SensoriumEmbedded/TeensyROM/README.md

# TeensyROM Multi-capable Cartridge for C64/128

***Connect your Commodore to the 21st century***

**Features include:**
* **TeensyROM+ (PCB v0.4)** is the latest TeensyROM revision — **[see this document](docs/TR+NewFeatures.md)** for additional details:
  * **[TR Host Extensions](docs/TR_Host_Extensions.md)** — Allows others to write and experiment with TR firmware as a .TRH extension, installed alongside the core firmware without modifying it. Envisioned and implemented by [Kelly Fox](https://github.com/kfox) — a huge thank you!
    * [Mean Hamster Power Engine (MPE)](https://meanhamster.com/games/mpe-power-engine) is the first TRH extension, letting your C64 play games never released for it: NES, Game Boy, Doom, classic point-and-click adventures and more. Thank you to [John Swiderski](https://github.com/ziggystar12) for the incredible work and inspiration
  * **Kernal Replacement** — load a custom KERNAL ROM image, with no hardware modification.
  * **512KB REU (RAM Expansion Unit)** — a real REU your C64 software can detect and use
    * Now also works alongside the Retro Replay, Super Snapshot V5, and Final Cartridge III 101% freezers
  * **Freezer Cartridge Support** — Action Replay, Retro Replay, Final Cartridge III and Super Snapshot V5 emulated natively. Thank you to [Paul Harker (LessPaul)](https://github.com/LessPaul) for the freezer contributions!
  * **Remote DMA Memory Access** — give an external app Serial or Ethernet read/write access to C64 memory
    * Supported by [c64cast](https://github.com/kfox/c64cast) — streaming video, audio, visualizations and much more
  * **Battery-Backed Real-Time Clock** — a built-in coin-cell holder: TR+ can remember the correct time through power cycles
  * **External Reset Detect** — press an external reset (C64U button, User port, etc) returns you to the TR menu
  * **Programmable Alternate Button** — the "Alt" button is assignable to whatever's most useful
* All TeensyROM versions:
  * **ROM emulator**: The perfect way to play CRT files, such as the highly recommended [OneLoad64](https://www.youtube.com/watch?v=lz0CJbkplj0) collection.
  * **Instant loader**: [Immediately load/run](docs/General_Usage.md) program (PRG) files
  * **MIDI USB Host & Device, custom ASID Player**: Use a [MIDI keyboard, DAW](docs/MIDI_Usage.md), or [ASID source](docs/ASID_Player.md) to play your SID chip.
  * **Internet interface**: Connect to a [Telnet BBS](docs/Ethernet_Usage.md) or use the integrated [web browser](docs/Browser_Usage.md) to surf/search/download
  * **Remote Control** your C64 using 
    * [NFC Launch System](docs/NFC_Loader.md): The feel of old school cartridges combined with [instant loading](https://www.youtube.com/watch?v=iNfQx2gx0hA)
    * The feature rich (and cross-platform) [TeensyROM-Web](https://github.com/MetalHexx/TeensyROM-Web) and [Command Line Interface](https://github.com/MetalHexx/TeensyROM-CLI)
  * SID File Player with voice muting and speed control 
  * Bitmap Picture viewer, Text/PETSCII viewer, Custom BASIC Commands, Autolaunch, *and more* 
  * Lots of games, utilities, pics, and music built-in: no external media required to get started!
  * [**Multiple Hardware Interfaces:**](media/TR_Connections.png) SD card, USB Drive, USB Device and host Ports, Ethernet Port

**C64 Ultimate user?**  See [this list](docs/C64_Ultimate_Enhancements.md) of enhancements the TR brings to your C64U 

*Design by Travis S/Sensorium ([e-mail](mailto:travis@sensoriumembedded.com))* 

|TeensyROM pic1|TeensyROM case| 
|:--:|:--:|

**Fully assembled/tested TeensyROM+ units** are available via my [Lectronz Shop](https://lectronz.com/products/teensyrom), or via [Tindie](https://www.tindie.com/products/travissmith/teensyrom-cartridge-for-c64128/) or [eBay](https://www.ebay.com/usr/travis_sensorium).

<a href="https://lectronz.com/products/teensyrom">Lectronz Logo Link</a>

Case/enclosures are available for sale with a new unit (see links above), or [download](3D_Print_Case/3D-Printed-Case-ReadMe.md) and print at home.

Please consider joining us in the [TeensyROM Discord Server](https://discord.gg/ubSAb74S5U) to meet other TeensyROM users, ask questions, provide thoughts/input/feedback, etc.

## Table of contents
  * [TeensyROM Feature Details](#teensyrom-feature-details)
  * [Links to detailed documentation](#links-to-detailed-documentation)
  * [Demo Videos](#demo-videos)
  * [Hardware/PCB Design](#hardware-pcb-design)
  * [Compatibility](#compatibility)
  * [Inspiration and Thank-Yous](#inspiration-and-thank-yous)
  * [Pictures/screen captures](#pictures-screen-captures)

## TeensyROM Feature Details
Compatible with C64 and C128 machines/variants, NTSC and PAL supported.

### **Super fast Loading (.PRG/P00) or ROM emulation (.CRT)** directly from:
  * USB thumb Drive
  * SD card
  * Teensy Internal Flash Memory
  * Transfer directly from PC using [TeensyROM-Web](https://github.com/MetalHexx/TeensyROM-Web) (cross-platform, recommended) or the [TeensyROM UI](https://github.com/MetalHexx/TeensyROM-UI) (Windows desktop)
  * See supported file details [here](https://github.com/SensoriumEmbedded/TeensyROM/blob/main/docs/General_Usage.md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)
  * [NFC Loading system](docs/NFC_Loader.md) available to quickly select/load with NFC tags.
### **MIDI in/out via USB Host connection:** 
  * Play your SID with a USB MIDI keyboard!
  * Use with popular software such as **Cynthcart, Station64** etc, or the included MIDI2SID app
  * Supports all regular MIDI messages **in and out**
    * Can use your C64 to play a MIDI sound capable device.
  * **Sequential, Datel/Siel, Passport/Sentech, and Namesoft** MIDI cartridges emulated 
  * Use a USB Hub for multiple instruments+thumb drive access
### **MIDI in via USB Device connection:** 
  * Stream .SID or .MIDI files from a modern computer directly to your Commodore machine SID chip!
  * Play MIDI files out of your PC into C64 apps such as Cynthcart or the MIDI2SID app
  * Stream .SID files out of your PC using the ASID MIDI protocol to hear any SID file on original hardware.
### **Internet communication via Ethernet connection**
  * Connect to your favorite C64/128 Telnet BBS!
  * Use with released software such as **CCGMS, StrikeTerm2014, DesTerm128,** etc
  * **Swiftlink** cartridge + 38.4k modem emulation
  * Send AT commands from terminal software to configure the Ethernet connection
  * Sets C64 system time from internet
### **Firmware updates directly from SD card or USB thumb drive**
  * Just drop the .hex file on an SD card or USB drive, no need for extra software to update.

**Key parameters** (startup, Ethernet, timezone, etc.) are stored in internal EEPROM and retained after power down.

## Links to detailed documentation
  * **Usage Documents**
    * **[General Usage](docs/General_Usage.md)**
    * **[MIDI Usage](docs/MIDI_Usage.md)**
    * **[ASID Player](docs/ASID_Player.md)**
    * **[Ethernet Usage](docs/Ethernet_Usage.md)**
    * **[NFC Loading System](docs/NFC_Loader.md)**
    * **[TeensyROM Web Browser](docs/Browser_Usage.md)**
    * **[GEOS 64](docs/GEOS64_Usage.md)**
    * **[Custom BASIC Commands](docs/Custom_BASIC_Commands.md)**
    * **[TR Host Extensions (TR+ only)](docs/TR_Host_Extensions.md)**
    * **[USB/Ethernet Remote Command Protocol](docs/ControlComms.md)**
  * **SW Release notes/development**
    * **[Firmware Release history](bin/TeensyROM/FW_Release_History.md)**
    * **[Software Build Instructions](Source/BuildInfo.md)**
  * **Hardware & PCB Related**
    * **[3D printed case files/document](3D_Print_Case/3D-Printed-Case-ReadMe.md)**
    * **[RTC Battery Addition for v0.2/0.3 PCBs](docs/RTC_Battery_Addition.md)**
    * **[TeensyROM Assembly Instructions](PCB/PCB_Assembly.md)**
    * **[PCB Design History](PCB/PCB_History.md)**
    * **[Bill of materials with cost info](https://github.com/SensoriumEmbedded/TeensyROM/raw/main/PCB/v0.3/TeensyROM%20v0.3%20BOM.xlsx)**
    * **[PDF Schematic](https://github.com/SensoriumEmbedded/TeensyROM/raw/main/PCB/v0.3/TeensyROM_v0.3_Schem.pdf)**

## Demo Videos:
  * **[This YouTube Playlist](https://www.youtube.com/playlist?list=PL3fTdu8e_1iChAsRr9KjWtC3A8Ql8IaDn)** contains all the latest TeensyROM demo videos, such as: 
    * Real-time video/audio capture of menu navigation and loading/running/emulating various programs/cartridges
    * Demo using Cynthcart and Datel MIDI emulation to play with a USB keyboard 
    * MIDI ASID Demo: Stream .SID & .MIDI files directly to your C64/SID
    * Web Browser and internet file download demo 
    * SID Player and Picture viewer demo 

## Compatibility
* TeensyROM compatability has been fully validated on **many** different NTSC **and** PAL machines: C64, C64C, SX-64, and C128 as well as modern reproductions such as the C64U, Ultimate 64, EVO64, Mega65 (r5 and higher), and Reloaded MKII
* The early "prototype" version of breadbin (PCA 326298 w/ 5 pin video) has a known issue with the reset circuit that must be corrected to be compatible with the TeensyROM and other fastload cartridges. See [this post](https://www.lemon64.com/forum/viewtopic.php?t=74222) or [this video](https://youtu.be/agDFLPP9yIw?t=813) for instructions on how to correct this issue.
* Some NTSC C128s show an intermittent DMA write issue (used by REU, Remote DMA, etc.) — see **[TR+ NTSC C128 DMA Findings](docs/TR+NTSC_C128_DMA_Findings.md)** for symptoms, cause, and the fix.

## Hardware/PCB Design
PCB 0.2/0.3 Component selection was done using parts large enough (SOIC and 0805s at the smallest) that any soldering enthusiast should be able to assemble themselves.   Since high volume production wasn't necessarily the vision for this device, 2 sided SMT was used to reduce the PCB size while still accommodating larger IC packages.

<a href="PCB/PCB_Assembly.md">TeensyROM v0.3 PCB</a>

*The original TR (v0.2/0.3) — publicly self-buildable today; see [assembly instructions](PCB/PCB_Assembly.md).*

Beginning with PCB v0.4 (TeensyROM+) the package sizes are reduced (TSSOP and 0603 passives) to allow additional needed circuitry and single sided manufacturing.

**A note about overclocking**
The Teensy 4.1 is slightly "overclocked" to 816MHz from FW in this design. Per the app, external cooling is not required for this speed.  However, in abundance of caution, a heatsink is specified in the BOM for this project.  In addition, the temperature can be read on the setup screen of the main TeensyROM app. The max spec is 95C, and there is a panic shutdown at 90C.  In my experience, even on a warm day running for hours with no heatsink, the temp doesn't exceed 75C.

## Inspiration and Thank-Yous:
* [**Heather S**](https://www.instagram.com/dalliancecreations/): Loving wife, continuous encourager, saintly patience
* [**MetalHexx**](https://github.com/MetalHexx): Big picture ideas, remote controls via [TeensyROM Web](https://github.com/MetalHexx/TeensyROM-Web), [UI](https://github.com/MetalHexx/TeensyROM-UI) and [CLI](https://github.com/MetalHexx/TeensyROM-CLI), testing, friendship
* [**Kelly Fox**](https://github.com/kfox): TR+ contributions ([Host Extensions](docs/TR_Host_Extensions.md), build system and much more), [c64cast](https://github.com/kfox/c64cast)
* [**John Swiderski**](https://github.com/ziggystar12) of Mean Hamster Software: [MPE](https://meanhamster.com/games/mpe-power-engine), the first TR Host Extension, and the inspiration behind them
* [**Paul Harker aka LessPaul**](https://github.com/LessPaul): Freezer cartridge contributions (Action Replay, Retro Replay, Final Cartridge III, Super Snapshot V5)
* [**Avrilcadabra**](https://www.youtube.com/@avrilcadabra): Musician, experimenter, provider of ideas and feedback 
* [**Paul D aka Digitalman**](https://www.youtube.com/@digitalman4404): Thought provoker, promoter, Maker, and tester extraordinaire
* [**Stefan Wessels**](https://github.com/StewBC): Cartridge case design
* [**StatMat**](https://github.com/Stat-Mat): NFC Scanner idea, Fast boot code, OneLoad64 creation
* **Giants with tall shoulders**: SID/SIDEKick, KungFu Flash, VICE Team

## Pictures/screen captures:
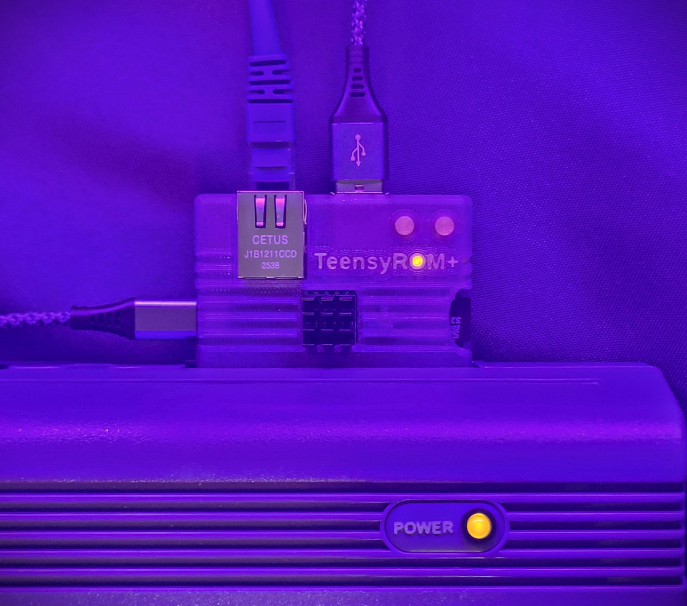
[picture p1: media/case/lp-case_connected.jpg]
|TeensyROM pic1||
|:--:|:--:|

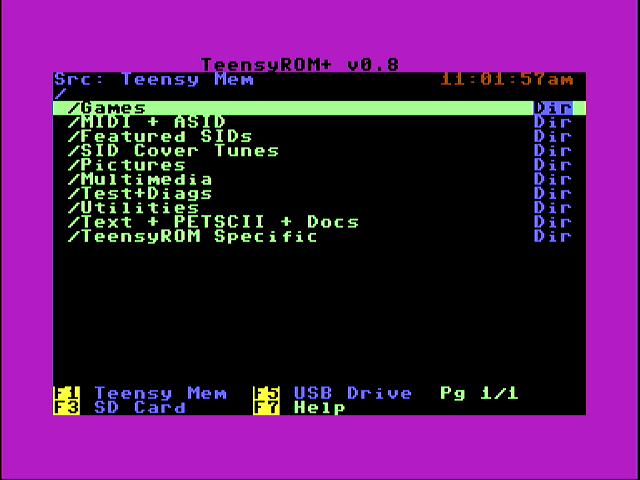
[picture p2: media/Screen captures/TR+/main-menu/TeensyMenu.png]
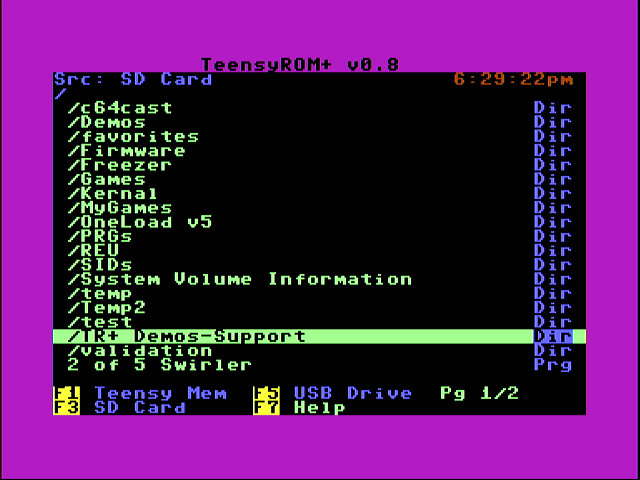
[picture p3: media/Screen captures/TR+/main-menu/SDMenu.png]
|||
|:--:|:--:|
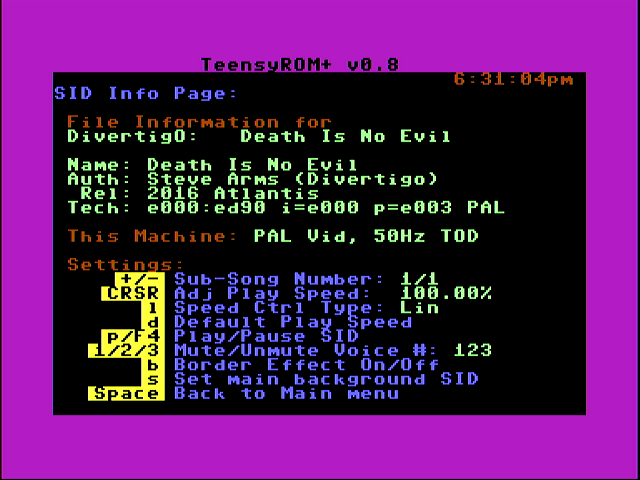
[picture p4: media/Screen captures/TR+/main-menu/SIDInfoPage.png]
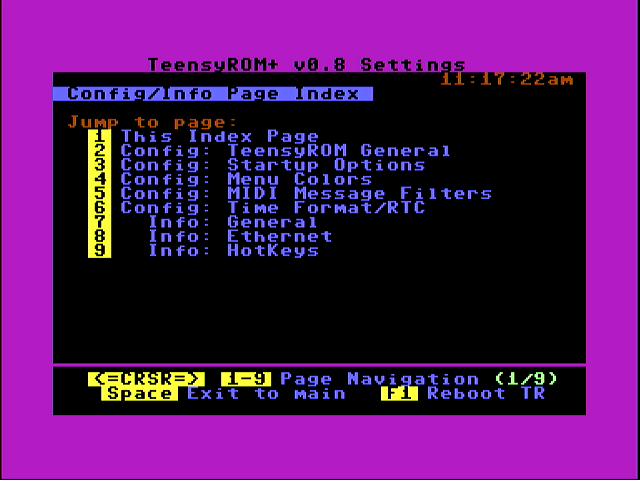
[picture p5: media/Screen captures/TR+/help-settings-info/settings1-index.png]
|||
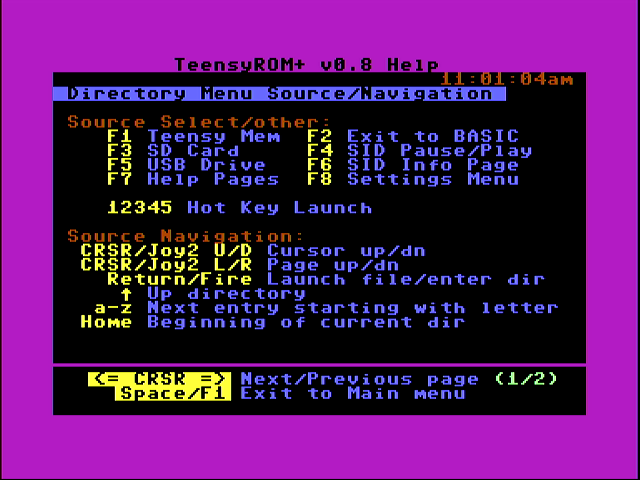
[picture p6: media/Screen captures/TR+/help-settings-info/help1.png]
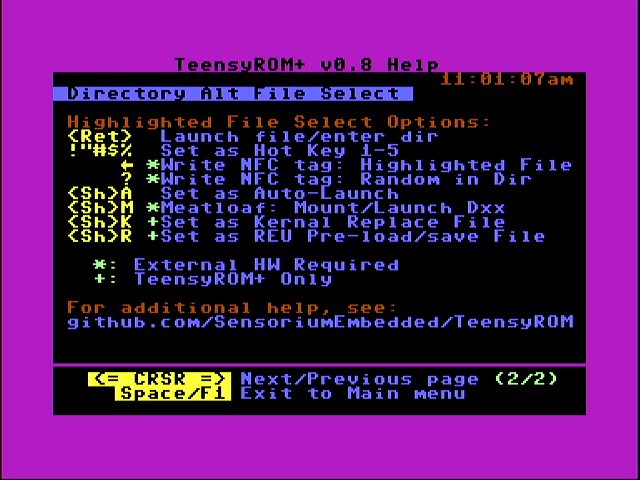
[picture p7: media/Screen captures/TR+/help-settings-info/help2.png]
|||

See the [media](media/) folder for more pics and screen shots.
