SensoriumEmbedded/TeensyROM/tools/bench/README.md

# Bench scripts

Drive a real TeensyROM from a host computer: reflash it, launch things, read and
poke the C64's memory. They were written to verify firmware without anyone at the
machine. Python 3, standard library only, macOS or Linux (they use `termios`).

You need a TR or TR+ in a C64/C128, powered on at the menu with an SD card in it,
and a USB cable from the cartridge to the host. These scripts are the hands-free
route; `docs/General_Usage.md` lists the others, including the program-button one.

`tools/Debug/` holds the scope and bus-timing scripts. They are a separate stack:
their own port handling, and pyserial rather than the standard library.

## What talks, and what does not

Which image is running decides how much of this works. The **main image**
answers all of it. The **minimal image** answers reset, launch, version and the
firmware check, and fails other commands with `Busy!`. The **extension image
runs with USB disabled** and answers nothing at all, so a silent port after
launching an extension is success, not a hang.

`probe.py` asks the board whether it is main or minimal, and reports silence
otherwise -- which is the extension image or a hung board. The port name is no
help: main and minimal present the same USB device, both `usbmodem2101`-style
on macOS. (On firmware before minimal became Serial + MIDI, minimal enumerated
under the Teensy's serial number instead.)

The port is `$TR_PORT`, else the first `/dev/cu.usbmodem*` on macOS or
`/dev/ttyACM*` on Linux. Do not hardcode it. After a reboot `$TR_PORT` is a
preference rather than a pin: the USB serial number changes across some firmware
changes, so a board that does not come back under its old name is picked up from
whatever node appeared beside it.

`peek`, `poke` and everything built on them (`screen`, `keypress`, `colors`,
`fwupdate`'s prompt answering) use DMA and need a Fab 0.4 board (a TR+).

Do not use them on a C128 running GEOS 128 in 80 columns: a single one-byte
`peek.py` stops it, clock and mouse both, until a reset. That mode runs the 8502
at 2 MHz, which is the likely cause but has not been isolated. GEOS 64 on the
same C128 survives peeks and whole-bitmap reads. Check an 80-column screen with
a capture device instead.

## Scripts

| Script | Does |
|---|---|
| `fwupdate.py <hex> [remote]` | Push a hex to the SD card, launch it, answer the C64's Y/N prompt by DMA, echo the updater until the board reboots, then check that the board came back on the main image reporting the hex's build stamp. A file that is not Intel HEX is refused before anything is pushed; a hex this reader cannot fully decode is flashed and the board is still checked for the main image, without the stamp comparison. |
| `push.py <local>=<remote> ...` | Copy files to the SD card. Deletes the target first; the firmware will not overwrite. |
| `launch.py <path> [drive] [secs]` | Launch a file from the SD card and echo serial. |
| `hostinstall.py <local.trh> [remote]` | Push a `.TRH` extension host package to the SD card and install it. A package the firmware refuses comes back with the C64 still running and nothing erased; one it takes reboots the board, and the install record is read off the boot output -- exiting non-zero unless that record says the host was installed, since a failed erase or program reboots the same way. `npm run build:tr-plus` writes the stock host's package as `build/firmware/TeensyROM+_<ver>_VMBoot.TRH`; a `--host-sketch` build writes its own the same way. |
| `hostuninstall.py` | Remove the installed extension host: clear the tag so the slot stops reading as a host, then erase the rest of the slot, which reboots the board. Exits non-zero unless the record on the way back up says the host was removed with detail `$0` -- a failed erase reboots too, and a sector that would not erase still reports `$40`, with its status as the detail. A slot holding no host but not blank, which is what an install that failed part way leaves, is cleared the same way. With the slot already blank the C64 says so and the board stays up. There is no removal command over the wire: this resets the C64 to the menu and presses the keys a user would, `F8`, `0`, `u`, `y`, by DMA, so the removal runs on the C64's own request. |
| `hostcycle.py <local.trh>` | The install/remove round trip end to end against a real board, asserted and unattended: remove, refuse a second remove, install, remove, refuse again, reinstall. Every step runs whatever the ones before it did; it exits non-zero at the end, listing each step whose outcome did not match. |
| `exttest.py <path>` | Launch an extension and report how it ended, told apart by which image answers afterwards rather than by whether a serial node exists. No image answering is the success case for a resident module -- the main image's node goes away and the minimal image's usually stays behind, enumerated and serviced by nobody -- so look at the C64; the main image answering means the extension gave the machine back, and its record is printed *and read*, because a launch that faulted comes back the same way one that finished does; a port that never drops means nothing entered the image, and the screen carries the refusal. Exits 0 for a resident module or a record naming a normal finish (`hostops.FINISHED_NORMALLY`), and 1 for a launch nothing entered or a record that is a failure, absent, truncated or unrecognised -- the same positive match, and for the same reason, as `INSTALLED` and `REMOVED`. |
| `hostenter.py <path> [phrase]` | The other shape from `exttest.py`, for a host that hands the machine back: launch, the port drops, the host runs and resets, and the main image prints its `VmFail` record on the way back up. With a `phrase` that record is the assertion; without one the run reports what it saw and asserts nothing, because a launch that failed after the jump reboots the same way a good one does. A host that stays resident never gives the main image's port back, and what that looks like here depends on whether minimal's orphan node stayed behind: with no node, `REBOOT_TIMEOUT` seconds and then `the board did not come back`; with one -- the usual case -- the screen read that follows fails instead, `no reply -- DMA read is not compiled into this image, or this is not the main image`, which names the wrong diagnosis for a host that is running exactly as intended. Use `exttest.py` for those; it treats no image answering as the success it is. |
| `peek.py <hex addr> <len>` | Hex dump C64 memory. |
| `snooptap.py arm PAGE:FLAGS,... \| take \| stop` | Record the C64's bus cycles on chosen pages into a 1,024-entry ring, each with its ARM cycle stamp, data and DMA state, and print them back. A trigger page that also records writes freezes the ring just after its first write, so the cycles leading up to a crash survive until they are taken. Arm it, let the program under test have the port, and take the ring once it lets go. Needs an image built with `DbgSnoopTap` in `TeensyROM.h`. |
| `spans.py [NMI period]` | `WriteC64Spans` against a C64 running `spanclient.a`: read-back across slice boundaries, the 1,024-slice refusal, what one slice costs with the C64 loop writing, only reading, and only reading with the screen blanked, and timer NMIs lost per job against slice size. Needs `acme` on `PATH`, and resets the C64 when done. |
| `reuspans.py [seconds]` | Host DMA writes beside C64 REU transfers. Runs `reuclient.a`, which stashes a page to the REU and fetches it back in a loop, first with no host jobs, then while the host writes `$6000` with `WriteC64Mem`, whole and 64 bytes at a time, sliced `WriteC64Spans` and `WriteC64Spans` locked to the client's `$D418` store, reading each back. Reports the C64's bad pages per phase and each writer's bad read-backs. Needs Special IO set to an REU, `acme` on `PATH`, and resets the C64 when done. The first-byte loss in `docs/Architecture/Known-Issues.md` makes it fail now and then. |
| `regsweep.py <dwell secs> <value> ...` | The read margin of the Special IO handler chosen in Settings, per `docs/Architecture/Constraints.md`. Runs `regread.a`, which reads the REU's address and length registers back, checks that `$DF10-$DF1F` read `$FF` beside a TR page at `$DE00`, and checks the TR page's `TRM`/`TRB` IDs. Then, for each value, sets `nS_PLAprop` (`tp###`) and prints the wrong answers the C64 counted in `dwell` seconds, and restores the defaults (`td`) at the end. Needs `acme` on `PATH` and an image built with `Dbg_SerTimChg` in `TeensyROM.h`. |
| `grants.py` | Service bit 20 end to end: packages `grants/module.cpp` and `grants/client.a` as `/VMS/GRANTS`, then launches one content file per slice size. The client grants a slice from a CIA2 timer NMI every 200 cycles, when it will end before the next tick, and counts the NMIs it loses; the module writes 4 KiB to `$4000` for 1.5 s and exits with its job count and that loss, which the main image prints on the way back. Each row also checks a sum the client takes over what it holds after the last job, and a slice that never fits, like a client that never grants (the first row), ends the job `VM_C64_NO_GRANT`. `grants.py 120 140` runs only those rows. Needs `acme` on `PATH` and a host serving bit 20 installed. |
| `tcpstress.py <IP> [--writes N] [--reads N]` | `WriteC64Mem` (4 KiB) and `ReadC64Mem` (8-16 KiB) over the TCP listener, shuffled on one connection, every read checked against what was written to `$2000-$9FFF`, and the whole region read back after the last command; then asks which image is running over that connection and a new one. Leave the C64 at a BASIC prompt with no program in memory. Needs the TCP listener on; uses no serial port. |
| `screen.py` | The C64 text screen. |
| `keypress.py [code]` | Put a key in the keyboard buffer (default `Y`; F1/F3/F5/F7 are `0x85`..`0x88`). |
| `type.py [--c128] '<text>'` | Type a line into the keyboard buffer, ten keys at a time; `\n` is RETURN. `--c128` for a C128 in 128 mode. |
| `colors.py` | Top row, its colour RAM and the VIC colour registers. |
| `listen.py [secs] [hex]` | Echo serial output, optionally sending bytes first. |
| `probe.py` | Which image is running -- main, minimal or silent -- and its build banner. |
| `ls.py [path] [drive]` | List a directory, to see that a push landed where it was aimed (first 1000 entries). |
| `reset.py` | Reset the C64 to the menu, and the board out of the minimal image. |
| `setclock.py [UTC time]` | Set the TR's real-time clock, to this computer's clock or an ISO 8601 UTC time such as `2026-10-16T17:00:00`. Only at the TR menu. |
| `hostops.py` | Installing and removing a host, and `run_step` -- driving anything that ends in a reboot and reading which of the two shapes came back. Also the phrases a reboot is judged by: `INSTALLED`, `REMOVED` and `FINISHED_NORMALLY`. Shared by the `host*.py` scripts and by `exttest.py`, whose exit status is `finished_normally()`'s answer, so a phrase edited here moves that verdict; and by `test_bounds.py`, which patches its timeouts to test them, and `test_protocol.py`, which pins the phrases against the firmware's own `VmFail::describe()`. |
| `trlink.py` | The shared library the above are built on. |
| `protocol.py` | Every value that goes on the wire, named once. |
| `c64.py` | C64 memory locations, and screen codes as text. |
| `hexfile.py` | Reads a firmware hex: the two image regions, and the build stamp in the main one. |
| `test_*.py` | Tests against a fake board on a pty, and against the firmware's own definitions; no hardware. |

## Recipes

Reflash without the program button (build for **your** cartridge: `--target tr-plus` for a TR+):

    python3 tools/bench/fwupdate.py "build/firmware/TeensyROM+_<version>_full.hex"

That ends by asking the rebooted board which image it came up as and comparing
its banner with the build stamp compiled into the hex, because answering the Y/N
prompt is the step that silently does nothing when the screen is not what the
script expects, and the board then keeps running the old firmware and says so
nowhere. The minimal image can carry the same stamp, so a board that fell back
to it is a failed update however its banner reads.

The stamp is `SOURCE_DATE_EPOCH`, which the build sets to the HEAD commit time
for a clean tree unless the environment already holds one, so it identifies a
commit and not a build. A tree with uncommitted edits to the image sources is
stamped with its own build time instead, and its version string ends in `*`,
so two local iterations are told apart without a commit.

Run the hello extension (`npm run build:hello` writes `build/extensions/`):

    python3 tools/bench/push.py build/extensions/HELLO.crt=/HELLO.crt \
        build/extensions/VMS/HELLO/manifest.vmi=/VMS/HELLO/manifest.vmi \
        build/extensions/VMS/HELLO/engine.mvm=/VMS/HELLO/engine.mvm \
        build/extensions/VMS/HELLO/client.crt=/VMS/HELLO/client.crt
    python3 tools/bench/exttest.py /HELLO.crt

Blank version banner after a USB flash (black on black, not a regression): `colors.py`
shows text present and colour RAM row 0 all zeros. Fix it over serial with
`SetColorToken` (`0x64 0x22 0x02 0x04`) then `ResetC64Token` (`0x64 0xEE`).

## Limits

The fake board in `test_trlink.py` proves the framing and byte order, not what a
board does. `test_protocol.py` checks every constant in `protocol.py` against the
`Source/Teensy/` definition it came from, so a moved token fails a test rather
than a board. The fake drops and re-publishes its pty, under a new name, for
`fwupdate.py`'s post-reboot check and for `exttest.py`'s:
`test_trlink.ExtensionRun` runs `exttest.py` end to end across a real port
drop, so the arm a reboot alone cannot classify -- finished, faulted, or no
record at all -- is covered without hardware. Its other two arms are not, and
need a board that sits still: a module that stays resident, and a launch the
firmware refuses before the port ever drops.

`screen.py`, `colors.py`, `exttest.py`, `fwupdate.py` and everything built on
`hostops.py` -- `hostinstall.py`, `hostuninstall.py`, `hostcycle.py`,
`hostenter.py` -- read the screen through `petscii_row`. Screen codes 1-26 are
the unshifted letters and 65-90 the shifted ones, and which letters those are
depends on where the VIC is pointed, so `petscii_row` takes a `charset`. It
defaults to `LOWER_UPPER`, because that is where the menu puts the C64 at
startup: `MainMenu.asm`'s `TextScreenMemColor` writes `#$17` to `$d018`. Pass
`UPPER_GFX` for a screen a launched program has switched back to the power-on
charset, where 65-90 are graphics and read as `.`.

Both letter ranges decode, so a phrase asserted against the screen is no longer
restricted to lower-case glyphs. Fold case anyway -- `hostops.Outcome.said` does,
and `fwupdate.py` now does for its `Y/N` prompt -- since which case a glyph
carries is a property of the screen, and a launched program need not stay in the
charset the menu left behind. Nobody has read a real updater screen to settle
which one it uses, so folding case is what makes that question not matter.

    python3 -m unittest discover -s tools/bench
