SensoriumEmbedded/TeensyROM/PCB/v0.4/README.md

# TeensyROM+ (PCB v0.4) Design Files

Design files for the TR+ (schematic, BOM, PCB layout) are not yet publicly available. Release is planned within the next few months — this folder will be filled in at that time.

In the meantime:
* Fully assembled/tested TR+ units are available now — see the [main README](/README.md) for shop links.
* Questions about release timing or sales? [Contact me](mailto:travis@sensoriumembedded.com).

<br>

[Back to main ReadMe](/README.md)
