SensoriumEmbedded/TeensyROM/docs/Architecture/Constraints.md

# Hard Constraints

Rules that are easy to violate without realizing it because nothing enforces them at compile time. Check this file before proposing firmware-level design changes.

## The per-C64-cycle ISR is off-limits for new logic

`isrPHI2()` in `Source/Teensy/MinimalBoot/Common/ISRs.c` (`FASTRUN void isrPHI2()`) fires on every C64 bus cycle — a budget of roughly **985ns (PAL) / 1023ns (NTSC)** (`PALBusFreq`/`NTSCBusFreq` in `Common_Defs.h`). It's `#include`d into both `Teensy.ino` and `MinimalBoot.ino` and attached to the PHI2 pin rising edge in each `setup()`.

Inside the budget: decode the address/R-W bus off GPIO, dispatch into the active IO handler's `ROMLHndlr`/`ROMHHndlr`/`IO1Hndlr`/`IO2Hndlr`/`CycleHndlr` (see [Teensy-Firmware.md](Teensy-Firmware.md#the-io_handlers-pattern)), optionally emulate VIC "bad line" behavior, manage DMA state transitions. Hardcoded nanosecond-precision timing constants (`Def_nS_MaxAdjPAL/NTSC=1030/993`, `Def_nS_RWnReady=135`, `Def_nS_PLAprop=150`, `Def_nS_DMASetupPAL/NTSC=440/430`, plus `Def_nS_DMASetupNTSC128=445` selected when the menu reports a C128 — `Common_Defs.h`; PAL vs NTSC is timed on the Teensy, see [Machine type](#machine-type-palntsc-is-timed-on-the-teensy-c64c128-only-comes-from-the-menu)) are tuned against real hardware and specific board revisions (comments cite e.g. "Reloaded MKII"); nearby comments document what breaks if a value shifts.

**Do not propose adding new logic to this function — not even a single cheap branch or null-check — for signaling, handshakes, or status flags.** This has come up concretely: a design discussion about signaling PRG-load completion from Teensy to C64 considered mirroring the existing `fBusSnoop`/`fKernRepl` pre-dispatch hook pattern with a new dedicated flag check, and was rejected specifically because it touched the ISR. The mechanism that shipped instead reuses the existing `fBusSnoop` hook rather than adding a new one — see below.

If a design genuinely seems to require touching the ISR, look for a solution entirely outside the hot path first (main-loop-only mechanism, existing register semantics, timing-based approach). If none exists, surface that explicitly as a tradeoff rather than defaulting to an ISR change.

New cartridge/IO types are added by writing a new `IO_Handlers/*.c` file and registering it in the `IOHandler[]` dispatch array — not by editing the ISR.

## `fBusSnoop` is a single contested global slot — never assign it directly if anything else might own it

`fBusSnoop` (declared in `Common_Defs.h`) is checked unconditionally, ahead of everything else, at the top of `isrPHI2()` — whatever it points to gets first refusal on every single bus cycle, regardless of `CurrentIOHandler`. That priority is exactly why it's useful for anything that needs to intercept the bus independent of the active handler, and exactly why blindly assigning it (`fBusSnoop = X;`) is dangerous the moment more than one thing might want it at once: REU (`IOH_REU.c`) and Kernal Replace (`IOH_KernalReplace.c`) both use it, `BusSnoop.ino`'s `BusAnalysis()` diagnostic borrows it temporarily, `SampleWatchStart()` (`DMAControl.c`, for SampleWatch and locked WriteC64Spans) borrows it the same way, and the PRG-load handshake below claims it for the duration of a handler swap. Two failure shapes to watch for:

- **Stomp on install**: something assigns `fBusSnoop = X` while another owner still needs it live, silently disabling that owner with no error.
- **Stomp on cleanup**: something unconditionally resets `fBusSnoop = NULL` (or reinstalls its own value) when it's done, without checking whether a *different* owner has since taken over — wiping out state that has nothing to do with the code doing the resetting. `BusAnalysis()` hit exactly this: its original `fBusSnoop = NULL;` cleanup, if it ran while a PRG-load handshake had taken over the slot mid-sample, would silently hang the C64's poll loop forever. Fixed by checking ownership both at entry (`if (fBusSnoop!=NULL || PendingfBusSnoop!=NULL) { ...abort... }`) and at cleanup (`if (fBusSnoop == &BusCount) fBusSnoop = NULL;`) — never assume you're still the owner just because you were a moment ago.

**The convention now used for anything that wants a bus-snoop hook installed from `InitHndlr` (i.e. from inside `IOHandlerInit()`, `Source/Teensy/IOHandlers.ino`): stage into `PendingfBusSnoop` (declared in `Common_Defs.h`, right below `fBusSnoop`) instead of writing `fBusSnoop` directly**, and let `IOHandlerInit()` decide when it's safe to promote — either immediately (no handshake in progress) or deferred until the handshake's own completion-read (see below). `InitHndlr_REU()` and the handler-swap-time `InitHndlr_KernalReplace()` (not to be confused with `InitHndlr_KERNALReplace_PreStart()`, see next section) both follow this. Code that runs *outside* `IOHandlerInit()`'s call path and provably can't race the handshake (see the PreStart exception below) may still assign `fBusSnoop` directly — but that safety has to be argued for explicitly, not assumed.

### Worked example: the PRG-load IO-handler-swap handshake

Historical context: this used to be a fixed C64-side delay loop (`ldy #$06 / ldx #$00 / dex / bne ...`) empirically tuned to outlast the Teensy's handler swap after a PRG finishes loading. It was both wasteful (always paid the worst-case delay) and unsound (an REU pre-load with no SD/USB media present could exceed even that tuned worst case, since a media timeout has no fixed upper bound a constant delay can cover).

The mechanism that replaced it, entirely without touching the ISR:

- **Register**: `rRegIOHSwapPoll` (`Menu_Regs.h`, high/otherwise-unused IO1 offset `0xFE`) with values `rihsBusy`/`rihsReady`.
- **Arm** (`IOH_TeensyROM.c`, the `rCtlRunningPRG` case that already runs when the C64 signals "PRG loaded, pick a handler"): resets `HandshakeReady = false`, `PendingfBusSnoop = NULL`, and installs `fBusSnoop = &HandshakeSnoop` — a one-time assignment triggered by this specific write, not new per-cycle ISR logic.
- **Watch** (`HandshakeSnoop()`, `IOH_TeensyROM.c`): answers reads of `rRegIOHSwapPoll` with `rihsBusy`/`rihsReady` depending on `HandshakeReady`, ahead of whatever `CurrentIOHandler` actually is — this is what lets the C64 poll a stable answer across a swap that changes which handler is even active.
- **Complete**: `IOHandlerInit()` runs the target handler's `InitHndlr()` (which may stage `PendingfBusSnoop`), reassigns `CurrentIOHandler`, then either sets `HandshakeReady = true` (if `fBusSnoop` is still `&HandshakeSnoop` — handshake in progress) or promotes `PendingfBusSnoop` immediately (if not — e.g. a cart loaded directly from the menu, no handshake involved at all).
- **Hand off**: `HandshakeSnoop`, on the read where it reports `rihsReady`, also does `fBusSnoop = PendingfBusSnoop` in that same call — atomic with the read the C64 is about to act on, so the real handler's snoop (or none) is already live before the PRG starts running.
- **C64 side**: `Source/C64/MainMenuCRT/source/PRGLoadStartReloc.s` polls `rRegIOHSwapPoll` immediately after sending `rCtlRunningPRG` — no priming delay needed, since arming happens synchronously in the same ISR call as that write.

**Deliberate exception — `InitHndlr_KERNALReplace_PreStart()`** (`IOH_KernalReplace.c`): Kernal Replace needs its hook live *before* BASIC even initializes, which is earlier than any PRG-load handshake could possibly be armed — so this one function is correctly allowed to assign `fBusSnoop = &KernalCheck` directly, unlike every other `InitHndlr`. It's a separate function from the struct's actual `InitHndlr` (`InitHndlr_KernalReplace()`, which *does* go through `PendingfBusSnoop`, since it runs later via the normal swap path and needs to re-stage the hook after the handshake temporarily takes the slot). That restage is conditional: only while the handshake owns `fBusSnoop` (a PRG load) and PreStart actually loaded a kernal (`KernalBin` non-NULL; PreStart frees it on a failed load). PreStart runs on PRG launches only, but a generic (type 0) CRT inherits the Special IO selection, so with Kernal Replace selected its `InitHndlr` also runs on CRT launches; an unconditional restage hooked `KernalCheck` there with an unloaded `KernalBin`, driving GAME/EXROM over the cart's own lines, and generic CRTs failed to start (betas 0.8.0.4 through 0.8.0.15). Conflating the two — same underlying "load the kernal binary and hook the check" logic, called from two different timing contexts — was a real mistake made once already during this design; the split and the `_PreStart` naming exist specifically to keep that from happening again.

**Deliberate exception — `DMA_AutoRun`** (`Common_Defs.h`; read in `ISRs.c` `DMAWaitAssertReady()` and `DMAControl.c` `DMATransferISR()`): a locked `WriteC64Spans` slice has to start, run and release the bus inside one NMI period (38 free cycles at 12 kHz NTSC), and the thread-mode handshake between those steps costs 70–80 cycles, so there is no main-loop version of it. The two reads replace a state assignment with a selected one, on cycles that already run DMA code (the assert, and the end of a transfer), never on an ordinary bus cycle or before an IO1/ROM response. The flag is set only for the length of a locked job.

### The real dividing line: flash-backed vs. RAM-backed, not just "the ISR function itself"

The no-new-logic rule extends to everything reachable from the ISR's call path, not just `isrPHI2()` literally: `ROMLHndlr`/`ROMHHndlr`/`IO1Hndlr`/`IO2Hndlr`/`CycleHndlr` of the *active* IO handler are all called every cycle and must stay just as disciplined. Within that call path, only cheap, deterministic operations are safe — register reads/writes, small variable updates, anything backed by RAM1/RAM2. Nothing backed by flash is safe, and that's a wider category than it first looks:

- **`FLASHMEM`-attributed code** — flash execution goes through the FlexSPI cache; a cache miss blows the cycle budget. `FLASHMEM` is fine for `InitHndlr`/`PollingHndlr`/main-loop code (never called from the ISR path), never for `ROMLHndlr`/`ROMHHndlr`/`IO1Hndlr`/`IO2Hndlr`/`CycleHndlr`.
- **EEPROM access — including reads.** The Teensy's "EEPROM" isn't a separate low-latency peripheral; it's emulated on top of the same flash `FLASHMEM` code lives in, so it carries identical unbounded latency. Not just writes — reads too.
- **SD card and USB access** — same unbounded-latency problem, different peripheral.

So new cartridge/IO type authors: none of the per-cycle-called handler functions may touch flash in any form (code or EEPROM), SD, or USB. If a handler needs any of that, it belongs in `InitHndlr` (setup-time) or `PollingHndlr` (main-loop, see the wait mechanism below), never in the cycle-called functions.

### An IO1 read has to put its data on the bus early: do the work before the read

On a C64 read the data has to be on the bus with setup time to spare before PHI2 falls, and NTSC's half cycle is ~18nS shorter than PAL's. Measured 2026-10-09 (TR+ at 816MHz, a 250425 C64 with a Kawari VIC in NTSC), from ISR entry to the data reaching the port: plain IO1 registers ~300nS, item names ~318nS, and `rRegItemTypePlusIOH` ~342nS, because it worked out the item type during the read (two `IO1[]` loads, the menu table, three far branches). That read had next to no setup time left, and the main menu sometimes got the wrong item type: a `/Games` entry treated as launchable, items shown as directories, the `+` handler mark missing. PAL never failed.

Whether it failed came down to code layout, not to the ISR: its code was byte-identical between a failing build and a clean one. Layout changes which thread-mode code the PHI2 interrupt lands on, and with it how often the ISR starts late: 18-40nS late on ~1 entry in 85 in a failing build, ~1 in 6000 in a clean one. That is why an unrelated commit (the PR #54 merge) turned it on, and why moving four functions that run on every main-loop pass (`MeasureVideoStd`, `RecheckVideoStd`, `FollowVideoStd`, `ApplyMenuVidReport`) out of `FLASHMEM` turned it off again in a test build. That move was taken for the fix at first, but two builds with those functions at the same flash addresses went one clean, one failing.

The fix, `UpdateItemTypeReg()` (`IOH_TeensyROM.c`), works the byte out when the item is selected: in the ISR on the C64's `rwRegSelItemOnPage` write, once the data is latched, and in thread mode after each status function, while the C64 still waits. The read is now a plain register read. On a layout where the old read failed at the default `nS_PLAprop` of 150, the new one ran clean up to 200 and failed at 210: ~50nS of margin.

So for IO1/IO2 read handlers: keep the code between the address decode and the data drive to a minimum. Anything that can be worked out earlier, on the write that selects it or in thread mode before the C64 is told the data is ready, should be, so the read just fetches a byte. One clean build doesn't show that a read path has margin: measure it on NTSC by building with `Dbg_SerTimChg` (`TeensyROM.h`) and raising `nS_PLAprop` (serial `tp###`) until reads fail.

**Separate exception, different reason: `Source/Teensy/FlashUpdate.ino`'s `DoFlashUpdate()` (the vendored FlasherX firmware-update code) and `Flash/FlashTxx.c` are deliberately *not* `FLASHMEM` candidates, despite being main-context-only.** This isn't about ISR reachability — it's a self-modifying-flash hazard: this code erases and rewrites the Teensy's own flash while running, so if it lived in flash itself, the CPU could be fetching its own next instruction from the exact region currently being erased/reprogrammed. Don't flag this file's core update path in a FLASHMEM audit for the reason above; it has its own, unrelated reason to stay RAM-resident.

### The sanctioned way to run slow work: cooperative polling, not a CPU halt

When a handler genuinely needs to do something slow — flash-backed work, or anything else that can't fit the cycle budget — the pattern used throughout the C64 menu code is a cooperative polling handoff, **not** a bus/CPU halt:

1. C64 side writes a `rCtl*WAIT`-style command to `wRegControl`, then calls `WaitForTRDots` / `WaitForTRWaitMsg` (`WaitForTRMain` loop, `Source/C64/MainMenuCRT/source/MainMenu.asm:942-982`). This is ordinary running 6502 code — it prints one dot per second off the CIA TOD clock as a progress indicator and polls `rwRegStatus`, waiting for `rsReady` (or displays an interim `rsC64Message`).
2. On the Teensy side, the ISR-path handler (e.g. `IO1Hndlr_TeensyROM`) only does the fast, RAM-safe part: record that a status/command was written. The actual work happens in `PollingHndlr_TeensyROM()` (`Source/Teensy/MinimalBoot/Common/IO_Handlers/IOH_TeensyROM.c`), called from the **main `loop()`**, not the ISR — `Teensy.ino`'s `loop()` dispatches to `IOHandler[CurrentIOHandler]->PollingHndlr()`. It sees `rwRegStatus != rsReady`, dispatches to the real handler via `StatusFunction[...]` (free to use FLASHMEM/EEPROM/SD/USB here), then writes `rsReady` back when done.

The C64 keeps running its own bus cycles the entire time (feeding the ISR normally) — it's just spinning harmlessly on a status register while the Teensy works outside the ISR. This is a **different** mechanism from the DMA-line-assert pause used for large-CRT bank swapping (see below) — that one actually halts the C64 CPU; this one doesn't.

### The PHI2 ISR runs at elevated interrupt priority, even over Ethernet

`Teensy.ino:130` — `NVIC_SET_PRIORITY(IRQ_GPIO6789, 16); //set HW ints as high priority, otherwise ethernet int timer causes misses`. (Note: this "NVIC" is the ARM core's Nested Vectored Interrupt Controller — unrelated to the C64's VIC video chip; the acronym collision is coincidental.)

Beyond priority, Ethernet/PIT interrupts are fully **disabled** (not just deprioritized) during specific windows where `isrPHI2` can't tolerate any preemption at all:

- **VIC-cycle emulation** — `DriveDirLoad.ino:242-243` disables `IRQ_ENET`/`IRQ_PIT` when `EmulateVicCycles` is set, re-enabled at `Teensy.ino:352-353`. Servicing the VIC half of the cycle extends `isrPHI2`'s per-cycle work enough that a stray Ethernet IRQ could blow the timing budget for the *next* PHI2 cycle. See [Known-Issues.md](Known-Issues.md) for a related gap in MinimalBoot's version of this.
- **Firmware self-flash** — `Flash/FXUtil.cpp:175-176` disables both, and goes further by fully `detachInterrupt()`-ing the button and PHI2 pins entirely just above (lines 173-174) — there's no valid handler to service PHI2 while live firmware is being overwritten.
- **ASID (MIDI SID) playback** — `IOH_ASID.c:579-580` disables both during ASID streaming, which has its own tight audio-rate timing requirement.

The priority alone does not keep the Ethernet stack out of `isrPHI2`'s way. NativeEthernet runs the whole FNET stack (`fnet_poll()`) from a 1 ms `IntervalTimer` (PIT) ISR, and with the stack initialized (no cable needed) about 39 PHI2 interrupts per second came in late (>1.1 µs), with the GPIO interrupt at the higher priority and with `IRQ_ENET` masked. A handler that serves bytes on reads it has to sense first (Kernal Replace's HIRAM sense) gets corrupt reads, NMIs or freezes from those. So while **Kernal Replace** serves the KERNAL (its Special IO, or `fKernRepl` with `Fab04_GlobalKernalReplace`), `IRQ_PIT` is masked and `FnetLoopPollService()` (`Teensy.ino`) calls `fnet_poll()` from `loop()` every ms instead: late PHI2 interrupts drop to about one every 2 s. `InitHndlr_KERNALReplace_PreStart()` sets the hold (`FnetLoopPollStart()`) once a KERNAL image is loaded and armed, since `loop()` sees the new handler only ~0.4 s after a launch; `SetUpMainMenuROM()` clears it. The hold is set even when the network stack is not up yet: a program can start it later (SwiftLink `ATC`), and `loop()` moves the poll off the PIT as soon as it exists. Three consequences:
- TCP is serviced only as often as `loop()` comes round meanwhile, so a `PollingHndlr` that blocks also stalls the network.
- Code that blocks waiting for the stack (`connect`, DHCP, DNS) needs the PIT poll back: the SwiftLink dispatch in `IOH_Swiftlink.c` unmasks `IRQ_PIT` while an AT or browser command runs (under `Fab04_GlobalKernalReplace`). New blocking network calls that can run while the KERNAL is replaced need the same.
- Code inside `loop()` that waits on the remote-command channel must poll the stack itself: `CmdInputPoll()` (`SerUSBIO.ino`) while waiting for input bytes, and `CmdSendSpan()` / `SendFileData()` while the send buffer is full. NativeEthernet's `write()` otherwise spins, with no time-out, until the whole span fits, and the buffer drains and lost segments are retransmitted only from `fnet_poll()`.

## The main `loop()` is single-threaded — a blocking call anywhere in it stalls every other main-loop-driven task

`Teensy.ino`'s `loop()` dispatches `ServiceSerial()`/`ProcessCommand()` (incoming serial/network
commands), `myusbHost.Task()`, NFC scanning, TCP servicing, and
`IOHandler[CurrentIOHandler]->PollingHndlr()` (the cooperative-polling mechanism above) all from
the same single-threaded loop, one iteration at a time. There's no scheduler or preemption between
them — if any one of them blocks, everything else in the loop waits for it to return, however long
that takes.

This matters most for `PollingHndlr_ASID` (`IOH_ASID.c`): live MIDI/SID streaming needs servicing
every loop iteration to stay in time, and a stall anywhere else in `loop()` delays it by the same
amount. The unbounded-latency operations flagged as ISR-off-limits above (flash/`FLASHMEM`,
EEPROM, SD, USB — see
[the dividing-line section](#the-real-dividing-line-flash-backed-vs-ram-backed-not-just-the-isr-function-itself))
are technically legal to call from a serial-command handler, since that's main-loop code, not the
ISR — but legal isn't free: a command handler that blocks on one of them for its worst case stalls
ASID playback (and NFC, and TCP, and every other pending command) for that same duration.

Concrete instance: `SD.begin()` can block for up to 3 seconds (`SDFullInit()`'s own comment,
`Teensy.ino`). A serial-command handler that lazily calls it — e.g. to resolve whether
`SD.mediaPresent()` has ever been given a real answer this boot — would stall a live ASID session
for that same 3 seconds. See
[Known-Issues.md](Known-Issues.md#sdmediapresent-and-this-repos-own-sdfullinit-cant-distinguish-card-absent-from-sdbegin-never-called)
for why that specific fix is unsafe, not just inelegant.

## Machine type: PAL/NTSC is timed on the Teensy, C64/C128 only comes from the menu

`MachineDetect.h` times PHI2 from the stamp `isrPHI2` already takes on every rising edge (`LastCycCnt`) — no interrupt masking, nothing added to the ISR. It runs in `setup()` with the C64 held in reset, in the full, minimal and extension images, then again from `loop()`: every ~10 mS for 2 S after each reset release, every 2 S after that. Each re-check blocks `loop()` for about 35 µS (32 periods); keep it that short, per the section above. Three things to know before touching it, or anything that depends on the machine type:

- **The boot reading isn't final.** A C64U powers up at the PAL rate and applies a saved NTSC setting only after the cartridge port's reset is released: its firmware waits for the release before detecting SIDs, then reprograms its video PLL, about 0.1–0.2 S later and before its CPU starts (Ultimate firmware, `software/u64/u64_config.cc`). It can also switch live from its menu without resetting the C64. Read the current standard (`IO1[wRegVid_TOD_Clks]` in the full image, `TimingVidTODClks` in the minimal and extension images), never a copy taken at boot.
- **A thread-mode PHI2 reading has to throw away long gaps.** A DMA transfer runs entirely inside `isrPHI2` (`DMATransferISR`, the REU's `DirectREU`), so while it does, no stamps arrive and thread mode doesn't run. Rounding that gap would pull a reading towards the PAL/NTSC split, so `MeasureVideoStd()` discards any reading with more than 8 periods between two stamps.
- **C64 vs C128 can't be detected at the port; it comes only from the menu's report.** A C128 held in reset doesn't drive the data bus (a DMA read of `$D030` returns `$00`), and for the first ~40–80 mS after the release it's still in C128 mode, where DMA doesn't reach the VIC either. **DMA in that early window can hang a C128's boot:** on the bench, reads in the first ~60 mS after release kept 2 of 4 warm restarts from reaching the menu, one with a corrupted screen, while restarts without early DMA never failed. Nothing should DMA right after releasing a C128's reset, and a `.crt`-packaged extension launched before the menu has run goes through the menu (`RemoteLaunch`) so the machine it's handed includes C64/C128.

## Memory budgets are hard caps, not soft targets

The main image keeps its static 128-entry CRT table in DTCM and its 64-bank
EasyFlash decoder. An EasyFlash bank of 64 or above takes the existing SD-only
MinimalBoot handoff even when a sparse file fits the main image's RAM.
Native MinimalBoot has a 256-bank decoder (2 KiB of RAM1); its CRT metadata is
allocated on the RAM2 heap, with at most 512 unique EasyFlash bank halves or
128 CHIP records for other cartridges. EasyFlash reserves its 8 KiB erased
`$FF` page in the same allocation before ROM payloads fill the heap. The page
must stay in RAM2 because the C64 bus ISR reads it directly; other cartridge
types allocate no erased page. Image buffers and the 16 swap buffers retain
their existing sizes. Large capacity comes from SD, not a larger resident ROM
buffer. `VM_HOST_PROFILE` keeps its static table, 64-bank client mapping and
original handler code; it carries no native EasyFlash metadata or erased page.

- Full firmware: `MaxRAM_ImageSize = 128` KB (`Source/Teensy/TeensyROM.h:26`) — the RAM1 image buffer. Beyond that, CRT banks spill into RAM2 via `malloc()` (`FileParsers.ino:120-128`); when that allocation fails, firmware reboots into MinimalBoot (`FileParsers.ino:165-168`, see [Teensy-Firmware.md](Teensy-Firmware.md#minimalboot-vs-full-firmware) for the full trigger mechanism) — this exhaustion point empirically lands around **~650KB** total, it is not a hardcoded threshold.
- MinimalBoot: `(440 - 8*Num8kSwapBuffers - EthernetDeduction)` KB = 208 KB (`Source/Teensy/MinimalBoot/Min_TeensyROM.h:58`) — with RAM2 and the 16 swap buffers, holds **103 8K banks (~824KB)** before any bank has to come from SD at runtime (measured 2026-10-04: an 880K EasyFlash loads 87 banks, flags 23 for swapping, 16 of them preloaded into the swap buffers, 7 left for SD; since PR #65 an EasyFlash also spends about 14 KB of that RAM2 on its CHIP table and erased `$FF` page, other cartridge types about 1.5 KB on their table, so an EasyFlash keeps one or two fewer 8K banks resident — not re-measured), at the cost of dropping USB host support (SD-only loading in this mode). Its RAM1 stack floor (>24000 free with Ethernet, measured in that header) is enforced by `tools/build-firmware.mjs`; the base was 392 until MinimalBoot's ITCM code dropped from five 32 KB banks to four.
- Files beyond that use bank-swapping from SD (only), asserting the DMA line for about 0.5–1.5 mS per uncached swap depending on the card, 2.3 mS at worst so far (since 24c187c reads each 8K bank in one call; reading it a byte at a time took ~3 mS) — not true bus-mastering DMA, just the old-school REU-style pause assertion. TR+'s true bus-mastering DMA doesn't help here: the pause just needs to be perceptually instant to the 6510 for an SD→RAM bank transfer, which bus-mastering doesn't improve. This mechanism was documented as unreliable on most C128s and a low percentage of NTSC systems; **that reliability claim may now be stale and is due for a re-test** (flagged during architecture review, 2026-08-11 — see [Known-Issues.md](Known-Issues.md)). A DMA Pause check utility (`TODCheck`/Test+Diags BASIC tool) exists to test a given system before relying on this.
  - Measured 2026-10-10 with the `Dbg_SerSD` serial command `o` (`SerUSBIO.ino`): 256 seeks + 8K reads at CRT bank offsets in an 8 MiB file kept open, as `LoadBank` (`IOH_EasyFlash.c`) keeps the CRT open. This is the SD side of a swap, not the whole pause: the test runs in the Full firmware and reads through SdFat's `FsFile` directly, while a real swap runs in MinimalBoot through SD's `File` wrapper with the C64 held by DMA. Min / avg / max per bank:
    - Patriot 32 GB, 32K clusters: 542 / 615 / 689 µS
    - SanDisk Ultra 32 GB (2017), 32K clusters: 660 / 834 / 1054 µS
    - Juanwe 32 GB, 16K clusters not aligned to its erase size: 858 / 1450 / 2342 µS
  - Moving the 8K itself takes ~0.37 mS; all three cards read at ~22 MB/s. The rest is per-command overhead and FAT32 seeking. A bank isn't sector-aligned, so each read is three card commands (partial sector, whole sectors, partial sector), four when it crosses a cluster. A backward seek on FAT32 follows the cluster chain from the file's first cluster, and one FAT sector covers 128 clusters (2 MiB at 16K, 4 MiB at 32K). A ≤1 MiB EasyFlash spans 32–64 clusters, so an unfragmented one's chain usually sits in one FAT sector, two when it crosses a FAT sector boundary; more if the file is fragmented. Real swaps should therefore land nearer each card's minimum than this test's 8 MiB file does, but that hasn't been measured.

When editing anything that changes per-file/per-struct RAM footprint in either firmware image, check these budgets — MinimalBoot's RAM scarcity is well-known and obvious, but **RAM1 pressure in the full Fab04 (TR+) build is actually the tighter, less-visible constraint**: as of 2026-08-12, the Fab04 main build (the tightest full-firmware config, since it compiles in REU/KernalReplace/Freezers on top of everything else) has only **~9-10KB of RAM1 "padding"** left before a hard link failure:
```
FLASH: code:398356, data:1518744, headers:8496   free for files:6200868
 RAM1: variables:254468, code:220104, padding:9272   free for local variables:40444
 RAM2: variables:17600  free for malloc/new:506688
```
`RAM_Image` (the fixed 128KB CRT buffer) is RAM1's biggest single consumer and won't shrink, so moving eligible code to `FLASHMEM` (see the running audit in [Known-Issues.md](Known-Issues.md)) is the main lever available to keep this build compiling as more features get added — not just an optimization.

**RAM1's 512KB is not two independently-fixed 512KB regions.** Verified against the actual `imxrt1062_t41.ld` linker script (Teensyduino 1.61.0): it's a single 16-bank × 32KB FlexRAM pool, dynamically split between ITCM (code) and DTCM (variables + stack) at link time, based on compiled code size rounded *up* to the next 32KB bank boundary (`_itcm_block_count`). `padding` is that rounding waste — not usable as stack headroom directly, but it *is* usable runway for new RAM1-resident code (new IO handlers, features) to grow into before the next bank boundary gets crossed. `free for local variables` is the real, usable stack headroom, and it's the number that determines crash risk — but `padding` is the number that determines how much longer new code can be added before `free for local variables` takes its next hit. This matters for planning: because future ISR-reachable code (which can never move to `FLASHMEM`) will eventually cross another 32KB boundary and remove a full 32K from `free for local variables` in one discontinuous jump, the working target shouldn't be "stay above the reliability floor" — it should be "stay above the floor **plus** enough margin to absorb that next jump," i.e. **~56KB+**, not the ~24KB floor itself.

**The ~24KB reliability floor itself is independently confirmed twice in your own crash-testing history, in both firmware images:**
- `Source/Teensy/TeensyROM.h:26-30` (full firmware): `// Test case: Random(?) NFC tag with large directory, crash when tapped / 20000 free got further, but still crashes. Less always crashes / *Need >24000 RAM1 free for local` — this is also what motivated shrinking `MaxRAM_ImageSize` from 144KB to 128KB (20,000 → 36,476 bytes free). A local build on 2026-08-12 measured 40,444 bytes free for the current Fab04 config — roughly 4KB more headroom than that 9/25/2025 note, gained from unrelated changes since.
- `Source/Teensy/MinimalBoot/Min_TeensyROM.h:48-52` (MinimalBoot, with Ethernet): same `>24000` threshold, independently arrived at.

**Local build capability exists to verify this going forward** (ask before assuming it's still set up if picking this up much later): `npm run build:tr-plus -- --no-extensions --skip-minimal-build --skip-combine`, run from the repo root, builds the Fab04 main firmware in about a minute and prints a report in the form quoted above — use it to check real before/after impact of any `FLASHMEM` migration rather than estimating from line counts. It does **not** reproduce the 2026-08-12 numbers: the same command on 2026-09-23 printed `RAM1: variables:236996, code:210040, padding:19336   free for local variables:57916`. Run both halves of a comparison yourself rather than diffing against either block; both are dated measurements, not live baselines.

`--no-extensions` accounts for only part of that gap. Since extensions became the TR+ default, the bare recipe also builds the extension image and links the main one with the loader compiled in. Measured 2026-09-23 from the same tree built both ways, the loader costs the main image 4,384 bytes of `free for local variables` (57,916 → 53,532) and 3,280 bytes of `padding` (19,336 → 16,056), and leaves both RAM2 figures untouched; the rest of the drift from the August numbers is ordinary code change since. Either configuration is a fair baseline for a *delta* as long as both halves use the same one — but the image that ships carries the loader, so an **absolute** check against the ~24KB floor or the ~56KB working target has to be read off the extensions build, not this one: on 2026-09-23 the no-extensions build cleared that target at 57,916 while the shipping build sat below it at 53,532.

One number in that report never applies to this firmware: `FLASH: … free for files` is `teensy_size`'s whole-board figure, not the slot the main image is actually linked into. With extensions on that slot is 7168K at `0x60060000` — everything up to the extension host slot at `0x60760000` — but the limit that binds first is the updater's, not the linker's: a self-update stages a whole spare copy of the firmware beside the running one, below the 640K the TR+ reserves at the top of flash. On 2026-09-25 the combine step reported `main 1703.0K of 7168K (23.8%)` and the headroom check that follows it `1689.0 K of headroom left before the self-update ceiling` (3776K) — the number to read, not the ~6.4MB the report prints. Both lines only appear in a full `npm run build:tr-plus` (no `--skip-combine`), which prints each region's usage as it combines them.

### Full-audit-list FLASHMEM experiment (2026-08-12) — applied, measured, then reverted

Every candidate in the [Known-Issues.md FLASHMEM audit](Known-Issues.md#flashmem-audit-running-list) was applied at once (~115 functions across 27 files, both firmwares) to see where it landed. Both firmwares built clean.

```
Baseline: RAM1: variables:254468, code:220104, padding:9272   free for local variables:40444
After:    RAM1: variables:254468, code:202744, padding:26632  free for local variables:40444
```

**The goal here wasn't stack headroom (`free for local variables`) — it was clearing `padding` runway for future RAM1-resident code growth**, e.g. new IO handlers. `code` dropped 17,360 bytes, all of which landed in `padding` (9,272 → 26,632) since the drop didn't cross a 32KB ITCM bank boundary. By that measure this was a clear success: 17KB is a lot of runway — for scale, the RetroReplay IOH added around the same time took about 800 bytes out of this same pool, so this batch is worth roughly 20+ IOH-sized additions before `padding` runs out again and a new feature starts eating into the crash-risk floor instead.

It was reverted anyway, not because it failed, but because keeping ~115 functions in `FLASHMEM` continuously pays a small per-call flash-access-time cost on every one of them, including some not-especially-cold paths (`Swift_Browser.c`'s HTML/URL parsing, `IOH_MIDI.c`'s per-note callbacks) — not worth paying yet when the ~9KB baseline still has a while to run at ~800 bytes/feature. The per-file data below is kept so a future pass can move just enough, deliberately, rather than repeating the full 27-file batch.

**Separately, also worth keeping in mind:** at 26,632/32,768 of padding, only **~6.1KB more** would have been needed to cross the boundary and jump `free for local variables` by a full 32KB in one step — a bigger, different win than the padding-runway one above, available whenever stack headroom itself (not just code-growth runway) is actually needed. Per-file impact, measured from the built ELF (`arm-none-eabi-nm --print-size`, not estimated from line counts) for files that compile into the Fab04 full firmware (Teensy.ino) — the build with the tight constraint:

| File | Bytes moved | Functions |
|---|---|---|
| `DriveDirLoad.ino` | ~3970 | 10 |
| `Swift_Browser.c` | ~3040 | 16 |
| `IOH_ASID.c` | ~2420 | 9 |
| `Teensy.ino` | ~1640 | 6 |
| `IOH_Swiftlink.c` | ~1480 | 3 |
| `IOH_MIDI.c` | ~1450 | 14 |
| `nfcScan.ino` | ~1070 | 4 |
| `RemoteControl.ino` | ~870 | 4 |
| `Swift_RxQueue.c` | ~850 | 11 |
| remaining 15 files (single `InitHndlr_*`/small helpers) | ~950 combined | ~20 |

`DriveDirLoad.ino` + `IOH_ASID.c` alone (~6.4KB) would clear the ~6.1KB gap — no need to repeat the full 27-file batch to get the next boundary jump; those two are both large, already call-graph-verified, and genuinely cold (menu navigation, MIDI/SID setup) rather than latency-sensitive.

(MinimalBoot-only files, not relevant to the Fab04 constraint above since that build already has 57KB+ headroom: `Min_DriveDirLoad.ino` ~5150 bytes/11 functions — `LoadFile()` alone is ~3890 bytes, the single largest function found in either firmware — plus `MinimalBoot.ino` ~1040 bytes/6 functions and `Min_ServiceTCP.ino` ~46 bytes.)

## The C64 main menu's compiled size directly gates SID playback compatibility

The main menu program (`Source/C64/MainMenuCRT/source/MainMenu.asm`) has to stay small not just for tidiness — every byte it assembles to is a byte no SID file can load into without being rejected, because the two share the same C64 RAM at the same time (SID playback runs as a background feature while the menu is still resident).

**Mechanism, verified end-to-end:**
1. **Compile time:** `MainCodeRAMStart = $6000` (`CommonDefs.i:36`) is the fixed origin (`MainMenu.asm:35`: `* = MainCodeRAMStart`). `MainCodeRAMEnd = *` (`MainMenu.asm:1438`) captures the assembler's program counter at that point in the source — a real measurement of the compiled size, not an estimate.
2. **Runtime, menu startup (`MainMenu.asm:155-159`):** the menu reports its own occupied page range to the Teensy over two IO1 registers:
   ```asm
   lda #>MainCodeRAMStart
   sta rwRegCodeStartPage+IO1Port
   lda #>MainCodeRAMEnd
   sta rwRegCodeLastPage+IO1Port
   ```
3. **SID load time (`FileParsers.ino:339-344`, `ParseSIDHeader()`):** the SID's own load address + size (fixed by whoever composed it, decades ago in most cases — not renegotiable) is checked against that reported range:
   ```c
   //** check for RAM conflict with TR code:   
   if (LoadAddress < (IO1[rwRegCodeLastPage]+1)*256 && LoadAddress+XferSize >= IO1[rwRegCodeStartPage]*256)
   {
      SIDLoadError("Mem conflict w/ TR app");
      return;
   }
   ```
   Overlap → the SID is outright rejected ("Mem conflict w/ TR app"), not corrupted or crashed.

**Page-granularity nuance worth remembering when trimming the menu:** only the high byte of each address is stored/compared, so the conflict boundary is rounded *up* to the next full 256-byte page (`(IO1[rwRegCodeLastPage]+1)*256`). If `MainCodeRAMEnd` sits even 1 byte past a `$xx00` boundary, that costs a full extra 256-byte page of SID-incompatible space — getting the assembled end just *under* a page boundary is a discrete win, not just a linear one.

**Real-world confirmation:** the YYZ SID couldn't play once the combined menu (with Settings and Help still built into it) grew past the point where `MainCodeRAMEnd` started overlapping YYZ's load address. Splitting Settings and Help out into their own separate PRGs (FW 0.8) shrank the resident menu enough to clear that conflict — YYZ plays again as of 0.8.

## Startup hooks run before the C++ runtime exists

The Teensyduino core's `ResetHandler2()` (`cores/teensy4/startup.c`, Teensyduino 1.61.0) calls three weak, empty hook functions during boot and uses whichever definition the sketch links in place of its own: `startup_early_hook()` (`:108`), `startup_middle_hook()` (`:192`), `startup_late_hook()` (`:209`). `Source/Teensy/StartupHooks.c` is the one place the full firmware defines them — add to that file rather than defining a hook elsewhere, so the boot-time work stays in one findable spot. Only the middle hook is currently defined; MinimalBoot defines none.

**Nothing C++ is usable in any hook.** `__libc_init_array()` (`:210`) — the C++ constructors — runs after all three, so `Serial`, `EEPROM`, `SD`, the USB host stack, and any global with a constructor don't exist yet. Hook code is plain C touching its own globals and hardware registers, nothing more. `millis()` does work from the middle hook on (`configure_systick()`, `:163`).

**Which hook depends on what has to be true when it runs:**
- **Early** (`:108`) runs before `.data`/`.bss` are initialized (`:128-129`): globals don't hold their initial values yet, and anything written to one is overwritten moments later by the copy. It also runs before code is copied into ITCM (`:127`), so it must be `FLASHMEM` (the core's own comment at `:108` says so) — a hook defined here without that attribute jumps into ITCM before the code exists there and faults or hangs before `setup()`. Nothing in TeensyROM needs this one.
- **Middle** (`:192`) is the last point before `usb_init()` (`:205`). Globals are in RAM, clocks and peripherals are up, the chip-ID fuse (`HW_OCOTP_MAC0`) is readable — the core itself reads it a few lines later at `usb.c:152` with nothing OCOTP-related in between — and nothing has been presented to the host yet: `usb_init()` attaches the controller at `usb.c:234`, resetting it first if a soft reboot left it running (`usb.c:176-197`). **Anything the host must see on first enumeration — the USB string descriptors in particular — has to be final by the end of this hook.**
- **Late** (`:209`) runs after `usb_init()` *and* after the core's deliberate enumeration wait (until ~300ms after reset — `TEENSY_INIT_USB_DELAY_BEFORE`/`_AFTER`, `:194-206`), so it's no earlier than `setup()` for anything USB-visible; it only buys "before the C++ constructors."

Hooks run exactly once per boot, so they're `FLASHMEM` candidates and should be marked as such given the RAM1 budget above.

**This came up concretely.** `UsbNames_AppendUniqueID()` (`MinimalBoot/Common/UsbNames.c`, shared by both images) overwrites the placeholder zeros in the USB product/serial strings with the chip ID so two units enumerate with distinct names. It was originally the first line of `setup()` — but `setup()` can't run until after that ~300ms wait, by which point the host has already read the descriptors, and a unit powered on with USB pre-attached could enumerate as `TeensyROM-00000000`. The fix was not a core patch — it was moving the call into `startup_middle_hook()`, where the strings are final before the device ever attaches. Same lesson applies to anything else that must be true before enumeration: `setup()` is ~300ms too late, and the middle hook is the tool.

## Toolchain pin: avoid Teensyduino 1.62.0

Confirmed root cause is the GCC 15.2.1 toolchain bump (from 11.3.1) in Teensyduino 1.62.0, **not** TeensyROM source code — causes intermittent SD-read stalls with 2 PSRAM chips installed. Build against **1.61.0**. Do not attempt to work around this by modifying source; it's an upstream toolchain regression.

## `Common_Defs.h` is shared between full and MinimalBoot builds

Explicit warning in the file itself (`Common_Defs.h:2`): "re-compile both minimal and full if anything changes here" — a change here silently desyncs the two firmware images if only one is rebuilt and flashed.

## Cartridge register layout: `Menu_Regs.i` is generated, not hand-edited

`Source/C64/MainMenuCRT/source/Menu_Regs.i` (ACME) used to be an independently hand-maintained duplicate of the Teensy-side `Menu_Regs.h` (C), with no shared source of truth. Fixed: `Menu_Regs.i` is now generated from `Menu_Regs.h` by `tools/lib/menu-regs.mjs` (originally `gen_menu_regs_i.py`), and every `npm run build:c64` regenerates it first. **`Menu_Regs.h` is the only one to hand-edit** — a manual change to `Menu_Regs.i` will be silently overwritten on the next build. See [Comms-Protocol.md](Comms-Protocol.md) and [Known-Issues.md](Known-Issues.md#cartridge-register-map-menu_regsi--menu_regsh-is-hand-duplicated-across-two-languages) for the full writeup.

<br>

[Back to Architecture Overview](Overview.md)
