SensoriumEmbedded/TeensyROM/docs/Architecture/C64-Software.md

# C64-Side Software

6502/6510 assembly programs that run ON the Commodore 64/128 itself — the on-screen menu, settings UI, and bundled utilities. Distinct from the Teensy firmware in [Teensy-Firmware.md](Teensy-Firmware.md), but the two are built in sequence — see [Overview.md](Overview.md#the-two-toolchains-and-how-they-connect).

Canonical build reference: [Source/C64/README.md](/Source/C64/README.md) (verified accurate — prefer it over this doc for exact tool versions/paths).

## Layout

`Source/C64/` has one directory per sub-project, each `<Project>/source/` (sources) + `<Project>/build/` (output, cleaned each build). `tools/c64-projects.json` lists every sub-project's assembler steps and headers; `npm run build:c64` builds them in that order and halts on first error, and `--project <name>` builds one.

Toolchain: **ACME cross-assembler 0.97** for all `.asm`/`.s` files, except **TRCustomBasicCommands**, which uses **KickAssembler** + Java. The builder converts each compiled `.prg`/`.bin` into a C header (a Node port of bin2header) written into `Source/Teensy/TRMenuFiles/ROMs/` for the firmware build.

| Sub-project | `--project` name | What it is |
|---|---|---|
| `MainMenuCRT` | `MainMenuCRT` | The cartridge boot menu itself — see below |
| `SettingsMenu` | `SettingsMenu` | F8-triggered multi-page settings/config menu — see below |
| `TRHelpScreens` | `TRHelpScreens` | In-menu help screens |
| `TRExtPortCheck` | `TRExtPortCheck` | External port check utility |
| `ExpansionPortTest` | `ExpansionPortTest` | Expansion port test (TR+ only) |
| `ASIDPlayer` | `ASIDPlayer` | ASID (MIDI SID) player app |
| `MIDI2SID` | `MIDI2SID` | MIDI-to-SID synth app (IO1 register block reuses raw SID register offsets — `Menu_Regs.i:78-108` flags this as needing to stay in sync or be split out) |
| `SimpSwiftTerm` | `SimpSwiftTerm` | Simple SwiftLink terminal program |
| `TODCheck` | `TODCheck` | CIA Time-of-Day clock check utility |
| `TRCustomBasicCommands` | `TRCustomBasicCommands` | Custom BASIC commands — vendored, see below |
| `BASIC` | `BASIC` | Grab-bag of pre-built standalone `.prg` utilities, individually header-converted |
| `v1541Wrapper` | `v1541Wrapper` | Virtual 1541 wrapper — **deferred/planned feature**: built and its header kept current, but not yet used by the firmware; waiting on further developer capability before inclusion. Also intended as a general-purpose wrapper for assembly-code PRGs. |

## MainMenuCRT — the cartridge boot menu

Files in `MainMenuCRT/source/`: `TeensyROMC64.asm` (171 lines), `MainMenu.asm` (1432 lines), `PRGLoadStartReloc.s` (140), `SIDRelated.s` (522), `StringFunctions.s`, `StringsMsgs.s`, `CommonDefs.i`, `Menu_Regs.i` (register map, see [Comms-Protocol.md](Comms-Protocol.md)), `c64defs.i`.

`Menu_Regs.i` physically lives here but is shared well beyond MainMenuCRT — it's `!src`-included by relative path from 6 sub-projects' top-level `.asm` files: both `MainMenuCRT` sources (`TeensyROMC64.asm`, `MainMenu.asm`), `SettingsMenu`, `TRHelpScreens`, `TRExtPortCheck`, `MIDI2SID`, and `ExpansionPortTest`. It's one physical file (not duplicated per sub-project), so any future fix to the [Menu_Regs sync problem](Known-Issues.md) only needs to regenerate this one file, not touch the 6 consumers. `ASIDPlayer.asm:7` has the same include line present but **commented out** — unclear if intentional (ASID doesn't need those registers) or a leftover; worth a quick check before relying on that assumption.

- **`TeensyROMC64.asm`** is the actual 8K cartridge ROM image (`* = $8000`, `Coldstart`/`Warmstart` vectors, `CBM8O` autostart key). Does minimal hardware init (VIC/CIA/SID reset), scans the keyboard once before enabling IRQs so a key still held from before the reset isn't queued as a new press, prints the banner, then copies the separately-built `MainMenu.bin` (`!binary`-included) from cart ROM into C64 RAM at `MainCodeRAMStart` (`$6000`, per `CommonDefs.i`) and jumps there.
- **`MainMenu.asm`** is the menu program proper, running from RAM: file browser/menu UI (`ListMenuItems`, `SelectItem`, `RunSelected`, `XferCopyRun`), cursor/page navigation, keyboard handling, NFC tag writing, RTC/time display.
- **`StringFunctions.s` / `StringsMsgs.s`**: the string printer (`PrintString`, with escape codes for colors and runs of spaces) and the serial-string reader (`PrintSerialString`, one byte per IO1 read of `rwRegSerialString`). The banner row every screen opens with is not laid out on the C64: `PrintBanner` prints the clear/color/reverse prefix, then the whole 40-column row the Teensy composes (`rsstBannerMenu` here; the Settings, Help and port-test programs ask for `rsstBannerSettings`, `rsstBannerHelp` and `rsstBannerTest`, which add their page word), then reverse off. Centering, the page word and a special build's version tag are the Teensy's business (`MakeBannerRow` in `IOH_TeensyROM.c`).
- **`PRGLoadStartReloc.s`**: relocated into the cassette-buffer zero page (`$033c`, per `CommonDefs.i`) and executed from there while a `.PRG` streams in. Polls `rRegStrAvailable`/`rRegStreamData` (IO1 registers) to pull bytes from the Teensy, sets BASIC's end-of-program/variables pointers, signals the Teensy via `wRegControl = rCtlRunningPRG`, then re-enters BASIC warm-start (`jmp $a7ae`). Comments document a hardcoded startup delay to avoid a race condition, and address wrap-around handling during load.
- Build order: the `MainMenuCRT` project compiles `MainMenu.asm` to `MainMenu.bin` first, then `TeensyROMC64.asm` (which embeds that binary) to produce the final headerless cartridge image — the one C64 build output that intentionally has **no PROGMEM header** (must land in RAM for ROM emulation, per `Source/C64/README.md`).

## SettingsMenu — the multi-page settings framework

`SettingsMenu.asm` is the driver: defines `NumPages`, a jump table `tblSettingsPages`, and `!src`-includes one file per page. Each page is its own `.asm` with a `<Name>Menu:` entry label, its own init/key-wait loop, and message text. `_SettingsPageTemplate.asm` is the copy-paste starting point for a new page (currently still has leftover "Ethernet" naming from whatever page it was cloned from — a trap for anyone copying it without cleaning up). Shared logic (`CommonInit`, `CheckCommonKeys` — the F8→number page-dispatch — `DisplayTime`, `GetIn`, string helpers) lives once in `SupportFunctions.asm` and `StringFunctions.asm`, used by every page.

Page files (index → content, per the FW 0.8 layout): `Pg_Index.asm`, `Pg_TRSettings.asm` (TeensyROM General), `Pg_StartupOptions.asm`, `Pg_ColorConfig.asm` (Menu Colors), `Pg_MIDISettings.asm` (MIDI Message Filters), `Pg_TimeRTCSettings.asm` (Time Format/RTC), `Pg_InfoOther.asm` (Info: General), `Pg_EthernetSettings.asm` (Info: Ethernet), `Pg_InfoHotKey.asm` (Info: HotKeys), `Pg_InstalledExt.asm` (Installed Extension — names the host in the firmware slot via `rCtlMakeExtHostStrWAIT`, and uninstalls it with `u` via `rCtlUninstallExtHostWAIT`).

`CheckCommonKeys` maps keys `'1'`-`'9'` to page indices 0-8 by arithmetic on the digit run; the tenth page is reached with `'0'`, dispatched by its own branch to `PageIdxInstalledExt`.

**When adding/moving a settings page, or documenting Settings Menu key sequences, verify the current page-index and in-page key bindings against these files directly** — this menu was rewritten once already (single-screen → 9-page) and stale key references in docs have been a recurring problem.

## TRCustomBasicCommands — vendored third-party

`Source/C64/TRCustomBasicCommands/source/README.md` is unmodified upstream documentation crediting **Barry Walker (2023)**, MIT licensed, built with KickAssembler at `$c000` — treat that subtree's generic framework code (`main.asm`, `memory.asm`, `sprites.asm`, `include/`) as vendored, not TeensyROM-authored. Adds custom BASIC commands/functions (`BACKGROUND`, `BORDER`, `WOKE`, `MEMCOPY`, `STASH`/`FETCH` for REU, `MEMLOAD`/`MEMSAVE`, sprite commands, `DIR`). TeensyROM-specific additions are layered in separate files alongside the vendored skeleton: `teensyrom.asm` and `reu.asm` — this is where `TISET` and any other TR-specific BASIC command lives.

## Build pipeline (per sub-project)

For each project, `tools/build-c64.mjs` empties its local `build/`, invokes ACME (`-r <BuildReport> --vicelabels <Symbols> --msvc --format <cbm|plain> --outfile`; KickAssembler for `TRCustomBasicCommands`), then converts each output to a header written straight into `Source/Teensy/TRMenuFiles/ROMs/`. Full details, prerequisites, and tool versions: [Source/BuildInfo.md](/Source/BuildInfo.md) and [Source/C64/README.md](/Source/C64/README.md).

<br>

[Back to Architecture Overview](Overview.md)
