SensoriumEmbedded/TeensyROM/docs/Architecture/Extension-Hosts.md

# Writing your own extension host

A TeensyROM+ extension host is a third firmware image. It lives in its own flash
slot, it is installed and removed without reflashing the board, and while it runs
it owns the machine. No firmware hex carries one: a board runs exactly as it
would without the slot until someone installs a host into it. This repo has one
— the VM host in `Source/Teensy/VMBoot`, which loads and runs modules — and it is
built and installed the same way yours is. Nothing about the slot is specific to
it. A host is whatever program you put there.

This document is the host side. The module side, for code that runs *under* this
repo's VM host rather than replacing it, is [`vm/abi/README.md`](../../vm/abi/README.md).

`Source/Teensy/ExampleHost` is a complete, buildable host that does nothing
useful on purpose: it blinks the LED four times and returns to the menu. It
exists so that the four things a host actually owes can each be pointed at.

## Why a host is a separate image at all

Not for isolation, and not for features — for the memory map. A module needs
96 or 128 KiB of ITCM and 192 KiB of DTCM at *fixed* addresses, and the ordinary minimal
image cannot give it those while still holding a megabyte of cartridge. So the
build produces a third image with that map and the other two shrink to make room.
`tools/lib/extension-image.mjs` generates the linker script that does it, and
turns a layout regression into a link error rather than a hang on hardware:

| Assert | What it catches |
|---|---|
| `__exidx_end <= 0x10000` | host code outgrowing its 64 KiB of ITCM (`0x18000` with `--host-code-kib 96`) |
| `_heap_end <= _vm_data_start` | host heap growing into the module's DTCM window |
| `_estack - _vm_data_end >= 49152` | the shared stack falling below 48 KiB |
| `SIZEOF(.bss.dma) == 0` | host globals landing in the guest's RAM2 arena |
| `SIZEOF(.bss.extram) == 0` | a host that needs PSRAM, which the map does not reserve |

Those hold for your host too, because your host is built with the same script.

The script also places the `.text` of the SdFat, SD and SPI libraries in flash
rather than ITCM, which is what fits the stock host in 64 KiB. SdFat's SDIO
driver, `SdioTeensy.cpp`, stays in ITCM: `SdioCard::readData` masks interrupts,
and a flash cache miss there would hold off `isrPHI2`. The libraries are matched
by their build path, so the build refuses an `--out` inside a `libraries/SdFat`,
`libraries/SD` or `libraries/SPI` directory. A host that needs
more ITCM can pass `--host-code-kib 96` with `--host-sketch`, which lets its code
grow up to the module window at `0x18000`. That trade is the module's 32 KiB: a
host linked at 64 KiB can take a module linked at `0x10000`; one linked at
96 KiB can too, but only if its own code still ends at or below `0x10000`.

## The four things a host owes

Everything else is your program. These four are what make it a host.

### 1. The descriptor

```c
__attribute__((used, section(".vmhostid")))
const VmHostId vmHostId = { VM_HOSTID_MAGIC, VM_ABI, 0, 0, "Example", VM_HOST_CODE_FLOOR };
```

The main image reads this out of flash *without booting your host*, to name it on
the Installed Extension page and to decide whether a module's required services
exist. The linker script places the section; nothing in your code picks the
address. `name` is 12 bytes and need not be terminated. `services` is a bitmask of
the module services you provide — `0` is legal and means a module asking for any
service is refused against your host rather than crashing inside it.

The last field is `code_floor`, the lowest code base you can take, which is where
your own code ends. Write `VM_HOST_CODE_FLOOR` rather than a number: it resolves
to your link's `__exidx_end`, so the descriptor cannot claim room you are using.
Zero reads as `0x18000`, the base every host accepts, so a host that omits it is
offered only the 96 KiB window.

A floor is a promise about your loader as well as your link: that it copies the
module to the image's own `code_base`, opens the MPU window there, and checks the
module table against it, as `loadModule` in `VMHost.h` does. A host whose loader
uses a fixed base leaves the field at 0. Given a floor, such a host would be
handed a module linked at `0x10000` and load it in the wrong place; at 0 the
launch refuses it with `<name> host states no code floor, so takes
$18000 only`. A stock host installed before the field existed reads the same
way, and reinstalling it from a current firmware package gives it a floor.
`ExampleHost` loads no modules and publishes its floor all the same, so a loader
you add to it has to honour `code_base`, or the field has to go to 0.

A host with no descriptor still runs. The Installed Extension page says
`Installed, no descriptor.` rather than naming it.

### 2. The marker

Being in the slot is not authorization to run. `@VM1` at `VM_EEP_BOOTNAME_ADDR` is
what says an extension was selected rather than a cartridge. Minimal tests it
itself before it jumps — along with the boot indicator, the menu button and the
EEPROM magic — so a host checking it is taking a second look at what minimal
already agreed to. Cheap, and the right thing to check if you check anything: it
is the only value that means "entered on purpose".

**Do not check the boot indicator the way `MinimalBoot.ino` does.** Minimal has
already replaced `VM_BOOT_EXECUTE_MIN` with `VM_BOOT_FROM_MIN` by the time a host
sees it — it does that first, so a fault in your image cannot trap the cartridge
in a relaunch loop. Testing for `VM_BOOT_EXECUTE_MIN` therefore never passes, and
every launch falls through to the main app, which from the C64 looks exactly like
a host that failed.

Past the marker's terminator, at `VM_EEP_MACHINE_ADDR`, the main image leaves the
machine -- `VM_MACHINE_NTSC`, `VM_MACHINE_60HZ`, `VM_MACHINE_C128` -- followed by its
complement. PAL/NTSC is what the main image timed from PHI2; C64/C128 and 50/60 Hz
are what the C64 menu reported. A host that drives the bus itself needs it to pick
its timing, because this image boots without the menu. A launch made before the menu
has run goes through the menu first, so a current main image always leaves the pair;
`vm_launch_machine()` reads it, and answers `-1` for an older main image that did not
leave one. A main image predating the pair does not clear it, so after a downgrade it
can be one a newer image left.

PAL/NTSC can change after the pair is written: a C64U applies a saved standard only
after the cartridge port's reset is released, and can switch live from its menu. A
host that drives the bus should time PHI2 itself as well, as the stock host does
(`MachineDetect.h`), and keep only C64/C128 from the pair.

### 3. The record

Your host is built `USB_DISABLED`, because the USB stack's buffers live in DMAMEM
and collide with the guest RAM2 arena. So it has no serial, and a failure inside
it is otherwise completely silent — from the couch it looks like "junk on screen,
then the menu came back".

Leave a `VmFailRecord` at `VM_FAIL_BASE` instead. It sits in the cache line below
Teensy's own `CrashReport` at the top of RAM2, survives the soft reset, and the
main image collects it on the way up and prints it on the C64 menu. Layout, magic
and address are published contract in `VMHostABI.h` precisely so a third-party
host can write one this image reads.

`VmFail::set()` handles the cache flush, which is load-bearing: RAM2 is cached and
the reset does not write the cache back.

Use `$50 HostReturned` when your host finishes normally and hands the machine
back. Every other code describes something this repo's host does — `Ok` is
filtered out of the menu report entirely, and `Exited` names a module you may not
have. `detail` is yours; the menu prints it and attaches no meaning to it.

### 4. The way back

`RebootTR()` is a raw MCU reset, so it leaves the boot indicator at whatever was
last written. Minimal wrote `VM_BOOT_FROM_MIN` there before jumping to you, so a
host that never touches the byte is already right. A host that writes
`VM_BOOT_SKIP_MIN` itself has replaced it — the stock host does, to clear the flag
in case power is lost while it runs — and the main image reads `VM_BOOT_SKIP_MIN`
as a cold power up and answers by re-running the user's autolaunch file, sending
the machine somewhere the user did not ask to go.

Write `VM_BOOT_FROM_MIN` to `VM_EEP_BOOTIND_ADDR` first, give the EEPROM write
time to land, then reset. That is right either way, and costs one EEPROM write.

## Building it

Your sketch directory holds exactly one `.ino` plus whatever else it needs, as a
flat directory of files. Those files are overlaid onto the `MinimalBoot` sketch —
which is how the stock host is built too — so you inherit the pin definitions,
the PHI2 ISR and the C64 bus machinery, and you replace the top-level program.
A subdirectory is refused rather than skipped: the overlay copies files and does
not descend, so a `src/` the build silently passed over would leave you holding a
host built without your own code. Hidden entries such as `.git/` are passed over:
arduino-cli compiles nothing in them, so a host kept in its own repository builds.

```
node tools/build-firmware.mjs --target tr-plus --host-sketch Source/Teensy/ExampleHost
```

That builds the host and nothing else, and writes it as a package,
`build/firmware/TeensyROM+_<ver>_ExampleHost.TRH`. The minimal and main images are
not built: your host is installed onto a board running the stock firmware, so a
firmware of your own around it would only be a second copy of the release under a
name that suggests the two belong together.

Two consequences of the overlay worth knowing before your first build:

- **The sibling `Min_*.ino` files come along and are compiled.** They reference
  globals that `MinimalBoot.ino` defines, and you replaced `MinimalBoot.ino`, so
  your `.ino` has to define them: `RAM_Image`, `BtnPressed`, `EmulateVicCycles`,
  `CurrentIOHandler`, `DriveDirMenu`, `DriveDirPath`, `LOROM_Mask`, `HIROM_Mask`,
  `CmdChannel`, and the four `EEP*` helpers. `ExampleHost.ino` defines exactly
  that set and nothing more, so it doubles as the list.
- **A prototype hoisted above its own constants will not compile.** The sketch
  preprocessor collects prototypes to the top of the concatenated file, so a
  helper whose signature names a `constexpr` defined further down fails with an
  error that blames the definition's line. `Teensy.ino` and `VMHost.h` each
  carry a note about it.

`--host-sketch` is refused rather than ignored where there is no extension slot to
build into (`--target tr`, `--no-extensions`, `--skip-extension-build`): a flag
that silently did nothing there would ship the stock host under your name.

For the same reason, giving `--host-sketch` twice is refused rather than resolved.
This matters because `npm run <script> -- …` appends your argument *after* the
script's own, so `npm run build:example-host -- --host-sketch Source/Teensy/MyHost`
passes `--host-sketch` twice — and the value that used to win was the script's, not
yours. Call `node tools/build-firmware.mjs --target tr-plus --host-sketch <dir>`
directly for your own host; `npm run build:example-host` is only for this repo's
example.

## Packaging and installing it

The `.TRH` container is a 64-byte header plus the raw slot image. A `--host-sketch`
build writes one for you, named for the sketch directory it built:
`TeensyROM+_<ver>_MyHost.TRH`. A host built some other way is packaged with

```
node tools/build-host-package.mjs --hex my-host.hex --out MYHOST.TRH
node tools/build-host-package.mjs --image my-host.bin --out MYHOST.TRH
```

`--hex` lifts the slot's bytes out of a hex linked for the slot; `--image` takes
raw `objcopy -O binary` output. A firmware hex is refused — no firmware carries a
host. Every check the device applies before it erases is applied at packaging time
against the same constants, the build's own included, so a package that reaches the
C64 has already been refused on this side if it was going to be refused at all. The
one thing it cannot check is whether the image is the host you meant, so it prints
the descriptor it found — read that line.

Install it by copying the `.TRH` to the card and selecting it in the menu, or over
USB without touching the card:

```
python3 tools/bench/hostinstall.py MYHOST.TRH
```

Remove it from the C64 menu — `F8` for Settings, `0` for Installed
Extensions, then `u` and `y`. There is no removal command over the wire;
`python3 tools/bench/hostuninstall.py` presses those same keys by DMA, and
`tools/bench/hostcycle.py` runs the whole install/remove cycle unattended.

The install direction is reachable over the wire. `LaunchFileToken` is served on
every channel, the TCP listener on port 2112 included, and a launched `.TRH`
reaches `DoHostInstall` — which erases and programs the slot — as a launched
`.hex` reaches `DoFlashUpdate`. A board with `NetListenEnable` set is one where
the whole command protocol is exposed to the LAN, unauthenticated.

## What you get to use

| | |
|---|---|
| Flash slot | 384 KiB at `0x60760000`, the top of flash below the EEPROM emulation; firmware updates leave it alone |
| ITCM | 64 KiB for host code, or 96 KiB with `--host-code-kib 96`. Module code takes `0x00018000` up, and `0x00010000` up from a host that stopped at 64 KiB |
| DTCM | everything below `0x20014000`, heap capped at 16 KiB |
| Stack | 48 KiB, shared |
| RAM2 | 512 KiB — the guest arena; **your globals may not land here** |
| PSRAM | none: not reserved by the map |
| USB | none: the image is built `USB_DISABLED` |

If you are not running modules, the ITCM and DTCM windows reserved for them are
still reserved — the linker script is the same one. That is 96 KiB of ITCM (128
with the default 64 KiB host budget) and
192 KiB of DTCM your host cannot use, in exchange for a module ABI you are not
using either. A host that will never load a module could generate a different
script; nothing in the loader requires the module windows to exist, only that the
image is linked for the slot and passes `vm_host_slot_valid`.

## Running modules instead

If what you want is code running *under* the stock host rather than a host of your
own, you do not need any of the above. Install the stock host — `npm run
build:tr-plus` writes it as `build/firmware/TeensyROM+_<ver>_VMBoot.TRH`, and every
CI run keeps one in its `firmware` artifact — then write a module against
[`vm/abi/README.md`](../../vm/abi/README.md) and build it with
`tools/build-extension.mjs`:

```
node tools/build-extension.mjs --id HELLO --extensions hi \
  --source vm/hello/hello.cpp --client-source Source/C64/VMHello/vmhello.a
```

`vm/hello/hello.cpp` is the reference module, and `vm/tests/` builds and runs it
against a native fake host on every `npm run verify:extensions`.

Add `--code-kib 128` if the module needs more than 96 KiB of code. That links it
at `0x10000`, which the stock host takes and a host with more of its own code may
not; the preflight refuses it on screen, before the reboot, and says why.
