SensoriumEmbedded/TeensyROM/docs/ControlComms.md

# TeensyROM USB/Ethernet Remote Command Protocol
 
## Overview

This document describes the **command protocol** used to remotely control a TeensyROM (or TeensyROM+) unit from an external host — a PC, single-board computer, or microcontroller — over USB Serial or Ethernet TCP. The protocol is a binary, token-based request/response scheme: each command begins with a 16-bit token identifying the operation, followed by any required parameter bytes, and the TR replies with an `AckToken`/`FailToken` and any associated response data. It covers everything from basic actions (launching files, resetting the C64, checking firmware version) to more advanced operations such as direct C64 memory read/write via DMA (TR+ only), SID playback control, file transfer (post/get/copy/delete), and directory listing.

The sections below detail the physical/transport connection options, advanced behavior (firmware modes, timing, and robustness considerations), and the full token and command reference.

## Connection options/details

### Ethernet TCP
  * TR Setup: Set "Enable TCP Listener" to "On"
  * Ethernet connection to port 2112 of TR IP address.
    * IP address can be set static or DHCP, see Ethernet documentation.
  * TCP connection can be persistent or re-established for each transaction.

### USB Serial
  * Connect Host computer USB-A to TR USB-B micro.
    * No additional TR Setup required
    * Host USB Serial connection can be made at any speed as the TR device port uses true USB communication rates (480 Mbps). Most projects set the host to 2000000 baud, 8/N/1.
  * Optionally, microcontroller USB device control via connection to TR USB-A host port.
    * TR Setup: "USB Host Serial Dev" set to "TRCont"
    * USB Device Serial connection can be made to TR Host at 115200 baud, 8N1.

### General
  * Command tokens/fields are sent in big-endian to TR.
  * Ack/replies from TR are sent little-endian.
  * Excessive USB/Ethernet traffic can interfere with emulation, so only specific commands are always available. When other commands try to communicate during these operations, a "Busy!" message is sent back. Issuing a reset will return the TR/C64 to its main menu and allow all available commands.

The protocol is also currently implemented in several control projects, for reference:
|Project name/Link|Developer|Description|
|:--|:--:|:--|
|**[Trom API](https://github.com/MetalHexx/TeensyROM-Suite/blob/main/docs/trom-api.md)** |[MetalHexx](https://github.com/MetalHexx)|Engine of the TeensyROM Suite: speaks this protocol over USB serial and TCP, and serves it as an HTTP API with an OpenAPI spec|
|**[TeensyROM Suite](https://github.com/MetalHexx/TeensyROM-Suite)** |[MetalHexx](https://github.com/MetalHexx)|Trom UI (web, with the DJ Mixer), Trom Terminal and Trom Agent, all built on Trom API|
|**[c64cast](https://github.com/kfox/c64cast/)**  |[Kelly Fox](https://github.com/kfox) |Python project to stream video/audio to the C64 via the TR+|
|**[TRWinApp](https://github.com/SensoriumEmbedded/TRWinApp)** |[SensoriumEmbedded](https://github.com/SensoriumEmbedded)|Very basic command implementation, used for test/development|
|**[TeensyROMControl](https://github.com/SensoriumEmbedded/TeensyROMControl)** |[SensoriumEmbedded](https://github.com/SensoriumEmbedded)|Library for TeensyROM control from a microcontroller|
|**[trterm](https://github.com/idolpx/trterm)** |[idolpx](https://github.com/idolpx)|TeensyROM Terminal Client in Python|

---

## Advanced Connection Details

### Command Availability During Operations

The TeensyROM divides commands into two availability tiers:

#### Always-Available Commands
These commands are processed regardless of what handler is active, even if the TeensyROM is "busy":
  * Core control (LaunchFile, ResetC64, VersionInfo, FWCheck)
  * DMA memory access (WriteC64Mem, WriteC64Spans, ReadC64Mem) and SampleWatch — TR+ only
  * C64 pause control (C64PauseOn, C64PauseOff)

#### Conditionally-Available Commands
These commands return `FailToken` (`0x9B7F`) followed by `"Busy!\n"` if the TeensyROM is not idle:
  * All file operations (PostFile/SendFile, GetFile, GetDirectory, CopyFile, DeleteFile)
  * All SID-related commands (PauseSID, SetSIDSong, SetSIDSpeed*, SetSIDVoiceMute)
  * Other menu/UI commands (SetColor, Ping, Debug)

While the ASID Player is running, Ping and the file operations are also accepted over USB serial. ASID playback can pause while one runs, because the TeensyROM doesn't read incoming ASID data until the command finishes. TCP doesn't answer any command while the ASID Player runs, because the player turns off the Ethernet interrupt.

---

### Minimal vs. Full Firmware Modes

TeensyROM uses a dual-firmware system for large cartridge support:

#### Minimal Firmware Boot
  * **Purpose**: Lightweight loader for large CRT files; reduces memory footprint to maximize cartridge size
  * **Restricted Command Set**: Only these commands are available in minimal mode:
    * `ResetC64Token` (Includes Reset to Full FW)
    * `LaunchFileToken` (Includes Reset to Full FW)
    * `VersionInfoToken`
    * `FWCheckToken` (responds with `FWMinimalToken` `0x64E1`)
  * **All other commands**: Return `FailToken` + `"Busy!\n"`
  * **Trigger**: Automatic when launching large CRTs (if FW mode switch is needed)
  * **Detection**: Query firmware type via `FWCheckToken` (`0x64E0`):
    * Response `0x64E1` = Minimal firmware
    * Response `0x64E2` = Full firmware

#### Full Firmware
  * **All commands available** (when not busy with active handler)
  * **Larger memory footprint** limits maximum cartridge size (~650 KB before switch to Minimal FW)

---

### Knowing When the Menu Has Booted

After a reset, or anything else that returns the C64 to the TeensyROM menu (including a reboot out of Minimal FW), the menu has to finish booting before it reliably accepts commands. Boot time depends on which features are enabled: NFC, the SD card or USB drive, the startup SID, network time sync, and the TCP listener. It ranges from under a second to tens of seconds when DHCP gets no response. A command sent during the boot can be delayed or lost.

Full FW reports the boot state on the last line of the [Version Info](#version-info) reply:
  * `Boot: in progress`: from each return to the menu until the menu has displayed its item list. When the C64 was reset to run a remote launch, the state changes to `complete` as the launched file starts. If that file returns to the menu (a SID, text file, picture, or load error, after a key press on its screen), the state goes back to `in progress` until the menu finishes booting and displays its item list. A cartridge started without the menu (an autolaunch, or a launch sent while in Minimal FW) reports `complete` as soon as it starts.
  * `Boot: complete`: the menu has finished booting and accepts commands. It stays `complete` while a launched program runs and while a launched SID, text file, or picture waits for a key (that screen accepts remote commands), until the next return to the menu.
  * No `Boot:` line: Minimal FW, or firmware from before this line was added.

To wait for the menu, poll Version Info until it reports `Boot: complete`. Send one request at a time, wait for each reply, and pause briefly between requests. `GoodSIDToken` (`0x9B81`) does not mean the menu is ready: the menu sends it partway through the boot, when it loads its startup SID. Over TCP, the listener starts near the end of the boot, so after a reboot the first reply usually already reports `complete`.

A C64 reset the TeensyROM doesn't see (reset detect disabled in Settings) doesn't clear the flag.

---
 
## Tokens

### Command Tokens
|Token Name|2 byte value|Description|
|:--|:--|:--|
|*ResetC64Token | 0x64EE  | Reset C64 |
|*LaunchFileToken | 0x6444  | Launch/execute a file on C64 |
|*VersionInfoToken  | 0x6476  | Get firmware version and build info |
|*FWCheckToken | 0x64E0  | Query firmware type |
|PingToken | 0x6455  | Check device connectivity and status |
|SendFileToken | 0x64AA  | File transfer (PC → TR) - legacy, now identical to PostFileToken |
|PostFileToken | 0x64BB  | File transfer (PC → TR) - v2 |
|GetFileToken | 0x64B0  | Retrieve file from TR storage |
|CopyFileToken | 0x64FF  | Copy file between directories |
|DeleteFileToken | 0x64CF  | Delete file from storage device |
|GetDirectoryToken | 0x64DD  | List directory contents (JSON format - deprecated) |
|GetDirNDJSONToken | 0x64DE  | List directory contents (NDJSON format) |
|SetColorToken | 0x6422  | Set a TR UI color value |
|SetRTCToken | 0x6474  | Set the real-time clock |
|PauseSIDToken | 0x6466  | Pause SID playback |
|SetSIDSongToken | 0x6488  | Set sub-song number of currently loaded SID |
|SIDSpeedLinToken  | 0x6499  | Set SID playback speed (linear equation) |
|SIDSpeedLogToken  | 0x649A  | Set SID playback speed (logarithmic equation) |
|SIDVoiceMuteToken | 0x6433  | Set individual SID voice muting |
|*C64PauseOnToken | 0x6431  | Pause C64 via DMA |
|*C64PauseOffToken  | 0x6430  | Resume C64 (un-pause) |
|*WriteC64MemToken  | 0x64FB  | Write sequential C64 memory segment via DMA (TR+ Only)|
|*WriteC64SpansToken | 0x64FC | Write up to 64 C64 memory spans via DMA, in slices (TR+ Only)|
|*ReadC64MemToken | 0x64FD  | Read sequential C64 memory segment via DMA (TR+ Only)|
|*SampleWatchToken  | 0x64F9  | Count the C64's writes to one address (TR+ Only)|
|*SnoopTapToken | 0x64F8  | Record bus cycles on chosen pages and send them back (TR+ Only, `DbgSnoopTap` builds only)|
|DebugToken | 0x6467  | Internal debug use only |

*- Always available with full FW (others return "Busy!" if not ready for commands)

### Response Tokens
|Token Name|2 byte value|Description|
|:--|:--|:--|
|AckToken | 0x64CC  | Acknowledgment response |
|FailToken | 0x9B7F  | Failure response |
|RetryToken | 0x9B7E  | Retry command (reserved — not currently sent by any implemented workflow) |
|BadSIDToken | 0x9B80  | SID header parsing failed (sent asynchronously during file load) |
|GoodSIDToken | 0x9B81  | SID header parsed successfully (sent asynchronously during file load) |
|FWMinimalToken | 0x64E1  | Minimal firmware response |
|FWFullToken | 0x64E2  | Full firmware response |
|StartDirectoryListToken | 0x5A5A | Directory listing start marker |
|EndDirectoryListToken | 0xA5A5 | Directory listing end marker |

## Command descriptions
 
Workflow tables are written from the TeensyROM's point of view: "Receive" means the TR receives data from the host, and "Send" means the TR sends data back to the host.

---

### Reset C64
Resets the C64/128, returning it to the TeensyROM main menu (and full FW if in minimal). All commands become available again after a reset, regardless of prior busy state.

**Workflow:**
| Direction | Data |
|---|---|
| Receive | `ResetC64Token` — `0x64EE` |
| Send | `"Reset cmd received\n"` |

**Handler:** Device resets the C64 and responds with a confirmation message; no separate `AckToken` response.

---

### Launch File
Launches/executes a file (PRG, CRT, SID, etc.) from the specified storage device on TeensyROM.

**Workflow:**
| Direction | Data |
|---|---|
| Receive | `LaunchFileToken` — `0x6444` |
| Send | `AckToken 0x64CC` |
| Receive | DriveType (1), Path (MaxNameLength, null-terminated)<br>DriveTypes (`RegMenuTypes`): `USBDrive = 0`, `SD = 1`, `Teensy = 2` |
| Send | `AckToken 0x64CC` on pass, `FailToken 0x9B7F` on fail |

**Note:** If the launched file is a SID, `BadSIDToken` (`0x9B80`) or `GoodSIDToken` (`0x9B81`) may also be sent asynchronously during header parsing, separately from the Ack/Fail pair above.

**Handler:** `LaunchFile()`

---

### Version Info
Retrieves firmware version and build information from the TeensyROM.

**Workflow:**
| Direction | Data |
|---|---|
| Receive | `VersionInfoToken` — `0x6476` |
| Send | `AckToken 0x64CC` |
| Send | Version/build info string |

**Example output (full FW):**
```
  FW: TeensyROM+ v0.7.2
      Jul 27 2026, 09:41:32
  Teensy: 816MHz  59.1C  UID: 19307720
  C128  NTSC Vid  60 Hz
  Boot: complete
```

**Example output (minimal FW):**
```
  FW: TeensyROM+ v0.7.2(minimal)
      Jul 27 2026, 09:41:32
  Teensy: 816MHz  59.1C  UID: 19307720
```

**Handler:** Device acknowledges the token, then returns firmware version, build date, and Teensy clock speed/temperature as a formatted string. Full FW (only) appends a fourth line with the detected machine info (C64/C128, NTSC/PAL, TOD Hz), and a fifth with the menu's boot state, `Boot: in progress` or `Boot: complete` (see [Knowing When the Menu Has Booted](#knowing-when-the-menu-has-booted)).

A development build may carry more in the version than digits and dots: a build tag appends `-<tag>` (`FW: TeensyROM+ v0.9-pr65`), and a build from uncommitted sources ends the version with `*`. Read the version up to the first space or `(`, not as a number.

---

### Firmware Check
Queries which firmware mode (Minimal or Full) is currently loaded. See [Minimal vs. Full Firmware Modes](#minimal-vs-full-firmware-modes) for background on why this matters before executing file operations or SID commands.

**Workflow:**
| Direction | Data |
|---|---|
| Receive | `FWCheckToken` — `0x64E0` |
| Send | `FWMinimalToken` (`0x64E1`) **or** `FWFullToken` (`0x64E2`) |

**Handler:** Always succeeds; no `FailToken` response case.

---

### Ping
Verifies TeensyROM connectivity and responsiveness. Useful as a lightweight heartbeat to detect device hang or disconnection without triggering state changes.

**Workflow:**
| Direction | Data |
|---|---|
| Receive | `PingToken` — `0x6455` |
| Send | `{strVersionNumber} ready!\n` (e.g., `"TeensyROM v0.7.2.8 ready!\n"`) |

**Handler:** Device responds immediately with version string and ready status; no separate `AckToken` response. A development build's version may end in `-<tag>` and/or `*` (see [Version Info](#version-info)).

---

### Post File
Posts a file to a target directory and storage type on TeensyROM. Automatically creates the target directory if missing.
 
**Workflow:**
| Direction | Data |
|---|---|
| Receive | `PostFileToken` — `0x64BB` |
| Send | `AckToken 0x64CC` |
| Receive | Length (4), Checksum (2), SD_nUSB (1), Destination Path (MaxNameLength, null-terminated) |
| Send | `AckToken 0x64CC` on pass, `FailToken 0x9B7F` on fail |
| Receive | File (Length bytes) |
| Send | `AckToken 0x64CC` on pass, `FailToken 0x9B7F` on fail |
 
**Note:** Once the Post File Token is received, all subsequent responses are 2 bytes in length.

**Note:** Checksum is a simple sum of all file bytes, masked to 16 bits (`sum & 0xFFFF`).

**Note:** The legacy `SendFileToken` (`0x64AA`) follows this identical workflow — the two tokens have converged and can be used interchangeably.

**Handler:** `PostFileCommand()`
 
---
 
### Get File
Retrieves a file from the specified directory and storage type on TeensyROM.
 
**Workflow:**
| Direction | Data |
|---|---|
| Receive | `GetFileToken` — `0x64B0` |
| Send | `AckToken 0x64CC` |
| Receive | SD_nUSB (1), Source Path (MaxNameLength, null-terminated) |
| Send | `AckToken 0x64CC` on successful check of storage availability, `FailToken 0x9B7F` on fail |
| — | TeensyROM reads the file from storage |
| Send | File Length (4), Checksum (4, but value is a 16-bit checksum sent zero-extended — upper 2 bytes always `0x0000`) |
| Send | File data, in chunks |
| Send | `AckToken 0x64CC` on successful completion, `FailToken 0x9B7F` on fail |
 
**Note:** Checksum is a simple sum of all file bytes, masked to 16 bits (`sum & 0xFFFF`).
 
**Handler:** `GetFileCommand()`

---

### Copy File
Copies a file from one folder to another in USB/SD storage. If a file with the same name already exists at the destination, it is overwritten.
 
**Workflow:**
| Direction | Data |
|---|---|
| Receive | `CopyFileToken` — `0x64FF` |
| Send | `AckToken 0x64CC` |
| Receive | Source Path (MaxNameLength, null-terminated), Destination Path (MaxNameLength, null-terminated) |
| Send | `AckToken 0x64CC` on pass, `FailToken 0x9B7F` on fail |
 
**Note:** Once the Copy File Token is received, all responses are 2 bytes in length.
 
**Handler:** `CopyFileCommand()`
 
---
 
### Delete File
Deletes a file from the specified storage device on TeensyROM.
 
**Workflow:**
| Direction | Data |
|---|---|
| Receive | `DeleteFileToken` — `0x64CF` |
| Send | `AckToken 0x64CC` |
| Receive | SD_nUSB (1), File Path (MaxNameLength, null-terminated) |
| Send | `AckToken 0x64CC` on pass, `FailToken 0x9B7F` on fail |
 
**Note:** Once the Delete File Token is received, all responses are 2 bytes in length.
 
**Handler:** `DeleteFileCommand()`
 
---

### List Directory
Lists directory contents on TeensyROM given a `skip`/`take` pair, to facilitate batch processing.
 
**Workflow:**
| Direction | Data |
|---|---|
| Receive | `GetDirectoryToken` — `0x64DD` **or** `GetDirNDJSONToken` — `0x64DE` |
| Send | `AckToken 0x64CC` |
| Receive | Storage Type (1), Skip (2), Take (2), Destination Path (MaxNameLength, null-terminated)<br>Storage types (`RegMenuTypes`): `USBDrive = 0`, `SD = 1`, `Teensy = 2` |
| Send | `AckToken 0x64CC` on successful check of directory existence, `FailToken 0x9B7F` on fail |
| Send | `StartDirectoryListToken 0x5A5A` or `FailToken 0x9B7F` |
| Send | Content written as JSON or NDJSON, depending on which token was used |
| Send | `EndDirectoryListToken 0xA5A5`, `FailToken 0x9B7F` on fail |
 
**Handler:** `GetDirectoryCommand(bool SetNDJSONformat)`
 
---
  
### Set Color Reference
Sets one of the colors in the TR UI. Color is stored in EEPROM and IO space; the TR menu must be reset for the change to take visual effect.
 
**Workflow:**
| Direction | Data |
|---|---|
| Receive | `SetColorToken` — `0x6422` |
| Receive | Color reference to set (range `0` to `NumColorRefs-1`, see enum `ColorRefOffsets`) |
| Receive | Color to set (range `0`–`15`, see enum `PokeColors`) |
| Send | `AckToken 0x64CC` or `FailToken 0x9B7F` |
 
**Handler:** `SetColorRef()`
 
---

### Set Real-Time Clock
Sets the TR's real-time clock. The time is UTC; the TR applies its time zone setting when it shows or passes on the time. On a TR+ with a battery, the clock keeps the time through power-off. The menu's clock shows the new time after its next reset.

**Workflow:**
| Direction | Data |
|---|---|
| Receive | `SetRTCToken` — `0x6474` |
| Receive | UTC time in seconds since 1970-01-01 (4 bytes, big endian) |
| Send | `AckToken 0x64CC` or `FailToken 0x9B7F` |

**Handler:** `SetRTC()`

---

### Pause SID
Pauses/Resumes SID playback by sending an interrupt request to the C64.

**Workflow:**
| Direction | Data |
|---|---|
| Receive | `PauseSIDToken` — `0x6466` |
| Send | `AckToken 0x64CC` on success, `FailToken 0x9B7F` on fail |

**Handler:** `RemotePauseSID()`

---
 
### Set SID Song
Sets the sub-song number of the currently loaded SID.
 
**Workflow:**
| Direction | Data |
|---|---|
| Receive | `SetSIDSongToken` — `0x6488` |
| Receive | Song number to set (1 byte, zero-based; song 1 = `0`) |
| Send | `AckToken 0x64CC` or `FailToken 0x9B7F` |
 
**Handler:** `SetSIDSong()`
 
---
 
### Set SID Playback Speed
Sets the SID playback speed of the currently loaded SID.
 
**Workflow:**
| Direction | Data |
|---|---|
| Receive | `SIDSpeedLinToken` — `0x6499` **or** `SIDSpeedLogToken` — `0x649A` |
| Receive | Playback rate (16-bit signed int, 2 bytes: Hi, Low)<br>• Linear range: `-68(*256)` to `<128(*256)` — argument is speed change percent from nominal<br>• Logarithmic range: `-127(*256)` to `99(*256)` — argument corresponds to percentage shown in "SID playback speed-log.txt" |
| Send | `AckToken 0x64CC` or `FailToken 0x9B7F` |
 
**Examples:**
- `0x64 0x99 0xF0 0x40` → set to −15.75% via linear equation
- `0x64 0x9A 0x20 0x40` → set to +32.25% via logarithmic equation

**Handler:** `RemoteSetSIDSpeed(bool LogConv)`
 
---
 
### Set SID Voice Mute
Sets individual SID voice muting.
 
**Workflow:**
| Direction | Data |
|---|---|
| Receive | `SIDVoiceMuteToken` — `0x6433` |
| Receive | Voice mute info (1 byte):<br>• bit 0 = Voice 1 (`0`=on, `1`=mute)<br>• bit 1 = Voice 2 (`0`=on, `1`=mute)<br>• bit 2 = Voice 3 (`0`=on, `1`=mute)<br>• bits 7:3 = zero |
| Send | `AckToken 0x64CC` or `FailToken 0x9B7F` |
 
**Handler:** `RemoteSetSIDVoiceMute()`
 
---

### C64 Pause / Resume
Pauses or resumes the C64 via DMA, halting/resuming CPU execution. 

**Workflow:**
| Direction | Data |
|---|---|
| Receive | `C64PauseOnToken` — `0x6431` **or** `C64PauseOffToken` — `0x6430` |
| Send | `AckToken 0x64CC` |

**Handler:** Always succeeds; no `FailToken` response case.

---

### Write C64 Memory (TR+ Only)
Writes a sequential C64 memory segment with supplied data.
 
**Workflow:**
| Direction | Data |
|---|---|
| Receive | `WriteC64MemToken` — `0x64FB` |
| Receive | C64 address (Hi, Low) |
| Receive | Data length (Hi, Low) |
| Receive | Data bytes (per Data Length) |
| — | TR+ performs DMA write |
| Send | `AckToken 0x64CC` on success, `FailToken 0x9B7F` on fail |
 
The data is staged in a buffer of its own, so a write never touches a running cartridge's ROM or REU emulation's memory. That buffer comes from the heap, which a large cartridge or REU emulation can have used up, and then the write is refused with `No memory to stage <n> bytes` and its data bytes are discarded. Write C64 Memory Spans and Read C64 Memory stage their data the same way, and are refused the same way, before any data is sent.

**Handler:** `WriteC64MemCommand()`
 
---

### Write C64 Memory Spans (TR+ Only)
Writes up to 64 C64 memory spans from one payload. Each DMA moves at most *slice bytes*, with the bus released and the 6510 running for *gap* µs between slices, so no single halt is longer than the C64's own code can absorb: a CIA timer that underflows twice inside one halt raises one NMI, not two. Both numbers are the sender's, because only it knows the C64 code it is writing to. Slices start promptly only while the C64 is writing to memory; a loop that only reads waits for a badline, or for 5,000 cycles with the screen blanked.

**Workflow:**
| Direction | Data |
|---|---|
| Receive | `WriteC64SpansToken` — `0x64FC` |
| Send | `AckToken 0x64CC` — send nothing more until it arrives; `FailToken 0x9B7F` and a line of text while the C64 is paused, and on earlier firmware while REU emulation is set up |
| Receive | Flags (`0`, or `0x01` = lock to a sample store), slice bytes (`0` = whole spans), gap in µs, span count (1–64): one byte each |
| Receive | Span count × { C64 address (Hi, Low), length (Hi, Low) } |
| Send | `AckToken 0x64CC` if the spans are accepted; `FailToken 0x9B7F` and a line of text if not |
| Receive | Data bytes for every span, in span order — send these only after the `AckToken` |
| — | TR+ performs the DMA writes |
| Send | `AckToken 0x64CC` once every span has landed; `FailToken 0x9B7F` and a line of text otherwise |

After a `FailToken`, the board goes on discarding what the sender still owes, up to the rest of the span list and payload, and stops once it has it all or a second passes with nothing arriving. Wait for that second of quiet before sending the next command, or the board may discard it too.

Firmware that predates this command answers the token with `Unk cmd: 0x64fc`, or with `Busy!` from the minimal image, rather than an `AckToken`, and would read anything sent after it as commands of its own. A sender that waits for the first `AckToken` stops there.

Spans are refused, before any payload is sent, if one is empty, runs past `$FFFF`, or touches `$DE00`–`$DFFF` (this cartridge's own IO), or if together they exceed 64 KiB or 1,024 slices. A slice that fails stops the job with the bus released, and the reply says how many bytes had landed.

**Choosing slice bytes and gap.** Two allowances, both measured on an NTSC C128 in C64 mode running v0.8.0.13 with the C64 loop writing to memory:
  * *Per-slice overhead.* A slice halts the 6510 for longer than its byte count. Fitting lost NMIs against slice size gives about 70–80 cycles per slice on top of its bytes, so size a slice about 100 bytes shorter than the interval it must fit inside. With a CIA2 NMI every 200 cycles and a 40 µs gap, a 4 KiB job lost 21 NMIs written whole, 8.2 at slice 200, 3.5 at slice 140, 0.5 at slice 100, and none at slice 32 or below.
  * *Minimum gap.* The gap is the C64's only time to run between slices, and its interrupt handler has to finish in it. Below about 20 µs, an NMI that arrives during a halt is still being serviced when the next slice starts. At slice 100 the same job lost 11–13 NMIs with gaps of 0–10 µs, 0.6 at 20 µs, and none at 100 µs.

Smaller slices and longer gaps make the job slower: that 4 KiB took 6.3 mS as one `WriteC64Mem`, 14.9 mS at slice 32 and 37 mS at slice 8, all with a 40 µs gap. A raster split rewriting screen and colour RAM (2 × 1,000 bytes) ran its IRQs up to 18 lines late against `WriteC64Mem`, and at most 1 line late at slice 32 / gap 40 µs.

**Locked to a sample store (flag `0x01`).** For a C64 playing samples from a timer NMI, the gap can be replaced by the player's own timing. With the flag set, the first span entry is `{ store address, 0 }` (the player's sample store, `$D418` for a `$D418` DAC) and is not written, and the gap byte becomes the longest wait for a store, in µs. Each slice then starts on the cycle after the C64 next writes that address, and runs and releases the bus from the interrupt handler, without the per-slice overhead above. Size the slice to the cycles the player leaves free between its store and the next timer underflow, and no halt ever covers an underflow. On an NTSC C64 with a 12 kHz NMI (85 cycles), a `$D418` player that stores 28 cycles after the underflow and needs 19 more cycles to return leaves 38 cycles: 33-byte slices lost no NMIs at any payload, against 5% of them for 1 KiB writes with `WriteC64Mem`, and carried 270–300 KiB/s for 1–2 KiB writes. A slice whose store has not come within the wait starts anyway, so a stopped player costs time, not a hung write.

The flag needs at least one span after the store entry, and the store entry's length must be `0`. The store is watched with the board's one bus snoop: if another user holds it (a cartridge's handler), the command is refused with `Bus snoop in use`. A user that takes the snoop while a job is running leaves the remaining slices to time out and start unlocked. Firmware without the flag refuses every flagged header with `Flags must be 0`. A sender can therefore probe with the header `01 00 00 00`: firmware with the flag refuses it for its span count (`Want 1 to 64 spans`), and firmware without it with `Flags must be 0`. Either way no span list or payload is owed.

**Handler:** `WriteC64SpansCommand()`
 
---
 
### Sample Watch (TR+ Only)
Counts the C64's writes to one address, timing each against the one before it, and reports the counts since the previous Sample Watch. Pointed at a sample player's store, it counts the samples a DMA halt cost the player at the source: with the store period *P* in ARM cycles, *interval cycles / P − intervals* is the number of stores that did not happen. Locked Write C64 Memory Spans slices start on the watched address.

**Workflow:**
| Direction | Data |
|---|---|
| Receive | `SampleWatchToken` — `0x64F9` |
| Receive | Mode (`0` = stop watching, `1` = watch), C64 address (Hi, Low) |
| Send | `AckToken 0x64CC`; `FailToken 0x9B7F` and a line of text if another user holds the bus snoop, the mode is not `0` or `1`, or the mode and address did not arrive |
| Send | Intervals (4), interval ARM cycles (8), longest interval in ARM cycles (4), locked slices (4), unlocked slices (4), ARM cycles per second (4): Low byte first, all since the previous Sample Watch |

Each call resets the counts. Watching again keeps the last store's time unless the address changes, so no interval is lost between two reads.

**Handler:** `SampleWatchCommand()`

---

### Snoop Tap (TR+ Only, `DbgSnoopTap` builds only)
Records the C64's bus cycles on chosen pages into a ring of the last 1,024 entries, and sends the ring to the host. It runs in `isrPHI2` after the bus snoop slot, so it keeps recording while Sample Watch holds the slot; a cycle a snoop handler claims (returns true for) is not recorded. A page flagged as a trigger and for writes freezes the ring 64 entries after its first write, so what led up to that write survives until the host takes it. Only images built with `DbgSnoopTap` defined in `TeensyROM.h` answer it. `tools/bench/snooptap.py` is its client.

**Workflow:**
| Direction | Data |
|---|---|
| Receive | `SnoopTapToken` — `0x64F8` |
| Receive | Mode: `0` = send the ring and keep recording, `1` = send the ring, then record the pages that follow, `2` = send the ring and stop |
| Receive | Mode `1` only: 256 bytes, one per page `$00`..`$FF`, each a sum of `1` writes, `2` reads, `4` trigger (only with `1`), `8` DMA slice marks; `0` leaves the page unrecorded |
| Send | `AckToken 0x64CC`; `FailToken 0x9B7F` and a line of text if the mode is not `0`, `1` or `2`, or the pages did not arrive |
| Send | ARM cycles per second (4), entries recorded (4), entries skipped while paused or frozen (4), page cycles seen (4), triggered (1), entries sent (2): Low byte first |
| Send | Each entry, oldest first: ARM cycle stamp (4), address (2), data (1, `0` for a read), info (1): Low byte first. Info bits `0x1F` are the DMA state (`enum DMA_States`), `0x20` a locked slice armed, `0x40` a read, `0x80` a slice mark, whose address and data are the slice's start and the low byte of its length |

Each call clears the trigger and the counts it sends; page cycles that arrive while it sends are counted, as skipped, in the next call's reply.

**Handler:** `SnoopTapCommand()`

---

### Read C64 Memory (TR+ Only)
Reads a sequential C64 memory segment and sends it to the host.
 
**Workflow:**
| Direction | Data |
|---|---|
| Receive | `ReadC64MemToken` — `0x64FD` |
| Receive | C64 address (Hi, Low) |
| Receive | Data length (Hi, Low) |
| — | TR+ performs DMA read |
| Send | `AckToken 0x64CC` on success, `FailToken 0x9B7F` on fail |
| Send | Data bytes (per Data Length) |
 
**Handler:** `ReadC64MemCommand()`
