SensoriumEmbedded/TeensyROM/docs/NFC_Loader.md

# TeensyROM NFC Loading system
The NFC loading system makes your TeensyROM enabled C64/128 into an NFC card instant launch machine! Here's a [video](https://www.youtube.com/watch?v=iNfQx2gx0hA) of it in action. 

## Table of contents
  * [NFC Loader Hardware](#nfc-loader-hardware)
    * [Electronics](#electronics)
    * [NFC Tag cards/media](#nfc-tag-cards-media)
    * [Card labels](#card-labels)
    * [Reader enclosure/case](#reader-enclosure-case)
  * [Tag programming](#tag-programming)
    * [Programming tag directly with the TeensyROM](#programming-tag-directly-with-the-teensyrom)
    * [Programming tag via cell phone (Alternate)](#programming-tag-via-cell-phone)
  * [TeensyROM Software setup](#teensyrom-software-setup)

## Thank you very much to:
* [**StatMat**](https://github.com/Stat-Mat) for sharing his vision and support for this project! 
  * TeensyROM and the [OneLoad64](https://www.youtube.com/watch?v=lz0CJbkplj0) project make a great pair!
* The [**Zaparoo Project**](https://github.com/ZaparooProject/zaparoo-core) for the genesis and inspiration for NFC launching capability.  
  * Happy to help make the C64 an officially supported platform! 

## NFC Loader Hardware

### Electronics
* The PN532 NFC Reader and the CH340 USB to serial UART interface are the two components needed to enable NFC loading.  They are available in discrete modules or in combination, here are some purchasing options:
  * Here's the [lowest priced combo module](https://www.aliexpress.us/item/3256806111642889.html) (PN532+CH340) we've found
  * You can also get them via [Amazon](https://www.amazon.com/Teyleten-Robot-Wireless-Module-Attenna/dp/B0DKTK9VS9)
  * Some other combo modules from [Aliexpress (Left)](https://www.aliexpress.us/item/3256806140123574.html) and [Elechouse (Right)](https://www.elechouse.com/product/pn532-nfc-usb-module/)
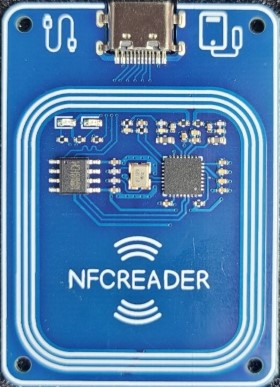
[picture p13: media/NFC/Ali_Combo.jpg]
Ali Combo
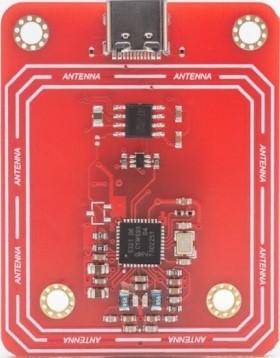
[picture p14: media/NFC/Elec_Combo.jpg]
Elec Combo
    ||| 
    |:--:|:--:|
  * Individual modules from Amazon (and elsewhere):
    * [NFC module (PN532)](https://www.amazon.com/gp/product/B01I1J17LC)
    * [USB/Serial adapter (CH340)](https://www.amazon.com/gp/product/B00LZV1G6K)
    * Connections to wire these two modules together: GND/GND, Vcc/5V, TxD/RxD, RxD/TxD
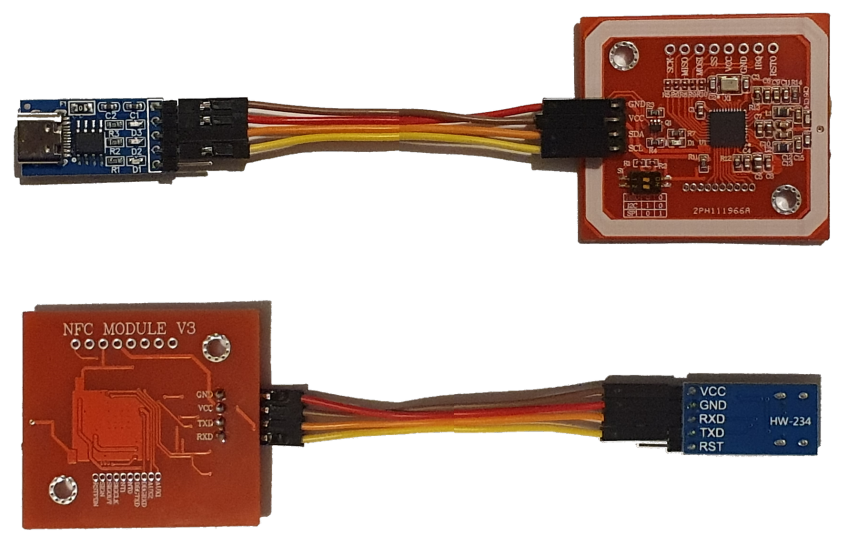
[picture p15: media/NFC/Discrete_Top_Bot.webp]
Discrete Modules
    * 

### NFC Tag cards/media
* 4 types of NFC tags are currently supported:
  * NTAG215 (Recommended and [widely available](https://www.amazon.com/dp/B074M9J5L3))
  * NTAG213 (171 characters max)
  * NTAG216
  * Mifare Classic 1k (often bundled with reader electronics purchase)

### Card labels
* Labels can be created using this [Zaparoo Label Generator](https://design.zaparoo.org/)
  * Choose the "HuCard (C64)" Card template
  * We recommend printing to glossy sticker sheets, then cut out individually for your tag cards.
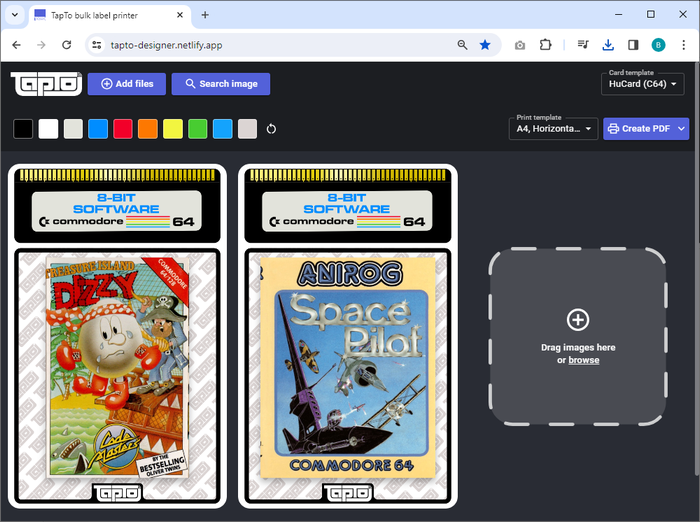
[picture p16: media/NFC/TapTo_Label_Designer.webp]
TapTo_Label_Designer
    * 

### Reader enclosure/case
* These 3D printable case designs by [Bedroom Ninja](https://makerworld.com/en/@RetroDojo) fit the theme perfectly!
  * [TapTo NFC-Engine](https://makerworld.com/en/models/1542524-nfc-engine-v2#profileId-1619125)
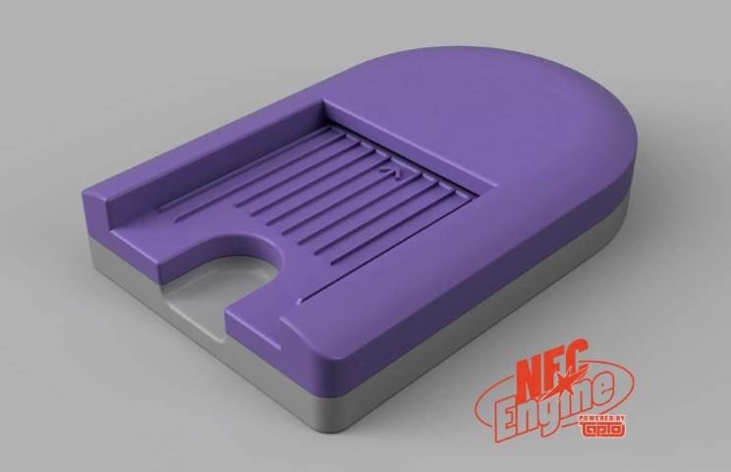
[picture p17: media/NFC/NFC_Engine.jpg]
NFCEngine
    * 
  * [TapTo NFC-1541](https://makerworld.com/en/models/1670375-nfc-1541-v2#profileId-1768362)
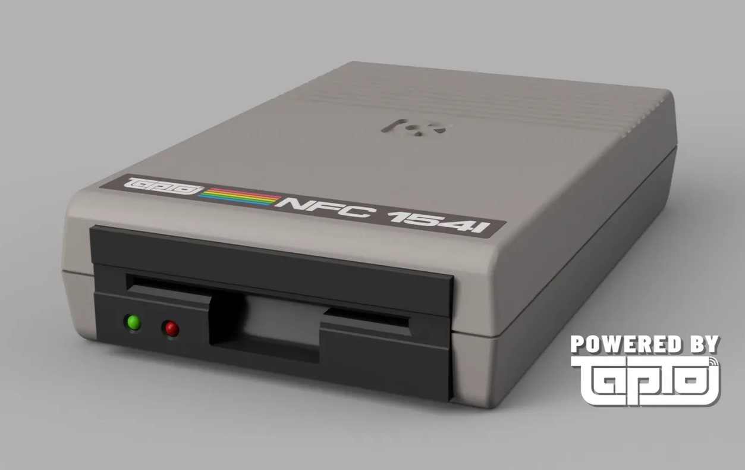
[picture p18: media/NFC/NFC_1541.jpg]
NFC-1541
    * 
* Since electronics modules vary in size, unique internal mounting methods may be needed. Tape or glue have been known to work. :)

## Tag programming
* Tags are programmed with a text field containing the path to a local file to be executed by the TeensyROM.
  * Text path format requirements:
    * The text can be one of these formats:
      * **path/filename** (defaults to SD)
      * **SD:path/filename** (SD card source)
      * **USB:path/filename** (USB drive source)
      * **TR:path/filename** (TeensyROM built-in source)
    * Example: **SD:OneLoad v5/Donkey Kong Junior.crt**
    * **filename** can be replaced by **?** to indicate a random file from the directory
    * Character limit is 246 chars (171 for NTAG213)

### Programming tag directly with the TeensyROM
  * Using the TeensyROM menu, navigate to the file on SD or USB that you would like to create a tag for
  * Press the `Left Arrow` key to select the file for tag writing.
    * Alternatively, press `?` to write an NFC Tag that will launch a random file from the currently selected Directory
    * We recommend using random with directories containing <100 items. Function must load full directory to pick one at random, so large directories will take longer to pick/launch from.  
  * Follow the on-screen instructions to load a tag and write to it.
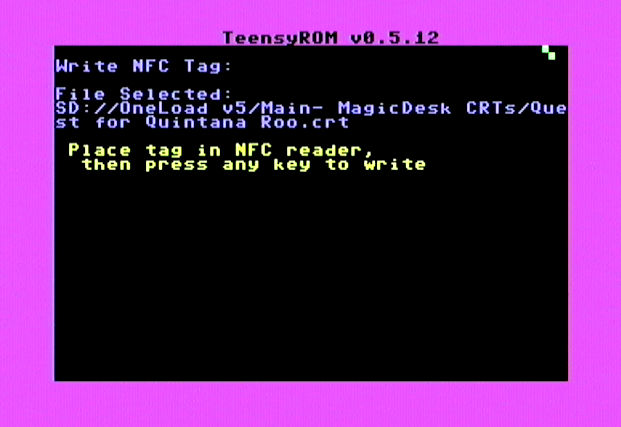
[picture p19: media/NFC/Write_Tag.jpg]
Write Tag Screen
  * 

### Programming tag via cell phone
  * (Alternate programming method)
  * Copy/type the paths you want to make tags from into a text file.
  * Send/e-mail the text file to your phone.
  * Use the (free) [NFC tools](https://www.wakdev.com/en/) application to write individual path/filename lines to tags.  It's available for [iPhone](https://itunes.apple.com/us/app/nfc-tools/id1252962749) or [Android](https://play.google.com/store/apps/details?id=com.wakdev.wdnfc)
    * Field requirements: One single NFC Record, Text Type, UTF-8, "Well Known" format  (default settings)
  * Here's a [demo video](https://youtu.be/YwQviLwWHYM?t=663) for tag writing via cell phone. It's made for a different system, but the tag writing process is the same.

## TeensyROM Software setup
* Be sure your TeensyROM is using Firmware version 0.7 or later for the latest NFC features
  * See update instructions [here](General_Usage.md#firmware-updates) if update is needed.
* Connect your NFC reader to the USB Host port of the TeensyROM.
  * Alternatively, a powered USB hub can be used.  This allows the NFC reader, USB Thumb drive, and MIDI device(s) to be connected simultaneously.
* Power up your C64/TeensyROM
* In the TeensyROM Main Menu, select **F8** to go to the Settings Menu, then **2** for Config: TeensyROM General
* Press `b` to cycle "USB Host Serial Dev" to "NFC"
  * We recommend also cycling "Special IO" (`a`/`A`) to "None" to avoid interference.
* A reboot is required for this to take effect. Either press `F1` to reboot TeensyROM, or power-cycle the C64.
* This setting stays persistent when the unit is powered down again.
  * We recommend disabling this option when the reader isn't connected to prevent slow start-up.
  * Automatically disabled while using Ethernet or MIDI applications due to increased latency.

<br>

[Back to main ReadMe](/README.md)
