SensoriumEmbedded/TeensyROM/vm/abi/README.md

# TeensyROM extension ABI

An **extension** is natively-compiled ARM code, shipped on the SD card, that
TeensyROM loads and runs on its own processor while the C64 handles display,
sound and input. The firmware in this repository is the **loader**: it finds
packages, validates them, reserves the memory, and carries bytes between the
module and its C64 client. It knows nothing about what any extension does.

A module runs under an extension host, and no firmware carries one. Install
the stock host before launching anything: `npm run build:tr-plus` writes it as
`build/firmware/TeensyROM+_<ver>_VMBoot.TRH`, and every CI run keeps one in its
`firmware` artifact. Copy it to the card and select it in the menu, or push it
over USB with `tools/bench/hostinstall.py`. Without one, a launch is refused
with `No extension host installed`.

This document is the whole contract. A module builds against three files from
this repository, all of them in [`vm/abi/`](.):

- [`vm_abi.h`](vm_abi.h) — the types and constants, a shim over
  [`VMABI.h`](../../Source/Teensy/MinimalBoot/Common/VMABI.h), which is the
  header the firmware itself compiles and so the one that cannot drift from it.
- [`module.ld`](module.ld) — the linker script. It places `.entry` first, sets
  `ENTRY(vm_entry)`, and fixes the code and data windows to the addresses the
  loader validates, so an image linked without it is refused rather than
  mislinked.
- [`module128.ld`](module128.ld) — the same script for the 128 KiB code
  window. Use it only if your module needs the space: it links at `0x10000`,
  which a host whose own code reaches past there will refuse.
- [`vm_runtime.c`](vm_runtime.c) — weak `memset`, `memcpy`, `memmove`,
  `memcmp`, `strlen` and `strcmp`. A freestanding module has no libc, and GCC
  emits calls to these on its own for code that never names them — zeroing a
  struct is a `memset`. Define your own to override any of them.

Nothing else from this repository is needed, and nothing outside it is.

> **Status.** The formats and the base profile described here are frozen; the
> version marker is `VM_ABI = 2`. The launch path, the module loader and the
> client link have run on a TeensyROM+ with the reference extension: it appears
> on the C64 screen. [§10](#10-what-has-run-on-hardware) says exactly which parts
> that covers and which it does not. The rest is verified on a development
> machine by `npm run verify:extensions`, which builds real packages and reads
> them back with the firmware's own parsers.

## 1. The base profile, and why the loader stops there

`VmHost` is the table of services the loader lends a module. It grows only at
its tail, and `host->bytes` says how far this host's copy actually runs. The
loader implements the first 76 bytes of it — files, clock, packets, write and
guest RAM — plus one 4-byte tail, the module exit (see "Tail extensions"
below), and stops.

A module asks for exactly what it needs and gets a straight answer:

```c
if (!h || h->abi != VM_ABI || h->bytes < VM_HOST_BASE_BYTES) return nullptr;
```

Check `bytes >= VM_HOST_BASE_BYTES`, never `bytes == sizeof(VmHost)`. That one
line is what lets a single module binary run on this loader *and* on a host that
has appended callbacks of its own.

The loader stops here so that extensions can move independently of TeensyROM
releases. If a capability lives in the loader, adding to it means a firmware
release; if it lives behind a service bit, it does not.

## 2. Asking for more than the base

A module declares what it requires in its image header, in `required_services`.
The loader compares that against what it provides and **refuses the image
outright** if anything is missing. It never loads a module with a requested
service quietly absent.

That refusal is the negotiation. Build a capability behind its own bit, and on a
host that lacks it, fall back and retry without it. One binary, two hosts.

### The registry

Bits are handed out one host at a time, so two hosts can add callbacks without
ever meaning different things by the same number. An assignment binds the
number for good. It says nothing about who implements it.

| Bit | Name | Assigned to | This loader |
|----:|---|---|---|
| 1 | `VM_SERVICE_FILES` | base profile | yes |
| 2 | `VM_SERVICE_CLOCK` | base profile | yes |
| 4 | `VM_SERVICE_PACKETS` | base profile | yes |
| 8 | `VM_SERVICE_WRITE` | base profile | yes |
| 16 | `VM_SERVICE_GUEST_RAM` | base profile | yes |
| 128 | `VM_SERVICE_RAM2_RO` | this loader | yes (memory profile 1) |
| 32, 64, 256 .. 8192 | — | reserved, out of tree | no |
| 16384 | `VM_SERVICE_EXIT` | this loader | yes |
| 32768 | — | unassigned, on request | no |
| 65536 | examples and conformance | this repository | no |
| 1<<17 .. 1<<19 | — | unassigned | no |
| 1<<20 | `VM_SERVICE_C64_DMA` | this loader | yes, on a TR+ |
| 1<<21 .. 1<<31 | — | unassigned | no |

To claim a bit, open an issue naming the host and the callback it adds.

An image requiring a bit this loader does not provide is **well formed**. The
validator judges structure only; the refusal comes from a host, and names the
bit — `TeensyROM host lacks service $10000`, not "failed validation". A host
installed before it published a descriptor cannot be asked in advance, so it
refuses after the reboot instead, as a `$20` record with detail `$11`
(see [§7](#7-when-a-launch-fails)).

So `tools/build-extension.mjs --services <mask>` will package a module asking
for someone else's bit. It refuses only an *unassigned* number, which
`--allow-unassigned-services` overrides while a claim is pending.

Two rules keep that promise workable:

1. **`VmHost` only ever grows at the tail.** Never insert, never reorder.
2. **Capability, then fallback.** If a host rejects a bit, retry without it.

### Tail extensions

A bit that adds a callback adds it past the end of `VmHost`, in a struct whose
first member *is* a `VmHost`. `VM_SERVICE_EXIT` is the first one:

```c
struct VmHostExit {
    VmHost base;
    void (*exit_to_menu)(uint32_t status);   // does not return
};
```

The entry point is still handed a `VmHost *`. A module that asked for the bit
casts up to reach the tail, and checks **both** halves before it does:

```c
if (host->bytes >= VM_HOST_EXIT_BYTES && (host->services & VM_SERVICE_EXIT))
    ((const VmHostExit *)host)->exit_to_menu(0);
```

Both, because the two are independent: a host may grow its struct for one bit
while lending none of the others, and a host may publish a bit it implements
through some other means. `bytes` says how far the struct can be read; the
service bit says whether the callback behind it is yours to call.

Requiring the bit means the loader refuses the image outright where it is
absent, so the check above cannot fail on this loader — it is written for the
module that treats exit as optional and falls back to running until reset.

The tail is a chain, not a set of alternatives. The *second* extension composes
on `VmHostExit` — `struct VmHostNext { VmHostExit base; ... }` — and not on a
bare `VmHost`, which would put its callback at offset 76, the offset
`exit_to_menu` already occupies. Two extensions written that way cannot both
exist in one host, and a module that checked `bytes` would be told the pointer
was long enough to read the wrong function. Each new tail extends the longest
one there is, and `VM_HOST_*_BYTES` grows with it.

### The C64 transfer tail

Bit 20 is the second, on `VmHostExit`. It writes module memory into C64 RAM by
taking the bus, which only a TR+ can do:

```c
struct VmC64Span { const uint8_t *source; uint16_t address, bytes; };
struct VmHostC64Dma {
    VmHostExit base;
    uint32_t (*c64_write)(const VmC64Span *spans, uint32_t count,
                          uint32_t slice_bytes, uint32_t flags);
    int32_t (*c64_status)(uint32_t ticket);
};
```

`c64_write` starts a job and answers its ticket, or `0` when it refuses the job
whole; the conditions are in `VMABI.h`, and a refused job writes nothing and
leaves the last ticket as it was. One job runs at a time. `c64_status` answers
`VM_C64_PENDING` until it ends, then `VM_C64_DONE`, `VM_C64_NO_GRANT` or
`VM_C64_BUS_FAILED`. The job runs in the
host's own turn, between `pump` calls, so a module polls the ticket from
`pump` and leaves the sources alone until it ends.

**The client grants every slice.** A slice starts as the client's write to
`$DFF0` completes, and holds the CPU off the bus for about `slice_bytes`
cycles, plus any the VIC takes. Nothing else starts one, so a transfer lands
where the client chose to let it: a client that counts timer interrupts, for
instance, grants from the handler a slice shorter than the time left to the
next interrupt, and loses none.

Grant as the handler's last act before its `RTI`. An interrupt that comes due
during a slice is taken when the instruction under way ends, so after a grant
followed by anything else it is taken inside the handler, and a handler
interrupted that way every time nests deeper until the stack wraps and the C64
crashes. And grant only a slice that ends before the next interrupt comes due,
or that interrupt is late, and several merge into one under a slice longer than
their period; a client that counts timer ticks can read the timer to decide.

For a client granting from a CIA timer's interrupt, size the slice to what is
left of the period when the handler reaches its grant:

```
slice_bytes <= (latch + 1) - cycles from the underflow to the grant - margin
```

`latch + 1` is the timer's period. The cycles to the grant are the handler's
own, up to the grant's write, plus one for the CIA to raise the interrupt, what
is left of the instruction it arrives in, the 7 the 6510 takes to enter it, and
the KERNAL's 7-cycle NMI entry for a client that goes through it. The margin is
for what the VIC steals during the slice: about 40 cycles for each badline it
crosses with the screen on, and up to about 19 more on every line with eight
sprites showing. Too small a margin makes the next interrupt late, and too small
by more than a period loses it. These are all counts of cycles, so one size
serves PAL and NTSC, except that a long slice crosses badlines at each
standard's own line length. Recompute the size whenever the latch changes. The
bench client in `tools/bench/grants` reaches its grant 55 to 60 cycles after the
underflow and keeps no margin for the VIC: in a 200-cycle period its check
passes slices of 140 bytes and never 150, so a badline under a slice can make
the next tick late, though its runs lost none.

A slice waits for its grant only during the host's turns for the job, which
alternate with the module's own; a grant in between starts nothing, and the
client grants again next time. How many grants land depends on how long the
module's turns are: a module that yields when `should_yield` says to leaves a
slice armed about half the time, and one that overruns its turn leaves it
armed less. A grant at a fixed rate can also fall into step with the turns and
then land rarely, or, in exact step, never, so a client should not grant only
at one fixed point in its frame. A slice that has waited `VM_C64_GRANT_MS` of
those turns without landing ends the job with `VM_C64_NO_GRANT`, whether the
client granted nothing or only between turns: it is refused, not hung. Nothing
else times a job.

A slice writes wherever the C64's memory map puts its addresses at the moment
of the grant — RAM under the BASIC and KERNAL ROMs, for instance, lands in RAM
the C64 cannot read until it banks the ROM out. `$DE00..$DFFF`, the cartridge's
own registers, is refused. The bus is timed for the machine: the extension image
times PAL/NTSC from PHI2 itself and follows a change, and takes C64/C128 from the
menu's report, which every launch now waits for. A launch made before the menu has
run, such as an autolaunch at power-up, goes through the menu first.

Memory profile `2` is likewise reserved and refused; profiles `0` and `1` load.
Profile `0` lends all 512 KiB of RAM2; profile `1` keeps 80 KiB of that as
write-protected constants loaded from the image and holds back the reserved top
16 KiB, leaving 416 KiB.

## 3. The package

A package is a directory on the SD card holding exactly three files:

```
/VMS/<id>/manifest.vmi     six ASCII lines
/VMS/<id>/engine.mvm       the module image
/VMS/<id>/client.crt       the C64 client cartridge
```

`<id>` is 1–23 characters of `A–Z a–z 0–9 _ - .` and must match line 2 of the
manifest. The loader scans at most **32** directories under `/VMS`; more than
that, or two packages claiming the same extension, refuses the launch rather
than guessing. A shared extension refuses only files of that extension, and the
refusal names both packages, or how many there are and two of them.

### manifest.vmi

Six newline-terminated lines, nothing else:

```
VM1
HELLO
hi
engine.mvm
client.crt
END
```

Line 3 is a comma-separated list of file extensions this package claims, at most
**31 characters in total** (`a26,a52,a78` fits), each extension at most 7
characters and none listed twice (case is ignored, so `gb,GB` is refused).
Extensions the stock menu owns are
refused: `prg crt hex p00 sid kla koa ocp pic art aas hpi txt nfo md seq d64 d71
d81 reu trh`.

The launch record carries the manifest's CRC, and the host recomputes it, so a
package edited between the launch and the reboot is refused (`$13`). It is the
CRC32 of the file's bytes exactly as read, line endings included; a file holding
a NUL byte is malformed.

### engine.mvm — the MVM1 image

A 64-byte little-endian header, then `.text`, then `.data`, then (profile 1
only) the RAM2 constants. `.bss` is not stored; the loader zeroes it.

| Offset | Field | Notes |
|---:|---|---|
| 0 | `magic` | `0x314d564d` (`MVM1`) |
| 4 | `abi` | 2 |
| 8 | `header_bytes` | 64 |
| 12 | `code_bytes` | ≤ `0x30000 - code_base`: 96 KiB, or 128 KiB at the lower base |
| 16 | `data_bytes` | |
| 20 | `bss_bytes` | `data_bytes + bss_bytes` ≤ 192 KiB |
| 24 | `entry` | Thumb bit set; inside the code window |
| 28 | `code_base` | `0x00018000`, or `0x00010000` on a host whose code ends there |
| 32 | `ram_base` | `0x20014000` |
| 36 | `required_services` | see §2 |
| 40 | `payload_crc` | CRC32 of everything after the header |
| 44 | `header_crc` | CRC32 of the header with this field zeroed |
| 48 | `reserved[0]` | memory profile |
| 52 | `reserved[1]` | RAM2 constant bytes (profile 1, 1..80 KiB) |
| 56 | `reserved[2..3]` | zero |

CRC32 throughout is the reflected `0xedb88320` polynomial.

### client.crt — the C64 client

An ordinary 16 KiB EasyFlash cartridge (`.crt` type 32) with a third CHIP
appended. **Exactly `0x6070` bytes**; any other size is refused.

| Offset | Contents |
|---:|---|
| `0x0000` | 64-byte CRT header, `C64 CARTRIDGE `, type 32 |
| `0x0040` | CHIP header — bank 0, `$8000`, 8192 bytes |
| `0x0050` | LOROM bank, 8192 bytes |
| `0x2050` | CHIP header — bank 0, `$A000`, 8192 bytes |
| `0x2060` | HIROM bank, 8192 bytes |
| `0x4060` | CHIP header — bank 1, `$8000`, 8192 bytes |
| `0x4070` | **128-byte `VMH1` descriptor** |
| `0x40F0` | padding to `0x6070` |

The descriptor:

| Offset | Field |
|---:|---|
| 0 | `VMH1` |
| 4 | ABI (2) |
| 8 | CRC32 of the two 8 KiB banks, concatenated |
| 16 | package id, NUL terminated, within 24 bytes |
| 124 | CRC32 of the preceding 124 bytes |

The descriptor is how a `.crt` on the card is recognised as a client rather than
an ordinary cartridge. A cartridge without a valid `VMH1` at `0x4070` is parsed
by the stock cartridge path exactly as before, whatever its size.

Build all three with [`tools/lib/extension.mjs`](../../tools/lib/extension.mjs)
rather than by hand; it enforces at write time every rule above that the bytes
can show. That a module was linked for the code base its header names shows only
in the ELF, which [`tools/build-extension.mjs`](../../tools/build-extension.mjs)
checks.

## 4. Launching

The menu calls `VmLaunch::tryFile` for each SD selection. It returns `false` —
meaning "not mine, carry on" — for every source that is not the SD card, every
path inside a mounted disk image, and every extension the stock menu owns. Only
then does it look at the card.

A launch begins in one of two ways:

- the user picks a **client cartridge**, identified by its `VMH1` descriptor; or
- the user picks a **content file** whose extension a manifest claims, in which
  case its full path, with a single `/` before each component, is handed to the
  module as `content_path`.

Which extensions are claimed is answered from a table the firmware rebuilds when
it loads an SD listing, so a package copied onto the card while a listing is
already on screen is picked up on the next listing. Over the 32-package limit, or
on a read error, the table stands aside and the launch path scans `/VMS` itself,
which refuses on screen rather than silently handing the file to the stock menu.

Then:

1. `preflight` re-validates the module image and the client cartridge in full,
   including both CRCs. A failure reports on screen and does **not** reboot.
2. The installed extension image is read out of its flash slot. An empty slot,
   a host that speaks another ABI, a host missing a bit the module asked for in
   `required_services`, and a host whose code floor lies above the module's code
   base each report on screen and do **not** reboot. A host
   built before that descriptor existed cannot say what it provides, so its
   launch proceeds and the refusal happens after the reboot as it always did.
3. A `launch.vml` record is written to `/VMS` and read back to confirm.
4. A one-shot EEPROM flag is set and the machine resets.
5. The boot image sees the flag and jumps to the extension image, which reserves
   the module's memory before anything else claims it.
6. The extension image loads the client cartridge into RAM as EasyFlash banks,
   loads the module, and calls its entry point.

The extension image lives in its own flash slot at `0x60760000..0x607c0000`, at
the top of flash just below the EEPROM emulation, so the main and minimal
firmware images keep their own addresses and a firmware update leaves the
installed host in place.

## 5. The runtime

### Memory

| Region | Address | Size | Owner |
|---|---|-----:|---|
| ITCM | `0x00000000` | 64 or 96 KiB | host code, bounded at link by `__exidx_end` |
| ITCM | `0x00010000` | 32 KiB | **module code** when the host stops below it, else host code |
| ITCM | `0x00018000` | 96 KiB | **module code** |
| DTCM | below `0x20014000` | — | host state and heap |
| DTCM | `0x20014000` | 192 KiB | **module `.data`, `.bss`, then workspace** |
| DTCM | `0x20044000` | 48 KiB | shared stack |
| RAM2 | `0x20200000` | 512 KiB | **guest arena** (416 KiB on profile 1) |
| RAM2 | `0x2027ff60` | 160 bytes | loader record + Teensy's `CrashReport` (inside the profile-0 arena) |

`workspace` is whatever is left of the 192 KiB DTCM window after the module's
own `.data` and `.bss`, aligned up to 32 bytes. Size it by shrinking your static
footprint, not by asking for more.

On profile 0 the arena is the whole of RAM2, including the 160 bytes at the top
that hold the loader's failure record and Teensy's own `CrashReport`. The loader
stamps its record before calling `vm_entry`, and writes it again only to record
a refusal — at which point your module is no longer running. The core writes
`CrashReport` from the fault handler. Overwriting either structure costs you
only that diagnostic: both are CRC-gated on read, so a scribbled one reads back
as absent rather than as a bogus report.

Profile 1 cannot lend that span: its constants are write-protected in 16 KiB MPU
subregions, and protecting the topmost one would fault the core's crash writer,
so it holds the 16 KiB back. Take the size from `host->guest_ram_bytes`, never
from the physical end of RAM2.

While a module is being loaded the host makes its code window writable and
non-executable, then restores it to read-only and executable before the entry
point is called. Modules are trusted local code — this is a guard against
mistakes, not a security boundary.

### Entry point

```c
VM_MODULE_ENTRY const VmModule *vm_entry(const VmHost *host);
```

Exactly one per module, placed in `.entry` by the `VM_MODULE_ENTRY` macro and
linked first by [`module.ld`](module.ld). Return a pointer to a `VmModule`
living in the module's code window, or `nullptr` to refuse the host. Declare
the table `const`, which puts it in `.rodata` and so in `.text`; a mutable one
lands in DTCM and the loader refuses it with `$14`. The loader re-validates
every pointer in the returned table before it calls any of them.

### The four callbacks

| Callback | Called when |
|---|---|
| `input` | the client has sent an input record |
| `pump`  | once per scheduler turn, to advance your work in a bounded slice |
| `packet`| to collect the next packet, or `false` for "nothing to say" |
| `ack` | the client has acknowledged the published packet |

The loop is: `input` if any, then `pump`, then `packet`. A published packet is
**frozen** until `ack` — `pump` may keep running but must not alter it, and
`packet` will not be called again for a new one. Returning `false` from `packet`
is normal and costs nothing; do not invent filler packets to keep the link busy.

Call `host->should_yield()` inside long work and return promptly when it is
true. Nothing preempts you: a module that does not yield makes the machine
unresponsive.

### Packets

```c
struct VmPacket { uint8_t type, flags, length, reserved; uint8_t payload[228]; };
```

`type` must be non-zero, `length` at most 228, `reserved` zero. **The host never
looks inside `payload`.** It frames the packet, hands it to the client, and
tells you when the client acknowledged it. What the bytes mean is entirely
between a module and its own client, so a new protocol needs no firmware change.

[`../hello/hello.cpp`](../hello/hello.cpp) defines a two-field text protocol in
about ten lines, which is the intended pattern rather than a shortcut.

## 6. The C64 client

The client is a 16 KiB EasyFlash cartridge that TeensyROM presents to the
machine like any other. Everything a client needs is in the IO2 window at
`$DF00`. Selecting **EasyFlash bank 58** (`$DE00` = 58) is what opens it; the
firmware maps every bank to the same 16 KiB, so the write is a signal, not a
bank switch. Until then the window is an ordinary EasyFlash register area.

| Address | Direction | Meaning |
|---:|:---:|---|
| `$DF00..$DFEF` | read | the published packet |
| `$DFF0` | write | grant: start the C64 transfer slice now waiting (bit 20) |
| `$DFF4` | write | command: `1` run, `3` input ready, `4` quiet |
| `$DFF5` | read | status: `2` running, `$12` quiet, `$E0` failed |
| `$DFF6` | write | acknowledge: the sequence number you consumed |
| `$DFF7` | read | sequence of the packet now published, `0` for none |
| `$DFF8..$DFFA` | write | input: buttons, display, overflow |
| `$DFFB` | read | failure code, when status is `$E0` |
| `$DFFD..$DFFF` | write | input: protocol, token, checksum |

**Start.** After the cold start, select bank 58 and write `1` to `$DFF4`. The
module does not run until it sees that. Poll `$DFF5`: `$E0` means the host or the
module failed and `$DFFB` says why; the reference client prints
`extension failed` and stops.

`1` means *run*, and writing it is idempotent: before the start it starts the
module, while the module is quiet it resumes it, and while the module is already
running it does nothing. Write `1` whenever you want the module running, without
tracking which of the three states the host is in.

**Reading a packet.** When `$DFF7` is non-zero and differs from the last sequence
you consumed, copy the window, then validate the copy — the window is live, and
checking bytes that can change underneath you proves nothing. The frame is:

```
$DF00  'M' '3'   magic
$DF02  01        framing version
$DF03  type      module-defined, never 0
$DF04  sequence  1..255, wraps 255 -> 1
$DF05  flags     module-defined
$DF06  length    0..228
$DF07  00        reserved
$DF08  payload   length bytes
       crc16     little-endian, over everything above it
```

The CRC is CRC-16/CCITT-FALSE: polynomial `0x1021`, initial value `0xFFFF`, no
reflection, no final XOR. After consuming a valid packet, write its sequence to
`$DFF6`. Until you do, the module holds that packet and asks for no other. A bad
frame is simply not acknowledged. Unknown types should be acknowledged and
ignored, so a module can add one without breaking older clients.

**Going quiet.** Write `4` to `$DFF4` to stop the module running; `$DFF5` reads
`$12` while it is stopped. Acknowledging the outstanding packet lifts it, and so
does writing `1`, which is the only way back if nothing was outstanding when you
asked.

**Sending input.** Build the whole record first, then raise the command: put the
values in `$DFF8..$DFFA` and `$DFFD`, a token in `$DFFE`, the checksum in
`$DFFF`, and write `3` to `$DFF4`. The checksum is `$A5` XOR each of `$DFF8`,
`$DFF9`, `$DFFA`, `$DFFD`, `$DFFE`. The token must be non-zero and differ from
the last one, or the host ignores the record. What the four bytes mean is
between a module and its client.

**The cartridge starts in Ultimax.** The firmware presents every client with
`GAME` asserted and `EXROM` deasserted, as its EasyFlash emulation does, so
your ROMH bank answers at `$E000` and its reset vector at `$FFFC` is the entry
point. A client normally wants to run as a 16 KiB cartridge instead. Switch by
writing `$87` to `$DE02` — but the switch takes effect at once, ROMH leaves
`$E000` and the KERNAL appears there, so **the next instruction cannot be
fetched from your stub**. Copy the last three instructions
(`lda #$87 / sta $DE02 / jmp $FCE2`) to RAM and run them there. This is how
EasyFlash's own startup code does it, and forgetting it leaves the C64 running
KERNAL code from the middle of a routine with a freshly reset stack: no screen
clear, no message. `Source/C64/VMHello/vmhello.a` is a working example.

## 7. When a launch fails

The extension image has no working USB, so it cannot explain itself. Instead it
leaves a 32-byte record at `0x2027ff60` and resets; the main image collects it
before anything can overwrite it and the menu prints it once the C64 is waiting
to read messages. If three attempts go unread — the C64 is not in a wait loop
and each one times out — the record is dropped and the reason is left on the
Teensy's USB serial only.

A successful hand-off is recorded too, as `$00`, so a client that then fails to
draw is distinguishable from a host that never started. `$00` is stamped just
before the entry point is called, because on profile 0 that address is inside
the arena the module is about to own — which means `$00` also covers an entry
point that faulted or never returned. A fault is separated back out by the
core's `CrashReport`: an image that comes back up holding one rewrites a `$00`
record as `$03`. That rewrite is the minimal image's job because minimal is
where the reset lands, and it reads only the report's validity — printing a
report is what clears it, so the main image does the printing, at the end of
`setup()`, after USB has had time to enumerate. An entry point that hangs
writes no report, so it stays `$00` and stays silent.

| Code | Meaning |
|-----:|---|
| `$00` | handed off to the client, or `vm_entry` never returned |
| `$01` | minimal jumped to the extension image and it did not start |
| `$02` | the top flash slot holds no valid image |
| `$03` | `$00` rewritten because the core reported a fault: the entry point crashed |
| `$04` | the module called `exit_to_menu` (detail: its argument) |
| `$10` | SD card would not initialise (detail: attempts) |
| `$11` | `launch.vml` missing, short or corrupt |
| `$12` | manifest unreadable or malformed |
| `$13` | manifest changed since preflight |
| `$14` | client cartridge would not open |
| `$15` | not a 16 KiB C64 EasyFlash cartridge |
| `$16` | CHIP header or bank payload bad (detail: bank) |
| `$17` | third CHIP is not a valid `VMH1` descriptor |
| `$18` | client banks do not match the descriptor CRC |
| `$20` | module image refused (detail: the host's failure code) |
| `$30` | host written and verified (detail: payload bytes) |
| `$31` | package read failed mid-write (detail: offset) |
| `$32` | a slot sector would not erase (detail: sector) |
| `$33` | the slot did not read back as written (detail: CRC) |
| `$34` | a page would not program (detail: offset) |
| `$3f` | install refused for a reason the codes above do not name |
| `$40` | the slot no longer reads as a host: removed (detail: 0, or `VmInstallStatus` if part of the erase failed) |
| `$41` | the tag would not clear (detail: `VmInstallStatus`) |

The record is how installing and removing a host report as well, not just
launching one. Both rewrite flash from the main image and reboot to do it, so
neither can print its own outcome; `$30`..`$41` are what the board says on the
way back up. `$40` is a question about the slot rather than about the erase —
the tag is cleared before any sector goes, so a sector erase that fails still
leaves a slot that is no longer a host, and the board reports what the next boot
will find rather than what the last operation returned. Removal erases the whole
slot, not only the tag: firmware without the extension loader does not reserve
the slot, and sizes its update buffer from the top of flash down to the first
programmed byte, so a payload left there would stop it updating itself. For
the same reason removal runs for any slot that is not blank, not only for one
holding a host: an install that failed part way leaves bytes that are no host,
and clearing them reports `$40` like any other removal.

The failure code a client reads from `$DFFB` is separate, and is the same value
the record carries as its detail for `$20`: `$11` the image would not open, has
a bad header, requires a service this host does not provide, or links its code
below this host's code floor; `$14` the
returned `VmModule` table failed validation; `$15` the module published a
malformed packet; `$16` the module reported an error without giving a code.
Other values come from the image loader's own bounds and CRC checks.

## 8. Building a module

The packager does the whole job — compile, link, measure, package:

```
node tools/build-extension.mjs --id HELLO --extensions hi \
     --source vm/hello/hello.cpp --client build/c64/vmhello.bin
```

It reports the code, data and bss it measured and how much workspace is left,
and reads its own output back through the firmware's validation before writing
it. It finds the ARM toolchain from `--toolchain`, then `PATH`, then the Teensy
core's own bundled copy — the same compiler the firmware is built with.

`--code-kib 128` builds against the larger window instead, linking with
`module128.ld` and reporting the base it used. The default is 96.

Building by hand, if you need to:

```
arm-none-eabi-g++ -std=c++17 -Os -mcpu=cortex-m7 -mthumb \
    -mfloat-abi=hard -mfpu=fpv5-d16 \
    -ffreestanding -fno-exceptions -fno-rtti -fno-threadsafe-statics \
    -ffunction-sections -fdata-sections \
    -c hello.cpp -o hello.o
arm-none-eabi-g++ -nostdlib -Wl,--gc-sections -T vm/abi/module.ld \
    hello.o vm_runtime.o -o hello.elf
```

Swap in `vm/abi/module128.ld` for the 128 KiB window.

The float ABI must match: Cortex-M7 with the double-precision FPU. A module
built for a different one links cleanly and then faults on target.

Each script asserts its own code limit and the 192 KiB data limit at link time,
so an overflow is a linker error rather than a boot failure. `module128.ld` is
the same script opening 128 KiB at `0x10000` instead of 96 KiB at `0x18000`;
`--code-kib 128` is how the packager chooses it. Prefer the default unless the
module needs the room, because the wider window is the one a host can refuse.

There is no libc, no heap and no static constructors. Keep state in `.data` and
`.bss` and initialise it in `vm_entry`.

One wrinkle worth knowing: GCC emits calls to `memset` and `memcpy` from
ordinary C++ that never mentions them — zeroing a struct is enough — and there
is no libc to resolve them against. [`vm_runtime.c`](vm_runtime.c) supplies
those and a few neighbours as **weak** definitions, and the packager links it
into every module. Define your own if you want a faster one; yours wins with no
build changes.

The packager prints the code, data and bss it measured and the workspace left,
so `npm run build:hello` is the reference figure for `vm/hello`.

## 9. Testing without hardware

[`../tests/native_host.h`](../tests/native_host.h) is a complete base-profile
host over the real filesystem — same 24-handle limit, same path validation, same
refusals as the target. Compile your module for the development machine and run
it against that host to debug it, then cross-compile the identical source.

`npm run verify:extensions` runs the whole loader suite this way in a few
seconds: the published headers built with no path back into this repository,
package format, file services, image validation, registry and preflight,
menu-hook fall-through, loaded-listing invalidation, the packet scheduler,
failure reporting, host-package installation under power loss, and the
reference module end to end.

A pass there says the formats and the contract hold. It says nothing about
timing, the bus, or the C64 side — that needs the hardware.

## 10. What has run on hardware

On a TeensyROM+ with the reference extension, from the SD card through to the
C64 screen:

Strings quoted below are the bytes the firmware formats, and they are also what
the screen shows -- quote and capture compare directly. Two stages swap letter
case and cancel: the firmware converts ASCII to PETSCII as the C64 reads each
byte out of `rwRegSerialString` (`ToPETSCII`, `IOH_TeensyROM.c:675`, table at
`:107` -- `'A'` goes to 97 and `'a'` to 65), and CHROUT (`SendChar` = `$ffd2`)
stores the screen code for that PETSCII byte in the charset the menu selects
(`$d018` = `$17`, `MainMenu.asm`'s `TextScreenMemColor`), where the unshifted
letters read lower case. Run the pair and `TeensyROM  ABI 2  services $10409f` is
on the screen as `TeensyROM  ABI 2  services $10409f`; a dump through
`tools/bench/c64.py`'s `petscii_row` reads it the same way. Leave either stage
out of the model and it comes out `tEENSYrom  abi 2  SERVICES $10409F`, which is
the shape to distrust: it means one half of the pair was missed. Nothing tests
this round trip, so check it against the source rather than against a previous
reading of this paragraph. Matching case-folded, as `hostops.Outcome.said` does,
still costs nothing and covers a launched program that has switched charset --
see the Limits note in `tools/bench/README.md`.

The slot moved to `0x60760000`, and removal came to erase all of it, after most
of these rows were run. The rows for installing and removing over USB, the
blank-slot refusal, and the page naming the stock host were run again after
both changes, along with a firmware update that left the installed host in
place. The rest were run with the slot at `0x60280000` and have not been
repeated; nothing on their paths changed apart from the slot address. The host
then moved to 64 KiB of ITCM, with SdFat, SD and SPI running from flash apart
from the SDIO driver. On that host the rows for modules at `0x18000` and at
`0x10000`, for `exit_to_menu`, and for a refusal by a host with no code floor
were run again; the others were not.

| Verified on hardware | |
|---|:-:|
| Launch record, manifest and client validation in the extension image | yes |
| The firmware's own host running against the published contract in [`VMHostABI.h`](../../Source/Teensy/MinimalBoot/Common/VMHostABI.h) | yes |
| Module loaded into ITCM/DTCM, entry point called, `VmModule` table accepted | yes — linked at `0x18000` |
| The same, for a module linked at `0x10000` (`--code-kib 128`), and its refusal by a host whose code floor is above that | yes — a module with 101 KiB of code, more than the `0x18000` window holds, runs under the stock host (floor `0xf00c`), reads the card, and returns to the menu on joystick-2 up. It and an 876-byte module at `0x10000` are refused on screen by a host with no code floor, `TeensyROM host states no code floor, so takes $18000 only`, with the board left at the menu. The refusal by a host that states a floor above `0x10000` (`host needs code at …`) is covered by `registry_test` only. |
| Client cartridge cold start from the Ultimax reset vector | yes |
| Bank 58 opens the IO2 window; `start` handshake | yes |
| Four packets published, framed, CRC-checked by the client and acknowledged | yes |
| Guest arena size reported by the module | yes — `guest_ram_bytes` = 524288 on profile 0 |
| Failure record written at `0x2027ff60` and collected by the main image | yes |
| A guest fault under profile 0 collected as `$03` | yes — `udf` inside `vm_entry`, reproduced twice |
| A guest write across the top 128 bytes — the `CrashReport` span, not the 32-byte record below it — then a normal return | yes — collected as `$00`, so the scribble was not promoted to `$03` |
| The menu rendering a collected *crash* record on the C64 screen | no — the three record rows above were read over the main image's USB serial. The install and removal records ($30/$40) take the same `VmFail::report()` path to the screen; this row is about the crash records only. |
| Input records (`$DFF4` = 3): joystick fire in the reference client reaches the module, which recolours its text | yes |
| `quiet` and resume (`$DFF4` = 4 / 1) | **no** |
| The client-side `extension failed` path | no |
| Memory profile 1 (write-protected constants) | no |
| PAL timing | no |
| Installing a host from a `.TRH` over USB, and the `$30` record it reports | yes |
| Removing an installed host over USB, and the `$40` record it reports | yes — detail `$0`, every sector erased |
| A firmware update leaving the installed host in place | yes |
| A remove with the slot blank declining without touching flash | yes |
| A remove clearing a slot that holds no host but is not blank (what a failed install leaves) | no — covered natively, by a verify failure and a power cut at every install operation, but no bench step leaves such a slot |
| Removing a host from the C64 menu: `F8`, `0`, `u`, `y` (Settings → Installed Extension → uninstall → confirm) | yes |
| The same page naming the installed host out of the slot's own descriptor | yes — and separated from the constants. Read off the board twice on the same firmware: with its own host in the slot the page shows `TeensyROM  ABI 2  services $409f`, and with `Source/Teensy/ExampleHost` installed over it the *same image* shows `Example  ABI 2  services $0000`. The running firmware's compiled-in values (`VMHost.h`, `VM_ABI`, `VM_HOST_SERVICES`) were `TeensyROM` and `$409f` in both runs, so the second line can only have come from the slot's descriptor. Earlier runs could not make this distinction, because the only host ever read on the page was the one whose constants the firmware also carried. |
| A host that is *not* this one installed into the slot and entered: `Source/Teensy/ExampleHost`, built through `--host-sketch` | yes — installed as `$30`/`$14c00`, entered, and back with `$50`/`$4`, its own `HostReturned` and blink count |
| A module refused against a host whose descriptor does not publish its services | yes — the gate names itself on the screen. With `Source/Teensy/ExampleHost` in the slot (`services $0000`), launching `/HELLO.crt` left the port up and printed `Example host lacks service $1f` on the C64, which is the `required_services` check in `tryLaunch` (`VMRegistry.h`) and no other line in the firmware. That is what the earlier run could not show: `tryLaunch` declines without rebooting ten ways and four more paths fall through to an ordinary launch without declining at all, so an intact port on its own does not say which of them fired. The host name in the message comes from the slot's descriptor, and `$1f` is the module's `required_services` minus what the host publishes. |
| `exit_to_menu` (`VM_SERVICE_EXIT`) called by a module | yes — `tools/bench/grants` leaves through it on every row, and the main image prints `$04` with the module's status as the detail |
| Service bit 20: a C64 write the client grants slice by slice | yes — `tools/bench/grants.py` on a C64 run as NTSC and then as PAL, whose client grants from a CIA2 timer NMI every 200 cycles: with slices of 32 to 140 bytes no NMI is lost and the last job's 4 KiB lands intact (the client's sum over it matches); a slice too long to end before the next tick is never granted, and its job ends `VM_C64_NO_GRANT`, as does a client that never grants |

Treat the rows marked **no** as untested rather than as working.

There are two ways out of a running extension, and both have run on hardware. A module that took `VM_SERVICE_EXIT` calls `exit_to_menu`, which
records `$04` and reboots into the menu. A module that did not is returned by
the reset button, which the extension image services from `loop()`: `isrButton`
(`ISRs.c`) only sets `BtnPressed`, and the reboot happens on the next pass of
the loop. That works for a resident module, because `vm_entry` returned and the
loop is running.

It does not work for a module whose `vm_entry` never returns. `vm_entry` is
called from `setup()`, by way of `VMHostBoot()` and `loadModule()`, so a module
that hangs there hangs `setup()`: `loop()` is never reached, `BtnPressed` is set
by the ISR and never acted on, and neither the menu button nor the C64 reset
line brings the board back — both are wired to the same `isrButton`. The way
out is to power the C64 off, which is also the board's only supply, since the
Teensy's own 5V/USB connection is cut during assembly
([`PCB/PCB_Assembly.md`](../../PCB/PCB_Assembly.md)). The alternate button is
not serviced while an extension runs either: `isrSpecial` is left unattached in
this image.

Installing and removing a host are main-image work and need no hand on the
board at all. `tools/bench/hostcycle.py` drives a whole round trip over USB.
The menu path was driven from the bench by putting keys in the C64's own
keyboard buffer over DMA (`Link.key()` in `tools/bench/trlink.py`), which is
what the settings menu reads through KERNAL GETIN at `$FFE4`. Neither is a
test-only path: `hostcycle.py` sends the same USB device-port token any host
tool sends, and the menu run gives the firmware exactly what a person at the
keyboard produces. Only the USB round trip is packaged as a script,
though: nothing in `tools/bench` replays the menu sequence, so re-running
that row means driving the keys again.
