SensoriumEmbedded/TeensyROM/docs/Architecture/images/Marco2-PHI2-scope-capture-2026-09-20.webp

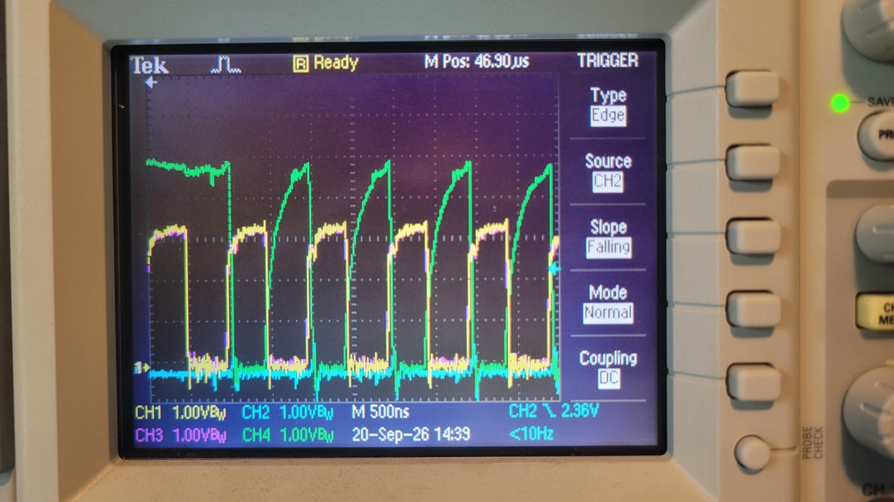
docs/Architecture/images/Marco2-PHI2-scope-capture-2026-09-20.webp
