SensoriumEmbedded/TeensyROM/docs/Architecture/images/Marco2-VCC-noise-burst-wide-2026-09-19.webp

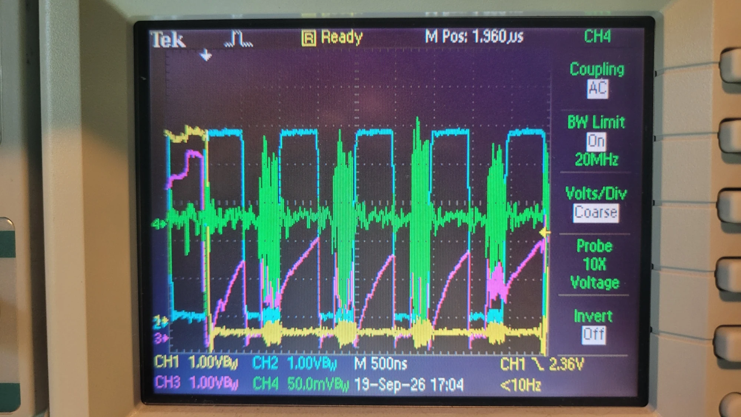
docs/Architecture/images/Marco2-VCC-noise-burst-wide-2026-09-19.webp
