SensoriumEmbedded/TeensyROM/media/case/case_top.png

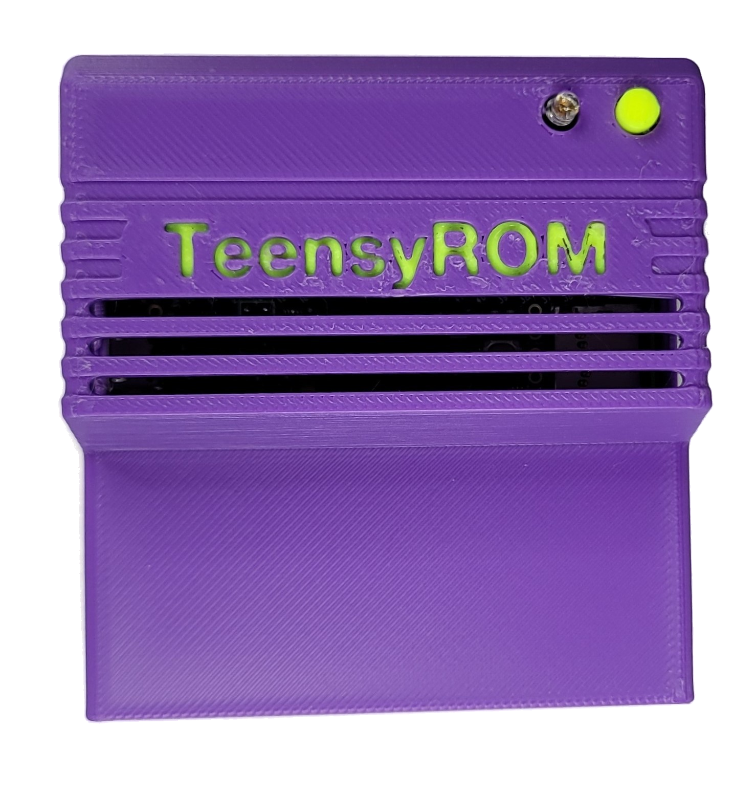
media/case/case_top.png
