SensoriumEmbedded/TeensyROM/media/NFC/Discrete_Top_Bot.jpg

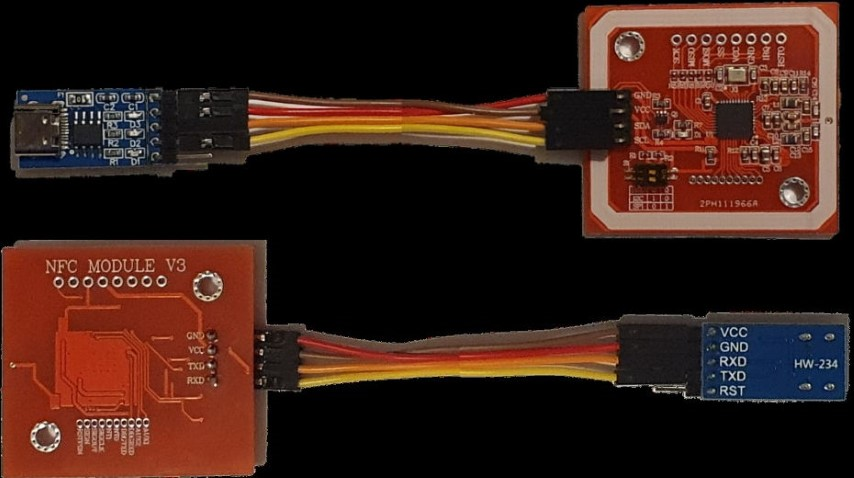
media/NFC/Discrete_Top_Bot.jpg
