SensoriumEmbedded/TeensyROM/media/Other/tindie-mediums.png

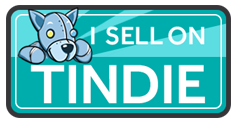
media/Other/tindie-mediums.png
