SensoriumEmbedded/TeensyROM/media/ROMH+VIC timing/TEK0009.JPG

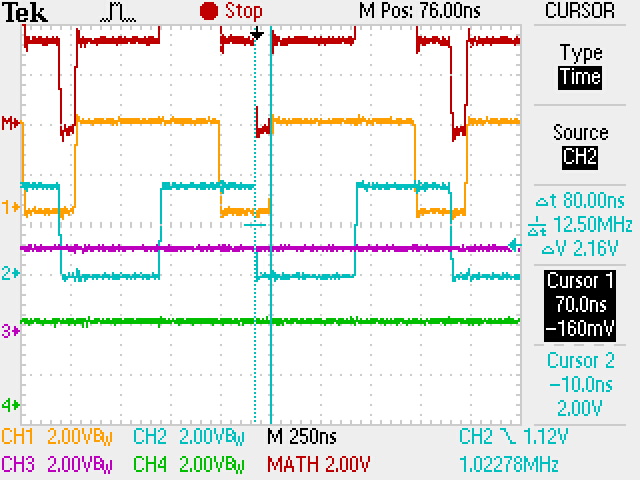
media/ROMH+VIC timing/TEK0009.JPG
