SensoriumEmbedded/TeensyROM/media/ROMH+VIC timing/TEK0013.JPG

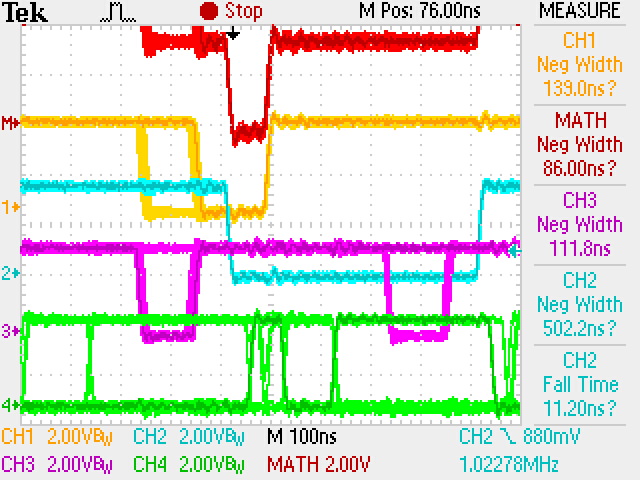
media/ROMH+VIC timing/TEK0013.JPG
