SensoriumEmbedded/TeensyROM/media/ROMH+VIC timing/TEK0015.JPG

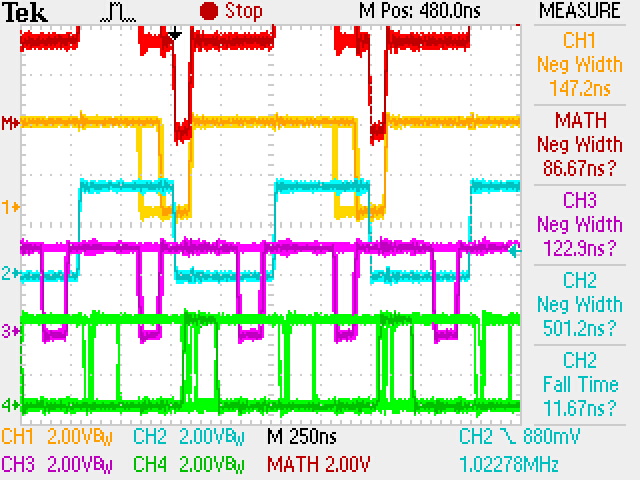
media/ROMH+VIC timing/TEK0015.JPG
