SensoriumEmbedded/TeensyROM/media/Screen captures/Color Settings.png

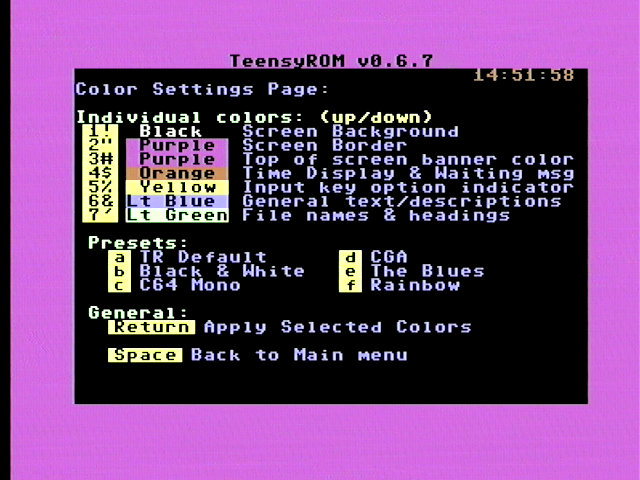
media/Screen captures/Color Settings.png
