SensoriumEmbedded/TeensyROM/media/Screen captures/Help Menu.png

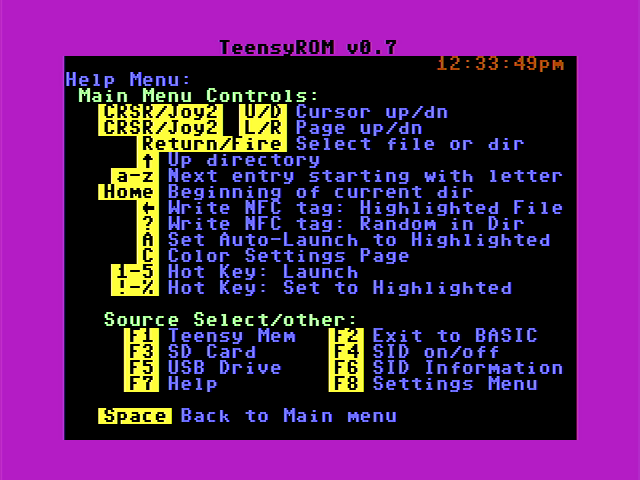
media/Screen captures/Help Menu.png
