SensoriumEmbedded/TeensyROM/media/Screen captures/Main Menu.png

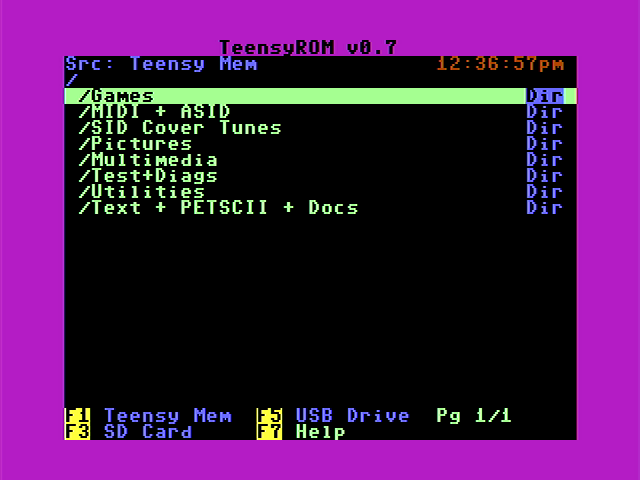
media/Screen captures/Main Menu.png
