SensoriumEmbedded/TeensyROM/media/Screen captures/Settings Menu.png

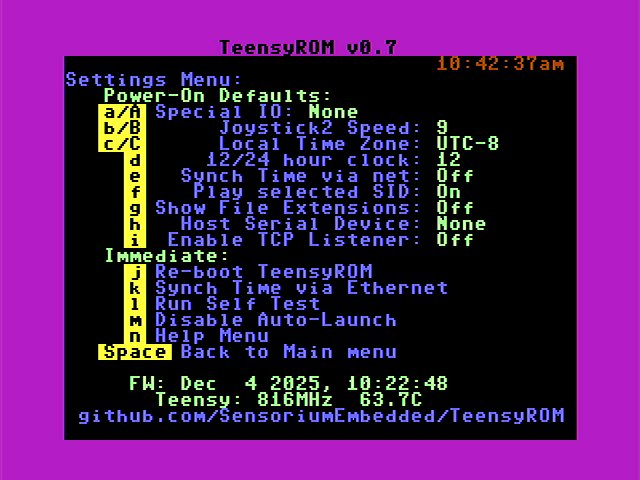
media/Screen captures/Settings Menu.png
