SensoriumEmbedded/TeensyROM/media/Screen captures/SIDInfoPage.png

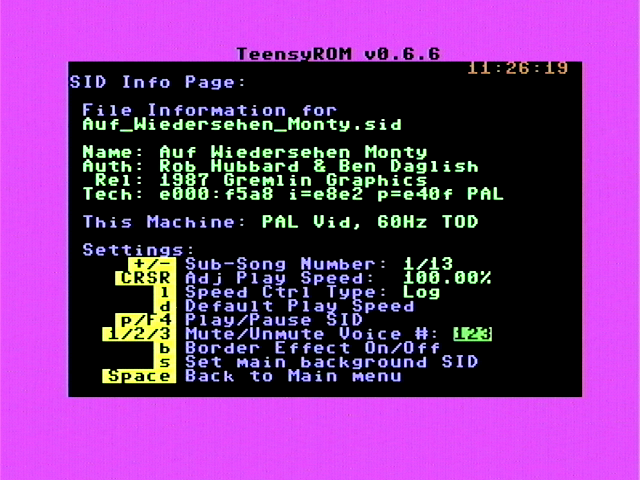
media/Screen captures/SIDInfoPage.png
