SensoriumEmbedded/TeensyROM/media/Screen captures/TinyWeb64.png

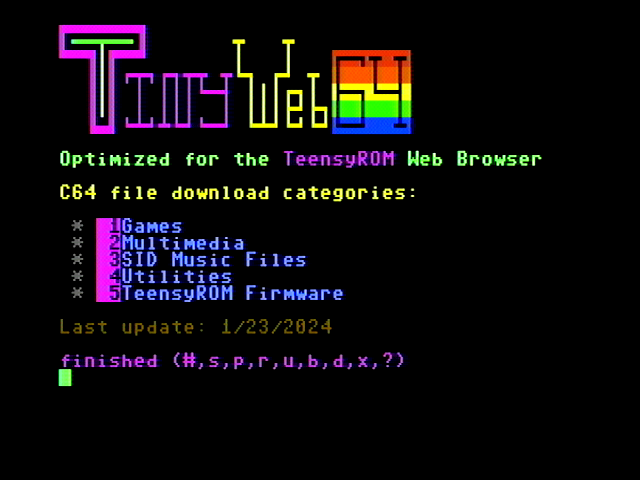
media/Screen captures/TinyWeb64.png
