SensoriumEmbedded/TeensyROM/media/Screen captures/TR+/help-settings-info/settings2-general.png

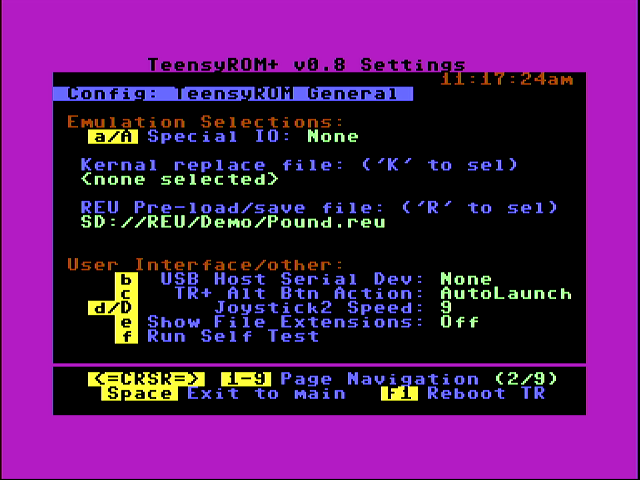
media/Screen captures/TR+/help-settings-info/settings2-general.png
