SensoriumEmbedded/TeensyROM/media/Screen captures/TR+/help-settings-info/settings3-startup.png

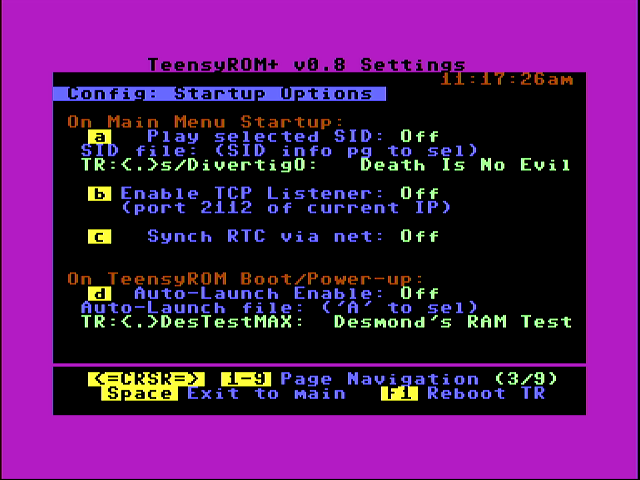
media/Screen captures/TR+/help-settings-info/settings3-startup.png
