SensoriumEmbedded/TeensyROM/media/Screen captures/TR+/help-settings-info/settings4-colors.png

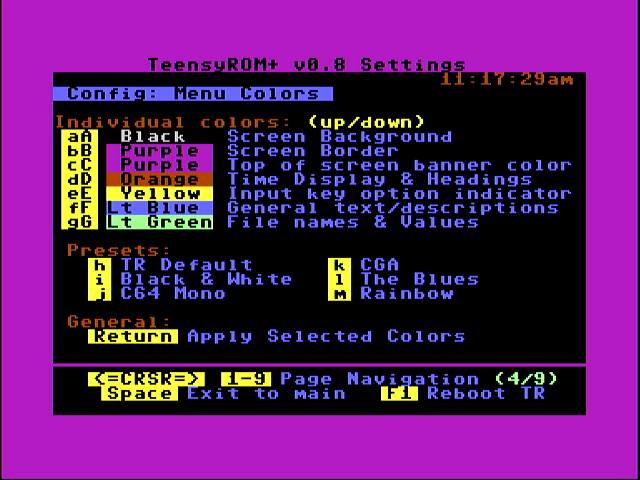
media/Screen captures/TR+/help-settings-info/settings4-colors.png
