SensoriumEmbedded/TeensyROM/media/Screen captures/TR+/help-settings-info/settings6-time-rtc.png

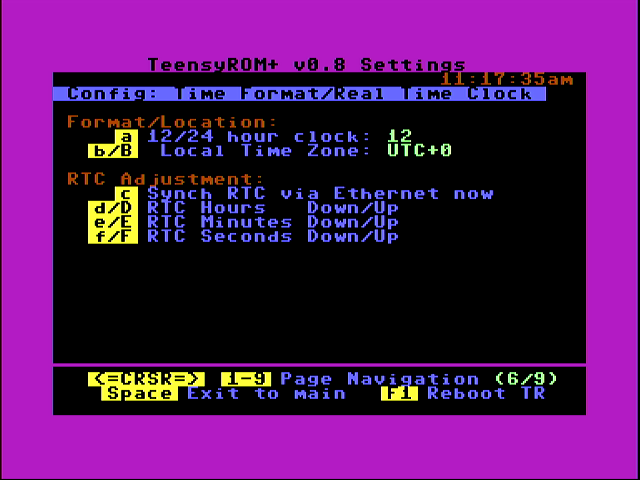
media/Screen captures/TR+/help-settings-info/settings6-time-rtc.png
