SensoriumEmbedded/TeensyROM/media/Screen captures/TR+/help-settings-info/settings7-info-general.png

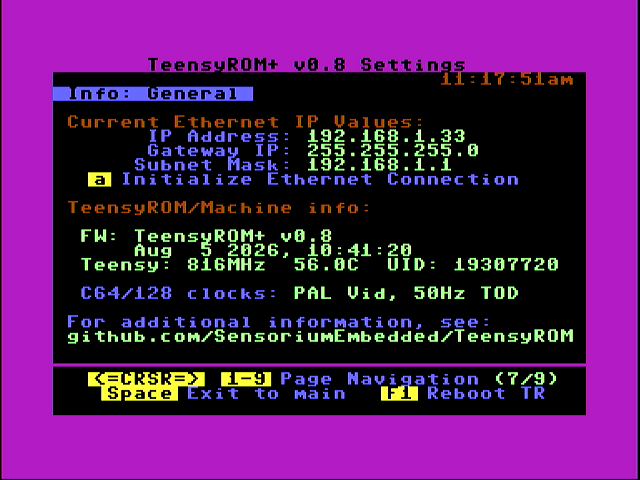
media/Screen captures/TR+/help-settings-info/settings7-info-general.png
