SensoriumEmbedded/TeensyROM/media/Screen captures/TR+/help-settings-info/settings8-info-ethernet.png

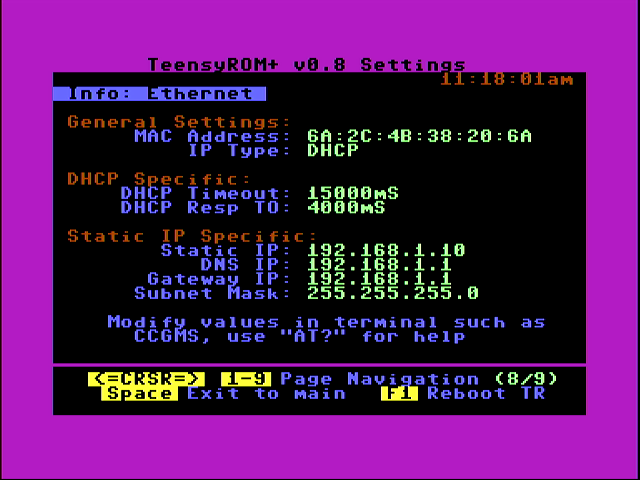
media/Screen captures/TR+/help-settings-info/settings8-info-ethernet.png
