SensoriumEmbedded/TeensyROM/media/Screen captures/TR+/help-settings-info/settings9-info-hot-keys.png

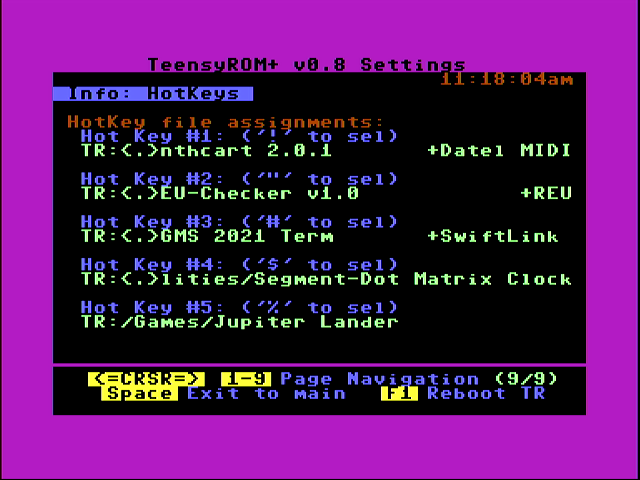
media/Screen captures/TR+/help-settings-info/settings9-info-hot-keys.png
