SensoriumEmbedded/TeensyROM/media/Screen captures/TR+/main-menu/USBMenu.png

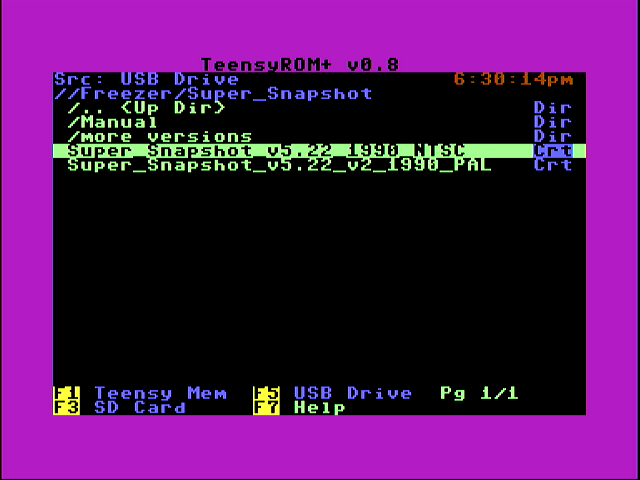
media/Screen captures/TR+/main-menu/USBMenu.png
