SensoriumEmbedded/TeensyROM/media/Screen captures/USB Devices.jpg

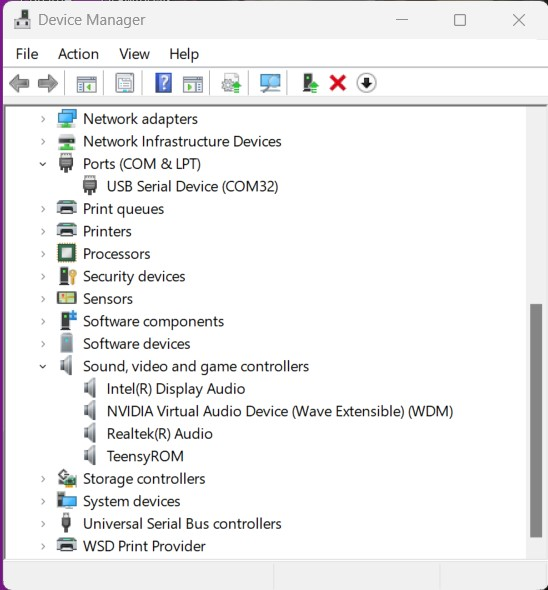
media/Screen captures/USB Devices.jpg
