SensoriumEmbedded/TeensyROM/media/Screen captures/USB Menu.png

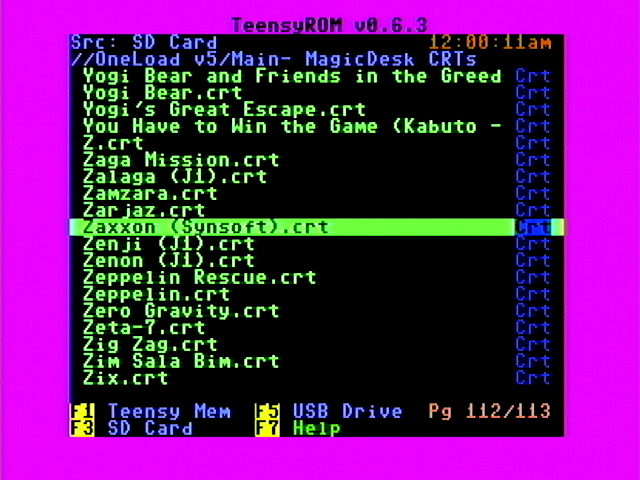
media/Screen captures/USB Menu.png
