SensoriumEmbedded/TeensyROM/media/Screen captures/WinPC x-fer app.png

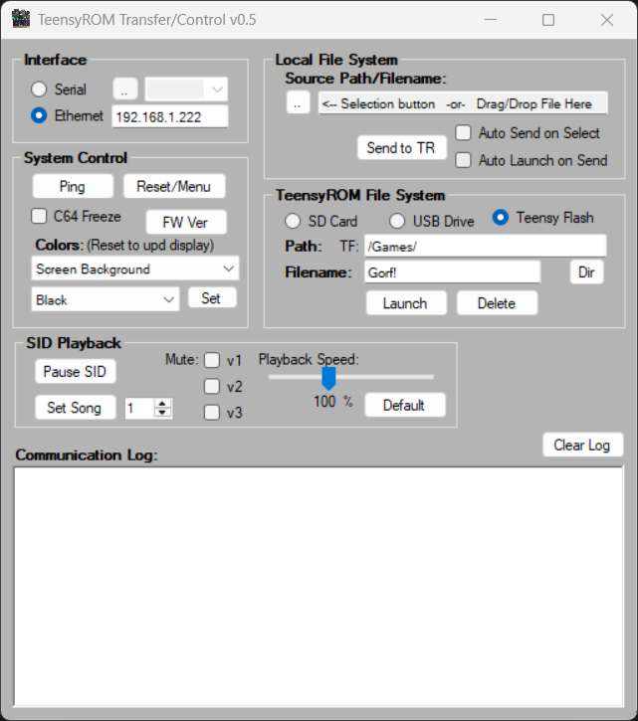
media/Screen captures/WinPC x-fer app.png
