SensoriumEmbedded/TeensyROM/media/Teensy/Teensy Bot Pins.jpg

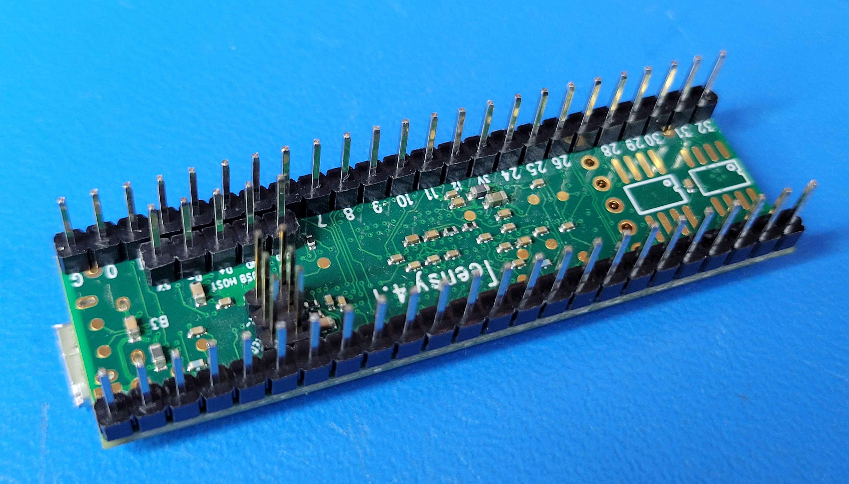
media/Teensy/Teensy Bot Pins.jpg
