SensoriumEmbedded/TeensyROM/media/Teensy/Teensy Power.jpg

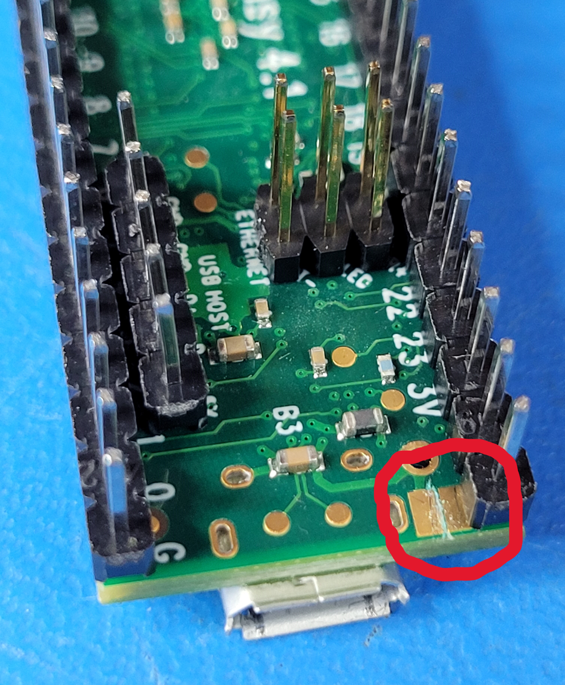
media/Teensy/Teensy Power.jpg
