SensoriumEmbedded/TeensyROM/media/Teensy/Teensy Top Pins.jpg

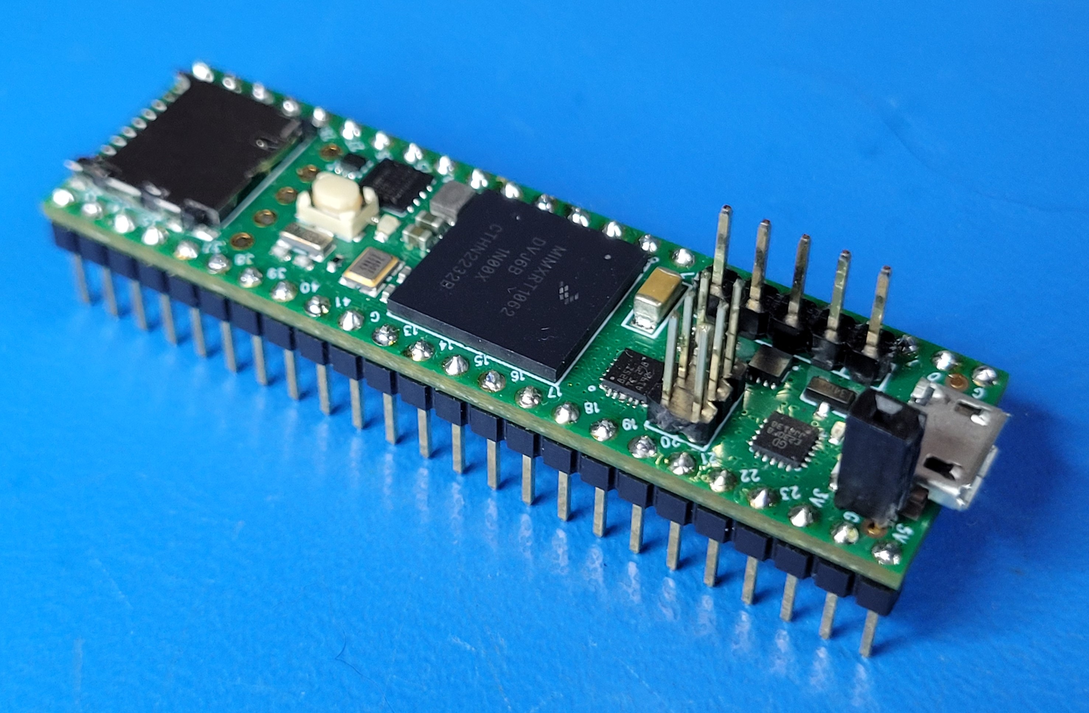
media/Teensy/Teensy Top Pins.jpg
