SensoriumEmbedded/TeensyROM/media/v0.2b/v0.2b_angle.jpg

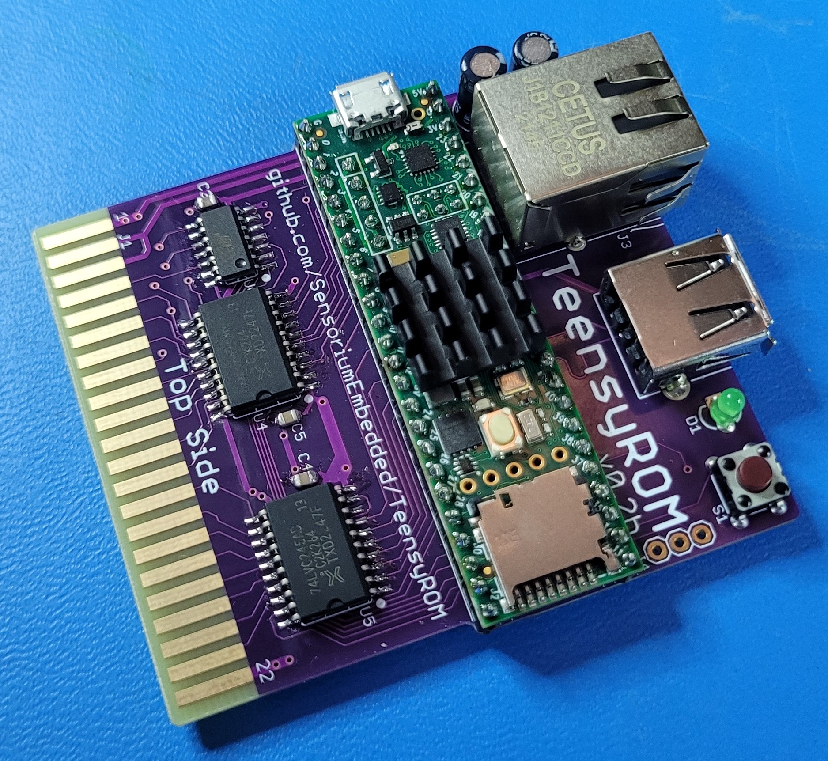
media/v0.2b/v0.2b_angle.jpg
