SensoriumEmbedded/TeensyROM/media/v0.2b/v0.2b_insitu_MIDI.jpg

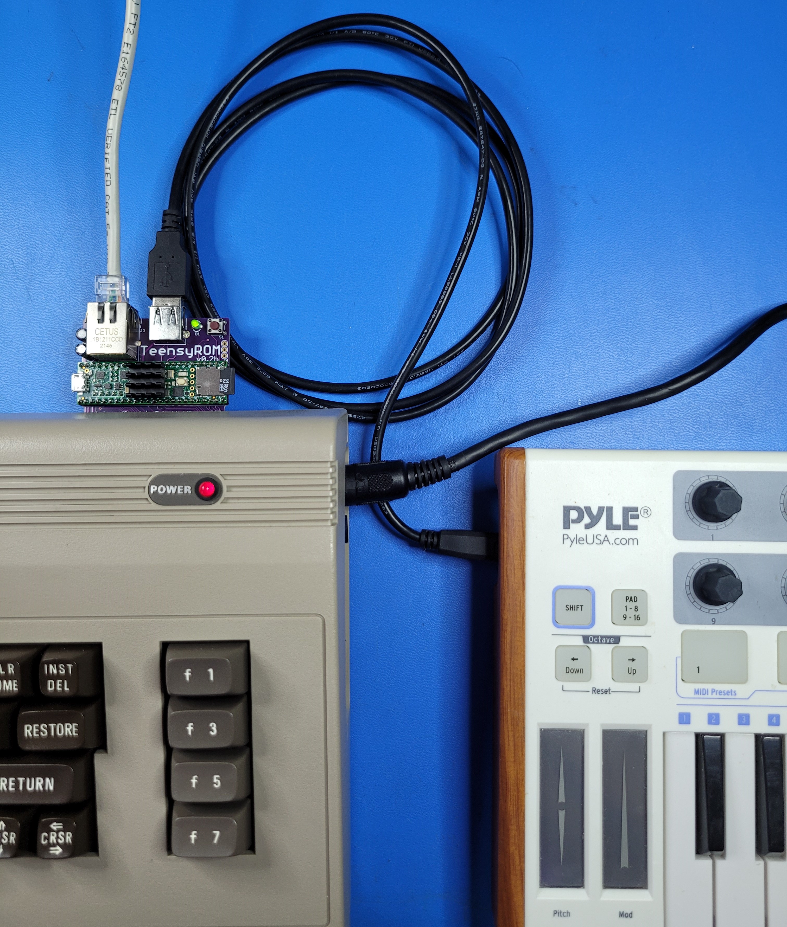
media/v0.2b/v0.2b_insitu_MIDI.jpg
