SensoriumEmbedded/TeensyROM/media/v0.2b/v0.2b_top_loaded.jpg

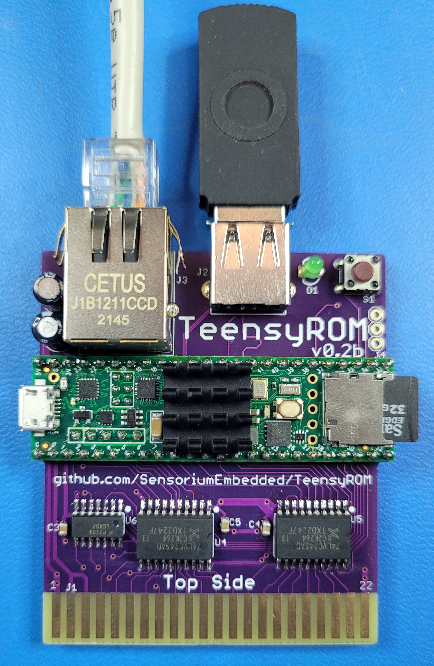
media/v0.2b/v0.2b_top_loaded.jpg
