SensoriumEmbedded/TeensyROM/3D_Print_Case/TeensyRom-Cart-top-minimal.stl

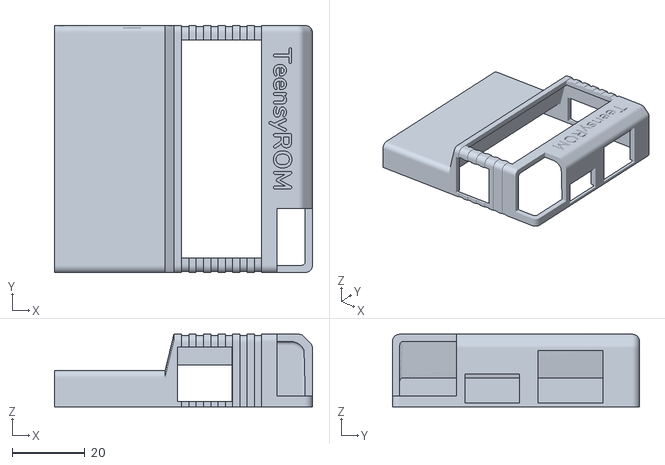
[picture p61: CAD file, 2023-10-18]
3D_Print_Case/TeensyRom-Cart-top-minimal.stl
71.0 x 68.0 x 20.0
