SensoriumEmbedded/TeensyROM/3D_Print_Case/TeensyRom-Cart-bottom.stl

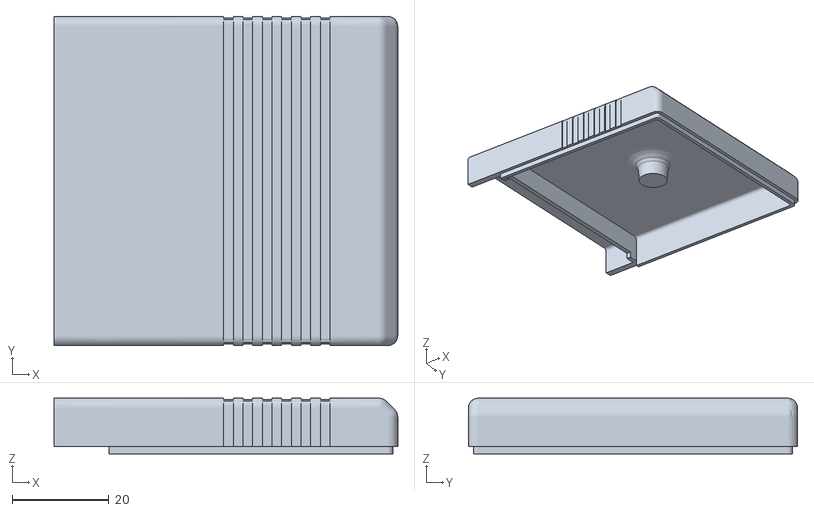
[picture p62: CAD file, 2023-10-09]
3D_Print_Case/TeensyRom-Cart-bottom.stl
71.0 x 68.0 x 11.5
