SensoriumEmbedded/TeensyROM/3D_Print_Case/TeensyRom-Cart-top-Vented.stl

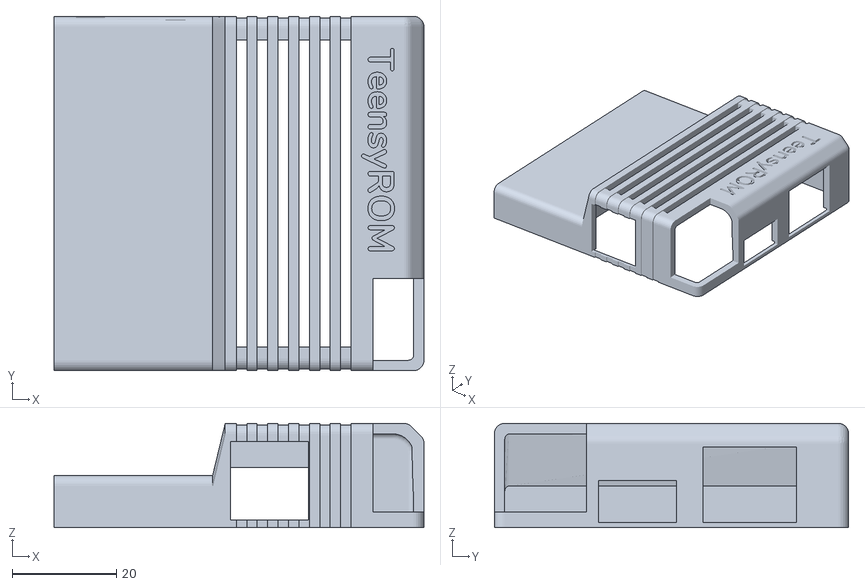
[picture p63: CAD file, 2023-10-04]
3D_Print_Case/TeensyRom-Cart-top-Vented.stl
71.0 x 68.0 x 20.0
