SensoriumEmbedded/TeensyROM/docs/General_Usage.md

# General TeensyROM usage

## Table of contents
  * [TeensyROM connections and Menu button](#teensyrom-connections-and-menu-button)
  * [Main Menu Options-Navigation](#main-menu-options-navigation)
  * [SD Card or USB Drive Setup](#sd-card-or-usb-drive-setup)
  * [Loading files and emulating ROMs](#loading-files-and-emulating-roms)
  * [The Settings Menu](#the-settings-menu)
  * [Selecting and associating Special IO](#selecting-and-associating-special-io)
  * [Firmware updates](#firmware-updates)
  * [Troubleshooting](#troubleshooting)

## TeensyROM connections and Menu button
  * With the power off, attach the TeensyROM to the Expansion port of your Commodore64 or 128 machine
  * Power on, the TeensyROM main menu should be displayed
  * The Menu button can be pressed at any time to return to the TeensyROM main menu from another program
  * Additional external hardware connection points:
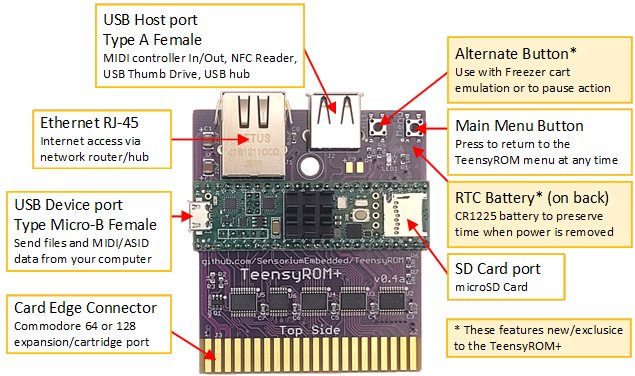
[picture p64: media/TR_Connections.png]
TeensyROM connections
    * 

## Main Menu Options-Navigation
  * (as of FW v0.9.1)
  * Menu navigation: Use the keyboard or a Joystick connected to Control Port 2
    * `CRSR or Joystick Up/Down` Move cursor up/down the list of files on the currently selected source device
    * `CRSR or Joystick Left/Right` Page up/down the list of files
    * `Return or Joystick Fire button` Select/run the highlighted file or enter sub-directory
  * Additional Keyboard commands:
    * `Up Arrow` Up 1 directory level
    * `a-z`  Search current directory for first item beginning with letter pressed
    * `Home` Move cursor to first item in directory
    * `Left Arrow` Write NFC Tag that will launch currently highlighted file
    * `?` Write NFC Tag that will launch a random file from the currently selected Directory
    * `<Shift-A>` Set Auto-Launch to currently highlighted file
    * `<Shift-M>` Transfer/Mount/Launch highlighted .Dxx file via attached [Meatloaf](https://github.com/idolpx/meatloaf) device
      * Requires Meatloaf using latest FW connected to the TR USB Host port.
    * `<Shift-K>` **(TR+ only)** Set highlighted file as the Kernal Replace image
    * `<Shift-R>` **(TR+ only)** Set highlighted file as the REU pre-load/save image
    * `INST/DEL` Delete the highlighted file from the SD card or USB drive (asks for confirmation first)
    * `1-5` Programmable Hot Keys to immediately launch a specified file
      * Defaults: `1` Cynthcart, `2` Station64 **(TR+ default: REU-Checker v1.0)**, `3` CCGMS, `4` TeensyROM ASID Player, `5` Jupiter Lander CRT
    * `!-%` (Shift `1-5`) Set corresponding Hot Key to currently highlighted file (on any media source)
    * `F1` Display files stored in Teensy Memory via firmware
    * `F3` Display files on an attached SD card
    * `F5` Display files on an attached USB Drive
    * `F7` Show Help Menu (2 pages: navigation/source keys, and per-file select options)
    * `F2` Exit to regular BASIC startup screen, TeensyROM deactivated
      * Re-activate TeensyROM by pressing button
    * `F4` Toggle background SID on/off
    * `F6` Show SID Information
    * `F8` Show Settings Menu
  * Screen contents:
    * **File Source and dir path** is shown in the upper left corner
    * **Page number and number of pages** is shown in the lower right corner
    * **Current time** is shown in the upper right.
      * Time is synched to the Teensy integrated RTC
      * If an RTC battery is present (built-in on TR+, or added to TR via [battery mod](RTC_Battery_Addition.md)), the time should be correct, no Ethernet needed.
      * Optionally, the time can be automatically synced via Ethernet on startup (see settings).
      * If neither of these are available, time can be set manually in the settings menu, or just let it start at midnight.
    * **File type** is to the right of each file/dir displayed. If "Unk" (unknown) then it is not a recognized/supported file type.
      * A file on the SD card whose extension an installed extension package (in `/VMS`) claims shows the first three characters of its own extension instead, such as "MPE".
      * **'+'** in front of file type means it is pre-associated with [Special IO](#selecting-and-associating-special-io) emulation needed for function (MIDI, Swiftlink network) 
    * **Quick Help** is displayed at the bottom of the screen, use F7 for detailed help screen.

## SD Card or USB Drive Setup
  * General info/configuration
    * No TR firmware is stored on these external drives, so they are not required to start using your TeensyROM and all of its firmware-bundled programs.
    * SD Cards are somewhat favored over USB drives as they have slightly faster access times.
      * 32GB SD cards typically give the fastest directory read times
    * We've seen some issues with USB (or SD) drives with non-standard partitioning of the drive, especially manufacturer default partitions.  
      * If you have issues reading drive contents via the TR, try deleting the existing partition(s) (either via the 'diskman' Disk Management gui or using 'diskpart' and 'clean' via command line) then re-partition. After that, re-format in either FAT32 or FAT16 and load files.
  * Recommended Files/Games/SIDs
    * The [OneLoad64 Games Collection (v5)](https://www.youtube.com/watch?v=lz0CJbkplj0) is a wonderful (and free) source for thousands of files/games in CRT format, which is perfect for the TeensyROM
    * The [High Voltage SID Collection](https://hvsc.de/downloads) contains over 50,000 SID files, most of which are directly playable on the TeensyROM.
    * There's a great collection of Single Load Demos [located here](http://sensoriumembedded.com/tinyweb64/Demos/).
    * [Here's a .zip](https://sensoriumembedded.com/tinyweb64/TeensyROM+/TR+%20Demos-Support.zip) of files/programs that highlight TeensyROM+ capabilities.
    * We recommend adding [this autolaunch.txt file](autolaunch.txt) to the root of an SD card in case you want to set up your TeensyROM as an unprompted diagnostics cartridge in the future.
    * Here are a couple scripts that copy all of the above referenced files to an SD Card
      * [Cross platform MAKEFILE](Ref_Scripts/Makefile) by [The JEEP](https://github.com/mchineboy)
      * Or use this [Windows PowerShell Script](Ref_Scripts/Build-TeensyromCard.ps1)
    * TeensyROM+ owners: add the [Mean Hamster Power Engine (MPE)](TR_Host_Extensions.md#mean-hamster-power-engine-mpe) Host Extension and its game system VMs (NES, Game Boy, Game Gear, Tritari, Doom and more) to play games never released for the C64.
      * Licensed material isn't included with MPE or its VMs: game ROMs and original game files for the MPE/VMs are yours to obtain as needed.
    
## Loading files and emulating ROMs
  * Files can be launched from any of the available sources, including any subdirectory
  * When a file is selected, load/run status is displayed on the screen.  Usually this will flash by too quickly to read, but in the case of an error, it will pause to provide additional information.
  * File types supported:
    * **.PRG and .P00 files:** 
      * Super fast-loads any PRG into C64/128 RAM and executes
        * Same result as LOAD"file",x,1 and RUN (but much faster)
      * Must be single PRG file, not multi-part
      * On a C128, a C128 BASIC program (one that loads at $1C01) restarts the C128 in 128 mode, loads, and runs there; on a C64 it loads as before
      * **Exit to C128 BASIC** (Utilities, **+C128**) restarts a C128 in 128 mode with no cartridge, as if powered on
    * **.CRT files:**
      * Emulates/supports most popular cartridge types:
        * All 8khi, 8klo, 16k, and C128 "Generic" carts
        * EasyFlash, Magic Desk, Ocean, Dinamic, Zaxxon/Super Zaxxon, GMod2
        * Epyx Fast Load, Game System 3, SuperGames, FunPlay/PowerPlay, Magic Desk 2
        * Ethernet (Swiftlink/Turbo-232), MIDI (Passport, Datel, Sequential, & Namesoft)
        * Action Replay, Retro Replay, Final Cartridge III, Super Snapshot V5 (freezer carts, **TR+ only**)
      * Additional CRT support info
        * Files larger than 850KB will automatically employ a bank-swap scheme 
          * These files must be run from an SD Card (not USB Stick)
          * Uses "old school" REU type of DMA assertion for fast pausing and no additional CPU execution
            * This method will not work on some systems (Most C128s and a low percentage of NTSC systems)
            * DMA Pause check utility included in Test+Diags dir to test specific system DMA reliability
          * Many large CRT files have been tested with this scheme, all are working smoothly (as long as host C64 passes DMA check)
          * See full CRT implementation details [here](CRT_Implementation.md).
        * On rev 0.2x PCBs, when using the C128 to emulate "Ultimax" carts (Deadtest, Jupiter Lander), some screen artifacts are visible. 
          * This issue only impacts Ultimax CRTs on C128s and is resolved in PCB rev 0.3
        * EasyFlash images up to 4 MB (256 banks) are supported. Large images use the SD card bank-swap scheme above, so they must be launched from SD.
        * EasyFlash EAPI not currently supported
    * **.SID files:**
      * Play SID file: ~90% of known SID files are supported
      * Adjusts playback speed based on machine and SID type (NTSC/PAL)
      * SID info screen contains SID header information and playback controls
    * **.KLA/KOA files:**
      * Displays Koala multi-color picture
      * Compatible with output from [Retropixels online](https://www.micheldebree.nl/retropixels/)
    * **.ART/AAS/HPI/OCP/PIC files:**
      * Displays Art Studio Hi-Res picture
    * **.TXT/NFO/MD files:**
      * Displays ASCII text in the TR text viewer
      * See viewer usage/navigation doc via TR on your C64 in the /Text+PETSCII+Docs directory.
    * **.SEQ files:**
      * Displays PETSCII directly in the TR text viewer
      * Compatible with SEQ output from [lvllvl.com](https://lvllvl.com/) and [petscii.krissz.hu](https://petscii.krissz.hu/)
      * See viewer usage/navigation doc via TR on your C64
    * **.D64/.D71/.D81 files:**
      * Single File load/exec only (no multi-file/writebacks)
      * Exception (FW 0.9.1 and later): GEOS 64 and GEOS 128 boot from a .D81 boot disk in `/GEOS64` and `/GEOS128` with full disk read/write. See [GEOS 64 on the TeensyROM](GEOS64_Usage.md) and [GEOS 128 on the TeensyROM](GEOS128_Usage.md).
    * **.HEX files:**
      * Used for TeensyROM firmware updates (see below)

## The Settings Menu 
  * (as of FW v0.9)
  * Accessed via `F8` from the main menu. Organized into indexed pages — settings changes take effect live and are stored in EEPROM (recalled on power-up).
  * Shared navigation, works from any page:
    * `CRSR Left/Right` Previous/Next page
    * `1-9`, `0` Jump directly to a page (see page # below)
    * `F1` Reboot TeensyROM (applies any power-up-only settings)
    * `Space Bar` Return to Main Menu

### 1. Index
  * Lists every page below for quick-jump access

### 2. Config: TeensyROM General
  * Emulation Selections:
    * `a/A` Cycle forward/backward through available Special IO to apply when launching a PRG/CRT (see [Selecting and associating Special IO](#selecting-and-associating-special-io))
      * Current Kernal Replace file is shown **(TR+ only)** — select via `<Shift-K>` from the file browser
      * Current REU Pre-load/save file is shown **(TR+ only)** — select via `<Shift-R>` from the file browser
  * User Interface/other:
    * `b` Cycle Serial device connected to USB Host Port: None, [NFC Reader](NFC_Loader.md), or [TR Controller](https://github.com/SensoriumEmbedded/TeensyROMControl)
      * Selected device is initialized on power-up/reboot
    * `c` Cycle Alt Button action **(TR+ only)**: `AutoLaunch` (default), `Pause/Unpause`, `TR Menu`, `Reboot TR`, or `None`
      * Only active when the button isn't already in use by a freezer cart or REU
    * `d/D` Increment/Decrement Joystick 2 repeat speed for menu navigation
    * `e` Toggle Show File Extensions
    * `f` Toggle External Reset Detect **(TR+ only)**: when on (default), an external reset (C64 reset button, User port, etc.) returns to the TeensyROM menu, as if the TR menu button was pressed
      * Turn it off when an external reset shouldn't return to the TR menu, such as when getting into C128 BASIC
    * `g` Toggle TR+ REU with RetroReplay, SuperSnapshotV5, and Final Cartridge III 101% **(TR+ only)**
      * On (default): those carts launch with the TR+ REU alongside them. A short press of the Alt button freezes; holding it 700 ms or longer saves the REU image
      * Off: they launch as the plain cartridge, with no TR+ REU
      * Only FC3 CRTs flagged as the REU-compatible 101% version (CRT subtype 1) get the REU

### 3. Config: Startup Options
  * On Main Menu Startup:
    * `a` Toggle Play selected SID on startup (file shown; select from the SID Info page)
    * `b` Toggle Enable TCP Listener on port 2112 of the current IP, for remote control — see [ControlComms.md](ControlComms.md)
    * `c` Toggle Synch RTC via net on startup (Ethernet NTP time sync — see [Main Menu Options-Navigation](#main-menu-options-navigation) for how this interacts with a battery-backed RTC)
  * On TeensyROM Boot/Power-up:
    * `d` Toggle Auto-Launch Enable (file shown; select via `<Shift-A>` from the file browser)

### 4. Config: Menu Colors
  * Individual colors, each cycled through the 16 C64 colors:
    * `a/A` Screen Background
    * `b/B` Screen Border
    * `c/C` Top of screen banner color
    * `d/D` Time Display & Headings
    * `e/E` Input key option indicator
    * `f/F` General text/descriptions
    * `g/G` File names & Values
  * Presets:
    * `h` TR Default
    * `i` Black & White
    * `j` C64 Mono
    * `k` CGA
    * `l` The Blues
    * `m` Rainbow
  * `Return` Apply the selected colors

### 5. Config: MIDI Message Filters
  * Only message types marked "On" are passed through to the C64/128 — useful for DAWs or MIDI controllers that send extra packets that can overwhelm some C64 MIDI software (such as Cynthcart)
  * Packet types to transfer, each individually toggled on/off:
    * `a` Note Off/On (8x/9x)
    * `b` AfterTouch Poly (Ax)
    * `c` Control Change (Bx)
    * `d` Program Change (Cx)
    * `e` AfterTouch (Dx)
    * `f` Pitch Change (Ex)
    * `g` System Exclusive (F0)
    * `h` TimeCode QuarterFrame (F1)
    * `i` Song Position (F2)
    * `j` Song Select (F3)
    * `k` Tune Request (F6)
    * `l` Real Time System (F8-FF)

### 6. Config: Time Format/Real Time Clock
  * Format/Location:
    * `a` Toggle 12/24 hour clock display
    * `b/B` Set local Time Zone (UTC offset, half-hour increments)
  * RTC Adjustment:
    * `c` Synch RTC via Ethernet now (also displays the local IP address)
    * `d/D` RTC Hours down/up
    * `e/E` RTC Minutes down/up
    * `f/F` RTC Seconds down/up

### 7. Info: General
  * Current Ethernet IP Values: IP Address, Gateway IP, Subnet Mask
    * `a` Initialize/re-init Ethernet connection
  * TeensyROM/Machine info:
    * FW version and build date/time
    * Teensy clock speed and internal temperature
    * Unique Teensy hardware ID (also shown via the Version Info remote command — see [ControlComms.md](ControlComms.md))
    * Detected C64/128 clock rates (PAL/NTSC and CIA TOD) — handy for confirming what machine video/mains power standard the TR sees

### 8. Info: Ethernet
  * General Settings: MAC Address, IP Type (Static/DHCP)
  * Timeouts: Init Timeout (how long DHCP waits for a lease, or a static IP for the cable link), DHCP Response Timeout
  * Static IP Specific: Static IP, DNS IP, Gateway IP, Subnet Mask
  * This is a read-only display — to modify these values, use a terminal program (such as CCGMS) and the `AT?` command for help. See [Ethernet Usage](Ethernet_Usage.md).

### 9. Info: HotKeys
  * Shows the currently assigned file for each of the 5 programmable Hot Keys (#1-5)
  * Reassign from the main menu file browser using `!`/`"`/`#`/`$`/`%` (Hot Keys 1-5 respectively)

### 0. Installed Extension **(TR+ only)**
  * Shows the name of the installed extension, or "None installed"
    * Extensions are optional add-ons, distributed as `.TRH` files. TeensyROM works normally without one
    * See [TR Host Extensions](TR_Host_Extensions.md) for what they are and how to get them
    * To install: copy the `.TRH` file to SD or USB and select it in the file browser
    * Firmware updates keep the installed extension
  * Lists the file types registered on the SD card: one row per registration folder in `/VMS`, with the file types it claims
    * `*` another folder claims the same file type, so neither opens it; `x` the folder couldn't be read; `!` it wouldn't launch: its module or client file is damaged or missing, or the installed extension can't run it
    * Rows below the list say what stops a launch, then how the last launch went. See [TR Host Extensions](TR_Host_Extensions.md#checking-or-removing-the-installed-extension)
  * `u` Uninstall the extension (`y` to confirm). TeensyROM restarts afterwards
    * Also use `u` if the page says `None installed; slot not blank.` That means an earlier install or uninstall didn't finish
  * ***Important*** Uninstall any extension before loading an older firmware without extension support. That firmware can't update itself while an extension is installed

## Selecting and associating Special IO
  * What is it?
    * "Special IO" in this context means additional HW that is emulated to assist with SW function.
    * This emulation runs at the same time as a selected program/cartridge
    * Examples of these are Swiftlink/Modem, and MIDI interfaces
    * This HW uses the IO1 ($DE00) address space and interrupts to pass information to/from the program running on the C64/128.
  * How is it used/selected?
    * The easy method is to use the software supplied with the TeensyROM with a '+' sign in front of the type.
      * These will automatically associate the needed IO to emulate Swiftlink Internet or the required MIDI interface.
      * This includes the following, for example:
        * **CCGMS Terminal** Pre-configured and associated with Swiftlink interface to [Ethernet connection](Ethernet_Usage.md)
        * **Cynthcart** Associated with the Datel MIDI interface to [USB MIDI Host/Device](MIDI_Usage.md)
        * **Station 64** Associated with the Passport MIDI interface [USB MIDI Host/Device](MIDI_Usage.md)
    * Special IO can also be selected in the settings menu
      * This setting will be applied at the time of launching any program or generic cartridge
      * The setting stays in memory and will be re-loaded for any app until changed
      * We recommend disabling NFC if Special IO is selected to avoid interference.
    * If a selected CRT file is associated with different Special IO (i.e. Epyx, EasyFlash etc), that Special IO will be loaded instead
  * RAM expansions:
    * **GeoRAM**: Berkeley Softworks geoRAM, 128K to 512K (as much as fits). Its window is at `$DE00` and its registers at `$DFFE`/`$DFFF`. The TeensyROM's USB mouse and [block device](TR_Block_Device.md) registers sit beside it at `$DF00`.
      * Loads `SD:/georam.ram` at launch. **(TR+ only)** Press and release the Alt button to save it there; the previous save is kept as `georam.bak`.
    * **512KB REU** **(TR+ only)**: a Commodore REU (1700/1764/1750) at `$DF00`, 128K to 512K (as much as fits).
      * Loads the REU pre-load/save image at launch (choose it with `<Shift-R>` in the file browser). Press and release the Alt button to save it there.
    * **REU+USB Mouse/Disk** **(TR+ only)**: the same REU at `$DF00`, with the USB mouse and block device registers moved to `$DE00`. The REU's unused registers read `$FF`, as a 1764's do.
      * Made for GEOS: with it selected, GEOS 64 and GEOS 128 run with the REU, which GEOS's own CONFIGURE finds. With any other setting they run with GeoRAM. See [GEOS 64](GEOS64_Usage.md#ram-expansion-georam-or-reu) and [GEOS 128](GEOS128_Usage.md#ram-expansion-georam-or-reu).

## Firmware updates
  TR and TR+ have separate firmware files, so first pick the one for your hardware:
  * TR (PCB v0.2–0.3): `TeensyROM_<version>_full.hex`
  * TR+ (PCB v0.4): `TeensyROM+_<version>_full.hex`
    * A TR+ shows "+" in its banner and title (e.g. "TeensyROM+ v0.9"), if you're not sure which you have
  * The menu-based updates below (SD/USB and Ethernet) refuse a file built for the other board
  * The TeensyLoader application doesn't check, so take care to load the right file with it
  * Firmware older than 0.4 can't update from SD/USB (0.5.8 for Ethernet); use the TeensyLoader method once

  There are multiple ways to update the TeensyROM firmware, choose one of the following:

### **From SD Card or USB Thumb Drive**
  * Get the .hex file containing the latest major (x.x) or minor (x.x.x) release [from the releases page](https://github.com/SensoriumEmbedded/TeensyROM/releases/latest)
  * Copy the file to a USB Thumb drive or SD card
    * This can be done by the traditional method of moving the card to a capable computer
    * Or directly from your computer using **[Trom UI](https://github.com/MetalHexx/TeensyROM-Suite/blob/main/docs/trom-ui.md#copy-files-to-your-cart)** or **[Trom Terminal](https://github.com/MetalHexx/TeensyROM-Suite/blob/main/docs/trom-terminal.md#copy-files)** from the cross-platform **[TeensyROM Suite](https://github.com/MetalHexx/TeensyROM-Suite)**
  * In the TeensyROM USB or SD Menu, select the Firmware .hex file
  * A new screen will open and ask you to confirm that you want to update
    * Check that the file name shown is correct
    * 'y' to confirm/continue, 'n' to abort
    * The update process takes about 2 minutes and goes through several stages.
    * ***Important*** You must leave your C64/128 powered up during the update
      * *Interrupting this process could render your TeensyROM unusable*
    * When the update completes successfully, your computer will reset and the new version of TeensyROM will be shown
    * If there are any problems, take note of any messages shown before pressing any key to return to the main menu.

### **Directly using TeensyROM via Ethernet connection**
  * Digitalman uses a similar approach in [this video](https://www.youtube.com/watch?v=PGRFLHmw0hY)
  * Connect active Ethernet cable to TeensyROM
    * An inserted SD card (preferred) or USB Thumb drive is also required
  * Open CCGMS from the main menu and type "atbrowse"
  * There are two sites hosting TeensyROM firmware updates, use one of the default bookmarks to enter either of them
    * Bookmark #1 is for the TinyWeb64 site, entering "b1" will take you to sensoriumembedded.com/tinyweb64
    * Bookmark #2 is for Digitalman's site, so "b2" to go to digitalman.azurewebsites.net
    * Alternatively the 'U' command will also work: "u sensoriumembedded.com/tinyweb64"
  * From the main menu, the Firmware download section is link #6 on TinyWeb64 and link #5 on Digitalman's site
  * Choose the link # for the FW version you want to download/install
    * The FW file will take a minute or two to download, dots shown on screen to indicate progress
  * Use the "d" command to see the local downloaded files directory.
  * Choose the link # of the firmware .hex file downloaded in the previous step to directly launch the update.
    * Check the version and confirm as described in the section above.

### **Using the TeensyLoader application** (requires computer with USB connection)
  * Get the .hex file of the latest released version [from the releases page](https://github.com/SensoriumEmbedded/TeensyROM/releases/latest)
  * Download and install the [Teensyduino/TeensyLoader app](https://www.pjrc.com/teensy/td_download.html)
    * Teensyduino requires Arduino to run, which works fine.
    * Alternatively, the Teensyloader stand alone file can be downloaded via a link further down the page
  * Launch the Teensyloader/teensyduino app (teensy.exe)
  * Select File, Open HEX File and select the saved TeensyROM .hex file
  * Connect the TeensyROM to your computer with a USB A to microB cable.
  * Plug the TeensyROM into your C64/128 and power it up to the main menu
  * Press the white button on the Teensy module itself, as shown in the app
    * If TeensyROM is in its case, a straightened paperclip through the small access hole reaches the button — no need to open the case
  * The process only takes a few seconds to complete
    * ***Important*** You must leave your C64/128 powered up during the update
      * This is electrically safe by design — the C64 just won't be usable again until the update finishes
  * You should see the app process through erasing and programming before your C64/128 reboots with the new version

### **Building your own firmware** (for custom builds/code)
  * See the [Software build document](/Source/BuildInfo.md): `npm run build:tr` / `build:tr-plus` builds the full firmware, and `npm run flash -- --hex <file>` writes it, or any release .hex, over USB, refusing a file built for the other board

## Troubleshooting

### Commodore C64 Ultimate
  * Check settings to be sure no other devices (such as a SID/UtiliSID or ACIA/Swiftlink mapping) are using the IO1 ($DE00) location. Some CRTs emulated by the TR can use the IO2 ($DF00) range as well.
  * Set `Cartridge Preference` to `External` and `Bus Operation Mode` to `Writes` (in C64 and Cartridge Settings). Required for TR+ DMA features and safe for any TR. See [C64 Ultimate Enhancements](C64_Ultimate_Enhancements.md)

### Resetting EEPROM Contents
  * To set *all* EEPROM values back to default settings:
    * With C64 off, press and hold down menu button on the TeensyROM
    * Power up the C64 (nothing will be displayed)
    * Keep TR menu button pressed for ~10 sec, until the LED starts blinking
    * Release the TR Menu button and wait for the TR menu to be displayed
    * TR EEPROM settings are now reset to default   

### Additional help
  * For additional support, please consider joining the [TeensyROM Discord](https://discord.gg/ubSAb74S5U)
  * Or contact Travis directly via [e-mail](mailto:travis@sensoriumembedded.com).
  
<br>

[Back to main ReadMe](/README.md)
