SensoriumEmbedded/TeensyROM/docs/MIDI_Usage.md

# TeensyROM USB MIDI Usage

MIDI/ASID control options:
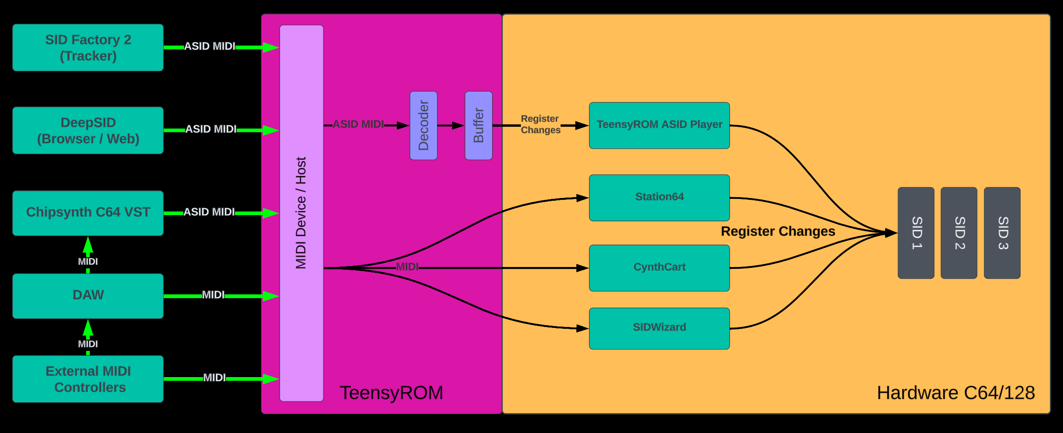
[picture p65: media/MIDI-ASID paths.png]
Control Options

Diagram by [**MetalHexx**](https://github.com/MetalHexx)
<BR>
<BR>

### Sending MIDI from a MIDI/USB controller such as a keyboard, drum pad, [Sax](https://www.akaipro.com/ewi-usb), or [M8 tracker/sequencer](https://dirtywave.com/) to your C64
  * Connect USB cable from a MIDI Keyboard/Controller device to the USB Type A Host port on the TeensyROM board.
    * Note: If your MIDI controller has a 5-pin DIN connector instead of USB, you can use an adapter such as [this link](https://www.amazon.ca/USB-OUT-MIDI-Cable-Converter/dp/B077X7R74Y?th=1).
  * Select MIDI device to emulate
    * **Note: If using the ***built-in*** CynthCart, Station64, SID-Wizard, ASID Player, or MIDI2SID app**, the correct IO is already associated, **you can skip this step.**
    * Prior to running a MIDI program, go to the settings menu (F8), then press "2" for the TeensyROM General settings page
    * Under "Special IO:", select your preferred "MIDI:*" device by cycling through the options.
    * The following MIDI cartridges can be emulated/selected:
      * Sequential, Datel/Siel, Passport/Sentech, Namesoft
    * All use $DExx address space and IRQ for interrupts
  * Select/load a MIDI capable application on your C64 to receive the MIDI data from your controller
    * For multi-SID systems (or C64u/U64) Cynthcart can utilize 2 SIDs (6 independent voices).  
      * To do this, set the second SID address to $DF00 and choose the 6CHAN sounds mode or press "="
      * See full Cynthcart documentation [here](https://www.qotile.net/files/cynthcart2.0.pdf).
  * Play around and have fun!
  * MIDI out (C64 to MIDI Device) is also implemented so that keyboards, etc with their own sound capability can be "played" by the C64
  * Some C64 sequencer apps require the 6840 timer chip in Passport/Namesoft, which is not currently emulated.

### Streaming MIDI/SID data/sounds/music directly to your C64/128 from a modern computer
  **Full control of your C64's SID chip remotely using the ASID MIDI protocol**
  * See the **[ASID Player document](/docs/ASID_Player.md)**

  **Playing .MIDI/.MID files on your C64 from a computer**
  * **C64/128 Setup**
    * Connect USB cable from a MIDI Host/computer to the USB Type B Micro Device port on the Teensy module.
    * Power up C64/128 to TeensyROM main menu.
    * Select Cynthcart+Datel MIDI or Station64+Passport MIDI to play the MIDI data
      * Select a polyphonic voice profile to get as many independent notes as possible.
    * The built-in MIDI2SID can be used as well
      * Can be helpful in seeing/hearing independent notes and seeing any voice overflows
      * No other MIDI special HW emulation required
  * **PC Instructions using Cakewalk by BandLab.**
    * Other DAWs/Players may work similarly.  If you find another good one, please let me know
    * Download/Install from here: https://www.bandlab.com/products/cakewalk
      * No need to activate/purchase unless you otherwise desire
    * In Cakewalk, press "p" or select Edit/Preferences to enter the preferences window
      * Select MIDI/Devices
        * Check your TeensyROM under the "Outputs" section, and click OK
          * Shown as "TeensyROM-xxxxxxxx" with the unique ID of its Teensy, so more than one TeensyROM can be connected and each driven from its own track.
      * Select Project/MIDI
        * Uncheck "Zero Controllers when play stops" under Other Options
      * Click OK to close Preferences window
    * Load a .mid/.midi file and play it
      * Remember that there are only 3 voices in the SID, so complex midi files with more simultaneous notes/voices won't sound right.
    * The playback should be emanating from your C64/128!

### MIDI Source setup
  * As with the original MIDI devices that the TeensyROM emulates, by default all MIDI tokens/packets received are passed through to the C64 and the software running there. That software (ie Cynthcart or Station 64) can be sensitive to the type and density of commands received and potentially overflow their buffer/interrupt handler and crash.   It may be necessary in these cases to filter out unnecessary data from the stream, such as indicated with the Cakewalk "Zero Controllers" example above.  Most sources/DAWs have the capability to filter out this extra/unused information.
  * Alternatively, TeensyROM can filter unwanted MIDI message types itself: go to the settings menu (F8), press "5" for the MIDI Message Filters page, and toggle off any of the 12 supported message types to stop them from being passed through to the C64. Settings are saved to EEPROM.

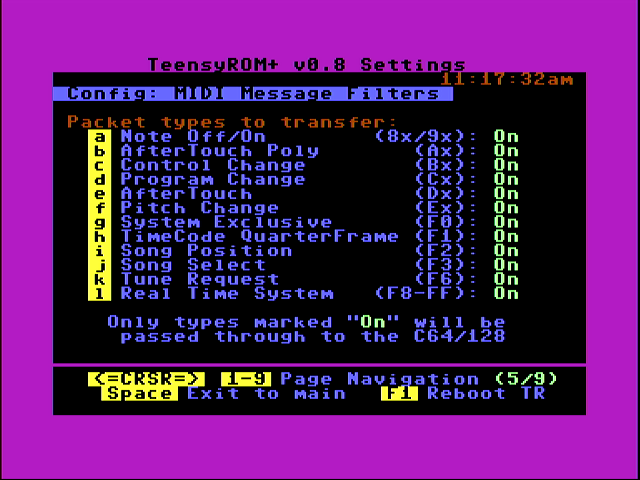
[picture p66: media/Screen captures/TR+/help-settings-info/settings5-MIDIFilters.png]
MIDI Filter screen capture


<br>

[Back to main ReadMe](/README.md)
