SensoriumEmbedded/TeensyROM/3D_Print_Case/3D-Printed-Case-ReadMe.md

# Thank you to the TeensyROM community for these case designs!

## v0.4 PCB (TR+) case design

### "Exposed" Low profile Design by [0ldSkull](https://www.0ldskull-retro.com/)
  * Original TR+ design and print by 0ldSkull available with the purchase of a new TeensyROM+
  * TR remix design for TR+ by Paul Harker available at [Printables](https://www.printables.com/model/1771461-teensyrom-v04-exposed-case)

|case back|case rear| 
|:--:|:--:|

## v0.2/0.3 PCB (TR) case designs

### "Exposed" Low profile Design by [0ldSkull](https://www.0ldskull-retro.com/)
  * Models available on [Printables](https://www.printables.com/model/1090478-teensyrom-exposed-case)
  * Complete units available at [0ldSkull's Store](https://www.0ldskull-retro.com/)

|case back|case rear| 
|:--:|:--:|

### "Classic" Design by [Stefan Wessels](https://github.com/StewBC)
  * V2 (**Latest**)
    * [Models available here](/3D_Print_Case/TeensyROM-Case-V2-04.zip) See README.txt inside zip file
    * Screw hole accommodation for v0.2c-0.3 PCB
      * Use M2.5x15mm screw [such as this](https://www.amazon.com/dp/B01M0DCMHQ)
    * Version included for v0.2b PCB (No Hole/screw)
  * V1 ([Archived](/3D_Print_Case/Archive/v1/))
    * Vented and minimalist top mods by [MetalHexx](https://github.com/MetalHexx)
  * Based on [C64 Cartridge Case Standard](https://www.thingiverse.com/thing:3932024) by lutzbellmann

|case back|case rear| 
|:--:|:--:|
