SensoriumEmbedded/TeensyROM/docs/Architecture/Build-System.md

# Build System

Two independent toolchains, run in a fixed order. Canonical instructions (prefer these over this doc for exact commands/paths): [Source/BuildInfo.md](/Source/BuildInfo.md) and [Source/C64/README.md](/Source/C64/README.md) for the C64 side; for the Teensy side, `npm run build:tr` / `npm run build:tr-plus` (see [Dual-boot linking](#dual-boot-linking-toolsbuild-firmwaremjs) below).

Step by step (which command to run when, the options, flashing boards over USB, recovering from a failure): the build skill, [.claude/skills/teensyrom-build/SKILL.md](/.claude/skills/teensyrom-build/SKILL.md). It is plain Markdown, readable without Claude Code.

## Build order (matters)

1. **C64 side first** — `npm run build:c64` (`tools/build-c64.mjs`, optionally `--project <name>`) assembles all 6502 sources and writes the generated headers into `Source/Teensy/TRMenuFiles/ROMs/`.
2. **Teensy firmware second** — Arduino IDE / arduino-cli build, which embeds those headers as compiled-in byte arrays.

Skipping step 1 after a C64-side change means the Teensy build silently uses stale menu/settings/utility code. The firmware build does not check, but CI does for every project but `TRCustomBasicCommands`, which KickAssembler builds and CI installs no JRE for: `tools/build-c64.test.mjs` reassembles the rest and byte-compares the result against the committed headers.

## C64 side

- Toolchain: ACME cross-assembler 0.97 (all sub-projects except `TRCustomBasicCommands`, which uses KickAssembler + Java JRE 1.8)
- `tools/lib/bin2header.mjs` (a Node port of bin2header) converts each `.prg`/`.bin` to a C header; `node tools/bin2header.mjs` does the same for a single file
- What gets built is the manifest `tools/c64-projects.json`; tools are found via `ACME` / `KICKASS_JAR` / `JAVA_HOME`, then `PATH`, then a pinned, checksummed download into `tools/.cache/` (ACME on Windows/macOS, KickAssembler everywhere; Java is never downloaded). Nothing is edited per machine.
- See [C64-Software.md](C64-Software.md) for the sub-project list

## Teensy side

- Arduino IDE 2.x + Teensyduino, board "Teensy 4.1", Optimize "Faster", CPU Speed "600 MHz", USB Type "Serial + MIDI" (for `MinimalBoot.ino` too, which `#error`s otherwise: both images must present the same USB device, so a board passing through MinimalBoot keeps its COM and MIDI ports) — useful for interactive single-image dev/debug builds and direct IDE upload.
- **Known-bad toolchain version: Teensyduino 1.62.0** — its GCC 15.2.1 bump (from 11.3.1) causes intermittent SD-read stalls with 2 PSRAM chips installed. Current pinned/recommended version is **1.61.0** (as of FW 0.8, 2026-08-02). Root cause confirmed to be the toolchain, not TeensyROM source — do not "fix" this by changing source code.
- Alternative: generate a `.hex` and flash via SD/USB drive instead of direct IDE upload (needed since the Teensy USB power trace is severed during assembly, and TR must be C64-powered to program directly)

## Dual-boot linking (`tools/build-firmware.mjs`)

The canonical way to produce a shippable, combined `TeensyROM(+)_<ver>_full.hex` — containing the full firmware and the MinimalBoot image (see [Teensy-Firmware.md](Teensy-Firmware.md#minimalboot-vs-full-firmware) for why MinimalBoot exists) — is the zero-dependency Node builder at `tools/build-firmware.mjs`, run via `npm run build:tr` (plain TeensyROM) or `npm run build:tr-plus` (TeensyROM+). This is what `.github/workflows/build.yml` runs on every push and tag. It downloads a version-pinned, SHA256-checked `arduino-cli` if not already on `PATH`, builds MinimalBoot, builds the main image, and combines them into one hex. For `--target tr-plus` it also builds the stock extension host and writes it beside the hex as `TeensyROM+_<ver>_VMBoot.TRH`, the package the menu installs — never into the hex, which holds no host on either target (CI checks both). `--skip-extension-build` builds the hex alone. Does **not** flash automatically — use Teensy Loader, or flash via SD/USB drive, afterward.

The program in the extension slot is not fixed. `--host-sketch <dir>` overlays that directory's files onto the MinimalBoot sketch in place of `Source/Teensy/VMBoot` — which is how the stock host is built too, so a third-party host is the same build with a different top-level `.ino`. `Source/Teensy/ExampleHost` is a complete one (`npm run build:example-host`), and [Extension-Hosts.md](Extension-Hosts.md) covers what a host owes the loader. A `--host-sketch` build compiles that host and nothing else, and writes `TeensyROM+_<ver>_<sketch-dir>.TRH`: no firmware hex, because a host is installed onto a board running the stock firmware rather than shipped inside a firmware of its own. Pointed at `Source/Teensy/VMBoot` it rebuilds just the stock host. `--host-code-kib 96`, accepted only with `--host-sketch`, raises the host's ITCM code ceiling from the default 64 KiB to 96 KiB. `--skip-combine` stops before packaging as well, leaving the host image in the kept build root and no `.TRH`. The flag is refused where there is no extension slot to build into (`--target tr`, `--no-extensions`, `--skip-extension-build`) rather than ignored: a flag that silently did nothing there would leave the caller holding the stock host, or nothing, under their own host's name.

Guardrail worth knowing about: before building a plain TR image, the builder checks `Fab04FeatureCtl.h` for an active `#define Fab04_Features` and, by default, throws rather than continue — this exists specifically to prevent accidentally building a TR+ image mislabeled as plain TR. Comment out the define yourself, build `--target tr-plus` instead, or pass `--yes` to have the builder comment it out and continue (no interactive y/N prompt, unlike the old PowerShell script — this has to be decided up front on the command line). In the same spirit, the builder refuses an argument it does not recognise, and refuses a known option given twice, rather than ignoring either: `npm run <script> -- <arg>` appends your arguments *after* the script's own, so `npm run build:tr-plus -- --target tr` would otherwise have built tr-plus and exited 0. Call `node tools/build-firmware.mjs` directly when you need to set an option the npm script already sets. A `--no-extensions` TR+ writes `TeensyROM+_<ver>_noext_full.hex`, not the shipping name — it is a different image, and sharing a name let one be published as the other.

Special builds are told apart from a release on the version string, never on `TRVersion` itself (which names the release hex and the browser's User-Agent). `--tag <name>` appends `-<name>` to the version in every image — `TeensyROM+ v0.9-pr65` on the C64 banner, in the serial version reply and in the SwiftLink `ATI` answer — and to the output names (`TeensyROM+_0.9-pr65_full.hex`, `TeensyROM+_0.9-pr65_VMBoot.TRH`); a tag is letters, digits, `.` and `-`, capped by the C64's 40-column banner row (24 characters for v0.9 on a TR+). A tree with uncommitted edits to the image sources (`Source/` and the linker files, with the `Fab04FeatureCtl.h` toggle left out) needs no flag: the version ends in `*`, the names in `-dirty`, and the build date is the build's own time rather than the commit's, so two local iterations are told apart while a clean-tree build stays byte-reproducible. The rules are in `tools/lib/build-tag.mjs`; the firmware's side is `TRVersionSuffix` in `Common_Defs.h`, which the builder sets as a quoted define. The banner row itself is composed on the Teensy (`MakeBannerRow` in `IOH_TeensyROM.c`, serial strings `rsstBanner*` in `Menu_Regs.h`): the version string and the page's word (` Settings`, ` Help`, ` Test`) centered in 40 columns, the word left off when the version alone fills the row, so the C64 programs print the row as it comes and pad nothing themselves. A release build, from a clean tree with no `--tag`, carries none of this.

Every image the builder compiles gets `-DFNET_CFG_TLS=0` appended to `build.flags.defs` — MinimalBoot and the main image, plus the extension host image on `--target tr-plus`. FNET defaults that to 2 (`fnet_user_config.h` in the installed Teensy core, behind an `#ifndef`), which links mbedTLS — SSL state machine, X.509 parser, bignum, test certificates — into MinimalBoot and the main image, costing roughly 210 K of flash in each. The flag compiles out NativeEthernet's TLS API along with it, server side included (`EthernetServer(port, tls)`, `begin(port, tls)`, `setSRVCert`/`setSRVKey`), so restoring TLS means dropping the flag rather than changing a call. After linking, the builder re-reads the image with `nm` and fails the build if an mbedTLS symbol came back. The flag lives in the builder, so an Arduino IDE build of the same tree still links mbedTLS and comes out correspondingly larger.

The same `nm` pass also fails the MinimalBoot and main images if they link a newlib routine that costs RAM1 for something the firmware can do itself: `sscanf` (which brings strtod and ~27 KB of JIS character tables into DTCM), `strtod`/`atof`, and the libm functions with lookup tables (`pow`, `exp`, `log`, their `f` versions). Teensy 4 keeps `.rodata` in DTCM and default-placed code in ITCM, so each one shrinks free-for-locals or ITCM padding with no other symptom; removing `sscanf` and `pow` gave the TR+ main image 32 KB more free-for-locals and 17 KB more padding. The list, with what each symbol means, is `tools/lib/heavy-libc.mjs`. The extension image is not checked, since a third-party host may use these in its own RAM, and an Arduino IDE build skips the check.

`--ccache` (macOS/Linux, with `ccache` on `PATH`) sends compiles through ccache. Add it after `--` when going through npm, e.g. `npm run build:tr -- --ccache`. CI builds TR and TR+ as parallel jobs with this on, and turns it off for `Release_v*` and `Beta_v*` tags so published hex files always come from a clean compile. With it on, the build works in a fixed `run-ccache-<target>` directory that each run clears, instead of a new `run-XXXX` one. The directory path is part of ccache's cache key, so a new name every run would never hit the cache.

Pinned versions: arduino-cli (`tools/lib/toolchain.mjs`), the Teensy core (the workflows, `tools/build-firmware.mjs`, and the Teensyduino version stated in `Source/BuildInfo.md`, this doc and `CONTRIBUTING.md`) and the CRC32 library (the workflows and `Source/BuildInfo.md`). `tools/check-pins.mjs` lists every one of these places and fails if they disagree, so a bump has to update them all. Dependabot can't see these pins, so `.github/workflows/check-pins.yml` runs that check weekly and also compares the pins with the latest releases. It keeps an issue open while there are updates, or fails the run when the repo has Issues turned off. A release you've decided against, like Teensy core 1.62.0, goes in that dependency's `rejected` list with the reason, so it stops being reported.

<br>

[Back to Architecture Overview](Overview.md)
