SensoriumEmbedded/TeensyROM/media/Screen captures/TR+/tests/ExpansionPortTest.png

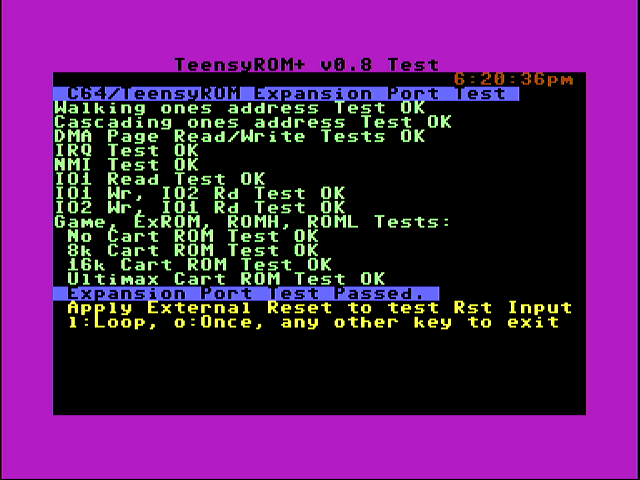
media/Screen captures/TR+/tests/ExpansionPortTest.png
