SensoriumEmbedded/TeensyROM/media/Screen captures/TR+/tests/ExternalPortsTest1.png

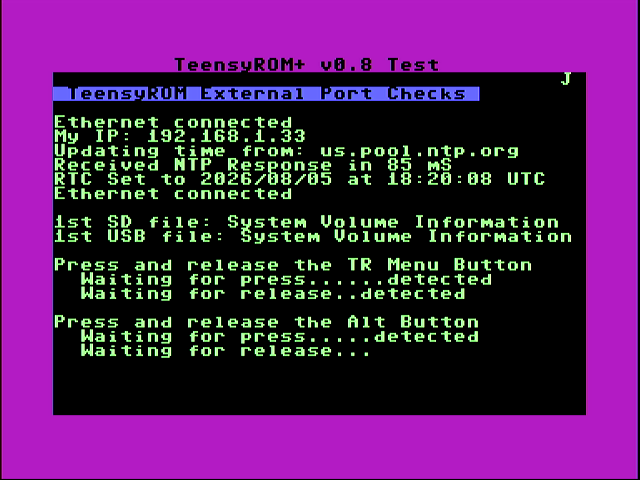
media/Screen captures/TR+/tests/ExternalPortsTest1.png
