SensoriumEmbedded/TeensyROM/media/Screen captures/TR+/tests/ExternalPortsTest2.png

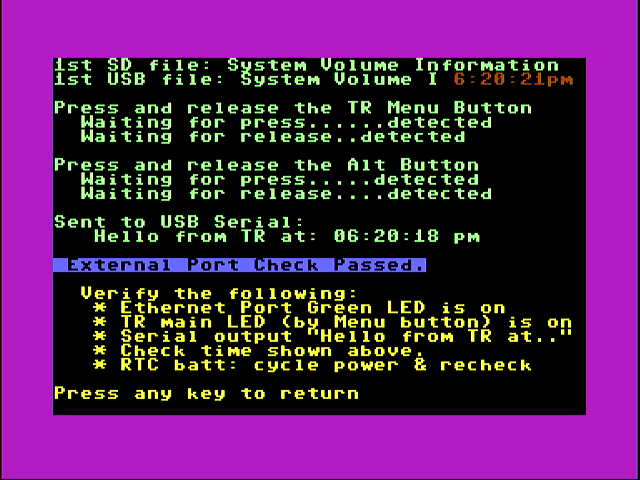
media/Screen captures/TR+/tests/ExternalPortsTest2.png
