SensoriumEmbedded/TeensyROM/bin/TeensyROM/FW_Release_History.md

# FW Release Version history:

## Dual FW releases
The TR+ (PCB v0.4) has architectural differences that warrant a different binary build than the original TR (PCB v0.2–0.3).  
The original TR will continue to be supported, with separate .hex file releases.

 * "+" in TR+ FW name, banner/title and serial boot-up messaging
 * Distinct FW file names
   * TR (PCB v0.2–0.3) example: **TeensyROM_0.7.2_full.hex**
   * TR+ (PCB v0.4)    example: **TeensyROM+_0.7.2_full.hex**
 * Safeguards in place to prevent loading FW on the wrong HW version via the normal menu-based TR FW update method.
   * If loading via the Teensy Loader program, take care to load only the correct version for your hardware.

## FW 0.8 Release 2026/08/05
 * Note: EEPROM settings will be reset to defaults with this FW update.

### Updates for both TR and TR+
 * **Settings and Help screens rewritten as separate programs**
   * Still accessed via F8 and F7 from main menu
   * Allowed expansion of both for more information and additional settings
     * Settings and info span 9 pages, on-screen help expanded to 2 pages
     * **MIDI Message Filter addition**: Gate any of 12 MIDI message types. Settings persisted to EEPROM.
       * Used for some DAWs and MIDI controllers that send extra/unnecessary packets that overwhelm some C64 software such as Cynthcart.
     * **New Info pages** show Hot Key settings, Ethernet, TeensyROM and C64 machine info
     * Time Format/Real Time Clock, Startup Options, Menu Colors, KERNAL, REU, and more.
   * Main menu binary size reduced by 40% by offloading Help and Setup pages
     * Allows more space for large/conflicting SID files, such as **Rush – YYZ**, which has now returned to SID cover tunes dir :)
 * **New TR BASIC Command: TISET**
   * Sets the BASIC TI/TI$ variables to the TeensyROM RTC setting
 * Segment/Dot Matrix Digital Clock program by Steven Hardison added to TR Utils directory.  Slightly modified to set current C64 time from TR RTC.
   * Thank you for the program/permission Steven!
 * New **TR External Port test** added to `TeensyROM Specific` directory:
   * Verifies Ethernet, USB Host/Device, and SD port connections
     * Requires Ethernet connection and SD Card+USB Stick with at least 1 file on each.
   * Also confirms button input(s), RTC, and LEDs
 * Show unique Teensy ID on startup serial, General Info Settings, and on Version Info Remote Command.  See [ControlComms.md](https://github.com/SensoriumEmbedded/TeensyROM/blob/main/docs/ControlComms.md)  for details.

### Updates for TR+ only
 * **KERNAL Replace capability:** load a custom KERNAL ROM image at runtime
   * `<Shift-K>` from the SD/USB file browser selects a KERNAL image, path is stored in EEPROM
   * Select KERNAL replacement as the Special IO in settings
   * F2 "Exit to BASIC" or run a PRG directly to invoke the new KERNAL.
 * **New remote DMA commands** `WriteC64Mem` and `ReadC64Mem` for direct remote DMA read/write of C64 memory via Serial or Ethernet. 
   * Supported by the [c64cast](https://github.com/kfox/c64cast) project, stream video and more through your C64!
   * Thank you [KFox](https://github.com/kfox) for the great project, interaction, and feedback!
 * **REU image Pre-load and save**
   * Select .REU file (or use `<Shift-R>`) to assign REU pre-load file.
   * While the REU Special IO is running, the alt button can be used to save REU contents to SD/USB.   
     * Never overwrites existing, appends filename with incrementing unique sequential number. Default filename is "SD:/reu.reu".
 * **Action Replay** support added — new freezer cartridge support alongside Super Snapshot V5
 * **New TR+ C64 Expansion Port Test** diagnostic suite added to `TeensyROM Specific` directory
   * Covers all expansion port signals: DMA, bi-directional address/data bus, R/W, BA, IO1/IO2 read/write, IRQ, NMI, and all cart control signals (ROMH/ROML/GAME/EXROM)
   * Walking Ones and Cascading Ones address bus tests
   * Looping/counting capability for longer burn-in style testing.
   * Every signal is individually toggled to help pinpoint a miswired or faulty connection
 * **New Alternate Button actions**, selectable in General Settings (active when the button *isn't* being used by a freezer cart or REU):
   * Select from the following options:
     * AutoLaunch (default):  Immediately launch the selected Autolaunch file.  
     * Pause/Unp: Pause/unpause the C64/128 system
     * Others: TR Menu, Reboot TR, None
   * Thanks to @Boris Schneider-Johne for the brainstorming!
 * DMA state machine improvement for reliable asynchronous DMA start on read/write, bad line, or continuous read.

### Infrastructure, bug fixes, and Housekeeping updates (TR and TR+)
 * NFC: PN532 library now included locally (trimmed and warning-cleaned) instead of pulled from an external dependency
 * Bug fix: occasional delayed reset resolved by watching for a button hold during the serial message wait/timeout
 * `Build-DualBoot.ps1` updates: warns (with an option to auto-fix) if `Fab04_Features` is left defined in code while building plain TR, prints the detected Teensy core path, and reports total build time
 * Misc compiler warning fixes (array-bounds, bin2header, free() cast)
 * `MaxPathLength` reduced from 300 to 256 chars and EEPROM map reorganized to free up space
 * Bug fix: D64/71/81 extracted file length was rounding up to end of sector
 * Now allowing wrap-around ($FFFF to $0000) PRG loading. 
 * JiffyDOS detection changed from a startup-text scan to a unique JD vector-table check
   * Thank you @LessPaul for this suggestion and the wrap-around find!
 * Updated C build environment to latest: Teensyduino 1.62 and Arduino 2.3.10
 * C64 assembly code build process improvement:
   * Centralized tooling paths so each sub-project doesn't have to be edited separately.
   * Created a BuildAllC64.bat file to build all 10+ sub-projects from one file.
   * Halt on error throughout to make sure nothing is missed

### Documentation additions/updates since last release
 * New document outlining the [C64 assembly code build setup/process](https://github.com/SensoriumEmbedded/TeensyROM/blob/main/Source/C64/README.md).
 * RTC [battery addition instructions for TR Fab 0.2/0.3](https://github.com/SensoriumEmbedded/TeensyROM/blob/main/docs/RTC_Battery_Addition.md) are now available (previously noted as "coming soon" in the 0.7.2 release)
 * TR Remote control protocol documentation: [ControlComms.md](https://github.com/SensoriumEmbedded/TeensyROM/blob/main/docs/ControlComms.md)
 * **TeensyROM+ (PCB v0.4) added features** [are documented here](https://github.com/SensoriumEmbedded/TeensyROM/blob/main/docs/TR+NewFeatures.md)
 * [Commodore C64 Ultimate Enhancements](https://github.com/SensoriumEmbedded/TeensyROM/blob/main/docs/C64_Ultimate_Enhancements.md), how the TR augments the C64U

## FW 0.7.2 Release 2026/04/20

### Updates for both TR and TR+
 * Note that EEPROM settings will be reset to defaults with this FW update.
   * Extra EEPROM space is now reserved for future use to reduce forced EEPROM resets later
 * New "Featured SIDs" directory and menu background SID
   * Be sure to check out these great tunes!
   * Thank you to @Avrilcadabra, @DivertigO, LukHash, and @tubesockor for your support and permission.
 * MIDI support for polling mode (with IRQ disabled)
 * Updated bundled SID-Wizard/SID-Wizard_2SID/SID-Wizard User Manual from V1.92 to V1.94
 * "BASIC with TR Command IO access" menu item for low-level access to TeensyROM IO Commands
 * C128 cold boot improvement (thanks for the ID/testing @Jamie!)
 * Updated to TeensyDuino 1.60.0
 * **Real Time Clock (RTC)** addition
   * Utilizes Teensy's RTC for all C64 time syncs   
   * CR1225 battery holder on back of TR+ for persistent time memory
   * A battery can be added to Fab 0.2/0.3 TR to enable this capability
     * **Instructions comming soon!**
   * "Sync time with Ethernet" operations changed to "Sync RTC...".
     * C64 Time always synced to RTC on menu start
     * Ethernet sync is no longer needed after one sync with a battery installed
   * Default time zone changed to UTC+0 (GMT)
   * NTP Packet timeout increased from 1.5 to 2.5 seconds
 
### Updates for TR+ only
 * **External Reset detect:** If reset is done externally (ie C64U reset button, WOPR button, any other custom/external reset button) you'll see the same action as when pressing the TR menu button. 
 * **New "Alt" button** 
   * Super Snapshot V5 CRT support (PAL or NTSC versions).
   * When not used by SSv5, it performs freeze/unfreeze when pressed, LED will flash when frozen. 
 * **512K REU implementation** initially for C64 only
   * Enable "REU" as the "Special IO" in settings menu to engage before running programs requiring it.
   * REU-Checker v1.0 & CMD 1750/1750XL REU Test added to TR Mem Test+Diags Menu
   * Hot Key #2 changed from Station64 to REU-Checker v1.0
 * Single #define for all Fab 0.4 features (Fab04_Features) in new file (Fab04FeatureCtl.h)
   * Build scripts also updated to build both TR and TR+ without editing Fab04FeatureCtl.h
     * Previous TR only .bat and .sh scripts deprecated, PowerShell scripts cover all
 * Bus Snoop updated to count data bus reads and writes

## 0.7.1 Release 2026/02/02
* **Support for Persistent TCP Connections via remote control listenner by @hExx**
  * Updates for TCP/Ethernet use with the [TeensyROM Web](https://github.com/MetalHexx/TeensyROM-Web) application
  * Improves performance for time sensitive operations like SID speed changes, and avoids race conditions. 
  * Listen port moved to 2112 (We will assume control)
  * Move EthernetClient declaration inside FeatTCPListen conditional
  * Increase buffer size in CopyFile function for improved file copy efficiency
  * Handle read errors in SendFileData function with appropriate logging and failure response
  * Rewrite SendFileData to work reliably on both Serial and Ethernet.
    * Updated to handle TCP backpressure gracefully, now uses chunked writes and progress-based timeout (2s) 
  * MinimalCheckToken to return the FW mode that is currently loaded
  * All changes applied to Minimal Boot FW as well as main
  * External App Control via TCP section added to [Ethernet Docs](/docs/Ethernet_Usage.md)
  * **All these items contributed by @hExx, thank you so much!**
* **Now checks at main menu launch for TOD clock functionality, force NTSC/60 if it fails.**
  * Avoids bootup "hang" on C64/128 systems where TOD clock is no working correctly
    * Have seen failures due to issues with 9vac source, blown fuse, TTL conversion circuit, and CIAs themselves.  Feature is used for time display, but not by many other programs.
  * New Assy language CIA1/2 TOD Clock Check added to /Test+Diags directory of Teensy Mem
* **Meatloaf transfer/Mount/Launch feature**
  * With a single key press ('M'): transfer, mount, and launch a Dxx file on a [Meatloaf](https://github.com/idolpx/meatloaf) device attached to the USB host port of the TeensyROM.
  * Dedicated TeensyROM screen to show status.
* **Reuse dot_clk input as externel reset input on rev 0.2x TR PCBs**
  * See instructions to cut trace and add jumer wire then build with DbgSignalSenseReset in TeensyROM.h and Min_TeensyROM.h
  * Allows TeensyROM to get back into menu when an external reset is fired via the C64
  * **Contributed by @niclashoyer, thank you!**
* **New Tool: Dual Boot Compile/Combine PowerShell script by @hExx**
  * Compile full dual boot TeensyROM FW .hex file with a single script.
  * (Since replaced by the Node-based `npm run build:tr` / `build:tr-plus`, see [Build-System.md](/docs/Architecture/Build-System.md).)
* **Bug fixes:**
  * Number of hyperlinks per web browser page was artificially limited to 9 in v0.7.
    * Thanks for the catch @DigitalMan
  * Menu clock in 24 hour mode can mess up background SID playback in the second half of the day.
  * Auto launch set could've been impacted by random NFC tag

## 0.7 Release 2025/12/04
* Note: EEPROM Settings will reset with this FW update
* New Remote Command/Control Options:
  * All remote commands now available via these interfaces (in addition to USB Device port)
    * Ethernet (TCP) Listener Interface
      * Supported by updated [TR Win App](https://github.com/SensoriumEmbedded/TRWinApp)
      * TCP Listening option in settings
      * Implemented in full and minimal builds
    * USB-A Host port communication
      * Supported by new [TRControl](https://github.com/SensoriumEmbedded/TeensyROMControl) library
        * Use with any USB enabled microcontroller (ie Arduino, RPi, etc)
      * "NFC Enabled" settings item changed to "Host Ser Dev".  Selects from "None", "NFC", or "TRCont"
  * Added ability to remote launch TeensyROM Flash based programs and read directory
  * NDJSON support option for remote dir listing
* RetroMate v1.02 (Games Menu), adds 1351 proportional mouse support (@stefanwessels)
* "SNKvsCapcom Stronger Edition" support:
  * Updated Magic Desk 2 to CRT HW ID #85, 79 still remains as well
  * Bank Swap cache increased to 16 blocks 
  * Swap data sent to USB Serial for monitoring
* Programmable Hot Keys 1-5, set with !-% when target is highlighted
  * Defaults same as previously hard coded
  * !-% (shift 1-5) to set hot key to to highlighted file on TR, SD, or USB
  * Hot key paths stored in EEPROM for persistence
  * Thanks for the prompt @the1Domo @mrc333777 @Richard @William Manganaro @Niclas @Divertigo @Avrilcadabra
* Swiftlink improvements for q-link compatibility:
  * Tx interrupt capability 
  * Corrected Swiftlink reset via status write
* NFC Re-launch tag algo: 
  * Re-launch of normal/non-random card is blocked until another card is used or menu button pressed.
  * Does allow re-launch of "random" tags (after 1 sec of no tag present).  
  * Thank you! @borisschneiderjohne @jochwat68 @0ldskull 
* Show/Hide File Extension option (default hidden) 
  * Shows regardless for unknown types and directories
  * Thank you! @parkamonster
* If selected filetype is unknown assume it's a PRG and attempt to launch (@idolpx)
* Ethernet Init and Time synch verbosity improvements
  * Displays info to screen from settings menu (time synch), on startup (if synch/listener enabled), or from terminal ATC.
* RW Read Delay option removed, using 135nS for all (has been default)
* DMA pause unique timing for system pause (During !BA) vs large CRT bank switching (immediate after IOW)
* Increased max files per dir from 3000 to 4000

### 0.6.8 Release 2025/07/25
* Swiftlink/Turbo-232 speed & compatibility improvements
  * New baud rate control implementation
    * Swiftlink baud rate control supports up to 38Kbps
    * New Turbo-232 register added to allow speeds up to 230Kbps!
  * Supported and tested with [**C64OS**](https://c64os.com/c64os/) 
    * [v1.08 beta now available](https://www.c64os.com/c64os/beta)
    * Thank you to @Greg Nacu for all your guidance/support/feedback!
  * Simple Swiftlink Terminal (SST) addition
    * Stripped down Swift/Turbo interface to demonstrate high speed polling or interrupt based receiving
    * Not feature rich, but very fast.  Try a connection using polling at 230k baud.  :)
    * [Source code included](https://github.com/SensoriumEmbedded/TeensyROM/tree/main/Source/C64/SimpSwiftTerm/source) for developer reference and incorporation into other C64 apps.
  * Other improvements
    * Flow Control: RTS and Transmitter Ctl via Command Reg
    * Polling mode and interrupt Improvements
      * Polling allow fast data receiving without the overhead & timing requirements of an interrupt/handler
    * Proper "chip reset" on write to status reg
    * Fix: clear receive buffer and drop any current client connection on Swift/Turbo startup
      * Issue  introduced in FW 0.6.7, Thank you @Stefan
    * NMI Timeout increased from 300->7000uS for slow NMI handlers
    * Non-AT command just returns "error" instead of "AT not found"
    * Special IO name changed to "Swift-Turbo/Modem"
    * Turbo232 CRT type detection
    * Debug build options to force baud, spy registers, etc via USB Serial
* TR Main Menu additions
  * Retromate Internet Chess (Games dir)
    * Play Chess on-line against bots or other players
    * Written for the TeensyROM utilizing the high speed polling Turbo-232 interface
    * Thank you @Stefan Wessels for your incredible contribution!
      * Email: swessels@email.com
      * Source on GitHub: https://github.com/StewBC/retromate
  * 2SID version of SID Wizard and SW User Manual (MIDI_ASID dir)
    * Thank you to Hermit for these great programs and for allowing this inclusion in the TR!
    * Also @Voynich for the suggestion
  * Super Simple Terminal (Utilities dir)
    * See description above  
  * LOAD"*",8,1 and RUN  (Utilities dir)
    * Handy for quick run/load from IEC drive/emulator, if connected
    * Can choose this for autolaunch to immediately launch into floppy based program on system power-up.
* File type support additions
  * Magic Desk 2  .CRT support
    * Uses DMA pause feature for large (2MB) file size
    * Comparatively new CRT format, [documented here.](https://github.com/crystalct/MagicDesk2)
    * Required for ["SNK vs CAPCOM - Stronger Edition"](https://www.youtube.com/watch?v=dNT9yBsi1Dk)
  * .NFO and .MD files now viewable as text 
    * Thank you @hExx for the recommendation.
* Other fixes
  * Auto-Set Special IO to None when enabling NFC in settings menu to avoid conflict/slowdown
  * Exit to BASIC (F2) didn't always include "Special IO" selected handler, fixed
  * Check for for 1-3 character extensions, not just 3
  * Teensyduino environment updated to 1.60b4
    
### 0.6.7 Release 2025/06/14
* Note: EEPROM settings will be reset with this FW version (color settings added)
* TeensyROM UI Customizable color scheme
  * Color setting page addition/features:
    * 'C' (capital C) from any Directory Menu to enter page
    * Choose any of the 16 available colors for 7 different color parameters.
    * 6 presets available, or create your own scheme
  * Color scheme saved in TR EEPROM for recollection  after power down/reboot
  * Some general color consolidation/standardization so all are customizable
* Very Large CRT file support: (Beta)
  * Example files in this category "A Pig Quest", "Eye of the Beholder" and "SNK vs Capcom"
  * CRT Files >850Kb employ a bank swapping from SD card (only) mechanism
    * First 850Kb stored in TR RAM as usual, remainder are marked for swapping
    * Uses the DMA signal to halt the CPU for ~3mS during an un-cached bank swap.
      * No actual DMA (bus mastering) takes place
    * Swaps are fast and typically only take place during "scene changes" in games.
      * Should be imperceptible to user experience.
  * 8ea 8K bank RAM cache with lookup to re-use already cached banks without pausing
  * Uses "old school" REU type of DMA assertion for fast pausing and no additional CPU execution
    * Not reliable on some systems (Most C128s and a low percentage of NTSC systems)
    * DMA Pause check utility included in Test+Diags dir to test specific system DMA reliability
      * Written in BASIC with test hooks in TR BASIC commands IO Handler
  * Many large CRT files have been tested with this scheme, all are working smoothly (as long as host C64 passes DMA check)
  * File sizes of <850KB continue to work as they do today, all served directly out of RAM.
  * See full CRT implementation details [here](https://github.com/SensoriumEmbedded/TeensyROM/blob/main/docs/CRT_Implementation.md).
  * Thank yous:
    * @Boris Schneider-Johne for the general idea behind this capability, very much appreciate the brainstorming!
    * @DigitalMan, @Hexx, @William Manganaro, and @JTHonn for the testing and feedback!
* ASID Player: (rev to 1.3)
  * New ASID packet types decoding/application:
    * Write Order: Ability to customize the order in which regs are written to the SID
      * 'w' to Stop Forced Reg Write Order
    * Framerate: Expected Vid, Speed Mult, Buffering requested, Frame Delta uS
      * Parameters printed to screen, Frame rate applied to buffer/timer.
    * Expected SID types: Chip index & chip type printed to screen
    * Thank you @tubesockor for the new packet specification, SFII builds, and general guidance/reviews!
      * Tested with SID Factory II advance build, supporting release comming soon.
  * 2nd/3rd SID address defaults from $d420/$d440 to $df00/None (for commonality with Cynthcart 2nd SID address)
  * Fix: Start/Stop Message Tokens used incorrect addressing
* Serial/Remote interface:
  * GetDirectoryCommand now checks for directory existence and returns error codes for specific issues.
  * GetFileCommand now checks for storage availability and returns error codes for specific issues.  
  * Fix: Remote CopyFile() now properly overwrites instead of appending.
    * Thank you @Hexx for these updates/pushes
  * 'v' version check available in minimal mode (as well as normal)
  * Print name of remote launched file/path to USB serial
  * Remote tokens to control DMA system pause via USB serial
  * Remote token to set TR UI colors remotely
* Swiftlink compatibility updates:
  * Improved compatibility with the Hayes Modem standard and [**C64OS**](https://c64os.com/c64os/)
    * Thank you to @Greg Nacu for all your guidance/support/feedback!
    * TR can now be used for C64OS Networking beginning w/ C64OS v1.08
  * AT Command updates/additions:
    * ATEx  Turn Echo on/off (1/0)
    * ATVx  Verbose mode on/off (1/0)
      * impacts response codes for all commands (keywords vs numeric) 
        * also text suppression for atdt, atc, ate, and atv commands
    * ATI  Host Info: "TeensyROM" and "Firmware v<version #>"
    * ATDT<Server><:Port>
      * Ethernet init here instead of on SwiftLink startup
      * Allow quotes before/after server name or port
    * ATZ  (soft reset) restores echo and verbose mode, regardless of argument
    * ATH  (Hook) Dummy function to return OK, +++ command already disconnects
    * AT? help list update
    * All AT commands now use standard response codes when complete
      * Key word or Number depending on Verbose setting
        * Key words sent as upper case ASCII (aka lower case PETSCII)
      * Followed by a single carriage return
  * Hardware handshaking
    * Status register DCD (Carrier Detect) bit now readable for connect status
* SID Player:
  * Fix: Correctly initialize timer for multi-speed (2x/4x/6x/8x) SIDs
    * Thank you @DivertigO for the find and testing
  * Fix: Corrected row# for set background SID "Done" message
* TR BASIC Commands:
  * Allow TLOAD to non-$0801 locations
    * Will error if conflict with TR BASIC Ext code ($c000-d000)
  * Thank you @RMR for the find and fix
* General
  * CIA TimeOfDay clock check BASIC program added to TR Test+Diags directory
  * Build option to force NTSC & skip auto check (DbgForceNTSC)
  * Build option in assy prints init status on TR menu/CRT start (DbgVerbose)
  * IO1 check now in CRT, but only if DbgVerbose enabled
  * Debug and Swiftlink messages indicated at startup when enabled

### 0.6.6 Release 2025/02/15
* SID File Player updates
  * Individual voice muting during SID file playback!
    * Voice 1/2/3 mute status/control on SID Info page
    * Thank you @Avrilcadabra for the idea, testing, **and implementation methodology** 
  * Fine control and percentage based display for SID speed changes
    * Log or Linear control options, display to 0.01%
  * Capability to remote control individual SID voice muting and play speed.
    * Thank you @hExx for the testing and forthcoming **TeensyROM UI implementation.**
* New Feature: Text and PETSCII file viewer
  * Directly open .TXT (ASCII) or .SEQ (PETSCII) files for viewing
  * Navigate through pages/files, customize colors
  * 15 sample text/PETSCII files added to new main menu sub-dir
    * Includes text viewer Usage/instructions doc
  * Thanks to @William Manganaro for the suggestion/testing
* 24 hour clock display option
  * 12/24 hour display selectable in Settings Menu
  * Setting saved in EEPROM, stays persistent.
    * Note: This FW will reset EEPROM to defaults 
  * Thank you for the idea: @Lefty
* Other updates
  * Auto launch selection key changed from shift-return to 'A' (shift-a)

### 0.6.5 Release 2025/01/20
* NFC Loading System updates:
  * Support for **"Mifare Classic 1k"** NFC tags
    * No pre-formatting required, usable as received.
    * Tags of this type are often included with NFC reader module purchases
    * As with "Ultralight" (NTAG213/215/216) tags, "Classic 1k" tags can be written from a phone or the TeensyROM itself
  * Bug Fix: Reset tag re-use timer *after* launch in case random dir takes a long time
    * Random tags occasionally caused repeated random load/run loop.
    * Thanks @Falcon for the find/testing
* Program (PRG) loader and BASIC filesystem
  * Setting current device number to 8 so that file browsers will point at IEC for dir read, etc
  * Load function key vector if JiffyDOS KERNAL is present
  * Main menu /Utilities directory updates/additions:
    * "Exit to BASIC" for NFC taggable method to enter BASIC
    * "TeensyROM Menu Cart..." for NFC taggable method to enter TR menu
  * Thank you to @Boris Schneider-Johne for all the recommendations/support/testing on these items!
  
### 0.6.4 Release 2025/01/03
* NFC Loading System updates:
  * NFC Random selection from a specified directory:
    * "?" to write tag for random via currently selected directory (in TR, SD, or USB)
    * Recommend using random with directories containing <100 items. Function must load full directory to pick one at random, so large directories will take longer to pick/launch from.  
    * Thanks to @distressed74  @Avrilcadabra  @Makers Mashup  @AndyDavis @William Manganaro for the thoughts/feedback
  * Can now re-scan/launch same NFC tag as previously scanned, if it is away from the reader for >1 full second
    * Allowance to enable re-use of same "random" tag repeatedly
* MIDI/ASID updates:
  * Fix for SIDWizzard "Jam Mode" (tracker playback simultaneous w/ MIDI enabled/receiving)
    * No longer setting StatusIRQReq bit on MIDI out msgs
    * Thanks to @DivertigO for identifying/testing
  * New ASID commands parsed and parameters/values displayed (but not yet applied)
* Emulation/loading improvements:
  * GMod2 .CRT support (Bank switching only)
    * Thanks for the prompt @Mike351 and sorted CRT files @AmokPhaze101 
  * Clear cart signature from $8004 of RAM if present (Thanks Artur Rataj for the info/recommendation)
    * malicious setting written by some games (ie "Hero") that can stay resident and prevent restarts
* Autolaunch improvements for diagnostic use:
  * Autolaunch capability from SD file: /autolaunch.txt
    * Example autolaunch.txt file with instructions added to /docs directory
    * Takes priority over EEPROM set autolaunch, when enabled
    * This is a means to enable diagnostics autolaunch *without* a functional C64
  * Autolaunch now launches CRTs without booting to TR menu first
    * Allows diagnostics booting *without* full C64 functionality.
    * For example, can Autolaunch DesTestMax on a C64 with missing RAM chips!
  * Thanks for the ideas/input Factor of Matt (https://factorofmatt.com/)
* Bus Snoop (new feature):
  * Serial 'b' command to snoop bus (Addr, Data, R/nW) to insure all bits toggle (Debug tool)
    * Monitors 100,000 bus cycles and reads the Address & Data bus to log the state of each bit and sends a summary out the USB Serial port.  
    * This will help identify "stuck bits" on the bus, a failure that won't allow any thing to run/display, and is hard to narrow down without an oscilloscope and a block of time.
  * In the future, this feature can grow into a detailed bus analyzer with buffer/filters, or monitor the bus for SID writes to do visualizations and other SID logging/recording. Lots of possibilities...
* HW Fab 0.3 preparation
  * Disallow FW downgrade below this version for Fab 0.3 PCBs
  * Determines HW Fab # based on Dot-Clk read routine
* Timing/compatibility improvement:
  * New timing param: nS_VICDHold (365nS Default), separated out from nS_DataHold (non-VIC cycle)
  * nS_DataHold (non-vic hold) increased from 365 to 390nS
    * To accommodate Mega65 and Reloaded Mk II by default without special FW needed
    * Lots of validation testing done to ensure cross compatibility.  Thanks for all the help @DigitalMan
  * RW Ready Delay on by default in EEPROM (this FW resets EEPROM to defaults)
* Aesthetic/information only:
  * Bottom of settings menu changed to git URL from Travis/Sensorium
  * C64 Splash screen updated to 2025
  * Deprecated old Form based Win App
  * Removed #define nfcScanner (now permanent part of build)
  * Doc/help screen updates for NFC random tag

### 0.6.3_Mega65 special Release 2024/12/04
* Special FW release for Mega65 machines running the C64 Core
  * Also fine for other machines, please communicate if any issues found

### 0.6.3 Release 2024/12/02
* ASID Player updates:
  * Framework for new ASID packets: Reg Write Order/timing, Control/Framerate, and SID Types
  * ASID Player Frame timer select T/t for up/down list
* Bug Fix:  C64 Clock was running slow in 50Hz regions
* Built-in menu file updates:
  * Additions:
    * DesTestMAX:  Desmond's RAM Test added to test/diag menu 
      * with permission from Matt matt@factorofmatt.com
    * SID-Wizard V1.92 + Sequential MIDI
    * Jupiter Lander (Cracked version)
  * Removed YYZ from menu, conflicts w/ TR app as of 0.6.2 (will be back)
  * File re-arrangement, MIDI/ASID programs in sub-dir
* Hot keys 1-5 updated to new path/locations
* fBusSnoop hook in ISR for future bus snooping functions
* Support for future PCB revision: Data buffer dir control via pin28, fixes UltiMax on C128
* Serial command updates:
  * 'v' serial command for checking FW Ver, build date, temp, free mem
  * 'f' cmd (debug) Shows number of menu files

### 0.6.2 Release 2024/10/06
* New feature: *Custom BASIC Commands*
  * Communicate with/though your TeensyROM from new BASIC language commands
  * TSAVE, TLOAD, TDIR, TPUT, TGET, plus many other commands available from C64 BASIC
  * See [BASIC commands usage document](https://github.com/SensoriumEmbedded/TeensyROM/blob/main/docs/Custom_BASIC_Commands.md) for details
  * Demo video available [here.](https://youtu.be/5qShZjLOG5s)
  * Thank you to @hExx and @Avrilcadabra for the brainstorming!
* New feature: *Selectable Auto-Launch on startup*
  * Allows launch of any file/program on power-up
    * Great for diagnostics execution and headless opperation
  * Shift-Return sets Auto-Launch to currently highlighted file
    * File can be from any source (SD/USB/TR)
  * Disable from settings menu
  * After auto-boot, menu button to return to main menu.
  * Hold reset on power-up to skip (until LED comes on)
  * Thank you to @misterfox and @Avricadabra for the recommendation!
* ASID player improvements:
  * New feature: *Individual voice muting (1/2/3)*
    * Voice # group red when muted
    * Allows user to hear individual voices to "disect" ASID input
    * Thank you to @Avricadabra for the idea
  * Bit bucket reg to send Ctl Reg of muted voices
  * SID address up *or down* via function keys F1/F2, F3/F4, F5/F6
* Documentation updates:
  * Help screen: added left arrow, shift-ret, and 1-4
  * ASID player [usage doc](https://github.com/SensoriumEmbedded/TeensyROM/blob/main/docs/ASID_Player.md)
  * [BASIC commands usage document](https://github.com/SensoriumEmbedded/TeensyROM/blob/main/docs/Custom_BASIC_Commands.md)
* Other fixes/improvements:
  * Doing full BASIC init before PRG launch
    * Previous partial init caused some programs to launch incorrectly (Thanks to @Mad for identifying)
  * File access on boot improvements:
    * USBFileSystemWait to make sure USB is on line before accessing on boot
    * SDFullInit retries SD.begin if media presence detected
  * Start TOD clock earlier in startup seq in case of remote/auto launch
  * Fix row number to print "Done" for Set main background SID
  * No longer printing all screen messages to serial (unless Debug flag is set)
  * ASM build batch files updated to add "PROGMEM" via custom bin2header.py
  * Note: EEPROM setting will reset with this update

### 0.6.1 Release 2024/09/16
* ASID Player usage documentation created, [available here](https://github.com/SensoriumEmbedded/TeensyROM/blob/main/docs/ASID_Player.md)
* ASID player updates (v1.1)
  * Added customized character set  to make indicators round, bar graph characters, and dot for zero value on spinners
  * Beta feature added:  Frame timer to re-time ASID playback for timing improvement
    * Usage documented in ASID Player doc linked above
    * Commands added to enable/disable timer and set buffer size
    * Micro timing adjustments of no more than 1uS per 12 frames to keep buffer primed but not overflowed
    * Buffer fill level displayed on screen
    * 50Hz 1x and Auto modes selectable
      * In auto mode, the playback interval will be measured at beginning and used as a seed time for the rest of the playback.
        * This method works fairly well, but is dependent on USB packet intervals which are occasionally a bit off (thus the need for the timer). 
        * In the future, DeepSID (and perhaps others) will provide a "recipe" packet to specify the exact interval and eliminate the need to time the packets and improve seed accuracy.
          * DeepSID uses Web MIDI, which appears to have the worst jitter. SID Factory II, ASIDXP, and SIDPlay are *much* better
        * 1x and 2x speed SIDs (PAL or NTSC) play reliably, 4x usually has a couple small packet errors during the full song, but typically not audibly detectable.  
        * Above 4x and other asynchronous formats don't do well with the frame timer. Leave it "off" for these
      * 50Hz 1x mode works best for SIDs of that speed and seed the timer with an exact value regardless of timed value
    * Thank you to @hExx, @Avrilcadabra, @tubesockor, @iZero, and @Slaygon for you testing/feedback/ideas around this feature!
* MIDI2SID Freq calc corrected for PAL/NTSC 
  * Based on system typed detected
  * Thank you @Avrilcadabra for the prompt

### 0.6 Release 2024/07/10
* New feature: Dual boot w/ minimal image
  * ***Increases max CRT file size from 626k to 875k (40% increase)***
    * ~40 known games in this range, such as Briley Witch 
  * Automatically launches minimal boot image when a file in this range is selected
  * Return to main menu by pushing the button on the TeensyROM
  * Build instructions created for full dual-boot hex file creation
  * limitations
    * Files of this size load from SD card only
    * NFC disabled while loaded, push button to return/re-enable
  * Thanks to @DigitalMan for the prompts on this!
* SID sub-tune navigation capability
  * +/- for next/prev on SID summary page
    * Displays song # and # songs
  * SID starts on sub-song identified in SID header
  * Serial command for setting remotely
  * Thanks to @hExx, @Avrilcadabra, and @DivertigO for the prompts!

### 0.5.16 sub-release 2024/07/03
* MIDI/ASID updates
  * Hosted MIDI Device changed to "BigBuffer" model
    * Now supports DirtyWave m8 tracker/sequencer
  * Added $d500 and $d600 to available SID addresses in ASID player
* General optimization
  * NFC poling auto-paused during Swiftlink, MIDI, and ASID operations
    * Avoids slow-down of these features when NFC is enabled 
    * NFC (if enabled) will not respond when these apps are running
      * Use button to return to main menu and resume NFC poling/usage

### 0.5.15 sub-release 2024/05/24
* New feature: Integrated high performance ASID Player
  * TeensyROM specific implementation to accelerate data streaming and ASID packet decoding
    * No dropouts or slowdowns due to decoding limitations
  * Smoothly stream data from ChipSynthC64, DeepSID, or other ASID sources.
  * Play streams with up to 3 SIDs played simultaneously
    * Individually selectable address for each SID on system
  * Displays text messages embedded in ASID data  
  * Enter via main TeensyROM menu, or use Hot key '4' to enter immediately.
  * Easy to use interface
    * Real time indicators for Each SID and SID1 individual register writes
      * Decoder screen shows description of each register indicator
    * Help screen shows all available keyboard commands
    * Screen enable option for maximum noise reduction
    * Mute playback capability
* New feature: .D64, .D71, and .D81 file type support
  * Single file load only, multi-load not supported.
* TeensyROM UI support
  * GoodSIDToken send via serial on succesful SID load
  * File open for writing retry in GetFileStream (by [**MetalHexx**](https://github.com/MetalHexx))
* Other additions/fixes
  * .OCP and .PIC graphic file viewer support (Art Studio files, used by OneLoad64)
  * MIDI2SID PRG source code added to repo
  * Fix: 3 main menu filenames changed for NFC tag path compatibility
  * Fix: Current file path retained on menu restart when loading default SID from SD/USB

### 0.5.14 sub-release 2024/03/28
* New feature: Selectable default/background SID
  * Select/play any SID normally, then 's' from SID Info screen (F6) to set it as default background SID
    * Selection stored in EEPROM for future boot recollection
  * SID can be TR built-in or from SD/USB
    * If file not present on boot, loads "Sleep Dirt" from TR
  * Feature requested by: ][avok
* NFC Loading System Updates:
  * Added ability create/read NFC tags for built-in TeensyROM files (in addition to SD/USB)
    * Uses TR: path prefix to designate
  * Feature requested by: Richard
* New feature: Hot Keys to launch some programs
  * Available from any main "Src:" menu screen:
    * '1': Cynthcart
    * '2': Station64
    * '3': CCGMS
  * Feature requested by: Niclashoyer
* General updates
  * "Also sprach Zarathustra" and "When I'm 64" added to TR built-in SIDs
  * F4 in Setting menu toggles SID playback (same as 'j')
  * Fixed race condition when starting Cynthcart in PAL mode with NFC enabled.
  * Note: All EEPROM settings will be reset with this update

### 0.5.13 sub-release 2024/03/06
* NFC Loading System Updates:
  * Tag write improvements:
    * Prompt to remove nfc tag after writing to prevent auto-execute
    * General messaging clarification
    * Checks card type to reject Mifare Classic
    * Always re-init and clear last UID after write operation
    * Retries on tag verification read before write
  * NFC re-initialized (if enabled) on menu button press
    * Easier way to force init than power cycle, also insures reader stays in synch
    * Note: If NFC is enabled but not attached to USB, power-up and button pushes will be slow to respond
  * Check for "C64" at start of path and remove if path not present.  
    * Keeps compatibility with TapTo w/ System ID
  
### 0.5.12 sub-release 2024/02/23
* New feature: NFC Loading System!
  * Use NFC tags to instantly launch you CRTs/PRGs/SIDs/etc.
  * Write new tags right from your C64
  * See documentation [here](/docs/NFC_Loader.md).
  * A huge thank you to [**StatMat**](https://github.com/Stat-Mat) for sharing his vision and support
  * Thanks also to the TapTo project for the inspiration! 
* General updates
  * Skipping RAM test at boot for faster boot and reduced screen garbage time.
    * As used in the OneLoad64 collection, code provided by [**StatMat**](https://github.com/Stat-Mat)
  * EEPROM setting reset to defaults
    * Hold menu button for 10 seconds until LED starts flashing
    * Upon release, setting will be reset and TeensyROM is rebooted
  * Settings Menu 
    * "Reboot TeensyROM" option to apply changed defaults without power-cycle
    * "NFC Enabled" to enable attached NFC reader
    * "RW Ready Dly" to improve Hi-ROM game graphics on Reloaded MKII and C64c
      * Thanks to **alterationx10** for the testing!
    * Free RAM now displayed to indicate max CRT file size
  * YYZ.sid edited to *not* zero out time registers on SID init
    * Thank you to **][avok** for reporting this issue
* Remote Launch UI support updates
  * Readback game preview file additions by [**MetalHexx**](https://github.com/MetalHexx)

### 0.5.11 sub-release 2024/02/06
* New feature: Picture viewer
  * Koala multi-color and Art Studio Hi-res files viewable/supported
  * File Extension association:
    * .kla, .koa:  Koala multi-color
    * .art, .aas, .hpi: Art Studio Hi-Res
  * Compatible with output from [Retropixels online](https://www.micheldebree.nl/retropixels/)
    * Create a C64 viewable file from any source format:
      * Drag source picture in to Retropixels site
      * Adjust picture parameters & types
      * Save as Koala Painter or Art Studio
      * Transfer to TeensyROM SD or USB and select to view
  * Commands available while viewing:
    * '+' & '-' to view next/prev picture in directory
    * CRSR Up/Dn to change border color (+multicolor background)
    * Any other key to exit viewer
  * Added /Pictures dir to Main TR Menu w/ 16 sample pics
* Swiftlink/Browser updates:
  * Entity References now detected/parsed
    * \&gt; ('>') and \&nbsp; (' ') implemented
    * Other ERs ignored for now
  * HTML tag \<tr> = return added
* Remote Launch support updates
  * BadSIDToken sent on SID load error
* General/Housekeeping:
  * Updated nS_DataHold time from 350 to 365 to accommodate Reloaded MK2 board
    * Thanks to **alterationx10** for the testing!
  * Timing control via serial improvement (Dbg_SerTimChg)
  * Removed 2 redundant pic .prgs (Fractal/Emb Head)

### 0.5.10 sub-release 2024/01/13
* SID Player updates:
  * SID conflict check range reduced to $6000-70ff, set on compile
    * ~1000 additional SIDs now playable
  * RSID and Play address 0 support 
    * ~1300 additional SIDs now playable
  * About 90% of ~57k known SIDs now playable
  * Check for conflicts with IO1 space
  * Show play address on load screen
  * Show addr range, init addr, play addr, and clock type on SID info page    
  * Added YYZ (Rush) to SID Covers local menu
* Remote Launch updates from MetalHexx
  * CopyFileCommand and DeleteFileCommand via USB Serial
* Swiftlink/Browser updates:
  * Expanded/detailed to browser local help menu (? command)
* System Timezone update
  * Timezone UTC offset resolution now 30 minutes (VK5LN Michael recommendation)
  * hour offset range is -12.0 to +14.0  step 0.5
  * TZ will need adjusting from previous value after this update
* Housekeeping:
  * New IO1 regs: rwRegCodeStartPage, rwRegCodeLastPage (set on TR app start)
  * IO1 reg re-organization and size reduction
  * MIDI2SID recompile for reg change

### 0.5.9 sub-release 2023/12/27
* SID Player updates:
  * SID info page added
    * Shows current SID file info: Filename, Name, Author, Released, Clock
    * Current Machine info: PAL/NTSC and Time of Day clk frequency
    * Settings: 
      * CRSR keys: Adjust playback Speed
      * d: Set default playback speed
      * F4: Toggle SID On/Off
      * b: Border effect On/Off
  * Default playback speeds (based on machine and SID info) dialed in with oscilloscope
* Main menu changes:
  * F6 changed to Show SID info (was Settings menu)
  * F8 changed to Settings menu (was MIDI2SID)
  * Help screen (still F7) updated to reflect key changes
  * MIDI2SID app moved to stand-alone PRG in Multimedia directory

### 0.5.8 sub-release 2023/12/13
* Swiftlink/Browser updates: ([Web Browser Usage](/docs/Browser_Usage.md) is updated)
  * 'd' command to list download directory contents
    * Select Link # to launch directly from browser
  * Overwrite option/prompt if requested download filename exists
  * Bookmark option 'bu' to list bookmark names w/ URLs
  * 'br# [name]' command added to rename bookmarks
  * Include Downloaded file links in history and bookmarks
  * "Digitalman TeensyROM Demo" link added as bookmark #2
  * Mem mgt improvements for direct launch
* Remote Launch updates:
  * Remote command/file/dir enhancements from [**MetalHexx**](https://github.com/MetalHexx)
    * To support new Remote Command GUI, in development by MetalHexx
  * Launch with forced reset ability added
    * enables remote launch at any time or launch from another app
* "SID Cover Tunes" directory and Files added to main TR menu

### 0.5.7 sub-release 2023/11/21
* Remote Launch updates:
  * Command to Remotely pause/unpause SID playback
  * IRQ command incorporated to protect from false IRQs

### 0.5.6 sub-release 2023/11/19
* New feature: Remote Launch
  * Ability to launch stored files remotely via USB connection 
    * includes SID playback, PRGs, CRTs, etc 
  * Works with updated Win App (0.4 just released)
    * Look for massively improved v2 Win App from hExx in the future :)
  
* Swiftlink
  * Bug fix: wasn't sending 0s in normal mode (corrupted xmodem downloads)
  * Browser mode minor html tag tweaks
  
### 0.5.5 sub-release 2023/11/12
* Swiftlink/Browser updates:
  * Port selection available for host or ip address (host:port/path)
  * Char count for pause Improvements
  * command summary all lower case to make readable in upper/gfx mode
  * Force lower case for Browser command list

### 0.5.4 sub-release 2023/11/8
* Note: This FW release resets stored EEPROM settings to defaults
* Swiftlink/Browser updates:
  * Bookmark favorite sites for quick access later.
  * Previously visited sites saved in a browsing queue
  * Download files directly to specified path on USB or SD 
  * TinyWeb premier, downloads and <petscii %9b> type tags

### 0.5.3 sub-release 2023/10/16
* Swiftlink updates:
  * ATBROWSE command to enter Browser mode from teminal program such as CCGMS
  * Links enumerated per page
  * www.frogfind.com filterring all pages/searches
  * PETSCII conversion improvement
  * Browser Mode Commands implemented
    * S <Term>: Web Search
    * U <URL>: Go to URL
    * #1-9: Jump to link #
    * Return: Continue when paused
    * X: Exit Browser mode

* SID Player
  * Compensate for non-standard SID load address

### 0.5.2 sub-release 2023/10/10
* SID Player
  * Determining Vid standard (NTSC/PAL) and mains freq (50/60Hz) on start
  * Changed SID play interrupt from raster to timer based
  * '+' and '-' to change SID speed from main Menu
  * Playback speed set based on SID and Machine type
  * stopped border color tweak for now since IRQ is not raster
  * Banking out BASIC and KERNAL during SID play and init
  * check for SID/TR mem conflict (eventually enable TR code relocation)
  * SID file type association/selectability

* Swiftlink updates:
  * ATSEARCH command initial implementation (more to come)
  * Using www.frogfind.com to get search results

* Arhitecture/General:
  * Changed back to 8k cart from 16k for main menu
  * Changed C64 RAM location from $2400 to $6000
  * Loading SID from Flash after main app startup instead of transfer from cart
  * Removed USB Host menu since file x-fer is direct to USB/SD
  * Menu tweak: F7 for help instead of Space
  * Removed IO1 regs rRegStrAddrLo/Hi, just get from stream
  * First Self modifying code (smc) for smcSIDPlay and smcSIDInit

### 0.5.1 sub-release 2023/10/1
* MIDI CC messaging now passthrough/absolute instead of relative/calculated
* Enabled USB MIDI Device In messages: 
  * ControlChange, ProgramChange, and PitchChange
* Revamped Windows File Transfer app support (see [WinApp Release History](../WinApp/WinApp_Release_History.md))

## 0.5: built 2023/09/17
* Main UI  improvements:
  * Many ROMs added to main menu (with room for more)
  * 1 level sub-dirs from TR Mem menu
  * Cursor based navigation/selection
  * Joystick 2 menu control: Joystick speed in Settings/EEPROM
  * Display parent dir Path at top
  * Display page number and num pages in Menu/directory
  * alphabetize the directory list   
  * Home key for top of current directory
  * Search in dir for first letter a-z
  * Up arrow for up directory
  * Associate special IO HW with Teensy mem menu items: '+' next to type on TR Mem Menu
  * Longer file names and directory sizes
  * Messaging added for load/xfer/parse opperations
  * Settings menu re-do
  * Help Menu added, space to access   Fx options live in Help Menu
    
* New File/type support:
  * .P00: now supported
  * .CRT: added support for the following types: EasyFlash, Magic Desk, Ocean, Dinamic, Zaxxon/Super Zaxxon, Game System 3, SuperGames, FunPlay/PowerPlay
    * Note: max file size ~650MB, no EasyFlash eapi support

* Swiftlink/Ethernet improvements:
  * Modified built-in CCGMS to start with Swiftlink/38.4k by default
  * added "at?" to list all AT commands
  * upper or lower case accepted in ANSCII or Graphics modes
  * correct backspace handling

* MIDI improvements: 
  * disabled some unused usbDevMIDI(in) commands causing probs using Cakewalk with Sta64/Cynthcart

## 0.4: built 2023/07/29
* Enabled TeensyROM as a MIDI USB Device. 
  * USB MIDI Host is still present, can use both at the same time.
* Update TeensyROM Firmware from SD card or USB Drive. 

## 0.3: built 2023/07/15
   
## 0.2: 2023/03/16
   
## 0.1: 2023/02/09
   
## Initial commit: 2023/01/11/23
