SensoriumEmbedded/TeensyROM/docs/Architecture/Known-Issues.md

# Known Issues / Deferred Work

Concrete, scoped findings surfaced during architecture walkthroughs — real issues with a known cause and (usually) a designed fix, deliberately queued rather than acted on immediately. Distinct from [Constraints.md](Constraints.md), which documents permanent rules; this file is a to-do list and should shrink as items get resolved (move resolved items out rather than leaving them marked done).

## Summary (updated 2026-10-03)

Detail for every item below is in its own full section further down — search this file for a distinctive word/name from the bullet to jump to it.

**Memory-safety bugs (buffer/stack overflow):**
- `nfcReadTagLaunch()` — 16KB `CleanLocalDirMenu[]` stack array, likely root cause of the documented NFC large-directory crash [HIGH PRIORITY]
- `Min_SerUSBIO.ino LaunchFile()` — overflows the `eepAdCrtBootName` EEPROM field into adjacent EEPROM, persists across reboot [HIGH PRIORITY]
- `sprintf`/`vsprintf`-into-fixed-buffer pattern — the instances found so far are fixed or assessed; full codebase sweep not yet done
- Debug-only `'y'` serial command — unbounded read into a 100-byte buffer (low priority, narrowly gated)
- `DownloadFile()` — writes an over-length HTTP chunk to disk before validating it against `Content-Length`

**RAM1 savings:**
- `FLASHMEM` audit — running list of main-context-only functions still RAM-resident; full-batch apply/measure/revert experiment already run once (clears ~17KB `padding`, doesn't by itself touch stack headroom — see `Constraints.md`), list itself still unapplied
- `hid3` (third `USBHIDParser` instance) — possibly unnecessary RAM cost, needs real-world-usage confirmation

**DMA timing:**
- A DMA transfer (a C64 REU transfer or a host write) can lose its first byte, more often next to another transfer; `tools/bench/reuspans.py` reproduces it

**Design/process gaps:**
- No consistent allocation-failure (OOM) policy across handlers — leaning REBOOT
- Full-firmware/MinimalBoot code duplication (`SendMsgPrintfln`, `EEPwrite*`/`EEPread*`, `LoadFile`/`ParseCRTHeader`/`ParseChipHeader`, `ServiceTCP`) — no shared translation units, already causing drift; noted as a standing reminder, not queued
- `LoadCRT()` root-level-file path bug duplicated in `MinimalBoot.ino` and `mpe/host/MinimalBoot.ino` (`mpe-vm-review` branch) — same class as the now-fixed `RemoteLaunch()` bug, but no live consequence found; low priority
- `SD.mediaPresent()`/`SDFullInit()` can't distinguish "card absent" from "`SD.begin()` never called" — full-firmware boot only calls `SD.begin()` on one gated path, skipped entirely on a reboot-to-full-firmware or minimal-recovery boot [DEFERRED]

**Fixed since last summary (2026-10-03, not open work — kept for context):**
- `InitHndlr_SuperSnapshotV5` / `SpecialBtn_SuperSnapshotV5` now `FLASHMEM`

**Fixed since last summary (2026-09-27, not open work — kept for context):**
- `nfcReadTagLaunch()`'s 256-byte `TagData` stack buffer — the page-read loop refuses a tag whose declared length would run the next 16-byte block past the buffer, and the two payload-offset walks and the "random launch" `strcat` are each bounded against how much was actually read (`CharNum`), not the tag's own claimed lengths
- `DriveDirPath` — `RemoteLaunch()` refuses a launch path that would not fit before touching any state, and `HandleExecution()`'s directory-descent `strcat`s go through `DriveDirPathRoomFor()`, which refuses (rather than truncates) an append that would overflow it
- `IOH_TR_BASIC.c`'s ISR-path `LSFileName`/`RAM_Image` writes — both stop at their buffer's end
- `LoadDxxDirectory()` — the track/sector walk stops after `MaxDxxDirSectors` (64) links and once `NumDrvDirMenuItems` reaches `MaxMenuItems`
- `GetCurrentFilePathName()` and `SetLatestSIDLoaded()` now report whether the path they built actually fit, and every caller that would otherwise store, mount, or write a cut-short path (hot keys, auto-launch, REU/KERNAL file selection, NFC tag writes, the background-SID record, Dxx mounting) refuses instead

**Fixed since last summary (2026-09-22, not open work — kept for context):**
- Unbounded `vsprintf` into `SerialStringBuf` — both message formatters and the minimal image's own copy now use `vsnprintf`, and the CRT "Name" field is read as `%.32s` so a name filling all 32 bytes cannot run off the 64-byte header buffer it sits at the end of
- `GetCurrentFilePathName()` builds the path inside the buffer size its caller passes, which also keeps the hot-key and auto-launch callers inside their `MaxPathLength` EEPROM slots
- `LatestSIDLoaded` is packed and read back inside the `MaxPathLength` block that holds it
- No message format is a variable any more — a filename read off the card used to reach `SendMsgPrintfln` as its format string
- `AT_DT()`'s 100-byte `Buf` is written with `snprintf`

**Fixed since last summary (2026-09-19, not open work — kept for context):**
- `CheckLaunchSDAuto()`'s DAT3 presence read had no settle delay after switching the pin's mode — added `delayMicroseconds(5)`, matching a reliability fix PJRC shipped upstream for the identical pattern

**Fixed since last summary (2026-08-14, not open work — kept for context):**
- `IOHandler[]` array / `enumIOHandlers` sync — `static_assert` added catching count mismatches
- `Menu_Regs.i`/`Menu_Regs.h` duplication — `Menu_Regs.i` now generated from `Menu_Regs.h` via `tools/lib/menu-regs.mjs` (formerly `gen_menu_regs_i.py`), run at the start of `npm run build:c64`; verified byte-identical `.prg` output against the old hand-written file
- `StatusFunction[]` split out of `IOH_TeensyROM.c` (1913 -> 886 lines) into new `StatusFunctions.c`; all 35 functions there (the 27 dispatched entries plus 8 exclusive helpers) now consistently marked `FLASHMEM`

**Low priority — style/consistency:**
- Inconsistent naming/abbreviation (`Hndlr` vs `Handler`, `Cnt`/`Count`/`Num`, inconsistent buffer names)
- Oversized functions (`HandleExecution()` ~265 lines)
- Commented-out code left unresolved with no explanation
- Open design questions living only in inline comments (e.g. `//need all 3?`)
- "Must stay in sync" relationships enforced by comment only where a compile-time check exists

**Accepted, no action needed:**
- `Serial.write()` inside `IO1Hndlr_TR_BASIC` — deliberate, developer-confirmed exception

**Flagged for re-check, not yet assessed:**
- MinimalBoot's Ethernet-disable gap during VIC-cycle emulation
- Large-CRT bank-swap DMA reliability claim may be stale

## HIGH PRIORITY: `nfcReadTagLaunch()` can overflow its 256-byte `TagData` stack buffer reading a malformed/corrupted NFC tag

**Where:** `Source/Teensy/nfcScan.ino:183-403`, `nfcReadTagLaunch()`.

More realistic trigger than most "corrupted file" scenarios already waved off this session: physical NFC tags degrade over time, and third-party tag-writing tools (part of the broader "TapTo" ecosystem this feature supports) can write tags that don't match TeensyROM's exact expectations — no adversarial intent needed, just an imperfect or aging tag.

The page-read loop (lines 192-252):
```c
uint8_t DataStart, messageLength, TagData[MaxPathLength];  // 256 bytes
uint16_t CharNum = 0;
while (MoreData)
{
   ...
   nfc.mifareclassic_ReadDataBlock(PageNum, TagData+CharNum);  // writes 16 bytes at TagData+CharNum, unbounded
   for(uint8_t Num = 0; Num<16; Num++)
   {
      if(TagData[CharNum] == 0xfe || CharNum >= DataStart+messageLength) MoreData = false;
      else CharNum++;
   }
   ...
}
```
`messageLength` is read directly from the tag's own data (one byte, so up to 255) and `DataStart` can be up to 7 — so the loop's own stopping condition, `CharNum >= DataStart+messageLength`, can itself reach 262, already past the 256-byte buffer. A tag with a large declared message length and no `0xfe` terminator before that point causes repeated 16-byte writes past the end of `TagData` — a real stack buffer overflow.

Telling contrast: `nfcWriteTag()` (same file, line 429-436) explicitly checks `if (messageLength>254) { ...; return; }` before writing anything — the write path was clearly designed with the 256-byte limit in mind. The read path wasn't given the equivalent treatment, suggesting this is an oversight rather than an accepted risk.

A second, smaller instance of the same gap: the "random launch" handling (line 391) does `strcat((char*)pDataStart, CleanLocalDirMenu[...]->Name)`, appending an arbitrary filename (FAT32, up to 255 chars) into whatever's left in the same `TagData` buffer, also with no bound check against remaining space.

**Fixed (2026-09-27):** the page-read loop now refuses before each 16-byte block if `CharNum + 16 >= sizeof TagData`; the two payload-offset walks (`pDataStart += 2 + ...`) each check the result stays within `TagData + CharNum` (what was actually read, not `messageLength`'s claim) before dereferencing it; and the "random launch" `strcat` is refused if the picked name would not fit in what remains of `TagData`. The 16KB `CleanLocalDirMenu[]` stack array below is a separate, still-open issue.

**Status:** fixed (2026-09-27).

## HIGH PRIORITY: `DriveDirPath` (256 bytes) has no length enforcement anywhere it's written, and two different normal-use paths can overflow it

**Where:** `DriveDirPath` is `char[MaxPathLength]` = **256 bytes** (`Teensy.ino:45`). Two independent, unrelated call sites write into it with no bound:

1. **`RemoteLaunch()`** — `Source/Teensy/RemoteControl.ino:198`, `strcpy(DriveDirPath, FileNamePath)`, fed by `SerUSBIO.ino`'s `LaunchFile()`/`ReceiveFileName()`. `LaunchFile()` (`SerUSBIO.ino:699`) declares `char FileNamePath[MaxNamePathLength]` (`MaxPathLength+MaxItemNameLength+2` = 358 bytes), and `ReceiveFileName()` correctly bounds its read loop to that 358-byte limit — so **a client is explicitly permitted, by the protocol's own declared limit, to send a path up to 357 characters** via the standard, documented `LaunchFileToken` command (see `docs/ControlComms.md`). `MaxNamePathLength` exists to accommodate path *plus* filename combined; `DriveDirPath` was apparently only ever sized for the path alone. Any path 257-357 characters — valid per the protocol layer — overflows `DriveDirPath` by up to 101 bytes. Triggerable by any client (third-party control apps included) sending an ordinary `LaunchFileToken`.
2. **`HandleExecution()`** — `Source/Teensy/DriveDirLoad.ino:65,74-75,105`, repeated `strcat(DriveDirPath, MenuSelCpy.Name)` as the user navigates directories on the menu. `MenuSelCpy.Name` is a real SD/USB filename/dirname (FAT32 allows up to 255 chars per component), and `DriveDirPath` **accumulates across successive directory selections** with no check at any point. This is triggerable through **completely ordinary menu browsing** on a real SD card with a few levels of descriptively-named folders — no crafted input, no external protocol, no corrupted file needed at all. Arguably the easier of the two to hit in practice.

Both point at the same underlying gap — nothing enforces `DriveDirPath`'s 256-byte limit at any write site — so a fix should address the buffer discipline generally rather than patching each call site individually.

**Fixed (2026-09-27):** `RemoteLaunch()` now refuses (`strlen(FileNamePath) >= MaxPathLength`) before touching any state if the incoming path can't fit, and builds the split in a local `LaunchDir[MaxPathLength]` that's only published to `DriveDirPath` once the launch actually goes ahead. `HandleExecution()`'s directory-descent `strcat`s (menu browsing, D64/D71/D81 mounting) each go through the new `DriveDirPathRoomFor()` helper, which refuses the append — rather than truncating it — if it would overflow.

**Status:** fixed (2026-09-27).

## Low priority: `LoadCRT()`'s root-level-file path split is duplicated (unfixed) in two more places

**Where:**
1. `Source/Teensy/MinimalBoot/MinimalBoot.ino`'s `LoadCRT()` (on `main`)
2. `mpe/host/MinimalBoot.ino`'s `LoadCRT()` (on the `mpe-vm-review` branch only, not yet merged — a verbatim copy of #1)

Same bug class as `RemoteControl.ino`'s `RemoteLaunch()`, which was fixed in commit `0997c5a066f87f8f6528ed3887684a80c5af17a9` (on `mpe-vm-review`, not yet merged to `main`): for a root-level file path (e.g. `/Foo.crt` — only one `/` in the string, at index 0), `strrchr` finds that leading slash, and the path/filename-split code does `*ptrFilename = 0;` right there — leaving `DriveDirPath` as an empty string instead of `"/"`. That breaks `PathIsRoot()` (`strlen(DriveDirPath)==1 && DriveDirPath[0]=='/'`) for anything reading it afterward. Both of these two are byte-for-byte identical to the pre-fix `RemoteLaunch()` code.

**Why low priority, unlike the original:** traced the actual reachable code and couldn't find a live consequence for either call path (confirmed by manual test on #1, 2026-09-08 — CRT loaded and played normally). After `LoadCRT()`, the only two things that read `DriveDirPath`/`PathIsRoot()` in MinimalBoot are `LoadFile()`'s `sprintf` (produces the identical correct path string either way, since `"" + "/" + Name` and `"/" + Name` are the same string — coincidence of the format already supplying the `/`) and `UpDirectory()`'s root guard (`StatusFunctions.c`, only reachable via the `IOH_TeensyROM` menu handler — which `LoadCRT()`'s single-CRT auto-launch never activates, since MinimalBoot has no interactive directory-browsing UI at all). The original `RemoteLaunch()` bug's real, reproduced consequence — a hot-keyed root-level VM `.crt` silently loading as an ordinary cartridge — came from a `DriveDirPath[0]` VM-registry guard added to the *full-firmware* `DriveDirLoad.ino`'s `HandleExecution()` on `mpe-vm-review`; `Min_DriveDirLoad.ino`'s `HandleExecution()` (what both of these two actually call) has no equivalent guard.

**Fix (when done):** same pattern as the already-applied fix — after the split, if `DriveDirPath[0]` comes up empty, restore it to `"/"` and re-point the filename pointer into the untouched source buffer (`FileNamePath + 1`) rather than the now-truncated `DriveDirPath`.

**Status:** deferred — low priority, no live consequence found, not yet fixed (2026-09-08).

## HIGH PRIORITY: `Min_SerUSBIO.ino`'s `LaunchFile()` can overflow the `eepAdCrtBootName` EEPROM field into adjacent EEPROM fields

**Where:** `Source/Teensy/MinimalBoot/Min_SerUSBIO.ino:244-279`, `LaunchFile()`.

The persistent-storage (EEPROM) variant of the same `MaxNamePathLength`-vs-`MaxPathLength` size mismatch as the `DriveDirPath` entry above:

```c
char FileNamePath[MaxNamePathLength];  // 358 bytes, bounded correctly by ReceiveFileName()
...
EEPwriteStr(eepAdCrtBootName, DriveNames[DriveType]);
EEPwriteStr(eepAdCrtBootName+strlen(DriveNames[DriveType]), FileNamePath);
```
`eepAdCrtBootName` is allocated only **256 bytes** in the EEPROM layout (`Common_Defs.h`: `eepAdCrtBootName = 1919, // (256:MaxPathLength)`, confirmed tight against the next field `eepAdMinBootInd = 2175` = `1919+256`, no slack) — but `FileNamePath` is sized and bounded to `MaxNamePathLength` (358 bytes) by `ReceiveFileName()`, not `MaxPathLength`. A path long enough (plus the `"USB:"`/`"SD:"`/`"TR:"` prefix) overflows past the 256-byte field, corrupting `eepAdMinBootInd` (1 byte, immediately adjacent) and writing into `eepAdAutolaunchName` (the next 256-byte field). Unlike the RAM-based `DriveDirPath` overflow, this corruption is **persistent** — it survives a reboot and can silently break the boot-mode indicator and the separate autolaunch-file setting.

Same trigger class as the other two high-priority items: an ordinary `LaunchFileToken` with a long-but-protocol-valid path, sent while the device happens to be running in MinimalBoot mode.

**Status:** deferred — confirmed, high priority, not yet fixed (2026-08-12).

## HIGH PRIORITY: `nfcReadTagLaunch()`'s "random launch" path allocates a 16,000-byte array on the stack — likely root cause of the documented NFC large-directory crash

**Where:** `Source/Teensy/nfcScan.ino`, `nfcReadTagLaunch()`, the "random launch" filtering branch:
```c
StructMenuItem *CleanLocalDirMenu[MaxMenuItems];  // MaxMenuItems=4000, ×4-byte pointers = 16,000 bytes, on the stack
```
This is a plain local array, not heap/`malloc`-backed — the full 16KB is claimed from the stack for the duration of this call, on top of whatever else is already on the stack at that call depth.

This directly matches the crash scenario `TeensyROM.h` documents in its own comments (`>24000 RAM1 free for local` reliability-floor note, citing "Random(?) NFC tag with large directory, crash when tapped" as the historical test case that drove the `MaxRAM_ImageSize` 144→128KB reduction). Given current RAM1 `free for local variables` is ~40KB and this one call can claim 16KB of it in a single allocation, this looks like a strong candidate for the actual mechanism behind that crash, not just a theoretical risk — especially combined with whatever the rest of the call chain (NFC read, directory scan, menu-item filtering) has already put on the stack by the time this executes.

Possible fixes: shrink the array to a more realistic bound; move it off the stack (heap-allocate for the duration of the call); or avoid materializing the full filtered list at all — count matching items first, then re-scan for the Nth match instead of building `CleanLocalDirMenu[]` up front.

**Status:** deferred — newly identified, high priority given direct match to documented crash history, not yet fixed (2026-08-12).

## FLASHMEM audit (running list)

Functions that are safe `FLASHMEM` candidates — confirmed never called from `isrPHI2` or any per-cycle handler path (`ROMLHndlr`/`ROMHHndlr`/`IO1Hndlr`/`IO2Hndlr`/`CycleHndlr`) — but aren't currently marked, unlike their siblings that follow the same pattern correctly. Each one left in default RAM1/ITCM placement costs RAM1 space unnecessarily; moving to flash is low-risk (see [Constraints.md](Constraints.md#the-real-dividing-line-flash-backed-vs-ram-backed-not-just-the-isr-function-itself) for why this distinction is safe/unsafe in general). Expected to grow well beyond `IO_Handlers/` as more files get reviewed — check every `InitHndlr`/`PollingHndlr`/`SpecialBtn_*`/similar main-context-only function for this when reviewing a new file, not just when something else prompts it.

**This isn't just a nice-to-have.** Per the user (2026-08-12), the Fab04 (TR+) main-firmware build — the tightest configuration, since it compiles in REU/KernalReplace/Freezers on top of everything else — had, as of that date, only **~9-10KB of RAM1 "padding"** left before hitting a hard link failure (measured: `RAM1: variables:254468, code:220104, padding:9272  free for local variables:40444` bytes). That figure has since moved, and it moves with almost every commit: with the extension loader compiled in, a full `npm run build:tr-plus` measured `RAM1: variables:241380, code:214472, padding:14904   free for local variables:53532` as of the extension-host PR (#37). Across the builds measured during that work, `padding` fell while `free for local variables` held at 53532, so padding is the slack that runs out and the figure to watch. That figure is the tree's own, and it is not reachable by adding up the deltas of the branches merged into it. Measure the tree you are pricing, not the commits that went into it. Without the loader, a 2026-09-23 build measured `padding:19336`; that one has not been re-measured since. Date a measurement to a commit rather than to a day -- a day holds enough growth to invalidate it -- and re-measure before pricing this work off it — see [Constraints.md](Constraints.md#memory-budgets-are-hard-caps-not-soft-targets). RAM1's biggest single consumer, the `RAM_Image` buffer, is fixed and won't shrink — so `FLASHMEM` migrations are the main lever available to keep this build compiling as more features get added, not just an optimization. (Correcting an earlier framing here: MinimalBoot's RAM scarcity is well-documented and obvious, but RAM1 pressure in the full Fab04 build is actually the tighter, less-visible constraint.)

- [ ] `PollingHndlr_TR_BASIC` — `Source/Teensy/MinimalBoot/Common/IO_Handlers/IOH_TR_BASIC.c` — main-loop-only (`PollingHndlr`), like `PollingHndlr_REU` which already has `FLASHMEM`.
- [ ] `PollingHndlr_TeensyROM` — `Source/Teensy/MinimalBoot/Common/IO_Handlers/IOH_TeensyROM.c` — same pattern, main-loop-only. (Note: most of what `StatusFunction[]` dispatches, plus their exclusive helpers, were split into `StatusFunctions.c` since this was written, and everything that moved carries `FLASHMEM`. Three dispatch targets did not move and carry none: `MenuChange` in `DriveDirLoad.ino`, and `IOHandlerSelectInit` and `IOHandlerNextInit` in `IOHandlers.ino`. They are reached only through this same main-loop dispatch, so they look like candidates, but each still needs the per-function call-graph check every other entry here got. `PollingHndlr_TeensyROM` itself stayed in `IOH_TeensyROM.c` and is still missing it.)
- [ ] `IOH_ASID.c` — largest single opportunity found so far. Confirmed via call-graph trace (not assumed) that only `IO1Hndlr_ASID` (ISR-called) and `InitTimedASIDQueue()` (called from within it, own comment confirms "Called from ISR, must be fast!") and `SendTimedASID()` (`IntervalTimer` hardware-timer interrupt context, already correctly `FASTRUN`) need to stay RAM-resident. Everything else is only reachable via `PollingHndlr_ASID`'s main-loop `usbHostMIDI.read()`/`usbDevMIDI.read()` calls — safe FLASHMEM candidates: `InitHndlr_ASID`, `PollingHndlr_ASID`, `AddToASIDRxQueue`, `FlushASIDRxQueue`, `SetASIDIRQ`, `PrintflnToASID`, `AddErrorToASIDRxQueue`, `DecodeSendSIDRegData`, and `ASIDOnSystemExclusive` (the ~180-line SysEx decoder, `IOH_ASID.c:389-567`) — likely the single biggest RAM1 reclaim of any file reviewed this session.
- [ ] `IOH_MIDI.c` — same shape as ASID. Only `IO1Hndlr_MIDI` is ISR-called; it doesn't call `SetMidiIRQ()` or any `HWEOn*` handler directly, so all of those are only reachable via `PollingHndlr_MIDI`'s main-loop `usbHostMIDI.read()`/`usbDevMIDI.read()` calls. Safe FLASHMEM candidates: `PollingHndlr_MIDI` (`IOH_MIDI.c:471`), `SetMidiIRQ` (`:107`), and all twelve `HWEOn*` callback functions (`HWEOnNoteOff`/`On`/`AfterTouchPoly`/`ControlChange`/`ProgramChange`/`AfterTouch`/`PitchChange`/`SystemExclusive`/`TimeCodeQuarterFrame`/`SongPosition`/`SongSelect`/`TuneRequest`/`RealTimeSystem`, lines 107-248).
- [ ] `IOH_Swiftlink.c` — `InitHndlr_SwiftLink` (line 380) and `PollingHndlr_SwiftLink` (line 513) are candidates; likely also `FreeSwiftlinkBuffs()` (line 263, called from `SetUpMainMenuROM()` — main-context). By contrast `SetBaud()` and `ResetSwiftLink()` are correctly left unmarked — both carry their own "called from Phi IRQ/IO handler, be quick!" comments and are genuinely ISR-reachable via `IO1Hndlr_SwiftLink`.
- [ ] `Swift_RxQueue.c` — the file demonstrates both patterns side-by-side: smaller helpers near the bottom (`AddIPaddrToRxQueueLN`, `AddMACToRxQueueLN`, `AddInvalidFormatToRxQueueLN`, `AddUpdatedToRxQueueLN`, `AddDHCPEnDisToRxQueueLN`, `AddDHCPTimeoutToRxQueueLN`, `AddDHCPRespTOToRxQueueLN`, `Add_BR_ToRxQueue`) are correctly `FLASHMEM`, but the foundational functions above them aren't, despite being equally main-context-only (reachable only via `PollingHndlr_SwiftLink`, never the ISR-path `IO1Hndlr_SwiftLink`/`CycleHndlr_SwiftLink`): `PullFromRxQueue`, `ReadyToSendRx`, `CheckRxNMITimeout`, `SendRxByte`, `CheckSendRxQueue`, `FlushRxQueue`, `AddRawCharToRxQueue`, `AddRawStrToRxQueue`, `AddToPETSCIIStrToRxQueue`, `AddToPETSCIIStrToRxQueueLN`, `inet_aton`.
- [ ] `Swift_ATcommands.c` — otherwise fully consistent (every `AT_*` function correctly `FLASHMEM`), except two tiny one-line wrappers: `AddVerboseToPETSCIIStrToRxQueueLN` and `AddVerboseToPETSCIIStrToRxQueue` (lines 84-92). Negligible RAM impact given their size, noted for completeness.
- [ ] `Swift_Browser.c` — confirmed via call-graph (only reachable through `PollingHndlr_SwiftLink`'s TxMsg/browser-command processing or `CheckSendRxQueue`'s HTML parsing, never the ISR-path `IO1Hndlr_SwiftLink`/`CycleHndlr_SwiftLink`): `SwiftTxBufToLcaseASSCII`, `SendPETSCIICharImmediate`, `SendASCIIStrImmediate`, `SendASCIIStrImmediateLN`, `SendASCIIErrorStrImmediate`, `DumpQueueUnPausePage`, `UnPausePage`, `ParseEntityReference`, `ParseHTMLTag`, `ParseURL`, `ReadClientLine`, `ClearClientStop`, `AddToPrevURLQueue`, `WebConnect`, `isURLFiltered`, `ModWebConnect`.
- [ ] `InitHndlr_ZaxxonSuper` — `Source/Teensy/MinimalBoot/Common/IO_Handlers/IOH_ZaxxonSuper.c:37` — main-context only (`InitHndlr`, called via `IOHandlerInit`), not currently marked.
- [ ] `InitHndlr_MagicDesk` — `IOH_MagicDesk.c:40`
- [ ] `InitHndlr_MagicDesk2` and `PollingHndlr_MagicDesk2` — `IOH_MagicDesk2.c:52` and `:117`
- [ ] `InitHndlr_Ocean1` — `IOH_Ocean1.c:35`
- [ ] `InitHndlr_SuperGames` — `IOH_SuperGames.c:37`
- [ ] `InitHndlr_EpyxFastLoad` — `IOH_EpyxFastLoad.c:44`
- [ ] `InitHndlr_GMod2` — `IOH_GMod2.c:35`
- [ ] `InitHndlr_EasyFlash`, `LoadBank`, `PollingHndlr_EasyFlash` — `IOH_EasyFlash.c:90`, `:60`, `:214` — all main-context only; `ImageCheckAssign` (`:143`) is correctly left unmarked since it's genuinely ISR-reachable via `IO1Hndlr_EasyFlash`.
- [ ] `PollingHndlr_Debug` — `IOH_Debug.c:243` — the one function in the file not covered by its own `DEBUG_MEMLOC` (`=FLASHMEM`) macro, which is otherwise applied consistently to everything else.
- [ ] `ServiceTCP` — `Source/Teensy/ServiceTCP.ino:4` — likely main-context (polling-loop TCP handling), not independently confirmed via caller trace.
- [ ] `ServiceTCP` — `Source/Teensy/MinimalBoot/Min_ServiceTCP.ino:4` — MinimalBoot's own copy of the same function/gap. `EthernetInit()` in the same file is already correctly marked.
- [ ] `InterruptC64`, `DoC64IRQ`, `EEPRemoteLaunch`, `RemoteLaunch` — `Source/Teensy/RemoteControl.ino` — all main-context only; `RemoteLaunch` is the largest of the batch.
- [ ] `RAM2BytesFree` — `Source/Teensy/SerUSBIO.ino:785` — the one function in this file not marked `FLASHMEM`; everything else (`ServiceSerial`, `ProcessCommand`, `LaunchFile`, `ReceiveFileName`, etc.) is fully consistent.
- [ ] `Source/Teensy/DriveDirLoad.ino` — **zero `FLASHMEM` coverage in the entire file**, likely the single largest opportunity of the session. Every function is menu-navigation-triggered, main-context only (reached via `HandleExecution()` from `RemoteLaunch()`/`IOHandlerSelectInit()`'s StatusFunction dispatch, never the ISR path): `HandleExecution` (~265 lines), `MenuChange`, `LoadFile`, `InitDriveDirMenu`, `SetDriveDirMenuNameType`, `LoadDirectory`, `AddDirEntry`, `FreeDriveDirMenu`, `FreeCrtChips`, `Assoc_Ext_ItemType`.
- [ ] `Source/Teensy/MinimalBoot/Min_DriveDirLoad.ino` — same pattern as its full-firmware counterpart above: zero `FLASHMEM` coverage, all main-context (`HandleExecution`, `LoadFile`, `ParseCRTHeader`, `ParseChipHeader`, `FreeCrtChips`, `PathIsRoot`, `SetTypeFromCRT`, `AssocHWID_IOH`, `SendMsgPrintfln`, `toU32`/`toU16`).
- [ ] `nfcCheck`, `RegMenuTypeFromFileName`, `FSfromSourceID`, `nfcReadTagLaunch` — `Source/Teensy/nfcScan.ino` — NFC polling is main-loop-driven, not ISR; `nfcInit`/`nfcConfigCheck`/`nfcWriteTag` in the same file already correctly have `FLASHMEM`.
- [ ] `setup()`, `SetMenu`, `SDFullInit`, `USBFileSystemWait`, `SetRandomSeed`, `CheckLaunchSDAuto` — `Source/Teensy/Teensy.ino` — `setup()` runs exactly once at boot and is never ISR-reachable; verified `set_arm_clock()` (Teensyduino 1.61.0 core, `clockspeed.c`) only touches the ARM core clock tree, never FlexSPI/flash timing, so there's no clock-change-vs-flash-execution hazard ruling it out. The rest are ordinary main-context helpers. `SetUpMainMenuROM`, the `EEPwrite*`/`EEPread*` helpers, `SetEEPDefaults`, and all five `SpecialBtn_*` functions in the same file are already correctly marked.
- [ ] `setup()`, `EEPwriteNBuf`, `EEPwriteStr`, `EEPreadNBuf`, `EEPreadStr`, `LoadCRT` — `Source/Teensy/MinimalBoot/MinimalBoot.ino` — same reasoning as `Teensy.ino`'s equivalents (which already have `FLASHMEM`); this build's own copies were missed. `RAM2blocks()` in the same file is already correctly marked.

**Status:** open, actively growing as more files are reviewed (2026-08-12). Every item above was applied at once as an experiment on 2026-08-12 (both firmwares built clean), successfully clearing ~17KB of `padding` runway for future RAM1-resident code growth, then **reverted** anyway to avoid paying the flash access-time cost on ~115 functions continuously before it's needed — see [Constraints.md](Constraints.md#full-audit-list-flashmem-experiment-2026-08-12--applied-measured-then-reverted) for the measured RAM impact and the per-file byte-size ranking. None of these checkboxes reflect applied state; they're still open candidates for whenever clearing more `padding` runway (or crossing the next 32KB boundary for a `free for local variables` jump) is worth that tradeoff.

## Debug-only `'y'` serial command has a genuinely unbounded read into a fixed buffer

**Where:** `Source/Teensy/SerUSBIO.ino:183-192`, the `'y'` case (load REU PSRAM from file via serial), gated behind `Dbg_SerDMA` + `Fab04_FullDMACapable` + `USE_PSRAM`.

```c
char Filename[100];
uint32_t CharNum = 0;
while (SerialAvailabeTimeout())
{
   Filename[CharNum++] = CmdChannel->read();
}
```
No bound against the 100-byte `Filename[]` at all — worse than most other findings this session in that there's no size reasoning whatsoever, just an idle-timeout-gated loop. Multiply debug-gated though, so low real-world exposure.

**Status:** deferred — flagged, low priority given how narrowly gated it is (2026-08-12).

## `LoadDxxDirectory()` has no cycle detection or entry-count bound on the D64/D71/D81 track/sector chain

**Where:** `Source/Teensy/D64.ino:77-173`, inside `LoadDxxDirectory()`.

Walks a directory track/sector chain read directly from the disk-image file (`Track = NextTrack; Sector = NextSect;`, values read from file data) with no cycle detection, and writes `DriveDirMenu[NumDrvDirMenuItems]` with no check against `MaxMenuItems` before incrementing. A malformed or circular chain in a corrupted/crafted D64/D71/D81 image could grow `NumDrvDirMenuItems` indefinitely. Also no NULL-check on the per-entry `malloc(DxxFNB_Bytes)` (line 143) before the following `memcpy` into it. Same general category as other malformed-file scenarios already waved off this session — flagging in case the entry-count angle (unbounded growth, not just a single bad index) changes the calculus. `LoadDxxFile()` (the sibling that actually loads file contents) is unaffected — it's naturally self-bounding via its `Size + 254 > RAM_ImageSize` check regardless of chain behavior.

**Fixed (2026-09-27):** the chain walk now stops after `MaxDxxDirSectors` (64 — a real directory is at most 37 sectors) links and also stops once `NumDrvDirMenuItems` reaches `MaxMenuItems`. The per-entry `malloc` is still unchecked.

**Status:** fixed (2026-09-27), except the `malloc` check.

## `DownloadFile()` writes an over-length HTTP response chunk before validating it

**Where:** `Source/Teensy/MinimalBoot/Common/IO_Handlers/Swift_Browser.c:748-763`, inside `DownloadFile()`.

```c
uint32_t ChunkSize = client.available();
if (ChunkSize)
{
   if (ChunkSize > MaxChunkSize) ChunkSize = MaxChunkSize;
   client.read(DataChunk, ChunkSize);
   dataFile.write(DataChunk, ChunkSize);      // written first
   ...
   if (ChunkSize > Length)                     // checked after
   {
      dataFile.close();
      SendASCIIErrorStrImmediate("\rExtra data received");
      return;
   }
```
Not a buffer overflow — `DataChunk` is correctly capped to `MaxChunkSize` before use. But if a server sends more data than its own declared `Content-Length`, the oversized chunk is written to the destination file *before* the "Extra data received" error fires and aborts. The user sees the error, but the partially-corrupt file is left on disk rather than being caught before that last write or cleaned up (e.g. `sourceFS->remove()`) after.

**Status:** deferred — not yet fixed (2026-08-12).

## Design a consistent allocation-failure (OOM) policy across handlers

**Where:** cross-cutting — seen across `IOH_REU.c`, `IOH_RetroReplay.c`, `IOH_ActionReplay.c`, `IOH_SuperSnapshotV5.c`, `IOH_Swiftlink.c`, `BusSnoop.ino`, and likely more not yet reviewed.

Every handler that allocates RAM at init handles a failed `malloc`/`calloc` differently, with no consistent policy:
- `IOH_REU.c`'s RAM12 bank-allocation loop actively detects persistent failure and calls `REBOOT` (`IOH_REU.c:539-546`) — "no better way to fail..." per its own comment.
- `IOH_RetroReplay.c` and `IOH_ActionReplay.c` don't check at all (`IOH_ActionReplay.c:94-99` has the check written but commented out); `IOH_SuperSnapshotV5.c` has the identical commented-out check (see the earlier FLASHMEM/null-check discussion — assessed as low risk to leave, since the NULL guards elsewhere prevent a crash).
- `IOH_Swiftlink.c`'s `InitHndlr_SwiftLink` allocation loops (lines 404-428) print an "OOM ..." message and continue, leaving that specific buffer slot `NULL`. **Confirmed (not just suspected): `Swift_RxQueue.c` does not check for this.** `PullFromRxQueue()` (`Swift_RxQueue.c:26`) and `AddRawCharToRxQueue()` (`:129`) both index `RxQueue[RxQueueHead/Tail / RxQueueBlockSize][...]` directly with no NULL guard — if the circular buffer wraps into a block whose allocation failed, that's a real NULL-pointer dereference/crash, not just a theoretical risk. Good supporting evidence for the REBOOT direction below: if allocation failure reboots immediately at init, this consumer-side gap becomes unreachable rather than needing to be individually guarded.
- `BusSnoop.ino`'s `BusAnalysis()` (line 16) doesn't check `calloc()` either — a failure would NULL-deref inside `BusCount()` (assigned to `fBusSnoop`, genuinely ISR-called) on the very next C64 bus write. Narrower in practice than the others since this is a manually-triggered diagnostic tool, not a normal-use code path.

**Current thinking (2026-08-12, not finalized):** the likely direction is to standardize on **REBOOT on allocation failure**, matching the precedent already set by `IOH_REU.c`'s RAM12 path — consistent with the project's general RAM-scarcity posture (MinimalBoot's whole existence is a response to RAM exhaustion, see [Teensy-Firmware.md](Teensy-Firmware.md#minimalboot-vs-full-firmware)) and simpler to reason about than trying to gracefully degrade every handler individually. Not yet designed in detail (e.g., whether every handler gets this treatment uniformly, or whether some cases warrant a softer failure).

**Status:** deferred — direction leaning REBOOT, full design discussion not yet held (2026-08-12).

## Audit `sprintf`/`vsprintf`-into-fixed-buffer pattern across the codebase

**Where seen so far:**
- `FileParsers.ino:510-532` (`SendMsgPrintfln`/`SendMsgPrintf` → `SerialStringBuf`, 262 bytes) — **fixed**: `vsnprintf`, and the `\r\n` shift is given two bytes fewer than the buffer holds because it moves the text right by two afterwards.
- `IOH_ASID.c:229-253` (`PrintflnToASID` → `ToSend`, 300 bytes) — the SysEx cap is `SYSEX_MAX_LEN` 290 (`USBHost_t36.h`), and `MIDIDevice_BigBuffer` enlarges the packet queue rather than `msg_sysex`, so `data+3` cannot exceed 287.
- `Swift_ATcommands.c:186-187` (`AT_DT()` → local `Buf[100]`) — **confirmed reachable via completely ordinary use**, not just a malformed-input edge case: `sprintf(Buf, "Trying \"%s\"\r\n on port %d...", CmdArg, Port);` where `CmdArg` is user-typed hostname text from an `ATDT<hostname>:<port>` command, bounded only by `TxMsg`'s 128-byte limit — a normal long hostname plus the fixed format text alone can exceed the 100-byte `Buf`. **Fixed**: `snprintf`.
- `Min_DriveDirLoad.ino` (MinimalBoot) — the minimal image defines its **own** `SendMsgPrintfln`/`SendMsgPrintf`, separate from the full firmware's in `FileParsers.ino` above, and it had the same unbounded `vsprintf` into a local `SerialStringBuf[MaxPathLength]`. (The full firmware's `DriveDirLoad.ino` was listed here too, as a third copy. It is not one: it only *calls* the formatter and defines none — checked at this branch's base as well, where it holds no `vsprintf` either. What is genuinely duplicated between the two builds is `LoadFile()`/`ParseCRTHeader()`, not the formatter.) That call chain is a **more severe variant of the FileParsers.ino case above**: `LoadFile()` declares `uint8_t lclBuf[CRT_MAIN_HDR_LEN]` (64 bytes, confirmed via `DriveDirLoad.h:170`), and the CRT "Name" field read by `SendMsgPrintfln("Name: %s", (CRT_Image+0x20))` starts at byte 32 and is a 32-byte field ending *exactly* at byte 64 — the last byte of `lclBuf` itself. An unterminated Name field (fills all 32 bytes, no padding) causes the `%s` read to run off the end of `lclBuf` immediately — a stack **out-of-bounds read at the source**, before even reaching the already-known destination-buffer overflow. Tighter than the `FileParsers.ino` instance, where the Name field sits inside a buffer holding the whole loaded file (an unterminated name there just reads into subsequent legitimate file data, not immediately out of bounds). Present in both builds since `Source/C64`-style code sharing doesn't apply here — each `LoadFile()` is its own independent implementation. **Fixed**: `vsnprintf` in the minimal image's copy (`Min_DriveDirLoad.ino:417`), and `%.32s` at both `Name:` call sites (`FileParsers.ino:93`, `Min_DriveDirLoad.ino:272`).

Four independent instances of the same shape (`sprintf`/`vsprintf` into a fixed local/global buffer, no length argument) found without specifically looking for it — worth a dedicated sweep (`grep -rn "sprintf\|vsprintf"`, excluding the safe `snprintf`/`vsnprintf` variants) across the rest of the codebase rather than waiting to stumble onto more of them file-by-file.

**Status:** open, not yet swept (2026-08-12).

## Unbounded writes in `IOH_TR_BASIC.c`'s ISR-path IO1 write handler

**Where:** the `LSFileName[FNCount++]` and `RAM_Image[StreamOffsetAddr++]` writes in `Source/Teensy/MinimalBoot/Common/IO_Handlers/IOH_TR_BASIC.c`, inside `IO1Hndlr_TR_BASIC` (called directly from `isrPHI2`, `ISRs.c:128`).

Two writes into fixed-size buffers with no bounds check against the C64-side-controlled byte count:
- `LSFileName[FNCount++] = Data;` (line 429, `TR_BASFileNameReg` write case) — `LSFileName` is a 256-byte (`MaxPathLength`) allocation; a filename stream longer than that with no null terminator would overflow it.
- `RAM_Image[StreamOffsetAddr++] = Data;` (line 436, `TR_BASStreamDataReg` write case) — similarly unbounded against `RAM_Image`'s size.

Both depend entirely on the C64-side `TRCustomBasicCommands` assembly code behaving itself and never streaming more bytes than the Teensy side expects — nothing on the Teensy side enforces the limit. Noted separately from the `Serial.write()` finding in this same file (see below) since this is a memory-safety/buffer-overflow concern from data volume, not a timing concern — the "BASIC interpreter overhead paces this" reasoning that resolved the `Serial.write()` question doesn't obviously extend to whether the *byte count* itself could ever exceed the buffer.

**Fixed (2026-09-27):** both writes now stop at their buffer's end instead of running past it. `LSFileName` keeps its last byte as the terminator, so the longest BASIC string (255 characters) still fits whole; a longer name is cut short. `RAM_Image` stops advancing once `StreamOffsetAddr` reaches `RAM_ImageSize`.

**Status:** fixed (2026-09-27).

## Documented exception: `Serial.write()` inside the ISR-path `IO1Hndlr_TR_BASIC`

**Where:** `Source/Teensy/MinimalBoot/Common/IO_Handlers/IOH_TR_BASIC.c`, inside `IO1Hndlr_TR_BASIC` (ISR-called, `TR_BASDataReg` write case — the TPUT BASIC command's output path).

```c
Serial.write(Data); //a bit risky doing this here, but seems fast enough in testing
```
This runs in the ISR call chain, which `Constraints.md` otherwise rules out for anything with unbounded latency (Serial writes included, same class as SD/USB/EEPROM). Confirmed by the developer as a **deliberate, understood exception**: TPUT's `Serial.write()` calls are paced by BASIC interpreter overhead (tokenization/dispatch), not raw machine-code speed, so in practice this can't be called densely enough to threaten bus timing — verified in testing. Not queued for a fix; recorded here (and to be folded into `Constraints.md`) so it isn't re-flagged as a fresh violation in a future pass.

**Status:** accepted, documented exception — no action needed (2026-08-12).

## MinimalBoot's Ethernet-disable protection has a gap during VIC-cycle emulation

**Where:** `Source/Teensy/MinimalBoot/Min_DriveDirLoad.ino:53-55`

The full-firmware path disables `IRQ_ENET`/`IRQ_PIT` while `EmulateVicCycles` is active, because servicing the VIC half of the cycle extends `isrPHI2` enough that a stray Ethernet interrupt can cause a missed cycle (see [Constraints.md](Constraints.md)). MinimalBoot has the identical `EmulateVicCycles = true;` line (`Min_DriveDirLoad.ino:55`) but its matching `NVIC_DISABLE_IRQ(IRQ_ENET/IRQ_PIT)` lines just above are commented out. This protection gap is now live, not just theoretical, since MinimalBoot runs Ethernet (added deliberately for remote-launch/interrupt support, see [Teensy-Firmware.md](Teensy-Firmware.md#minimalboot-vs-full-firmware)).

**Why it hasn't caused a visible problem:** carts needing VIC-half emulation are old/small titles (e.g. Jupiter Lander, Radar Rat Race, Clowns) that always fit within full-firmware's RAM budget — the combination "needs VIC emulation" + "too large for full FW, must run from MinimalBoot" doesn't occur among real carts. This is an accidental non-collision, not a designed-safe state.

**Proposed fix:** comment out `EmulateVicCycles = true;` at `Min_DriveDirLoad.ino:55` too, so MinimalBoot never attempts VIC-cycle emulation at all — trading "a hypothetical oversized cart needing VIC emulation wouldn't run correctly from MinimalBoot" for closing the unprotected-Ethernet window.

**Status:** deferred — not ready to test yet (2026-08-11).

## Cartridge register map (`Menu_Regs.i` / `Menu_Regs.h`) is hand-duplicated across two languages

**Where:** `Source/C64/MainMenuCRT/source/Menu_Regs.i` (ACME) and the Teensy-side `Menu_Regs.h` (C) — see [Comms-Protocol.md](Comms-Protocol.md).

Two independently hand-maintained files define the same register offset/enum map, with only a comment ("These need to match Teensy Code: Menu_Regs.h") enforcing consistency — no shared source, no build-time check.

**Fix implemented:**
1. `Menu_Regs.h` stays the single hand-edited source of truth. The region between the `These need to match C64 Code` / `End C64 matching` marker comments is now mechanically translated, not hand-copied.
2. A generator, **`tools/lib/menu-regs.mjs`** (a Node port of the original `gen_menu_regs_i.py`), parses that region directly and emits ACME assignment lines — no C preprocessor involved. (The original plan called for `gcc -E`/`cpp`, but the synced region turned out to contain zero `#ifdef`/`#include` for a preprocessor to resolve, and a plain macro-expansion pass can't translate C `enum { A = 1, B };` block syntax into ACME's flat `A = 1` / `B = 2` assignment lines anyway — that translation is what the script does.) Handles multi-line enums, `#define` constants, auto-incrementing members with no explicit value, and comment-style translation (`//` → `;`).
3. One documented exception: `IOH_None` is pulled in from `enum enumIOHandlers`, which lives just *outside* the synced region (deliberately — the rest of that enum is Teensy-internal `IOHandler[]` indices with no meaning on the C64 side, and its values shift under `MinimumBuild`/`Fab04_*` build flags that don't apply to C64 assembly). `IOH_None` is the only member any C64 code references (`ldx #IOH_None` in `Pg_TRSettings.asm`), and it's pinned at 0 by its own "always 0" comment in `Menu_Regs.h`, so the script asserts that invariant rather than hardcoding the value blindly.
4. Found and fixed a real drift in the process: `EscMenuMiscColor`/`EscTypeColor` existed only in the hand-written `Menu_Regs.i`, with no `Menu_Regs.h` counterpart, even though they're referenced from 8 C64 ASM files. Moved them into `Menu_Regs.h`'s `enum ColorRefOffsets` as explicit aliases (`EscMenuMiscColor = EscNameColor`, `EscTypeColor = EscSourcesColor`) so they're now covered by the same sync guarantee as everything else.
5. `Menu_Regs.i` keeps its existing location/format, so its 6 consumers (`MainMenuCRT`, `SettingsMenu`, `TRHelpScreens`, `TRExtPortCheck`, `MIDI2SID`, `ExpansionPortTest`) needed no changes.
6. Regeneration is the first step of **`tools/build-c64.mjs`**, so every C64 build regenerates `Menu_Regs.i` from `Menu_Regs.h` before assembling.

**Verified:** assembled both the old hand-written `Menu_Regs.i` and the generated one with ACME 0.97 (`--symbollist`) — all 268 symbols matched name-for-name and value-for-value, and the resulting `.prg` output was byte-identical.

**Status:** fixed (2026-08-14).

## `CheckLaunchSDAuto()`'s DAT3 presence check read the pin with no settle delay after switching its mode

**Where:** `Source/Teensy/Teensy.ino:556-558`, `CheckLaunchSDAuto()`.

Boot-time SD auto-launch does a cheap presence check before paying `SDFullInit()`'s up-to-3-second
cost: switch the SDIO DAT3 line (pin 46 on Teensy 4.1) to `INPUT_PULLDOWN`, then read it.

```c
// _SD_DAT3 = pin 46
pinMode(46, INPUT_PULLDOWN);
if (digitalReadFast(46))
```

No delay between the mode switch and the read. This is the identical pattern PJRC's own SD
library carried internally for `SD.mediaPresent()`'s DAT3 fast-path, and found unreliable enough
to fix with a dedicated commit: [PaulStoffregen/SD@c535ae9](https://github.com/PaulStoffregen/SD/commit/c535ae9e10723054a9c36b71d0c4ed3b4a1c7684),
"Improve SDIO media presence detection" (Teensyduino 1.60, Nov 2024), added
`delayMicroseconds(5)` after every `pinMode(_SD_DAT3, INPUT_PULLDOWN)` call in the library,
immediately before reading the pin. Root cause per the author's own forum thread (a live-demoed
detection bug, [msg #53](https://forum.pjrc.com/index.php?threads/mtp-file-size-limits.76053/page-3#post-351846) →
fixed at [msg #80](https://forum.pjrc.com/index.php?threads/mtp-file-size-limits.76053/page-4#post-351928)):
reading the pin immediately after switching its mode can catch a stale/transitional voltage
before the pull resistor settles, rather than the true line state.

For context on the mechanism itself: the DAT3-substitution fast-path isn't new or fragile — it
shipped in Teensyduino 1.56 (Dec 2021, [PaulStoffregen/SD@534da7a](https://github.com/PaulStoffregen/SD/commit/534da7a64507f4ce3ebcae9b0ffb9764b9ff0124))
and has ~4 years of production history. The settle-delay fix above is a refinement of a mature
mechanism, not evidence the mechanism itself is unreliable.

One caveat: PJRC's fix addresses the pin *after* the SDIO peripheral had been actively driving it
(post-`SD.begin()`, mid-session hot-swap detection). `CheckLaunchSDAuto()` runs at cold boot,
before `SD.begin()` has ever touched the pin, so the settling physics may not be identical — but
it's the same instruction sequence on the same signal, and the fix costs 5 microseconds once per
boot.

**Fix:** added `delayMicroseconds(5);` between the `pinMode()` call and the `digitalReadFast()`
call, matching upstream's own fix.

**Status:** fixed (2026-09-19).

## `SD.mediaPresent()` (and this repo's own `SDFullInit()`) can't distinguish "card absent" from "`SD.begin()` never called"

**Where:** `Source/Teensy/Teensy.ino` (`setup()`, `SDFullInit()` at line 482, `CheckLaunchSDAuto()`
at line 545); Teensy core `SD.cpp:111-184` and `SdFat.h:115,423` (core 1.61.0).

`SDFullInit()` already carries a comment flagging half of this: `Printf_dbg("Start mediaPresent
%d\n", SD.mediaPresent()); //This indicates zero regardless of actual prior to begin()`. Traced
the actual mechanism: `SD.mediaPresent()` checks `sdfs.card()`, which returns the
default-initialized `SdCard* m_card = nullptr` (`SdFat.h:423`) until `SD.begin()` has run at
least once — `cardBegin()` is the only thing that assigns `m_card`, and it's only called from
`begin()`. Before that, `mediaPresent()`'s null-card branch unconditionally returns `false`
(`SD.cpp:177-180`), regardless of whether a card is physically present.

The less obvious half: **`SD.begin()` isn't guaranteed to run during full-firmware boot at all.**
`setup()`'s boot-indicator switch only reaches `CheckLaunchSDAuto()` (the only caller of
`SDFullInit()`, the only caller of `SD.begin()`) on the plain `MinBootInd_SkipMin` case, and only
when the menu button isn't held:

```c
switch (EEPROM.read(eepAdMinBootInd))
{
   case MinBootInd_SkipMin: //normal first power up
      if (ReadButton!=0) //skip autolaunch checks if button pressed
         if(!CheckLaunchSDAuto()) { ... }   // only entry point to SD.begin()
      break;
   case MinBootInd_LaunchFull: // Launch command received in minimal, launch it from full
      ...                                    // CheckLaunchSDAuto() never called
      break;
   default:                                  // recovery, most likely MinBootInd_FromMin
      ...                                    // CheckLaunchSDAuto() never called
      break;
}
```

So `SD.begin()` runs at boot only if the boot indicator is `MinBootInd_SkipMin` **and** the button
isn't held **and** `CheckLaunchSDAuto()`'s DAT3 pre-check reads high. It is skipped entirely on
`MinBootInd_LaunchFull` (remote-launch-triggered reboot from minimal to full) and the `default`
recovery case.

**Why it's skipped on those two paths, not just an oversight:** `SDFullInit()`'s own comment gives
the cost — `begin()` takes 3 seconds for fail, 20-200mS for pass, 2 seconds for unpopulated.
`CheckLaunchSDAuto()`'s cheap DAT3 pin read exists to dodge that cost when no card is obviously
present at all, but if the pin *does* read high, it still pays the full `SDFullInit()` cost,
worst-case 3 seconds. `MinBootInd_LaunchFull` and the recovery `default` case skip
`CheckLaunchSDAuto()` entirely — not just the SD-autolaunch feature it implements, but any risk of
that worst-case delay — because both are boots where speed matters more than checking for a
coincidental SD autolaunch file: `MinBootInd_LaunchFull` already has a specific, remote-requested
file to launch (`EEPRemoteLaunch(eepAdCrtBootName)`) and a user or remote controller waiting on
it, and running the SD check first would add pure latency to a launch that's already decided;
the recovery case is already the tail end of a minimal-boot round trip and has no reason to risk
adding another multi-second stall on top of it. Skipping `CheckLaunchSDAuto()` outright guarantees
zero risk of that 3-second worst case on both paths, at the cost of `SD.begin()` never running
during them.

Until something else calls `SD.begin()` — e.g. the first file-transfer or directory-listing
command, which already calls it per request — `SD.mediaPresent()` reports "absent" no matter
what's in the slot on those two paths.

**Consequence:** any future code path that queries `SD.mediaPresent()` early in a boot — before an
ordinary storage command has incidentally called `SD.begin()` — cannot tell "no card" from "never
checked." Most exposed right after a `MinBootInd_LaunchFull` reboot, since that's the one boot
path that both (a) skips `CheckLaunchSDAuto()` entirely and (b) is reachable from a remote command,
not just a manual power-on.

**A lazy `SD.begin()` call is not a safe fix for a serial-command-triggered caller.** The obvious
instinct — have the handler call `SD.begin()` itself the first time it's asked — reintroduces the
exact cost `CheckLaunchSDAuto()`'s boot-time gating exists to avoid. Per
[Constraints.md's single-threaded-main-loop rule](Constraints.md#the-main-loop-is-single-threaded--a-blocking-call-anywhere-in-it-stalls-every-other-main-loop-driven-task),
any handler reachable from `ServiceSerial()`/`ProcessCommand()` that blocks for `SD.begin()`'s
worst case (up to 3 seconds, per `SDFullInit()`'s own comment) stalls everything else
main-loop-driven for that same duration — `PollingHndlr_ASID` (live MIDI/SID playback) included.

**Fix (not yet done) — two options, no protocol change needed for either:**

1. **Preferred: reuse the existing cheap DAT3 check as the fallback signal**, rather than
   inventing a distinct "unknown" reply value. `SD.mediaPresent()` already does exactly this cheap
   check (pin read, no `sdfs.restart()`) whenever `card` is non-null but wasn't previously present
   (`SD.cpp`'s `!cardPreviouslyPresent` branch) — the only place it skips straight to `ret = false`
   is when `card` itself is null, i.e. `SD.begin()` never ran. A small wrapper closes that one gap
   with the same mechanism already trusted for the "check again" case:
   ```c
   bool TR_SDPresent()
   {
      if (!SD.sdfs.card())              // SD.begin() never ran this boot
      {
         pinMode(46, INPUT_PULLDOWN);   // _SD_DAT3 — same check CheckLaunchSDAuto() uses
         delayMicroseconds(5);
         return digitalReadFast(46);    // fast, non-blocking best-effort answer
      }
      return SD.mediaPresent();          // normal path once a card object exists
   }
   ```
   Keeps any external reply format as plain present/absent, no new state for a consumer to handle.
   Inherits the same DAT3 hot-swap-reliability question D5 (see the CONNECTION portfolio's
   `CONNECTION-DECISIONS.md`, external) is already testing on real hardware — not a new risk, an
   extension of one `mediaPresent()` already accepts elsewhere in the same function.
2. **Alternative: expose a distinct "not yet checked" state** if a best-effort guess is
   unacceptable and an honest "don't know" is preferred instead — costs a reply-format/protocol
   change and requires whatever consumes it to handle a third case, for a question the cheap check
   above answers directly without either.

**Status:** deferred — flagged, not yet fixed (2026-09-19).

## Large-CRT bank-swap DMA reliability claim may be stale

**Where:** [CRT_Implementation.md](/docs/CRT_Implementation.md), [Constraints.md](Constraints.md#memory-budgets-are-hard-caps-not-soft-targets)

The >850KB bank-swap mechanism (REU-style DMA-line-assert pause, not true bus-mastering DMA — TR+'s bus-mastering doesn't help here since the pause just needs to be perceptually instant, which bus-mastering doesn't improve) is documented as unreliable on most C128s and a low percentage of NTSC systems. That claim may no longer hold and is worth re-testing.

Possible (unconfirmed) shared root cause: this mechanism (`IOH_MagicDesk2.c`) uses the same `nS_DMAAssert`/`SetDMAAssert` sequence as the unrelated `DMA_Timing` branch's true-bus-mastering-DMA work, to enter the same paused state — it just never goes on to do an actual transfer. `nS_DMAAssert` hasn't been re-characterized yet (see [DMA-Timing-Known-Issues.md](DMA-Timing-Known-Issues.md) item #9); if it turns out marginal on C128 the way a data-hold constant did on NTSC, that would explain this entry too.

**Status:** flagged for re-test, not yet re-verified (2026-08-11).

## `IOHandler[]` array and `enum enumIOHandlers` are hand-synced with no compile-time check

**Where:** `Source/Teensy/MinimalBoot/Common/IOHandlers.h:105-147` (array) and `Source/Teensy/MinimalBoot/Common/Menu_Regs.h:390-434` (enum), both explicitly commented "Synch order/qty with" the other.

Every `stcIOHandlers*` entry in `IOHandler[]` must line up positionally with the matching `enumIOHandlers` value, across every `#ifdef` gate (`MinimumBuild`, `Fab04_REU`, `Fab04_KernalReplace`, `Fab04_Freezers`) — `CurrentIOHandler` is just an integer index into the array. Hand-verified during architecture review (2026-08-11) that the two currently match exactly, entry-for-entry including `RetroReplay`'s recent insertion — but nothing enforces that going forward; adding/removing a handler in only one list would silently misindex `IOHandler[CurrentIOHandler]` at runtime (e.g. selecting one cartridge type could actually load a different one).

**Fix:** added `static_assert(sizeof(IOHandler) / sizeof(IOHandler[0]) == IOH_Num_Handlers, "IOHandler[] / enumIOHandlers count mismatch");` right after the array definition (`IOHandlers.h:105-149`). Used `static_assert` rather than `_Static_assert` since this header is included from `.ino` files and compiled as C++. Zero runtime cost, compile-time only, doesn't touch the ISR or any hot path. Note: this only catches a *count* mismatch (forgot to add/remove an entry in one list), not a pure *reordering* with the same count — still worth having since count mismatches are the more likely mistake.

**Status:** fixed (2026-08-14).

## Third `USBHIDParser` instance (`hid3`) may be unnecessary RAM cost

**Where:** `Source/Teensy/MinimalBoot/Common/IOHandlers.h:38`

Three `USBHIDParser` instances (`hid1`, `hid2`, `hid3`) are declared for the USB host stack, with the original developer's own comment `//need all 3?` left in place — an open question, not a confirmed requirement. Each instance carries its own RAM cost (endpoint buffers/state); if 3 simultaneous HID devices isn't a real-world scenario, removing `hid3` could reclaim some RAM in an area (full firmware's USB host stack) that already competes for the same RAM1/RAM2 budget as everything else.

**Status:** deferred — needs investigation into whether 3 HID devices is a real usage case before touching (2026-08-12).

## Full-firmware and MinimalBoot each maintain their own independent copy of same-named functions — a standing maintainability risk, not a single bug

**Where:** cross-cutting. `Source/Teensy/*.ino`/`.h` (full firmware) and `Source/Teensy/MinimalBoot/*.ino`/`.h` (MinimalBoot) are two separate builds that don't share translation units — despite many functions having identical names and near-identical logic, each build carries its own independent implementation. Confirmed pairs found this session: `SendMsgPrintfln`/`SendMsgPrintf` (`DriveDirLoad.ino` vs `Min_DriveDirLoad.ino`), the `EEPwrite*`/`EEPread*` helpers (`Teensy.ino` vs `MinimalBoot.ino`), the `LoadFile`/`ParseCRTHeader`/`ParseChipHeader` chain (`DriveDirLoad.ino` vs `Min_DriveDirLoad.ino`), and `ServiceTCP` (`ServiceTCP.ino` vs `Min_ServiceTCP.ino`).

Unlike the C64 side, where `Menu_Regs.i`/`Menu_Regs.h` at least document the sync requirement in a comment, these pairs carry no such marker — nothing signals that a fix in one file has a counterpart that likely needs the same fix.

**An example of real drift, now fixed:** MinimalBoot bounded its CHIP table before writing while the full-firmware `ParseChipHeader` in `FileParsers.ino` did not. Both now check their table capacity before creating a new entry. The main image retains its static 128-entry table; native MinimalBoot accepts up to 512 unique EasyFlash bank halves, with the legacy 128-entry limit for other cartridges.

**No fix proposed** — restructuring this (shared translation units, a common library, etc.) would be a significant undertaking given the two builds' different memory/feature constraints, and isn't asked for. Recorded as a standing reminder: when fixing a bug in one of these known-duplicated functions, check whether the other build's copy needs the identical fix.

**Status:** noted — not queued for a fix, kept as a reminder for future bug fixes in either build (2026-08-13).

## Low priority: style/consistency observations from the code-review pass

Cosmetic, no functional impact — not queued for a dedicated pass, but worth applying prospectively (new code, or opportunistically when touching a function for another reason).

- **Naming/abbreviation is inconsistent, sometimes within the same file.** E.g. `IOHandlers.h`: `struct stcIOHandlers` (spelled out) contains members named `InitHndlr`/`IO1Hndlr` (abbreviated), immediately followed by `#include "IO_Handlers/IOH_MIDI.c"` — "Handler" spelled out in the directory name, abbreviated in the filename. Same pattern with counts: `CharNum`, `NumRegs`, `BigBufCount`, `FNCount` are four different naming shapes for the same concept. Buffer names for the recurring "build an outgoing string" pattern are especially inconsistent (`SerialStringBuf`, `Buf`, `ToSend`, `TxMsg`, `lclBuf`) — a shared naming convention there might have made the repeated `vsprintf`-into-fixed-buffer pattern (see above) easier to spot by inspection.
- **Very large files/functions are hard to review in one pass.** `IOH_TeensyROM.c` (~1,900 lines) and `HandleExecution()` (~265 lines) took noticeably longer to review than anything else this session. Worth treating size itself as a standing signal to split, as already done for `StatusFunction[]` (now in `StatusFunctions.c`).
- **Commented-out code left as an unresolved decision rather than a removed/explained one.** The OOM checks in `IOH_ActionReplay.c`/`IOH_SuperSnapshotV5.c` are commented out with no note on why — ambiguous later whether that was a deliberate call or an unfinished thought. A one-line "why" comment (or deletion, since git retains history) would remove the ambiguity.
- **Open design questions sometimes live only as inline comments**, e.g. `//need all 3?` on `hid3` (`IOHandlers.h:38`) — easy to never resurface. `Known-Issues.md` is now available as a better home for these going forward.
- **"Must stay in sync" relationships enforced only by comment, not the compiler, are worth a build-time check when one's cheap.** Both instances found this session (`IOHandler[]`/`enumIOHandlers`, `Menu_Regs.i`/`Menu_Regs.h`) have since been fixed this way — a `static_assert` and a generator script, respectively (see below). Worth treating "keep in sync with X" comments generally as a prompt to ask the same question.

**Status:** noted, low priority — not queued for a dedicated pass (2026-08-13).

<br>

## A DMA transfer can lose its first byte

On a TR+ with Special IO set to an REU, the first byte of a DMA transfer can go missing: a C64 REU transfer (`DirectREU()`), or a host `WriteC64Mem` running beside the C64's REU transfers. A lost host byte reads back as whatever the C64 held there before; a lost REU byte leaves the destination page's byte 0 at its previous value.

`tools/bench/reuspans.py` reproduces it on an NTSC C64: the C64 loops REU stash, fetch and compare while the host writes and reads back `$6000`. A 120-second run had 3 bad REU pages in 10,854 with no host jobs at all (only the script's counter reads and the client's timer NMI), and 1 in 10,703 beside 288 host jobs, none of which read back wrong. A variant of the script that ran only the 64-byte `WriteC64Mem` writer, for 90 seconds, read back wrong in 0–1 jobs of 256. Before the save and restore of the job's state in `DirectREU()`, that writer read back wrong in 9–10 jobs of 256, through a different mechanism (an REU transfer took over the host job's address and length).

So host DMA is not needed for the REU to lose a byte, though the lost host bytes show it is not the REU alone either. Not yet known: which cycle is lost. Both `DirectREU()`'s release and `DMA_S_StartDisable` in `isrPHI2()` deassert DMA on the PHI2 falling edge with no wait, and in this loop the next transfer asserts within about 40 cycles of a release; that is the first suspect, not a confirmed cause.

[Back to Architecture Overview](Overview.md)
