SensoriumEmbedded/TeensyROM/(threads)

Thread 1 (2023-04-11):

C64s w/ old 36298 PCA runs menu, but can’t do ROM emulation.

SensoriumEmbedded, 2023-04-11:
Caused by 556 driving reset high (not open collector) see this thread.
https://www.lemon64.com/forum/viewtopic.php?t=74222
TeensyROM works fine when described fix is applied

Closed 2023-04-14.
