SensoriumEmbedded/TeensyROM/PCB/v0.3/TeensyROM_v0.3_Schem.pdf

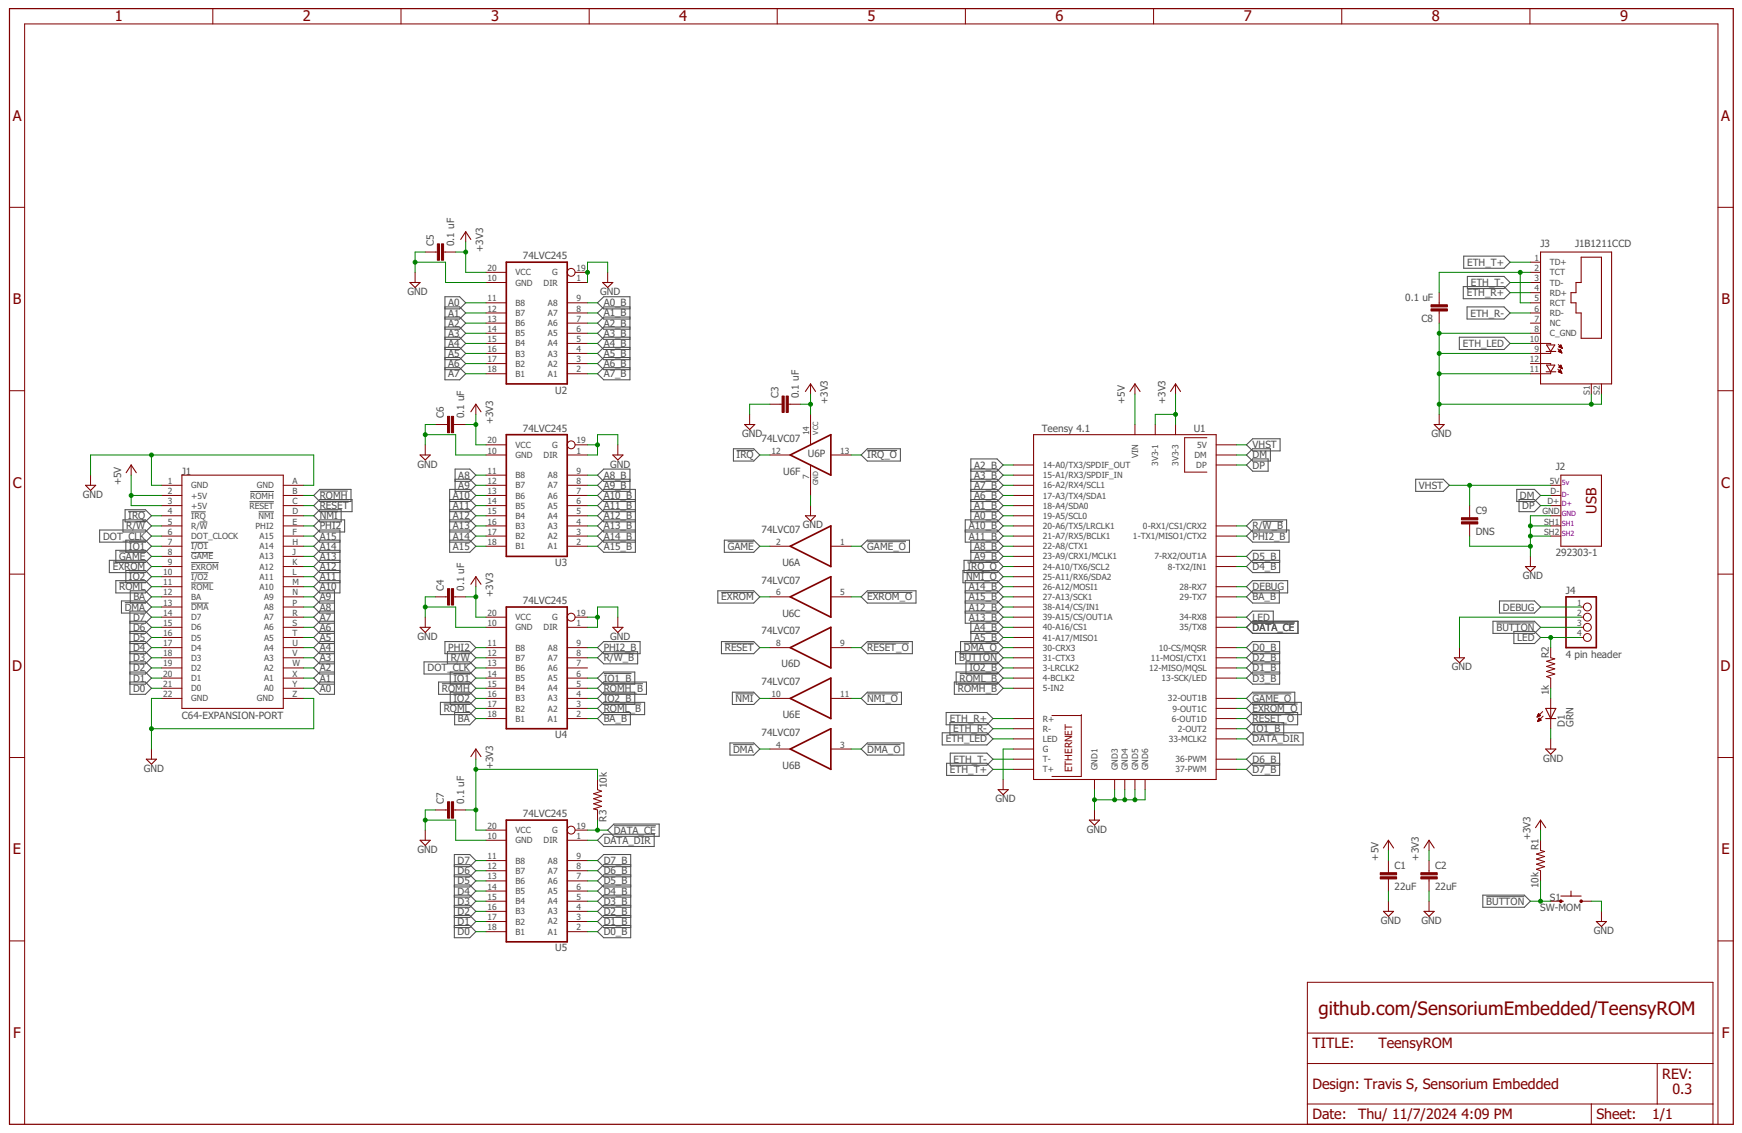
[picture p86: page 1]

10-CS/MQSR
11-MOSI/CTX1
12-MISO/MQSL 13-SCK/LED

0.3 github.com/SensoriumEmbedded/TeensyROM

Design: Travis S, Sensorium Embedded
