SensoriumEmbedded/TeensyROM/Source/Teensy/Teensy.ino

// MIT License
// 
// Copyright (c) 2023 Travis Smith
// 
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
//  TeensyROM: A C64 ROM emulator and loader/interface cartidge based on the Teensy 4.1
//  Copyright (c) 2023 Travis Smith <travis@sensoriumembedded.com> 


#include <SD.h>
#include "MinimalBoot/Common/USBHost_t36/USBHost_t36.h"  // vendored/pinned, not the Teensyduino copy -- see its README.md
#include <SPI.h>
#include "MinimalBoot/Common/NativeEthernet/src/NativeEthernet.h"  // vendored, not the Teensyduino copy -- see its README.md
#include "MinimalBoot/Common/NativeEthernet/src/NativeEthernetUdp.h"
#include <EEPROM.h>
#include <TimeLib.h>
#include <Bounce.h>
#include "TeensyROM.h"
#include "MinimalBoot/Common/Common_Defs.h"
#include "MinimalBoot/Common/Menu_Regs.h"
#include "MinimalBoot/Common/C64Spans.h"
#include "MinimalBoot/Common/DMAControl.c"
#include "MinimalBoot/Common/DriveDirLoad.h"
#include "LoadedListing.h"
#include "GEOS/GeosTargets.h"
#include "MainMenuItems.h"
#ifdef VM_EXTENSIONS_ENABLED
   // Before IOHandlers.h: PollingHndlr_TeensyROM is where the record is shown.
   #include "MinimalBoot/Common/VMFail.h"
   // Here rather than in FlashUpdate.ino, where DoHostInstall lives: the sketch
   // preprocessor hoists its prototypes above every include below this point.
   #include "MinimalBoot/Common/VMHostInstall.h"
   // What DoHostUninstall reads to name the host it is about to remove, and to
   // tell a blank slot, which it leaves alone, from one it has to erase.
   #include "MinimalBoot/Common/VMBootImage.h"
#endif
#include "MinimalBoot/Common/IOHandlers.h"
#include "MinimalBoot/Common/MachineDetect.h"

uint8_t RAM_Image[RAM_ImageSize]; //Main RAM1 file storage buffer
volatile uint8_t BtnPressed = false; 
volatile uint8_t EmulateVicCycles = false;
uint8_t CurrentIOHandler = IOH_None;
#ifdef Fab04_KernalReplace
volatile bool FnetLoopPoll = false; //Ethernet stack polled from loop(), PIT timer masked (see FnetLoopPollService)
volatile bool FnetPollHold = false; //set by Kernal Replace PreStart once a KERNAL is served; cleared with the main menu
void FnetLoopPollService();
FLASHMEM void FnetLoopPollStart()
{  //start polling from loop() right away: loop() only sees the new handler ~0.4 s after the launch, and late phi2 interrupts in that time crashed programs
   //The hold is set even without a network stack: a program can bring it up later (SwiftLink ATC/DHCP), and loop() moves the poll off the PIT then.
   FnetPollHold = true;
   if (fnet_netif_get_default() != 0 && !FnetLoopPoll) { NVIC_DISABLE_IRQ(IRQ_PIT); FnetLoopPoll = true; }
}
#endif
StructMenuItem *DriveDirMenu = NULL;
uint16_t NumDrvDirMenuItems = 0;
char DriveDirPath[MaxPathLength];
uint16_t LOROM_Mask, HIROM_Mask;
bool RemoteLaunched = false; //last app was launched remotely
bool RemoteChangedLoadedDir = false; //a remote file command wrote in the directory the menu is showing
#ifdef VM_EXTENSIONS_ENABLED
   bool RemoteChangedSDCard = false; //a remote file command wrote to the card the extension table is built from
#endif
uint8_t nfcState = nfcStateBitDisabled; //default disabled unless set in eeprom and passes init
Stream *CmdChannel  = &Serial; 
bool isFrozen = false;
void (*fSpecialBtnChange)(bool Up_nDn);    //Pointer to function called when Special Button Changes

#ifdef Fab04_SpecialButton
   Bounce SpecialBtnBounce = Bounce(Special_Btn_In_PIN, 35); //35mS debounce time
#endif

#ifdef FeatTCPListen
   EthernetServer tcpServer(2112); // We will assume control on port 2112
   EthernetClient tcpClient;
#endif

#include "MinimalBoot/Common/ISRs.c"
extern "C" uint32_t set_arm_clock(uint32_t frequency);
extern float tempmonGetTemp(void);

void setup()
{
   set_arm_clock(816000000);  //slight overclocking, no cooling required
   
   SetLEDOff;  //On from minimal build, off for this setup completion
   Serial.begin(115200); // baud rate doesn't matter here, uses USB layer only (no HW serial bus)
#ifdef VM_EXTENSIONS_ENABLED
   // Ahead of every allocation below: the heap runs to the top of RAM2, and
   // this record lives there. It is shown on the C64 later, from the polling
   // handler, because that is the only time the menu reads messages.
   VmFail::capture();
#endif

   for(uint8_t PinNum=0; PinNum<sizeof(OutputPins); PinNum++) pinMode(OutputPins[PinNum], OUTPUT); 
#ifdef Fab04_FullDMACapable
   SetAddrPortDirIn;
   SetAddrBufsIn;   //default to reading address (normal use)
#endif
#ifdef Fab04_DataBufAlwaysEnabled
   SetDataPortDirIn; //default to input (for C64 Write)
   SetDataBufIn;
   //DataBufEnable; //buffer always enabled via HW
#else
   DataBufDisable; //buffer disabled
   //SetDataBufOut  done in ISR based on R/W signal state
   SetDataPortDirOut; //default to output (for C64 Read)
#endif
   
   SetDMADeassert;
   SetIRQDeassert;
   SetNMIDeassert;
   
#ifdef Fab04_BiDirReset
   pinMode(BiDir_Reset_PIN, INPUT_PULLUP);  //also makes it Schmitt triggered (PAD_HYS)
   attachInterrupt( digitalPinToInterrupt(BiDir_Reset_PIN), isrExtResetDetect, FALLING );
#else
   SetResetDeassert; //added for C128 startup issue on TR
#endif   
   //For intermittent C128 startup issue: 
   //  *Game needs to be high (and assumingly ExROM low) before reset asserts. 
   //  Reset assertion forces both ExRom/Game low (from C64/128)
   SetExROMAssert; //emulate 8k cart ROM
   SetGameDeassert;
   delay(100);
   
   SetResetAssert; //assert reset until main loop()

#ifdef Fab04_SpecialButton
   pinMode(Special_Btn_In_PIN, INPUT_PULLUP);
   //attachInterrupt( digitalPinToInterrupt(Special_Btn_In_PIN), isrSpecial, CHANGE );
#else
#ifdef DbgSignalSenseReset
   pinMode(DotClk_Debug_PIN, INPUT_PULLUP);  //use Dot_Clk input as reset sense input
   attachInterrupt( digitalPinToInterrupt(DotClk_Debug_PIN), isrButton, FALLING );
#else
#ifdef DbgFab0_3plus
   pinMode(DotClk_Debug_PIN, OUTPUT);  //p28 is Debug output on fab 0.3+
   SetDebugDeassert;
#else
   pinMode(DotClk_Debug_PIN, INPUT_PULLUP);  //p28 is Dot_Clk input (unused) on fab 0.2x
#endif
#endif
#endif

   for(uint8_t PinNum=0; PinNum<sizeof(InputPins); PinNum++) pinMode(InputPins[PinNum], INPUT); 
   pinMode(Menu_Btn_In_PIN, INPUT_PULLUP);  //also makes it Schmitt triggered (PAD_HYS)
   pinMode(PHI2_PIN, INPUT_PULLUP);   //also makes it Schmitt triggered (PAD_HYS)
   attachInterrupt( digitalPinToInterrupt(Menu_Btn_In_PIN), isrButton, FALLING );
   attachInterrupt( digitalPinToInterrupt(PHI2_PIN), isrPHI2, RISING );
   NVIC_SET_PRIORITY(IRQ_GPIO6789,16); //set HW ints as high priority, otherwise ethernet int timer causes misses
   
   //end of IO init: mostly identical to MinimalBoot.ino setup()
   
   
   myusbHost.begin(); // Start USBHost_t36, HUB(s) and USB devices.

   uint32_t MagNumRead;
   EEPROM.get(eepAdMagicNum, MagNumRead);
   if (MagNumRead != eepMagicNum) SetEEPDefaults();

   IO1 = (uint8_t*)calloc(IO1Size, sizeof(uint8_t)); //allocate IO1 space and init to 0
   IO1[rwRegStatus]        = rsReady;
   IO1[rWRegCurrMenuWAIT] = rmtTeensy;
   IO1[rRegPresence1]     = 0x55;   
   IO1[rRegPresence2]     = 0xAA;   
   for (uint8_t reg=rRegSIDStrStart; reg<rRegSIDStringTerm; reg++) IO1[reg]=' '; 
   IO1[rRegSIDStringTerm] = 0;   
   IO1[rwRegMIDISettings]= EEPROM.read(eepAdMIDISettings);
   IO1[rwRegMIDISettings2]= EEPROM.read(eepAdMIDISettings2);
   IO1[rwRegPwrUpDefaults]= EEPROM.read(eepAdPwrUpDefaults);
   IO1[rwRegPwrUpDefaults2]= EEPROM.read(eepAdPwrUpDefaults2);
   IO1[rwRegPwrUpDefaults3]= EEPROM.read(eepAdPwrUpDefaults3);
   IO1[rwRegTimezone]     = EEPROM.read(eepAdTimezone);  
   for (uint8_t reg=0; reg<NumColorRefs; reg++) IO1[rwRegColorRefStart+reg]=EEPROM.read(eepAdColorRefStart+reg); 
   //IO1[rwRegNextIOHndlr] = EEPROM.read(eepAdNextIOHndlr); //done each entry into menu
   SetUpMainMenuROM();
   //C64 held in reset since SetResetAssert above, and ahead of any autolaunch: a cart started without
   //  the menu gets the right timing from its first cycle.  C64/C128 waits for the menu's report.
   if (TimeVideoStdAtBoot() != 0xff)
   {
      IO1[wRegVid_TOD_Clks] = MeasuredVidStd;
      VidTODClksKnown = rvtcNTSC; //the menu's report adds C64/C128 and 50/60Hz, and doesn't override this
      SetVideoStdDMATiming(MeasuredVidStd);
   }
   MenuChange(); //set up drive path, menu source/size

   for(uint8_t cnt=0; cnt<IOH_Num_Handlers; cnt++) PadSpace(IOHandler[cnt]->Name, IOHNameLength-1); //done so selection shown on c64 overwrites previous

   for(uint8_t cnt=0; cnt<NumPageLinkBuffs; cnt++) PageLinkBuff[cnt] = NULL; //initialize page link buffer for swiftlink browser mode
   for(uint8_t cnt=0; cnt<NumPrevURLQueues; cnt++) PrevURLQueue[cnt] = NULL; //initialize previous link buffer for swiftlink browser mode
   for(uint8_t cnt=0; cnt<RxQueueNumBlocks; cnt++) RxQueue[cnt] = NULL;      //initialize RxQueue for swiftlink

   StrSIDInfo = (char*)calloc(StrSIDInfoSize, sizeof(char)); //SID header info storage
   LatestSIDLoaded = (char*)malloc(MaxPathLength); //Last loaded Source/SID path/filename
   BigBuf = (uint32_t*)malloc(BigBufSize*sizeof(uint32_t));

   char BuildInfo[sizeof SerialStringBuf];
   MakeBuildInfo(BuildInfo, sizeof BuildInfo);
   Serial.printf("\n%s\n%s is on-line\n", BuildInfo, strVersionNumber);
   //USB is up by here. Not gated on a host listening: printing is what clears
   //the report, and minimal's promoteFault() promotes a stale one to $03 on
   //the next extension launch.
   if (CrashReport) Serial.print(CrashReport);
#ifdef VM_EXTENSIONS_ENABLED
   VmFail::printBoot(); //what the last extension launch left in preserved RAM2
#endif
#ifdef Fab04_Features
   Serial.printf("  for Fab 0.4 PCB\n");
#else
   Serial.printf("  for Fab 0.2/0.3 PCB\n");
#endif
   Serial.printf("  PHI2 timed: %s\n", MeasuredVidStd == 0xff ? "not clocking, PAL default" : MeasuredVidStd ? "NTSC" : "PAL");
   Printf_dbg("Debug messages enabled!\n");
   Printf_dbg_sw("Swiftlink debug messages enabled!\n");

   if (IO1[rwRegPwrUpDefaults2] & rpud2NFCEnabled) nfcInit(); //connect to nfc scanner

   if (IO1[rwRegPwrUpDefaults2] & rpud2TRContEnabled) //connect to TR Control device
   {  //takes 200mS typical, 5 seconds if usb serial device not present!
      USBHostSerial.begin(115200, USBHOST_SERIAL_8N1); // 115200 460800 2000000
      Serial.println("USB Host Control Enabled");
      //USBHostSerial.printf("USB Host Serial Control Ready\n");
   }
   
   
   switch (EEPROM.read(eepAdMinBootInd))
   {
      case MinBootInd_SkipMin: //normal first power up
         if (ReadButton!=0) //skip autolaunch checks if button pressed
         {
            uint32_t AutoStartmS = millis();
            if(!CheckLaunchSDAuto()) //if nothing autolaunched from SD autolaunch file
            {
               if ((EEPROM.read(eepAdPwrUpDefaults2) & rpud2TRAutoLaunch) && (ReadButton!=0)) 
               { //If autolaunch enabled & button not pressed
                  EEPRemoteLaunch(eepAdAutolaunchName);
               }
            }
            Printf_dbg("Autolaunch checks: %lumS\n", millis()-AutoStartmS);
         }
         break;
         
      case MinBootInd_LaunchFull: // Launch command received in minimal, launch it from full
         EEPROM.write(eepAdMinBootInd, MinBootInd_SkipMin);
         EEPRemoteLaunch(eepAdCrtBootName);
         break;
         
      default:  //ignore anything else (most likely MinBootInd_FromMin), set back to default for next time 
         EEPROM.write(eepAdMinBootInd, MinBootInd_SkipMin);
         break;
   }
   
   BtnPressed = !ReadButton; //set to current state, could have false triggered from Reset signal on Fab04_
   SetLEDOn;  //done last as indicator of init completion
} 
     
void loop()
{
   const uint8_t NewVidStd = RecheckVideoStd(VidStdRecheckNow);
   VidStdRecheckNow = false;
   if (NewVidStd != 0xff)
   {  //only thread mode writes the register (the menu's report is merged by ApplyMenuVidReport), so nothing to mask
      IO1[wRegVid_TOD_Clks] = (uint8_t)((IO1[wRegVid_TOD_Clks] & ~rvtcNTSC) | NewVidStd);
      VidTODClksKnown |= rvtcNTSC;
      SetVideoStdDMATiming(IO1[wRegVid_TOD_Clks]);
      if (VidTODClksKnown & rvtcC128) SetMachineInfoStr(); //the menu has reported, so the string exists: keep it current
   }

   if (BtnPressed)
   {
      CmdChannel->print("Button detected\n"); 
      SetLEDOn;
      BtnPressed=false;
      IO1[rwRegIRQ_CMD] = ricmdNone; //just to be sure, should already be 0/none
      if (RemoteLaunched)
      {
         IO1[rWRegCurrMenuWAIT] = rmtTeensy;
         MenuChange();
         RemoteLaunched = false;
         Printf_dbg("Remote recovery\n"); 
      }   
      if (IO1[rwRegPwrUpDefaults2] & rpud2NFCEnabled) nfcInit(); //connect to nfc scanner
      SetUpMainMenuROM(); //back to main menu, also sets doReset
   }
   
   if (doReset)
   {
#ifdef DbgSignalSenseReset
      detachInterrupt( digitalPinToInterrupt(DotClk_Debug_PIN) );
#endif
      SetResetAssert;
#ifdef DbgIOTraceLog
      TraceLogMarker(IOTLMrkResetAssert);
#endif
      CmdChannel->println("Resetting C64");
#ifdef DbgIOTraceLog
      PrintResetSnapshot();
#endif
      FlushCmdChannel(CmdChannel);
      delay(50); 
      uint32_t NextInterval = 10000, beginWait = millis();
      bool LEDState = true, DefEEPReboot = false;
      while(ReadButton==0)
      {  //avoid self reset detection, check for long press
         if(millis()-beginWait > NextInterval)
         {
            DefEEPReboot = true;
            NextInterval += 150;
            LEDState = !LEDState;
            if (LEDState) SetLEDOn;
            else SetLEDOff;
         }
      }
      if (DefEEPReboot)
      {
         SetEEPDefaults();
         RebootTR();
      }
#ifdef Fab04_BiDirReset
      SetResetInput;
   #ifdef DbgIOTraceLog
      TraceLogMarker(IOTLMrkResetRelease);  //before the debounce, C64 is already running
   #endif
      delay(50);  //debounce
#else
      SetResetDeassert;
   #ifdef DbgIOTraceLog
      TraceLogMarker(IOTLMrkResetRelease);
   #endif
#endif
      doReset=false;
      BtnPressed = false;
      Phi2ResetReleased(); //re-time PHI2 in a burst: a C64U applies a saved NTSC setting only now

#ifdef DbgSignalSenseReset
      delay(50); 
      attachInterrupt( digitalPinToInterrupt(DotClk_Debug_PIN), isrButton, FALLING );
#endif
   }
  
#ifdef DbgLEDSignalPolling
   static bool LEDLoopState = false;
   if ((LEDLoopState = !LEDLoopState)) SetLEDOn;
   else SetLEDOff;
#endif

#ifdef Fab04_SpecialButton
   if (SpecialBtnBounce.update())
   {  //Special button Change (rise or fall)
      if (fSpecialBtnChange != NULL) fSpecialBtnChange(SpecialBtnBounce.read());
   }
#endif

   if (isFrozen)
   {
      static uint32_t FrozenFlashmS = millis();
      static bool FrozenLEDState = true;
   
      if(millis()-FrozenFlashmS > 100)
      {
         FrozenFlashmS = millis();
         if ((FrozenLEDState = !FrozenLEDState)) SetLEDOn;
         else SetLEDOff;
      }
      
   }
   
   if (Serial.available()) ServiceSerial(&Serial);
   myusbHost.Task();
   
   if (nfcState == nfcStateEnabled) nfcCheck();
   
   if (IO1[rwRegPwrUpDefaults2] & rpud2TRContEnabled)
      if (USBHostSerial.available()) ServiceSerial(&USBHostSerial);

#ifdef Fab04_KernalReplace
   if (FnetPollHold || FnetLoopPoll) FnetLoopPollService();
#endif

#ifdef FeatTCPListen
   if (NetListenEnable)
   {
      if(!tcpClient)
      {
        tcpClient = tcpServer.available();

        if(tcpClient)
        {
          IPAddress ip = tcpClient.remoteIP();
          Printf_dbg("New TCP Client, IP: %d.%d.%d.%d\n", ip[0], ip[1], ip[2], ip[3]);
        }
      }
      if (tcpClient) ServiceTCP(tcpClient);
   }

#endif
 
   //handler specific polling items:
   if (IOHandler[CurrentIOHandler]->PollingHndlr != NULL) IOHandler[CurrentIOHandler]->PollingHndlr();
}

#ifdef Fab04_KernalReplace
FLASHMEM void FnetLoopPollService()
{  //While Kernal Replace serves the KERNAL, run the Ethernet stack poll from here instead of NativeEthernet's 1ms PIT timer ISR:
   //with the poll in the PIT interrupt, ~39 phi2 interrupts/s were late (>1.1us) even with the GPIO interrupt at a higher priority,
   //and a late one on the HIRAM sense after a $01 write corrupts the read; called from loop() they are down to about one every 2s.
   //(The PIT is only used by that timer, except for ASID, which masks it itself.)
   static uint32_t lastPollUs = 0;
   bool want = FnetPollHold && (fnet_netif_get_default() != 0); //KERNAL served (hold) and stack initialized
   if (want != FnetLoopPoll)
   {
      FnetLoopPoll = want;
      if (want) NVIC_DISABLE_IRQ(IRQ_PIT); else NVIC_ENABLE_IRQ(IRQ_PIT);
   }
   if (FnetLoopPoll && micros() - lastPollUs >= 1000)
   {
      lastPollUs = micros();
      fnet_poll();
   }
}
#endif

FLASHMEM void SetUpMainMenuROM()
{
   PendingfBusSnoop = fBusSnoop = NULL;
#ifdef Fab04_GlobalKernalReplace
   fKernRepl = NULL;
#endif
#ifdef Fab04_KernalReplace
   FnetPollHold = FnetLoopPoll = false; //the PIT is re-enabled below
#endif
   SetDMADeassert;
   SetIRQDeassert;
   SetNMIDeassert;
   SetGameDeassert;
   SetExROMAssert; //emulate 8k cart ROM
   LOROM_Image = TeensyROMC64_bin;
   HIROM_Image = NULL;
   LOROM_Mask = HIROM_Mask = 0x1fff;
   NVIC_ENABLE_IRQ(IRQ_ENET); //make sure ethernet interrupt is back on
   NVIC_ENABLE_IRQ(IRQ_PIT);
   EmulateVicCycles = false;
   nfcState &= ~nfcStateBitPaused; //clear paused bit in case paused by time critical function
   
   FreeCrtChips();
#ifdef Fab04_REU
   FreeREU();
#endif
   FreeGeoRAM();
   TRBlockUnmount();
   FreeSwiftlinkBuffs();
   RedirectEmptyDriveDirMenu();
   free((void*)MIDIRxBuf); MIDIRxBuf=NULL;
   free(TgetQueue); TgetQueue=NULL;
   free(LSFileName); LSFileName=NULL;
   IOHandlerInit(IOH_TeensyROM);  
   SetLEDOn;   //can be turned off by pause or some CRTs (ie EZF)
   
   switch (IO1[rwRegPwrUpDefaults2] & rpud2AltBtnActionMask)
   {
      case rpud2AltBtnAutoLaunch:
         fSpecialBtnChange = &SpecialBtn_AutoLaunch;
         break;
      case rpud2AltBtnPause:
         fSpecialBtnChange = &SpecialBtn_Pause;
         break;
      case rpud2AltBtnTRMenu:
         fSpecialBtnChange = &SpecialBtn_TRMenu;
         break;
      case rpud2AltBtnRebootTR:
         fSpecialBtnChange = &SpecialBtn_RebootTR;
         break;
      //case rpud2AltBtnNone:
      default:
         fSpecialBtnChange = NULL;
         break;
   }
   
   isFrozen = false;
   doReset = true;
   //Every return to the menu calls this. Clear after setting doReset: the old menu keeps running until the loop
   //  asserts /RESET, and rCtlBootComplete is ignored while doReset is set, so the old menu can't set it again.
   BootComplete = false;
}

FLASHMEM void PadSpace(char* StrToPad, uint8_t PadToLength)
{
   while(strlen(StrToPad)<PadToLength) strcat(StrToPad, " ");
}

FLASHMEM void EEPwriteNBuf(uint16_t addr, const uint8_t* buf, uint16_t len)
{
   while (len--) EEPROM.write(addr+len, buf[len]);    
}

FLASHMEM void EEPwriteStr(uint16_t addr, const char* buf)
{
   EEPwriteNBuf(addr, (uint8_t*)buf, strlen(buf)+1); //include terminator    
}

FLASHMEM void EEPreadNBuf(uint16_t addr, uint8_t* buf, uint16_t len)
{
   while (len--) buf[len] = EEPROM.read(addr+len);   
}

FLASHMEM void EEPreadStr(uint16_t addr, char* buf)
{
   uint16_t CharNum = 0;
   
   do
   {
      buf[CharNum] = EEPROM.read(addr+CharNum); 
   } while (buf[CharNum++] !=0); //end on termination, but include it in buffer
}

FLASHMEM void SetEEPDefaults()
{
   CmdChannel->println("--> Setting EEPROM to defaults");
   EEPROM.write(eepAdPwrUpDefaults, 0x90); //default: music on, eth time synch off, hide extensions, 12 hour clock, med js speed (9/15), see RegPowerUpDefaultMasks
   EEPROM.write(eepAdPwrUpDefaults3, 0x00); //default: Reset Detect enabled, TR+ REU with SSv5/RR/FC3-101% enabled, see bit mask defs RegPowerUpDefaultMasks3
   EEPROM.write(eepAdTimezone, 0); //default to GMT (Greenwich Mean Time)
   EEPROM.write(eepAdNextIOHndlr, IOH_None); //default to no Special HW
   SetEthEEPDefaults();
   EEPROM.write(eepAdDefaultSID, DefSIDSource);  
   EEPwriteStr(eepAdDefaultSID+1, DefSIDPath);
   EEPwriteStr(eepAdDefaultSID+strlen(DefSIDPath)+2, DefSIDName);  
   EEPROM.write(eepAdMinBootInd, MinBootInd_SkipMin);
   EEPwriteStr(eepAdAutolaunchName, "TR:/Test+Diags/DesTestMAX:  Desmond's RAM Test"); //default auto Launch file
   //default color scheme:
   EEPROM.write(eepAdColorRefStart+EscBackgndColor , PokeBlack  ); 
   EEPROM.write(eepAdColorRefStart+EscBorderColor  , PokePurple ); 
   EEPROM.write(eepAdColorRefStart+EscTRBannerColor, PokePurple ); 
   EEPROM.write(eepAdColorRefStart+EscTimeColor    , PokeLtRed  ); 
   EEPROM.write(eepAdColorRefStart+EscOptionColor  , PokeYellow ); 
   EEPROM.write(eepAdColorRefStart+EscSourcesColor , PokeLtBlue ); 
   EEPROM.write(eepAdColorRefStart+EscNameColor    , PokeLtGreen); 
   //hot key defaults:
   EEPwriteStr(eepAdHotKeyPaths+0*MaxPathLength, "TR:/MIDI + ASID/Cynthcart 2.0.1       +Datel MIDI"); 
#ifdef Fab04_REU
   EEPROM.write(eepAdPwrUpDefaults2, rpud2AltBtnAutoLaunch); //default: TCP Listen Off, Auto-Launch Off, NFC & Serial TRCont off, Alt button: Autolaunch, see see bit mask defs RegPowerUpDefaultMasks2
   EEPwriteStr(eepAdHotKeyPaths+1*MaxPathLength, "TR:/Test+Diags/REU-Checker v1.0            +REU"); 
   EEPROM.write(eepAdKERNALBinName, 0); //No default Kernal Selection
   EEPwriteStr(eepAdREUFilename, "SD:/reu.reu"); //Default REU File Name needed for saving
#else
   EEPROM.write(eepAdPwrUpDefaults2, rpud2AltBtnNone); //default: TCP Listen Off, Auto-Launch Off, NFC & Serial TRCont off, Alt Button: None, see see bit mask defs RegPowerUpDefaultMasks2
   EEPwriteStr(eepAdHotKeyPaths+1*MaxPathLength, "TR:/MIDI + ASID/Station64 2.6      +Passport MIDI"); 
   EEPwriteStr(eepAdKERNALBinName, "TR+ Only"); 
   EEPwriteStr(eepAdREUFilename, "TR+ Only"); 
#endif
   EEPwriteStr(eepAdHotKeyPaths+2*MaxPathLength, "TR:/Utilities/CCGMS 2021 Term       +SwiftLink "); 
   EEPwriteStr(eepAdHotKeyPaths+3*MaxPathLength, "TR:/MIDI + ASID/TeensyROM ASID Player    +TR ASID"); 
   EEPwriteStr(eepAdHotKeyPaths+4*MaxPathLength, "TR:/Games/Jupiter Lander"); 
   
   EEPROM.write(eepAdMIDISettings, 0xff);  //see RegMIDISettingsMasks
   EEPROM.write(eepAdMIDISettings2, 0x0f); //see RegMIDISettingsMasks2
   
   //future use:
   for(uint32_t EEPByteNum = 0; EEPByteNum<eepAdUnusedSize ; EEPByteNum++)
      EEPROM.write(eepAdUnused+EEPByteNum, 0);
   
   EEPROM.put(eepAdMagicNum, (uint32_t)eepMagicNum); //set this last in case of power down, etc.
}

void SetMenu(StructMenuItem* Source, uint16_t NumItems)
{
   MenuSource = Source;
   NumItemsFull = NumItems;
   SelItemFullIdx = 0; //UpdateItemTypeReg reads MenuSource[SelItemFullIdx] before the C64 selects in the new menu
   IO1[rRegNumItemsOnPage] = (NumItems > MaxItemsPerPage ? MaxItemsPerPage : NumItems);
   IO1[rwRegPageNumber] = 1;
   IO1[rRegNumPages] =
      NumItems/MaxItemsPerPage +
      (NumItems%MaxItemsPerPage!=0 ? 1 : 0) +
      (NumItems==0 ? 1 : 0);
}

// Known only once the menu has reported the machine, which it does before the user can select anything
FLASHMEM bool HostIsC128()
{
   return VidTODClksKnown & IO1[wRegVid_TOD_Clks] & rvtcC128;
}

// Whether a card is in the slot, from card detect on DAT3. Takes the pin back from the
// SD controller first, so it reads true whoever had it last, a failed SD.begin included.
// The pin is left a pulldown input, as the SD library itself leaves it when a card is
// gone; SD.begin muxes it back to the controller, and every caller that reads true goes
// on to begin.
FLASHMEM bool SDSlotFilled()
{
   // _SD_DAT3 = pin 46
   pinMode(46, INPUT_PULLDOWN);
   delayMicroseconds(5); //let the pulldown settle before reading; see PaulStoffregen/SD@c535ae9
   return digitalReadFast(46);
}

bool SDBegin()
{
   //SD.begin(BUILTIN_SDCARD), ending any read left open first.  In FIFO mode SdFat leaves a
   //  multi-block read (CMD18) running after every read, the mount's included, until a file
   //  close ends it with CMD12; a failed open (e.g. no autolaunch.txt) closes nothing.
   //  SD.begin then resets the card (CMD0) mid-read, which leaves some cards unresponsive
   //  until they lose power.
   SdCard *Card = SD.sdfs.card(); //NULL until the first SD.begin
   if (Card) Card->syncDevice();  //CMD12 only if a read or write is open
   return SD.begin(BUILTIN_SDCARD);
}

bool SDBeginRetrying()
{

   // begin() takes 3 seconds for fail, 20-200mS for pass, 2 seconds for unpopulated
   
   uint8_t Count = 2; //Max number of begin attempts
   uint32_t Startms = millis();
   
   Printf_dbg("[=][=][=][=][=][=][=][=][=][=][=][=][=][=][=][=][=][=][=][=][=][=][=][=][=][=][=][=][=][=][=][=][=][=][=][=][=][=][=][=][=][=][=][=][=]\n");  
   Printf_dbg("Start mediaPresent %d\n", SD.mediaPresent()); //This indicates zero regardless of actual prior to begin()
    
   while (!SDBegin()) 
   {
      Count--;
      Printf_dbg("SD Init fail, %d tries left. Time: %lu mS\n", Count, millis()-Startms);
      if (SD.mediaPresent() == 0)
      {
         Printf_dbg("SD Not Present, Fail!  took %lu mS\n", millis()-Startms);
         return false;
      }
      if (Count == 0)
      {
         Printf_dbg("Out of tries, Fail!  took %lu mS\n", millis()-Startms);
         return false;
      }
   }
   
   Printf_dbg("SD Init OK, took %lu mS, mediaPresent %d\n", millis()-Startms, SD.mediaPresent());
   return true;
}

bool SDFullInit()
{
   bool Began;

   TRBlockClose();
   Began = SDBeginRetrying();
   TRBlockReopen();
   return Began;
}

bool USBFileSystemWait()
{
   //wait for USB file system to init in case it's needed by startup SID or auto-launched
   // ~7mS for direct connect, ~1000mS for connect via hub, 1500mS timeout (drive not found)
   uint32_t StartMillis = millis();

   Printf_dbg("[=][=][=][=][=][=][=][=][=][=][=][=][=][=][=][=][=][=][=][=][=][=][=][=][=][=][=][=][=][=][=][=][=][=][=][=][=][=][=][=][=][=][=][=][=]\n");  
   
   while (!firstPartition && millis()-StartMillis < 1500) myusbHost.Task();
   
   if(firstPartition) 
   {
      Printf_dbg("%dmS to init USB drive\n", millis()-StartMillis); 
      return true;
   }

   Printf_dbg("USB drive not found!\n");  
   return false;
}

void SetRandomSeed()
{
   //Set the Random Seed once the first time it is called (set to cycle count)
   static bool SetOnce = false;
   
   if (SetOnce) return;
   
   SetOnce = true;
   Printf_dbg("Setting Random Seed\n");
   randomSeed(ARM_DWT_CYCCNT);
}

bool CheckLaunchSDAuto()
{         
   //returns true only if file launched
   
   // SD not present: 0mS
   // autolaunch.txt Not Found: 9-10mS
   // Launch file name too short: 10mS
   // Launch file attempted, not found: 39mS
   // Autolaunch file found, launch set-up: 10mS
   
   if (SDSlotFilled())
   {  //SD Presence detected, do full init and check for auotlaunch file    
      Printf_dbg("SD Presence detected\n");
      if (SDFullInit())
      {
         File AutoLaunchFile = SD.open("autolaunch.txt", FILE_READ);
         if (!AutoLaunchFile) 
         {
            Printf_dbg("autolaunch.txt Not Found\n");
            return false;
         }
         
         char AutoFileName[MaxPathLength];
         uint16_t CharNum = 0;
         char NextChar = 1;
         
         while (NextChar)
         {
            if(AutoLaunchFile.available()) NextChar = AutoLaunchFile.read();
            else NextChar = 0;
            
            if (NextChar=='\r' || NextChar=='\n' || CharNum == MaxPathLength-1) NextChar = 0;           
            
            AutoFileName[CharNum++]=NextChar;
         }
         AutoLaunchFile.close();
         
         Printf_dbg("SD First line: %d chars \"%s\"\n", CharNum, AutoFileName); 
         
         if (CharNum<6) 
         {
            Printf_dbg("Filename too short\n");
            return false;
         }

         char * ptrAutoFileName = AutoFileName; //pointer to move past SD/USB/TR:
         RegMenuTypes SourceID = RegMenuTypeFromFileName(&ptrAutoFileName);
         
         Printf_dbg("SD Autolaunch %d \"%s\"\n", SourceID, ptrAutoFileName); 
         
         //check if file exists????????????
         
         RemoteLaunch(SourceID, ptrAutoFileName, true); //do CRT directly 
         return true;
      }  //SD init
      else Printf_dbg("SDFullInit fail\n");
   }  //SD presence
   else Printf_dbg("No SD detected\n");

   return false;
}


FLASHMEM void SpecialBtn_AutoLaunch(bool Up_nDn)
{
   if (!Up_nDn) //button pressed down
   {
      EEPRemoteLaunch(eepAdAutolaunchName);
      Printf_dbg("SpecialBtn_AutoLaunch\n");
   }
}

FLASHMEM void SpecialBtn_Pause(bool Up_nDn)
{
   if (!Up_nDn) //button pressed down
   {
      if ((isFrozen = !isFrozen))
      {
         DMA_State = DMA_S_StartAsynch; 
         //led will flash on/off
      }
      else 
      {
         DMA_State = DMA_S_StartDisable;
         SetLEDOn;
      }
      Printf_dbg("SpecialBtn_Pause\n");
   }
}

FLASHMEM void SpecialBtn_TRMenu(bool Up_nDn)
{
   if (!Up_nDn) //button pressed down
   {
      BtnPressed = true;
      Printf_dbg("SpecialBtn_TRMenu\n");
   }
}

FLASHMEM void SpecialBtn_RebootTR(bool Up_nDn)
{
   if (!Up_nDn) //button pressed down
   {
      RebootTR();
      Printf_dbg("SpecialBtn_RebootTR\n");
   }
}
