SensoriumEmbedded/TeensyROM/Source/Teensy/DriveDirLoad.ino

// MIT License
// 
// Copyright (c) 2024 Travis Smith
// 
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

#include "MinimalBoot/Common/C128Crt.h"
#ifdef VM_EXTENSIONS_ENABLED
#include "MinimalBoot/Common/VMLaunch.h"
#include "MinimalBoot/Common/VMPackageList.h"
#endif

//False when path and name do not both fit; the record is then marked SIDRecordUnstorable
FLASHMEM bool SetLatestSIDLoaded(uint8_t Source, const char* Path, const char* Name)
{  //source byte, then path and name, each terminated, packed into MaxPathLength
   LatestSIDLoaded[0] = Source;
   int PathLen = snprintf(LatestSIDLoaded + 1, MaxPathLength - 2, "%s", Path);
   size_t NameOffset = strlen(LatestSIDLoaded + 1) + 2;
   int NameLen = snprintf(LatestSIDLoaded + NameOffset, MaxPathLength - NameOffset, "%s", Name);
   if (PathLen >= 0 && PathLen < MaxPathLength - 2 &&
       NameLen >= 0 && (size_t)NameLen < MaxPathLength - NameOffset) return true;

   LatestSIDLoaded[0] = SIDRecordUnstorable;
   LatestSIDLoaded[1] = LatestSIDLoaded[2] = 0;
   return false;
}

//A cut-short path names a different directory, so refuse rather than truncate
bool DriveDirPathRoomFor(const char *Name, size_t Extra)
{
   if (strlen(DriveDirPath) + strlen(Name) + Extra < MaxPathLength) return true;
   SendMsgPrintfln("Path too long to open:\r\n%s", Name);
   return false;
}

// A remote file command changed storage under a listing the C64 has already
// painted. The C64 selects by item number and the firmware cannot repaint it,
// so rebuilding at the command would resolve painted numbers against a list
// they no longer match. Rebuilding here and refusing the launch instead routes
// the C64 through MainMenu.asm's ListAndDone, which reprints from the new list.
FLASHMEM bool ApplyRemoteFileChanges()
{
   const uint8_t LoadedDevice = IO1[rWRegCurrMenuWAIT];
   const bool Reload = RemoteChangedLoadedDir &&
                       LoadedListing::reloadable(LoadedDevice, DriveDirPath);

   RemoteChangedLoadedDir = false;

#ifdef VM_EXTENSIONS_ENABLED
   // Extension routing reads a table built from /VMS, not from the listing, so
   // rebuilding it changes nothing the C64 has painted and needs no reprint.
   // LoadDirectory does it for us when the listing is being rebuilt anyway.
   // The type column does read the table, so its marks are rebuilt with it.
   if (RemoteChangedSDCard && !Reload && LoadedDevice == rmtSD) { VmRegistry::refresh(true); MarkVmClaimed(); }
   RemoteChangedSDCard = false;
#endif

   if (!Reload) return false;

   FS *sourceFS = &firstPartition;
   if (LoadedDevice == rmtSD) sourceFS = &SD;
   LoadDirectory(sourceFS);
   IO1[rwRegCursorItemOnPg] = 0;
   SendMsgPrintfln("Files changed\r\nDirectory reloaded");
   return true;
}

#ifdef VM_EXTENSIONS_ENABLED
// Which unknown files in DriveDirMenu a /VMS package claims, so the menu shows
// their own extension as the type, not "Unk". The table only knows SD, and the
// entries of a disk image (a path ending in '*') are not files HandleExecution
// routes, so neither gets a mark.
FLASHMEM void MarkVmClaimed()
{
   memset(VmClaimedItems, 0, sizeof VmClaimedItems);
   const size_t PathLen = strlen(DriveDirPath);
   if (!PathLen || DriveDirPath[PathLen-1] == '*') return;
   for (uint16_t Num = 0; Num < NumDrvDirMenuItems; Num++)
      if (DriveDirMenu[Num].ItemType == rtUnknown &&
          VmRegistry::associated(DriveDirMenu[Num].Name) == VmRegistry::Associated)
         VmClaimedItems[Num/8] |= 1 << Num%8;
}

// Whether a card is in the slot, from card detect on DAT3. CheckLaunchSDAuto's check
// (Teensy.ino), copied rather than shared so that boot stayed untouched for the 0.9
// release. It takes the pin back first, so it reads true whoever had it last, a failed
// SD.begin included.
FLASHMEM bool SDSlotFilled()
{
   // _SD_DAT3 = pin 46
   pinMode(46, INPUT_PULLDOWN);
   delayMicroseconds(5); //let the pulldown settle before reading; see PaulStoffregen/SD@c535ae9
   return digitalReadFast(46);
}

// rsShowExtPackages (StatusFunctions.c), for the Installed Extension page. Here rather
// than beside the other status functions because that file is included ahead of the
// registry. Reads the card whatever the menu's source is.
FLASHMEM void ShowVmPackages()
{
   //The card in the slot as it is now, so each draw of the page shows the card as it is.
   //This, not a read, is what says there is a card: SdFat still opens the root directory
   //of one that has been pulled.
   //
   //First the card that was begun, if any, asked for its status: one command, the one
   //SD.mediaPresent starts with. It fails when that card has been removed or swapped, and
   //there is none after a return from an extension, whose boot skips the SD setup.
   //Not SD.mediaPresent itself: after a failed SD.begin it reads card detect while the
   //SD controller still has the pin, and then tries a full restart, two seconds or more.
   //A card that answers is only usable with its filesystem mounted: SD.begin starts the
   //card and then mounts it, and a card whose mount failed (unformatted, say) still
   //answers.
   SdCard *Begun = SD.sdfs.card();
   bool Card = Begun && Begun->status() && SD.sdfs.fatType();
   if (!Card && SDSlotFilled())
   {
      //Begun here, with one retry while the slot still reads filled: the retry
      //SDFullInit makes, because a card's first start can fail. Nothing is remembered
      //between draws, so a card that will not start costs both attempts on each one.
      Card = SD.begin(BUILTIN_SDCARD) || (SDSlotFilled() && SD.begin(BUILTIN_SDCARD));
      //A card started here in place of one that had been begun: whatever the menu holds
      //from that one is stale, its listing and the extension table built from it. The
      //flags remote file commands raise for the same reason make the menu's next
      //selection reload rather than launch from it (ApplyRemoteFileChanges). Only on a
      //change, so an empty slot does not refuse a selection on every visit; a card
      //pulled and put back reloads once, harmlessly.
      if (Card && Begun)
      {
         RemoteChangedSDCard = true;
         if (IO1[rWRegCurrMenuWAIT] == rmtSD) RemoteChangedLoadedDir = true;
      }
   }

   VmHostId Host{};
   const bool Installed = VmBootImage::installed();
   const bool Described = Installed && VmBootImage::identity(Host);
   VmPackageList::show(Card, Described ? &Host : nullptr, Installed,
                       VmFail::captureValid ? &VmFail::captured : nullptr);
}
#endif

void FullPathToSelected(char *Path, size_t Size, const char *Name)
{
   if (PathIsRoot()) snprintf(Path, Size, "/%s", Name);  // at root
   else snprintf(Path, Size, "%s/%s", DriveDirPath, Name);
}

FLASHMEM void HandleExecution()
{
   IO1[rRegStrAvailable] = 0;    // default transfer start flag to stop in case of previous abort (such as text read abort)

   if (ApplyRemoteFileChanges()) return;

   StructMenuItem MenuSelCpy = MenuSource[SelItemFullIdx]; //local copy selected menu item to modify

#ifdef VM_EXTENSIONS_ENABLED
   // Existing browser and item types are unchanged. Intercept only physical SD
   // files, before the unknown-file fallback and the ordinary cartridge parser.
   // Anything that is not an extension package falls straight through.
   if (IO1[rWRegCurrMenuWAIT] == rmtSD && MenuSelCpy.ItemType != rtDirectory &&
       DriveDirPath[0] && DriveDirPath[strlen(DriveDirPath)-1] != '*' &&
       VmLaunch::tryFile(rmtSD, DriveDirPath, MenuSelCpy.Name)) return;
#endif
   
   if (MenuSelCpy.ItemType == rtNone) //should no longer reach here
   {
      SendMsgPrintfln("%s\r\nis not a valid item", MenuSelCpy.Name);
      return;
   }
   if (MenuSelCpy.ItemType == rtUnknown)
   {
      SendMsgPrintfln("%s\r\nUnknown File Type", MenuSelCpy.Name);
      MenuSelCpy.ItemType = rtFilePrg; // assume PRG on unknown file type, attempt to launch
      //return;
   }
   
   FS *sourceFS = &firstPartition;
   switch(IO1[rWRegCurrMenuWAIT]) 
   {  //find source based on current menu, perform device specific actions
      case rmtSD:
         sourceFS = &SD;
      case rmtUSBDrive:
         //USB or SD drive actions:
         if (MenuSelCpy.ItemType == rtFileHex)  //FW update from hex file
         {
            char FullFilePath[MaxNamePathLength];
            
            FullPathToSelected(FullFilePath, sizeof FullFilePath, MenuSelCpy.Name);
            DoFlashUpdate(sourceFS, FullFilePath);
            return;  //we're done here...
         }
         
#ifdef VM_EXTENSIONS_ENABLED
         if (MenuSelCpy.ItemType == rtFileTRH)  //extension host install from package
         {
            char FullFilePath[MaxNamePathLength];
            
            FullPathToSelected(FullFilePath, sizeof FullFilePath, MenuSelCpy.Name);
            DoHostInstall(sourceFS, FullFilePath);
            return;  //we're done here...
         }
#endif
         
         if (MenuSelCpy.ItemType == rtDirectory)
         {  //edit path as needed and load the new directory from SD/USB
            
            if(strcmp(MenuSelCpy.Name, UpDirString)==0)
            {  //up dir
               UpDirectory();
               return;  //we're done here...
            }
            
            if (!DriveDirPathRoomFor(MenuSelCpy.Name, 0)) return;
            strcat(DriveDirPath, MenuSelCpy.Name); //append selected dir name
            LoadDirectory(sourceFS); 
            return;  //we're done here...
         }
         
         if (MenuSelCpy.ItemType == rtD64 ||
             MenuSelCpy.ItemType == rtD71 ||
             MenuSelCpy.ItemType == rtD81)
         {  //edit path as needed and load the new directory from SD/USB
            if (!DriveDirPathRoomFor(MenuSelCpy.Name, 2)) return; //the "/" before, the "*" after
            strcat(DriveDirPath, "/"); 
            strcat(DriveDirPath, MenuSelCpy.Name); //append selected d64 name as a dir
            LoadDxxDirectory(sourceFS, MenuSelCpy.ItemType); 
            strcat(DriveDirPath, "*"); //mark to indicate d64 file instead of "real" dir
            SetMenu(DriveDirMenu, NumDrvDirMenuItems);
            return;  //we're done here...
         }
         
         if(DriveDirPath[strlen(DriveDirPath)-1] == '*')
         { //load from D64/71/81 file
            if(!LoadDxxFile(&MenuSelCpy, sourceFS)) return;
         }
         else 
         {
            if(!LoadFile(sourceFS, DriveDirPath, &MenuSelCpy)) return;     
         }
         
         MenuSelCpy.Code_Image = RAM_Image;
         break;
         
      case rmtTeensy:  
         // local Teensy Flash menu actions
         // not many size checks as this is loading internally
         
         if (MenuSelCpy.ItemType == rtDirectory)
         {
            if(strcmp(MenuSelCpy.Name, UpDirString)==0) MenuChange(); //only 1 level, returning to root
            else 
            {
               SetMenu((StructMenuItem*)MenuSelCpy.Code_Image, MenuSelCpy.Size/sizeof(StructMenuItem));
               strcat(DriveDirPath, MenuSelCpy.Name); //append selected dir name
            }
            return;
         }
         
         SendMsgPrintfln("%s", MenuSelCpy.Name);
         if (MenuSelCpy.ItemType == rtFileCrt)
         {  //load the CRT into RAM
            uint8_t EXROM;
            uint8_t GAME;
            
            //load header and parse (sends error messages)
            if (!ParseCRTHeader(&MenuSelCpy, &EXROM, &GAME)) return;
            
            //IO1[rwRegNextIOHndlr] is now assigned from crt!
            //process Chip Packets
            uint8_t *ptrChipOffset = MenuSelCpy.Code_Image + CRT_MAIN_HDR_LEN; //Skip header
            FreeCrtChips();  //clears any previous and resets NumCrtChips
            Printf_dbg("\n Chp# Length    Type  Bank  Addr  Size\n");
            while (MenuSelCpy.Code_Image + MenuSelCpy.Size - ptrChipOffset > 1) //allow for off by 1 sometimes caused by bin2header
            {
               if (!ParseChipHeader(ptrChipOffset, "")) //sends error messages
               {
                  FreeCrtChips();
                  IO1[rwRegNextIOHndlr] = EEPROM.read(eepAdNextIOHndlr);  //in case it was over-ridden by .crt
                  return;        
               }
               ptrChipOffset += CRT_CHIP_HDR_LEN;
               memcpy(CrtChips[NumCrtChips].ChipROM, ptrChipOffset, CrtChips[NumCrtChips].ROMSize);
               ptrChipOffset += CrtChips[NumCrtChips].ROMSize;
               NumCrtChips++;
            }
            
            //check configuration (sends error messages)
            if (!SetTypeFromCRT(&MenuSelCpy, EXROM, GAME)) 
            {
               IO1[rwRegNextIOHndlr] = EEPROM.read(eepAdNextIOHndlr);  //in case it was over-ridden by .crt
               return;
            }
         }
         
         else
         {  //non-CRT: copy the whole thing from flash into the RAM1 buffer
            memcpy(RAM_Image, MenuSelCpy.Code_Image, MenuSelCpy.Size);
            MenuSelCpy.Code_Image = RAM_Image;   
         }            
         SendMsgPrintfln("Copied to RAM"); 
         break;
         
   }
   
   //Have to do this differently for Flash vs ext media:
   // if (MenuSelCpy.ItemType == rtFileCrt) ParseCRTFile(&MenuSelCpy); //will update MenuSelCpy.ItemType & .Code_Image, if checks ok
 
   //will update MenuSelCpy.ItemType & .Code_Image, if checks ok:
   if (MenuSelCpy.ItemType == rtFileP00) ParseP00File(&MenuSelCpy); 
   
   //has to be distilled down to one of these by this point, only ones supported so far.
   //Emulate ROM or prep for transfer
   uint8_t CartLoaded = false;
   //a C128 cart widens these, and a direct remote launch skips SetUpMainMenuROM, which resets them
   LOROM_Mask = HIROM_Mask = 0x1fff;

   switch(MenuSelCpy.ItemType)
   {
      case rtFileSID:
      {
         XferImage = MenuSelCpy.Code_Image;
         XferSize = MenuSelCpy.Size;
         
         //save source/path/name for later use
         const char* SIDPath = DriveDirPath;
         if(IO1[rWRegCurrMenuWAIT] == rmtTeensy)
         { // built-in SID
            //figure out what menu dir we're in
            SIDPath = "/";
            if (MenuSource != TeensyROMMenu)
            {
               //find sub-dir
               uint8_t DirNum = 0;
               while(MenuSource != (StructMenuItem*)TeensyROMMenu[DirNum].Code_Image)
               {
                  //MenuSelCpy.Code_Image;
                  if (++DirNum == sizeof(TeensyROMMenu)/sizeof(TeensyROMMenu[0]))
                  {
                     Printf_dbg("TR Dir not found\n"); //what now?
                     DirNum = 3;  //choose SID dir?
                     break;
                  }
               }
               SIDPath = TeensyROMMenu[DirNum].Name;
            }
         }
         if (!SetLatestSIDLoaded(IO1[rWRegCurrMenuWAIT], SIDPath, MenuSelCpy.Name))
            Serial.printf("SID path too long to keep as background SID\n");
         Printf_dbg("Saved SID: %d %s / %s\n", LatestSIDLoaded[0], LatestSIDLoaded+1, LatestSIDLoaded+strlen(LatestSIDLoaded+1)+2);
                  
         ParseSIDHeader(MenuSelCpy.Name); //Parse SID File & set up to transfer to C64 RAM
         break;
      }
      case rtFileKla:
         XferImage = MenuSelCpy.Code_Image;
         XferSize = MenuSelCpy.Size;
         //Parse Koala File:
         if(!ParseKLAHeader()) return;
         StreamOffsetAddr = 0; //set to start of data
         IO1[rRegStrAvailable] = 0xff;    // transfer start flag, set last    
         break;
      case rtFileArt:
         XferImage = MenuSelCpy.Code_Image;
         XferSize = MenuSelCpy.Size;
         //Parse Hi-Res Art File:
         if(!ParseARTHeader()) return;
         StreamOffsetAddr = 0; //set to start of data
         IO1[rRegStrAvailable] = 0xff;    // transfer start flag, set last    
         break;
      case rtFilePETSCII:
      case rtFileTxt:
         XferImage = MenuSelCpy.Code_Image;
         XferSize = MenuSelCpy.Size;
         //convert from ASCII to PETSCII if needed:
         if (MenuSelCpy.ItemType==rtFileTxt) for(uint32_t Cnt=0; Cnt<XferSize; Cnt++) XferImage[Cnt]=ToPETSCII(XferImage[Cnt]);
         StreamOffsetAddr = 0; //set to start of data
         IO1[rRegStrAvailable] = 0xff;    // transfer start flag, set last    
         break;
      case rtBin16k:
         SetGameAssert;
         SetExROMAssert;
         LOROM_Image = MenuSelCpy.Code_Image;
         HIROM_Image = MenuSelCpy.Code_Image+0x2000;
         CartLoaded=true;
         break;
      case rtBin8kHi:
         SetGameAssert;
         SetExROMDeassert;
         LOROM_Image = NULL;
         HIROM_Image = MenuSelCpy.Code_Image;
         CartLoaded=true;
         NVIC_DISABLE_IRQ(IRQ_ENET); //disable ethernet interrupt when emulating VIC cycles
         NVIC_DISABLE_IRQ(IRQ_PIT);
         EmulateVicCycles = true;
         break;
      case rtBin8kLo:
         SetGameDeassert;
         SetExROMAssert;
         LOROM_Image = MenuSelCpy.Code_Image;
         HIROM_Image = NULL;
         CartLoaded=true;
         break;
      case rtBinC128:
         LaunchC128Cart();
         CartLoaded=true;
         break;      
      case rtFilePrg:
         //set up for transfer
         SendMsgPrintfln("PRG xfer %luK to $%04x:$%04x\n", 
            MenuSelCpy.Size/1024,
            256*MenuSelCpy.Code_Image[1]+MenuSelCpy.Code_Image[0], 
            MenuSelCpy.Size + 256*MenuSelCpy.Code_Image[1]+MenuSelCpy.Code_Image[0]);
         XferImage = MenuSelCpy.Code_Image; 
         XferSize  = MenuSelCpy.Size; 
         StreamOffsetAddr = 0; //set to start of data
         IO1[rRegStrAvailable] = 0xff;
         break;
      case rtUnknown: //had to have been marked unknown after check at start
         //SendMsgFailed();
         SendMsgPrintfln(" :(");
         break;
      default:
         SendMsgPrintfln("Unk Item Type: %d", MenuSelCpy.ItemType);
         break;
   }
   
   if (CartLoaded)
   {
      BootComplete = true; //C64 resets straight into the cart; when started without the menu (autolaunch, relaunch from MinimalBoot) nothing else sets it
      doReset=true;
      IOHandlerSelectInit();
   }

}

void MenuChange()
{
   strcpy(DriveDirPath, "/");
   switch(IO1[rWRegCurrMenuWAIT])
   {
      case rmtTeensy:
         SetMenu(TeensyROMMenu, sizeof(TeensyROMMenu)/sizeof(TeensyROMMenu[0]));
         break;
      case rmtSD:
         SDBegin(); // refresh, takes 3 seconds for fail/unpopulated, 20-200mS populated
         LoadDirectory(&SD); //do this regardless of SD.begin result to populate one entry w/ message
         break;
      case rmtUSBDrive:
         LoadDirectory(&firstPartition);
         break;
   }
   IO1[rwRegCursorItemOnPg] = 0;
}

bool LoadFile(FS *sourceFS, const char* FilePath, StructMenuItem* MyMenuItem) 
{
   char FullFilePath[MaxNamePathLength];

   //PathIsRoot() uses DriveDirPath directly
   if (strlen(FilePath) == 1 && FilePath[0] == '/') snprintf(FullFilePath, sizeof FullFilePath, "%s%s", FilePath, MyMenuItem->Name);  // at root
   else snprintf(FullFilePath, sizeof FullFilePath, "%s/%s", FilePath, MyMenuItem->Name);
      
   SendMsgPrintfln("Loading:\r\n%s", FullFilePath);

   File myFile = sourceFS->open(FullFilePath, FILE_READ);
   
   if (sourceFS != &SD) FullFilePath[0] = 0; //terminate if not SD
   
   if (!myFile) 
   {
      SendMsgPrintfln("File Not Found");
      return false;
   }
   
   MyMenuItem->Size = myFile.size();
   uint32_t count=0;
   
   if (MyMenuItem->ItemType == rtFileCrt)
   {  //load the CRT

      // No longer enforcing this, swap out if too large:
      //if(MyMenuItem->Size > MaxCRTKB*1024)
      //{
      //   SendMsgPrintfln("Not enough room"); 
      //   SendMsgPrintfln("  Size: %luk, Max CRT: %luk", MyMenuItem->Size/1024, MaxCRTKB); 
      //   myFile.close();
      //   return false;         
      //}

      uint8_t lclBuf[CRT_MAIN_HDR_LEN];
      uint8_t EXROM;
      uint8_t GAME;
      
      if (MyMenuItem->Size < 0x1000)
      {
         SendMsgPrintfln("Too Short for CRT");
         myFile.close();
         return false;        
      }
      
      //load header and parse
      for (count = 0; count < CRT_MAIN_HDR_LEN; count++) lclBuf[count]=myFile.read(); //Read main header
      MyMenuItem->Code_Image = lclBuf;
      if (!ParseCRTHeader(MyMenuItem, &EXROM, &GAME)) //sends error messages
      {
         myFile.close();
         return false;        
      }
      
      //IO1[rwRegNextIOHndlr] is now assigned from crt!
      //process Chip Packets
      FreeCrtChips();  //clears any previous and resets NumCrtChips
      Printf_dbg("\n Chp# Length    Type  Bank  Addr  Size\n");
      while (myFile.available())
      {
         for (count = 0; count < CRT_CHIP_HDR_LEN; count++) lclBuf[count]=myFile.read(); //Read chip header
         if (!ParseChipHeader(lclBuf, FullFilePath)) //sends error messages
         {
            myFile.close();
            FreeCrtChips();
            IO1[rwRegNextIOHndlr] = EEPROM.read(eepAdNextIOHndlr);  //in case it was over-ridden by .crt
            RedirectEmptyDriveDirMenu();
            return false;        
         }
         for (count = 0; count < CrtChips[NumCrtChips].ROMSize; count++) CrtChips[NumCrtChips].ChipROM[count]=myFile.read();//read in ROM info:
         NumCrtChips++;
      }
      
      //check configuration
      if (!SetTypeFromCRT(MyMenuItem, EXROM, GAME)) //sends error messages
      {
         myFile.close();
         FreeCrtChips();
         IO1[rwRegNextIOHndlr] = EEPROM.read(eepAdNextIOHndlr);  //in case it was over-ridden by .crt
         RedirectEmptyDriveDirMenu();
         return false;        
      }
   }
   
   else //non-CRT: Load the whole thing into the RAM1 buffer
   {
      if (MyMenuItem->Size > RAM_ImageSize)
      {
         SendMsgPrintfln("Non-CRT file too large");
         SendMsgPrintfln("  Size: %luk, Max: %luk", MyMenuItem->Size/1024, RAM_ImageSize/1024); 
         myFile.close();
         return false;
      }

      while (myFile.available() && count < MyMenuItem->Size) RAM_Image[count++]=myFile.read();

      myFile.close();
      if (count != MyMenuItem->Size)
      {
         SendMsgPrintfln("Size Mismatch");
         myFile.close();
         return false;
      }
   }
   
   SendMsgPrintfln("Done");
   myFile.close();
   return true;      
}

void InitDriveDirMenu() 
{
   
   if (DriveDirMenu == NULL) 
   {
      DriveDirMenu = (StructMenuItem*)malloc(MaxMenuItems*sizeof(StructMenuItem));
   }
   else
   {
      //free/clear prev loaded directory
      for(uint16_t Num=0; Num < NumDrvDirMenuItems; Num++) free(DriveDirMenu[Num].Name);
   }
   NumDrvDirMenuItems = 0;
#ifdef VM_EXTENSIONS_ENABLED
   memset(VmClaimedItems, 0, sizeof VmClaimedItems);
#endif
}

bool SetDriveDirMenuNameType(uint16_t ItemNum, const char *filename)
{
   //malloc, copy file name and get item type from extension
   DriveDirMenu[ItemNum].Name = (char*)malloc(strlen(filename)+1);
   if (DriveDirMenu[ItemNum].Name == NULL) 
   {  //check for mem full
      Serial.println("Out of mem!");
      return false; 
   }
   
   strcpy(DriveDirMenu[ItemNum].Name, filename);
   
   DriveDirMenu[ItemNum].ItemType = Assoc_Ext_ItemType(DriveDirMenu[ItemNum].Name);
   return true;
}

void LoadDirectory(FS *sourceFS) 
{
#ifdef VM_EXTENSIONS_ENABLED
   // Pins VmRegistry's extension table to this listing: what VmLaunch::tryFile
   // answers from must not be staler than what the user is choosing from.
   VmRegistry::refresh(sourceFS == &SD);
   RemoteChangedSDCard = false;
#endif
   RemoteChangedLoadedDir = false;
   InitDriveDirMenu();
   
   File dir = sourceFS->open(DriveDirPath);
   
   if (!PathIsRoot())
   {  // *not* at root, add up dir option
      DriveDirMenu[0].ItemType = rtDirectory;
      AddDirEntry(UpDirString);
   }
   
   const char *filename;
   uint32_t beginWait = millis();
   
   while (File entry = dir.openNextFile()) 
   {
      //uint8_t hidey = entry.isHidden(); //check for hidden files? not in library
      filename = entry.name();
      if (IsDotfile(filename))
      {
         entry.close();
         continue;
      }
      if (entry.isDirectory())
      {
         DriveDirMenu[NumDrvDirMenuItems].Name = (char*)malloc(strlen(filename)+2);
         DriveDirMenu[NumDrvDirMenuItems].Name[0] = '/';
         strcpy(DriveDirMenu[NumDrvDirMenuItems].Name+1, filename);
         DriveDirMenu[NumDrvDirMenuItems].ItemType = rtDirectory;
      }
      else //it's a file. copy name and get item type from extension
      {
         if (!SetDriveDirMenuNameType(NumDrvDirMenuItems, filename)) break;
      }
      
      //Serial.printf("%d- %s\n", NumDrvDirMenuItems, DriveDirMenu[NumDrvDirMenuItems].Name); 
      entry.close();
      if (++NumDrvDirMenuItems == MaxMenuItems)
      {
         Serial.println("Too many files!"); //no messaging in dir load
         break;
      }
   }
   
   Printf_dbg("Loaded %d items in %lumS from %s\n", NumDrvDirMenuItems, (millis()-beginWait), DriveDirPath);
   
   //alphabetize the directory list
   StructMenuItem TempMenuItem;
   for(uint16_t i=0; i<NumDrvDirMenuItems; i++)
      for(uint16_t j=i+1; j<NumDrvDirMenuItems; j++)
      {
           if(strcasecmp(DriveDirMenu[i].Name,DriveDirMenu[j].Name)>0)
           {
              TempMenuItem    = DriveDirMenu[i];
              DriveDirMenu[i] = DriveDirMenu[j];
              DriveDirMenu[j] = TempMenuItem;
           }
      }   
   
   if(NumDrvDirMenuItems == 0) //empty or missing drive, always need at least one entry
   {
      DriveDirMenu[0].ItemType = rtNone;
      AddDirEntry("<Empty>");
   }
#ifdef VM_EXTENSIONS_ENABLED
   MarkVmClaimed(); //after the sort, which moves items but not their marks
#endif
   
   SetMenu(DriveDirMenu, NumDrvDirMenuItems);
}

void AddDirEntry(const char *EntryString)
{
   DriveDirMenu[NumDrvDirMenuItems].Name = (char*)malloc(strlen(EntryString)+1);
   strcpy(DriveDirMenu[NumDrvDirMenuItems].Name, EntryString);
   NumDrvDirMenuItems++;
}

void FreeDriveDirMenu()
{
   //free/clear prev loaded directory
   if(DriveDirMenu != NULL)
   {
      Printf_dbg("Dir info removed\n");
      for(uint16_t Num=0; Num < NumDrvDirMenuItems; Num++) free(DriveDirMenu[Num].Name);
      free(DriveDirMenu); DriveDirMenu = NULL;
   }
   NumDrvDirMenuItems = 0;

   RedirectEmptyDriveDirMenu(); //MenuSource may still point at the freed array
}

void FreeCrtChips()
{ //free chips allocated in RAM2 and reset NumCrtChips
   for(uint16_t cnt=0; cnt < NumCrtChips; cnt++) 
      if((uint32_t)CrtChips[cnt].ChipROM >= 0x20200000) free(CrtChips[cnt].ChipROM);
   NumCrtChips = 0;
}

uint8_t Assoc_Ext_ItemType(char * FileName)
{ //returns ItemType from enum regItemTypes

   uint32_t Length = strlen(FileName);
   
   if (Length < 4) return rtUnknown;
   
   char* Extension = strrchr( FileName, '.'); //find last dot
   // Must have dot, allow 2-4 char extension only, incl dot
   if (Extension == NULL || Extension > FileName + Length - 2 || Extension < FileName + Length -4) return rtUnknown; 
      
   Extension++; //skip dot
   //convert to lower case:
   for(char* cnt=Extension; cnt<=FileName + Length; cnt++) if(*cnt>='A' && *cnt<='Z') *cnt+=32;
   
   uint8_t Num = 0;
   
   while (Num < sizeof(Ext_ItemType_Assoc)/sizeof(Ext_ItemType_Assoc[0]))
   {
      if (strcmp(Extension, Ext_ItemType_Assoc[Num].Extension)==0) return Ext_ItemType_Assoc[Num].ItemType;
      Num++;
   }
   return rtUnknown;
}
