SensoriumEmbedded/TeensyROM/Source/Teensy/RemoteControl.ino

// MIT License
// 
// Copyright (c) 2023 Travis Smith
// 
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
//Functions to control C64/TR via USB connection

#ifdef VM_EXTENSIONS_ENABLED
#include "MinimalBoot/Common/VMLaunch.h"
#endif


//  TR: Set up wRegIRQ_ACK, rwRegIRQ_CMD, & launch menu info (if needed)
//  TR: Assert IRQ, wait for ack1
// C64: IRQ handler catches, sets local reg (smcIRQFlagged) and sends ack1 to wRegIRQ_ACK
//  TR: sees ack1, deasserts IRQ, waits for ack2 (echo of command)
// C64: Main code sees local reg, reads IRQ command, and echoes it to ack (ack 2)
//  TR: sees ack2, success/return
// C64: Executes command

bool InterruptC64(RegIRQCommands IRQCommand)
{
   IO1[rwRegIRQ_CMD] = IRQCommand;
   bool IRQSuccess = DoC64IRQ();
   IO1[rwRegIRQ_CMD] = ricmdNone; //always set back to none/0 for default/protection 
   return IRQSuccess;   
}

bool DoC64IRQ()
{
   uint32_t beginWait = millis();
   IO1[wRegIRQ_ACK] = ricmdNone;
   SetIRQAssert;
   
   //wait for C64 app to respond from IRQ 
   while (IO1[wRegIRQ_ACK] != ricmdAck1) 
   {
      if (millis()-beginWait > 50) 
      {
         SetIRQDeassert;
         Printf_dbg("Ack1 Timeout\n");
         return false; // Timeout, Ack 1 (from IRQ)
      }
   }
   SetIRQDeassert;
   Printf_dbg("Ack 1 took %lumS\n", (millis()-beginWait));
   
   //now wait for it to respond from main loop
   while (IO1[wRegIRQ_ACK] == ricmdAck1) 
   {
      if (millis()-beginWait > 200) 
      {
         Printf_dbg("Ack2 Timeout\n");
         return false; // Timeout, Ack 2 (from main code)
      }
   }
   Printf_dbg("Ack 1+2 took %lumS\n", (millis()-beginWait));
   
   if (IO1[wRegIRQ_ACK] != IO1[rwRegIRQ_CMD]) //mismatch!
   {
      Printf_dbg("Mismatch\n");
      return false; // echoed ack2 does not match command sent
   }
   
   return true;
}

FLASHMEM bool RemotePauseSID()
{  //assumes TR is not "busy" (Handler active)
   return InterruptC64(ricmdSIDPause);
}

// Command: 
// Set one of the colors in the TR UI 
//    Color will be stored in EEPROM and IO space, TR menu will need to be reset to take visual effect
//
// Workflow:
// Receive <-- SetColorToken Token 0x6422
// Receive <-- Color reference to set (Range 0 to NumColorRefs-1) See enum ColorRefOffsets
// Receive <-- Color to set (Range 0 to 15)  See enum PokeColors
// Send --> AckToken 0x64CC or FailToken 0x9B7F
FLASHMEM bool SetColorRef()
{

   if (!SerialAvailabeTimeout()) return false;
   uint8_t ColRefNum = CmdChannel->read();

   if (!SerialAvailabeTimeout()) return false;
   uint8_t ColorNum = CmdChannel->read();
   
   if (ColRefNum >= NumColorRefs) return false;
   if (ColorNum  > 15) return false;
   
   IO1[rwRegColorRefStart+ColRefNum]=ColorNum;
   EEPROM.write(eepAdColorRefStart+ColRefNum , ColorNum);
   
   return true;
}

// Command: 
// Set the TR's real-time clock, which the TR+'s battery keeps through power-off
//
// Workflow:
// Receive <-- SetRTCToken Token 0x6474
// Receive <-- UTC time, seconds since 1970 (4 bytes, big endian)
// Send --> AckToken 0x64CC or FailToken 0x9B7F
FLASHMEM bool SetRTC()
{
   uint32_t SecsSince1970;
   if (!GetUInt(&SecsSince1970, 4)) return false;

   Teensy3Clock.set(SecsSince1970);
   return true;
}

// Command: 
// Set sub-song number of currently loaded SID
//
// Workflow:
// Receive <-- SetSIDSongToken Token 0x6488 
// Receive <-- Song number to set (1 byte, zero based, song 1 is 0) 
// Send --> AckToken 0x64CC or FailToken 0x9B7F
FLASHMEM bool SetSIDSong()
{  //assumes TR is not "busy" (Handler active)
   if(!SerialAvailabeTimeout()) return false;
   uint8_t NewSongNumZ = CmdChannel->read();
   
   if(NewSongNumZ > IO1[rRegSIDNumSongsZ]) return false;
   IO1[rwRegSIDSongNumZ] = NewSongNumZ;
   return InterruptC64(ricmdSIDInit);
}


// Command: 
// Set SID playback speed of currently loaded SID
//
// Workflow:
// Receive <-- SIDSpeedLinToken  0x6499 -or- SIDSpeedLogToken  0x649A
// Receive <-- playback rate (16 bit signed int as 2 bytes: hi, lo)
//                Linear Range is -68(*256) to <128(*256), argument represents speed change percent from nominal
//                Logrithmic Range is -127(*256) to 99(*256) argument to percentage shown in "SID playback speed-log.txt"
// Send --> AckToken 0x64CC or FailToken 0x9B7F
//
// Example 1: 0x64, 0x99, 0xf0, 0x40 = Set to -15.75 via linear equation
// Example 2: 0x64, 0x9a, 0x20, 0x40 = set to +32.25 via logarithmic equation
FLASHMEM bool RemoteSetSIDSpeed(bool LogConv)
{  //assumes TR is not "busy" (Handler active)

   uint32_t PlaybackSpeedIn;
   if (!GetUInt(&PlaybackSpeedIn, 2)) return false;

   if (!SetSIDSpeed(LogConv, (int16_t)PlaybackSpeedIn)) return false;
     
   return InterruptC64(ricmdSetSIDSpeed);
}


// Command: 
// Set individual SID voice muting
//
// Workflow:
// Receive <-- SIDVoiceMuteToken   0x6433
// Receive <-- voice mute info (1 byte)
//                bit 0=  Voice 1  on=0, mute=1
//                bit 1=  Voice 2  on=0, mute=1
//                bit 2=  Voice 3  on=0, mute=1
//             bits 7:3= Zero
// Send --> AckToken 0x64CC or FailToken 0x9B7F
FLASHMEM bool RemoteSetSIDVoiceMute()
{  //assumes TR is not "busy" (Handler active)

   uint32_t VoiceMuteInfo;
   if (!GetUInt(&VoiceMuteInfo, 1)) return false;

   if (VoiceMuteInfo > 0x07) return false;
   
   IO1[rwRegScratch]= VoiceMuteInfo; //use scratch reg to transfer mute info
   return InterruptC64(ricmdSIDVoiceMute);
}

void EEPRemoteLaunch(uint16_t eepAdNameToLaunch)
{
   char AutoFileName[MaxPathLength];
   EEPreadStr(eepAdNameToLaunch, AutoFileName);
   char * ptrAutoFileName = AutoFileName; //pointer to move past SD/USB/TR:
   RegMenuTypes MenuSourceID = RegMenuTypeFromFileName(&ptrAutoFileName);
   Printf_dbg("EEP Autolaunch %d \"%s\"\n", MenuSourceID, ptrAutoFileName); 
   RemoteLaunch(MenuSourceID, ptrAutoFileName, true); //do CRT directly 
}
               
//Only the folder has to fit in DriveDirPath; the file name is read from FileNamePath
bool LaunchFolderFits(const char *FileNamePath)
{
   const char* ptrSlash = strrchr(FileNamePath, '/');
   return ptrSlash == NULL || (size_t)(ptrSlash - FileNamePath) < MaxPathLength;
}

void RemoteLaunch(RegMenuTypes MenuSourceID, const char *FileNamePath, bool DoCartDirect)
{//assumes file exists & TR is not "busy" (Handler active)
   
   //A cut-short folder opens a different one, so refuse rather than truncate
   if (!LaunchFolderFits(FileNamePath))
   {
      Serial.printf("Remote launch folder too long (%u chars)\n", (unsigned)strlen(FileNamePath));
      return;
   }

   //set path & filename; DriveDirPath changes only once the launch goes ahead
   char LaunchDir[MaxPathLength];
   const char* ptrSlash = strrchr(FileNamePath, '/');
   char* ptrFilename;
   if (ptrSlash == NULL)
   {  //no path:
      strcpy(LaunchDir, "/");
      ptrFilename = (char*)FileNamePath;
   }
   else
   {  //separate path/filename; the file name stays in FileNamePath, which may be longer than LaunchDir
      size_t FolderLen = ptrSlash - FileNamePath;
      memcpy(LaunchDir, FileNamePath, FolderLen);
      LaunchDir[FolderLen] = 0;
      if (!FolderLen) strcpy(LaunchDir, "/"); //root-level file: the only slash was the leading one
      ptrFilename = (char*)ptrSlash + 1;
   }

   //Resolve the TR entry before anything changes: a failed lookup must leave the C64's listing,
   //  menu type and registry as they were, or its next selection runs against the wrong menu
   int16_t TRMenuNum = -1;
   StructMenuItem* TRMenu = TeensyROMMenu;  //default to root menu
   uint16_t TRNumItems = sizeof(TeensyROMMenu)/sizeof(StructMenuItem);
   if (MenuSourceID == rmtTeensy)
   {
      if(strcmp(LaunchDir, "/") !=0 )
      {//find dir menu
         int16_t DirNum = FindTRMenuItem(TRMenu, TRNumItems, LaunchDir);
         if(DirNum<0)
         {
            Printf_dbg("No TR Dir \"%s\"\n", LaunchDir);
            //Somehow notify user?
            return;
         }
         TRMenu = (StructMenuItem*)TeensyROMMenu[DirNum].Code_Image;
         TRNumItems = TeensyROMMenu[DirNum].Size/sizeof(StructMenuItem);
      }
      TRMenuNum = FindTRMenuItem(TRMenu, TRNumItems, ptrFilename);
      if(TRMenuNum<0)
      {
         Printf_dbg("No TR File \"%s\"\n", ptrFilename);
         //Somehow notify user?
         return;
      }
      Printf_dbg("TR File Num = %d\n", TRMenuNum);
   }

   //Printf_dbg("Launching: SrcID%d DoCRT%d \"%s\"\n", MenuSourceID, DoCartDirect, FileNamePath);
   RemoteLaunched = true;
   //Set selected drive
   IO1[rWRegCurrMenuWAIT] = MenuSourceID;

   if (MenuSourceID == rmtSD) SDFullInit(); // SD.begin(BUILTIN_SDCARD); with retry if presence detected
#ifdef VM_EXTENSIONS_ENABLED
   // A remote launch builds its one-item DriveDirMenu without LoadDirectory, so
   // the extension table LoadDirectory would have rebuilt is rebuilt here.
   VmRegistry::refresh(MenuSourceID == rmtSD);
   RemoteChangedSDCard = false;
#endif
   // The one-item menu built below replaces whatever listing a remote file
   // command may have changed, so there is nothing left for the menu to reload.
   RemoteChangedLoadedDir = false;

   if (MenuSourceID == rmtUSBDrive) USBFileSystemWait(); //wait up to 1.5 sec in case USB drive just changed or powered up
   
   //free mem for DriveDirMenu in case current (non-tr) handler is using it all
   FreeCrtChips();
#ifdef Fab04_REU
   FreeREU();
#endif   
   FreeGeoRAM();
   TRBlockUnmount();
   FreeSwiftlinkBuffs();

   if (MenuSourceID == rmtTeensy)
   {
      //point to item # matching filename
      SetMenu(TRMenu, TRNumItems);
      IO1[rwRegCursorItemOnPg] = TRMenuNum;
      SelItemFullIdx = TRMenuNum;  //  "Select" item
      UpdateItemTypeReg();
   }
   else
   {
      // Set up DriveDirMenu to point to file to load
      //    without doing LoadDirectory(&SD/&firstPartition);
      Printf_dbg("Dir Setup\n");
      InitDriveDirMenu();
      SetDriveDirMenuNameType(0, ptrFilename);  //not worried about out of memory here (first/only item)
      NumDrvDirMenuItems = 1;
#ifdef VM_EXTENSIONS_ENABLED
      MarkVmClaimed();
#endif
      SetMenu(DriveDirMenu, 1);
      IO1[rwRegCursorItemOnPg] = 0;
      SelItemFullIdx = 0;  //  "Select" item
      UpdateItemTypeReg();
   }
   
   strcpy(DriveDirPath, LaunchDir);

   //Printf_dbg("Remote Launch:\nP: %s\nF: %s\n", DriveDirPath, ptrFilename);
   Serial.printf("Remote Launch:\nP: %s\nF: %s\n", DriveDirPath, ptrFilename);

   if (DoCartDirect)
   {  //If a CRT, start and reset directly:
      switch(MenuSource[SelItemFullIdx].ItemType)
      {
         case rtFileCrt:
         case rtBin16k:
         case rtBin8kHi:
         case rtBin8kLo:
         case rtBinC128:
#ifdef VM_EXTENSIONS_ENABLED
            //An extension packaged as a .crt goes through the menu instead while C64/C128 isn't known yet
            //  (autolaunch at power-up, the relaunch after a launch sent to MinimalBoot): its launch hands
            //  the extension image the machine, and only the menu's report says C64 or C128
            if (!(VidTODClksKnown & rvtcC128) &&
                VmLaunch::isPackageCrt(MenuSourceID, DriveDirPath, MenuSource[SelItemFullIdx].Name))
            {
               Serial.printf("Extension package: launching through the menu\n");
               break;
            }
#endif
            Printf_dbg("Forced CRT launch\n"); 
            SendC64Msgs = false;
            HandleExecution();
            SendC64Msgs = true;
            if(doReset) return; //success, proceed to reset in main loop
            
            Printf_dbg("Unsuccessful\n"); 
            //Try again via menu so that fail message is displayed on C64...
            break;
      }
   }

   //Get the attention of the C64 via IRQ or reset:
   if(CurrentIOHandler == IOH_TeensyROM)
   {
      Printf_dbg("Interrupt/launch\n"); 
      if(InterruptC64(ricmdLaunch)) return;
   }

   //force reset then launch
   Printf_dbg("Reset/launch\n"); 
   IO1[rwRegIRQ_CMD] = ricmdLaunch;
   SetUpMainMenuROM(); //includes DoReset flag set
   
}
