SensoriumEmbedded/TeensyROM/Source/Teensy/SerUSBIO.ino

// MIT License
// 
// Copyright (c) 2023 Travis Smith
// 
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
#ifdef Dbg_SerSwift
   //RxIn 497+551=1048
   //big 8-bit playground buffer for testing
  PROGMEM const uint8_t TestBuf[] ={
      168,168,168,168,168,168,168,168,168,168,168,168,168,168,168,168,168,168,168,168,168,168,168,168,168,168,168,168,168,168,13,32,32,
      18,28,220,32,32,32,32,32,32,32,32,32,32,32,32,32,32,32,32,32,162,162,162,32,172,162,162,162,172,162,162,162,
      187,32,44,146,166,13,32,32,18,220,32,32,161,146,223,18,32,32,32,32,162,146,169,18,32,172,161,32,146,223,18,32,
      146,161,18,152,190,153,162,30,188,28,161,146,161,18,32,150,162,129,188,146,32,18,154,32,156,32,5,32,28,161,206,223,
      146,13,32,32,18,220,146,190,18,162,146,158,58,46,28,184,188,183,158,58,46,58,28,188,32,158,46,18,28,162,146,158,
      58,32,28,190,18,153,187,146,30,162,18,151,172,146,129,172,28,187,18,150,32,146,129,162,18,31,172,146,32,156,187,18,
      5,32,146,156,172,18,28,190,180,146,219,165,13,32,32,18,156,220,163,163,163,163,163,163,163,163,163,163,163,163,163,163,
      163,163,146,161,18,30,32,146,32,18,129,32,146,28,188,150,190,18,129,32,146,32,18,154,32,5,161,146,161,18,152,32,
      156,161,167,175,175,146,13,32,32,18,220,32,220,32,32,32,32,32,32,32,32,32,32,46,32,32,32,188,146,151,188,18,
      129,162,146,28,190,18,156,190,146,161,18,31,162,154,162,146,156,190,5,188,151,190,18,162,154,161,172,31,190,146,220,13,
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
      //      while(!BtnPressed)  //menu button to exit
      //      {
      //         if (Serial.available()) USBHostSerial.print((char)Serial.read());
      //         if (USBHostSerial.available()) Serial.print((char)USBHostSerial.read());
      //      }
      //   }
      //   break;

// *** The rest of these cases are used for debug/testing only  
   // u,v,w,y,z
   #ifdef Dbg_SerDMA
   #ifdef Fab04_FullDMACapable
      case 'u':  //Perform DMA Write
         {
            const uint32_t DMAAddr = 0x0c00;
            const uint32_t DMALength = 0xa000-0x0c00;
            uint8_t *DMABuf = RAM_Image; //make this dynamic (RAM2), or local[DMALength]?
            bool ZeroMem = (CmdChannel->read() == '0'); //0 argument to clear mem instead of lower addr byte
          
            //init buffer and Write
            for(uint32_t ByteNum = 0; ByteNum < DMALength; ByteNum++) DMABuf[ByteNum] = ZeroMem ? 0 : (ByteNum & 0xff); //((ByteNum & 0xff)^((ByteNum>>8) & 0xff));
            uint32_t StartTime = micros();  
            if (!PerformDMA(DMA_WRITE, DMAAddr, DMABuf, DMALength, DMA_ADDR_INCREMENT) || !CloseDMA())
            {
               Serial.println("DMA Write: no transfer, C64 bus not clocking or DMA timed out");
               break;
            }
            StartTime = micros() - StartTime;  
            Serial.printf("DMA Write (%s) addr $%04x:$%04x (%lu Bytes) in %luuS\n", ZeroMem ? "$00" : "LSB", DMAAddr, DMAAddr+DMALength-1, DMALength, StartTime);
         }
         break;
      case 'v':  //Perform DMA Read/compare
         //while(!BtnPressed)  //menu button to exit
         {
            const uint32_t DMAAddr = 0x0c00;
            const uint32_t DMALength = 0xa000-0x0c00;
            uint8_t *DMABuf = RAM_Image; //make this dynamic (RAM2), or local[DMALength]?
            uint32_t NumFail = 0;
            bool ZeroMem = (CmdChannel->read() == '0'); //0 argument to comp mem to 0 instead of lower addr byte

            uint32_t StartTime = micros();  
            //checked before comparing: after a 'u' DMABuf already holds the expected pattern,
            //   so an unchecked failed read would compare equal and report "All Passed!"
            if (!PerformDMA(DMA_READ, DMAAddr, DMABuf, DMALength, DMA_ADDR_INCREMENT) || !CloseDMA())
            {
               Serial.println("DMA Read: no transfer, C64 bus not clocking or DMA timed out");
               break;
            }
            StartTime = micros() - StartTime;  
            Serial.printf("DMA Read  (%s) addr $%04x:$%04x (%lu Bytes) in %luuS\n", ZeroMem ? "$00" : "LSB", DMAAddr, DMAAddr+DMALength-1, DMALength, StartTime);
            for(uint32_t ByteNum = 0; ByteNum < DMALength; ByteNum++)
            {
               //Printf_dbg("  read addr $%04x = $%02x\n", DMAAddr+ByteNum, DMABuf[ByteNum]); //Small buff: List individual
               
               //if ((ByteNum % 16) == 0) Printf_dbg("\n%04x:", DMAAddr+ByteNum); //large buff: list in rows of 16
               //Printf_dbg(" %02x", DMABuf[ByteNum]);
               
               //compare to expected:
               uint8_t Expected = ZeroMem ? 0 : (ByteNum & 0xff); //((ByteNum & 0xff)^((ByteNum>>8) & 0xff));
               if (DMABuf[ByteNum] != Expected) 
               {
                  Serial.printf("  Miscomp: $%04x=$%02x, exp $%02x\n", DMAAddr+ByteNum, DMABuf[ByteNum], Expected);
                  NumFail++;
               }
            }
            if (NumFail) Serial.printf("  %lu miscompares\n", NumFail);
            else Serial.println("  All Passed!");
         }
         break;
      case 'w':  //Perform DMA page r/w check
         //while(!BtnPressed)  //menu button to exit
         {
            const uint32_t BlockSize = 0x1000;
            uint8_t DMABuf, InvVal, ReadBack;
            
            Serial.printf("\nMem R/W check, $%04x (%dk) block size\n", BlockSize, BlockSize/1024);
            
            //POKE1,52  to disable BASIC, Kernal, and IO/Char banks and expose all RAM
            //  Can't do it from here as the CPU doesn't read external
            //  Boot to Utilmax to disable ROMs?
            
            for(uint32_t Address = 0; Address < 0xFFFF; Address+=BlockSize)
            {
               
               if (!PerformDMA(DMA_READ, Address, &DMABuf, 1, DMA_ADDR_INCREMENT))  //Read val
               {  //nothing written yet, so nothing to restore
                  Serial.printf("$%04x: no transfer, C64 bus not clocking or DMA timed out\n", Address);
                  break;
               }
               delay(1);
               InvVal = ~DMABuf;
               bool Moved = PerformDMA(DMA_WRITE, Address, &InvVal, 1, DMA_ADDR_INCREMENT); //Write the inverse
               delay(1);
               Moved = Moved && PerformDMA(DMA_READ, Address, &ReadBack, 1, DMA_ADDR_INCREMENT);  //Read back
               delay(1);
               //attempted even after a failure above: the inverse may have landed
               Moved = PerformDMA(DMA_WRITE, Address, &DMABuf, 1, DMA_ADDR_INCREMENT) && Moved; //Re-Write original to preserve
               delay(1);
               if (!Moved)
               {
                  Serial.printf("$%04x: no transfer, C64 bus not clocking or DMA timed out\n", Address);
                  break;
               }
               
               //compare/print
               //Serial.printf("R $%02x  WI $%02x  RI $%02x  ", DMABuf, InvVal, ReadBack);
               Serial.printf("$%04x: ", Address);
               if (ReadBack != InvVal) Serial.printf("Read Only\n");
               else Serial.printf("R/W\n");
               Serial.flush();
             }
             CloseDMA();
         }
         break;
      case 'z':  //DMA bit-transition test, for sweeping the DMA data timing constants
         {
            const uint16_t Addr = 0xc000;
            uint32_t Passes = 0;
            GetDigits(3, &Passes); //z### : 256 byte pages written per pattern
            if(Passes == 0) Passes = 64;
            //restore rather than enable on exit - ExpPortDMA and some handlers leave these off on purpose
            bool ENETWasOn = NVIC_IS_ENABLED(IRQ_ENET), PITWasOn = NVIC_IS_ENABLED(IRQ_PIT);
            NVIC_DISABLE_IRQ(IRQ_ENET); //keep the bus quiet while testing, as ExpPortDMA does
            NVIC_DISABLE_IRQ(IRQ_PIT);
            Serial.printf("\nDMA pattern test: DMADataHold=%lu DMADataSetup=%lu DMASetup=%lu Passes=%lu"
                          "\n  (overwrites C64 $%04x-$%04x)\n",
               nS_DMADataHold, nS_DMADataSetup, nS_DMASetup, Passes, Addr, Addr+255);
            TestDMAPattern(Addr, 0xff, 0xff, 0xff, Passes, false); //control: nothing has to change
            TestDMAPattern(Addr, 0x00, 0xff, 0xff, Passes, false); //uniform, over the opposite value
            TestDMAPattern(Addr, 0xff, 0x00, 0x00, Passes, false);
            TestDMAPattern(Addr, 0x00, 0x00, 0xff, Passes, false); //alternating: bus swings each cycle
            TestDMAPattern(Addr, 0xff, 0x55, 0xaa, Passes, false);
            if(PITWasOn) NVIC_ENABLE_IRQ(IRQ_PIT);
            if(ENETWasOn) NVIC_ENABLE_IRQ(IRQ_ENET);
         }
         break;
   #ifdef USE_PSRAM
      case 'y':  //Load REU PSRAM from file
         {  //   example: y/reu/nuvies/speed.reu
            char Filename[100];
            uint32_t CharNum = 0;

            while (SerialAvailabeTimeout())
            {
               Filename[CharNum++] = CmdChannel->read();
            }
            Filename[CharNum] = 0;
            
            Serial.printf("Load PSRAM/REU with: %s\n", Filename);
            File LoadFile = SD.open(Filename, FILE_READ);
            if (!LoadFile)
            {
               Serial.println("File not found");
               return;
            }
            
            uint32_t StartmS = millis();
            CharNum = 0;
            while (LoadFile.available())
            {
               pPSRAM[CharNum++] = LoadFile.read();
            }
            Serial.printf("Wrote %lu Bytes in %lumS\n", CharNum, millis()-StartmS);
            LoadFile.close();
            
            //LoadFile = SD.open(Filename, FILE_READ);
            ////LoadFile.seek(0);
            //StartmS = millis();
            //CharNum = 0;
            //while (LoadFile.available())
            //{
            //   if (pPSRAM[CharNum++] != LoadFile.read()) Serial.printf("Mismatch!\n");
            //}
            //Serial.printf("Verified %lu Bytes in %lumS\n", CharNum, millis()-StartmS);
            //LoadFile.close();
         }
         break;
   #endif
   #endif
   #endif

   // q, a, i
   #ifdef Dbg_SerASID
      case 'q':   //display queue size, rate, etc
         CmdChannel->printf("\nASID Timer: Ena: %s, Qinitd: %s\n", (FrameTimerMode ? "true" : "false"), (QueueInitialized ? "true" : "false"));
         CmdChannel->printf(" Config  : QSize:%lu, FrmsBetChks:%d\n", ASIDQueueSize, FramesBetweenChecks);
         CmdChannel->printf(" Current : QUsed:%lu, QInit: %lu, DeltaFrames:%d\n", ASIDRxQueueUsed, BufByteTarget, DeltaFrames);
         CmdChannel->printf(" QInitChg: Curr: %d, Max:%+d, Min:%+d, diff:%d bytes\n", (ASIDRxQueueUsed - BufByteTarget), MaxB, MinB, MaxB-MinB);
         CmdChannel->printf(" Interval: Curr: %lu, Max:%lu, Min:%lu, diff:%lu uS\n", TimerIntervalUs, MaxT, MinT, MaxT-MinT);
         break;
      case 'a': //ASID Packet load
      {
         uint8_t VolReg = 0;
         uint16_t RegsInPacket = 20, NumPackets = 1000;  // (ASIDQueueSize-2)/2;
         uint32_t StartMicros, MaxMicros = 0, MinMicros = 100000;
         for(uint32_t PacketNum = 0; PacketNum<NumPackets; PacketNum++)
         {
            for(uint8_t CmdNum=0; CmdNum<RegsInPacket; CmdNum++)
            {
               AddToASIDRxQueue(ASIDAddrType_SID1 | 0x18, VolReg); //toggle volume reg
               VolReg ^= 0x0f;
            }
            StartMicros = micros();
            SetASIDIRQ();
            while(ASIDRxQueueUsed) if (micros() - StartMicros > 100000) break;
            StartMicros = micros() - StartMicros;
            if(StartMicros>MaxMicros) MaxMicros=StartMicros;
            if(StartMicros<MinMicros) MinMicros=StartMicros;
            CmdChannel->printf("Took %luuS to send %d Regs\n", StartMicros, RegsInPacket);
            FlushCmdChannel(CmdChannel);
            delay(10); //allow scope time to re-arm
         }
         CmdChannel->printf(" %d packets, %luuS Min to %luuS Max\n", NumPackets, MinMicros, MaxMicros);
      }
         break;
      case 'i': //Send text via ASID
      {
         AddToASIDRxQueue(ASIDAddrType_Start, 0);
         PrintflnToASID("This is a long character test, it just  keeps going for 3 continuous lines of   text. 7 Just when you think it's done.");
         AddToASIDRxQueue(ASIDAddrType_Stop, 0);
         FlushASIDRxQueue();
      }
         break;
   #endif
   
   // l, c
   #ifdef Dbg_SerLog 
      case 'l':  //Show Debug Log
         PrintDebugLog();
         break;
      case 'c': //Clear Debug Log buffer
         BigBufCount = 0;
         CmdChannel->println("Buffer Reset");
         break;       
   #endif
         
   // f, x
   #ifdef Dbg_SerMem 
      case 'f': //show build info+free mem
         {
            char BuildInfo[sizeof SerialStringBuf];
            MakeBuildInfo(BuildInfo, sizeof BuildInfo);
            CmdChannel->println("\n***** Build & Mem info *****");
            CmdChannel->println(BuildInfo);
            CmdChannel->printf("RAM2 Bytes Free: %lu (%luK)\n\n", RAM2BytesFree(), RAM2BytesFree()/1024);
            memInfo();
            getFreeITCM();
 
            CmdChannel->printf("\nMem usage:\n");
            uint32_t TotalSize = 0;
            if(DriveDirMenu != NULL) 
            {
               for(uint16_t Num=0; Num < NumDrvDirMenuItems; Num++) TotalSize += strlen(DriveDirMenu[Num].Name)+1;
               CmdChannel->printf("Filename chars: %lu (%luk) @ $%08x\nDriveDirMenu: %lu (%luk) @ $%08x\n", 
                  TotalSize, TotalSize/1024, (uint32_t)DriveDirMenu[0].Name,
                  MaxMenuItems*sizeof(StructMenuItem), MaxMenuItems*sizeof(StructMenuItem)/1024, (uint32_t)DriveDirMenu);
               TotalSize += MaxMenuItems*sizeof(StructMenuItem);
            }
            CmdChannel->printf("DriveDirMenu+Filename chars: %lu (%luk)\n", 
               TotalSize, TotalSize/1024);
            
            CmdChannel->printf("RAM_Image: %lu (%luk) @ $%08x\n", 
               sizeof(RAM_Image), sizeof(RAM_Image)/1024, (uint32_t)RAM_Image);
         
            TotalSize = 0;
            uint32_t TotalStructSize = sizeof(TeensyROMMenu);
            uint32_t FileCount = 0;
            for(uint8_t ROMNum=0; ROMNum < sizeof(TeensyROMMenu)/sizeof(TeensyROMMenu[0]); ROMNum++)
            {
               if(TeensyROMMenu[ROMNum].ItemType == rtDirectory)
               {
                  StructMenuItem *subTROMMenu = (StructMenuItem*)TeensyROMMenu[ROMNum].Code_Image;
                  TotalStructSize += TeensyROMMenu[ROMNum].Size;
                  for(uint8_t subROMNum=0; subROMNum < TeensyROMMenu[ROMNum].Size/sizeof(StructMenuItem); subROMNum++)
                  {
                     if(subTROMMenu[subROMNum].ItemType != rtDirectory) AddAndCheckSource(subTROMMenu[subROMNum], &TotalSize, &FileCount);
                  }
               }
               else AddAndCheckSource(TeensyROMMenu[ROMNum], &TotalSize, &FileCount);
            }
            CmdChannel->printf("TeensyROMMenu/sub struct: %lu (%luk) @ $%08x\n", 
               TotalStructSize, TotalStructSize/1024, (uint32_t)TeensyROMMenu);
            CmdChannel->printf("TeensyROMMenu/sub (%d) Items: %d (%dk) of Flash\n\n", FileCount, TotalSize, TotalSize/1024);
         }
         break;
      case 'x': 
         { 
            FreeDriveDirMenu(); //drops back to the TR menu if we were on SD/USB (see FreeDriveDirMenu)
            
            uint32_t CrtMax = (RAM_ImageSize & 0xffffe000)/1024; //round down to k bytes rounded to nearest 8k
            CmdChannel->printf("\n\nRAM1 Buff: %luK (%lu blks)\n", CrtMax, CrtMax/8);
            
            //uint32_t RAM2Free = (RAM2BytesFree() & 0xffffe000)/1024; //round down to k bytes rounded to nearest 8k
            //CmdChannel->printf("RAM2 Free: %luK (%lu blks)\n", RAM2Free, RAM2Free/8);
            
            uint8_t NumChips = RAM2blocks();
            //CmdChannel->printf("RAM2 Blks: %luK (%lu blks)\n", NumChips*8, NumChips);
            NumChips = RAM2blocks()-1; //do it again, sometimes get one more, minus one to match reality, not clear why
            CmdChannel->printf("RAM2 Blks: %luK (%lu blks)\n", NumChips*8, NumChips);
           
            CrtMax += NumChips*8;
            CmdChannel->printf("  CRT Max: %luK (%lu blks) ~%luK file\n", CrtMax, CrtMax/8, (uint32_t)(CrtMax*1.004));
            //larger File size due to header info.
         }
         break;
   #endif
   
   // o
   #ifdef Dbg_SerSD
      case 'o': //SD card info + speed test
         SDSpeedTest();
         break;
   #endif
   
   // m, p, k, r, s
   #ifdef Dbg_SerSwift
      case 'm':      
         for(uint16_t Cnt=0; Cnt<sizeof(TestBuf); Cnt++) AddRawCharToRxQueue(TestBuf[Cnt]);
         break;
      case 'p':
         AddToPETSCIIStrToRxQueueLN("0123456789abcdef");
         break;
      case 'r': // rXXXXXX  set baud Rate directly
         {
            uint32_t NewBaud = 0;
            
            for(int8_t ByteNum=6-1; ByteNum>=0; ByteNum--)
            {
               if(!SerialAvailabeTimeout())
               {
                  CmdChannel->printf("6 digits required\n");
                  return;
               }
               uint32_t ByteIn = CmdChannel->read();
               if(ByteIn<'0' || ByteIn>'9')
               {
                  CmdChannel->printf("numbers only\n");
                  return;
               }
               NewBaud = NewBaud*10 + (ByteIn-'0'); //most significant digit first; pow() would link ~6KB of tables into RAM1
            }
            if (NewBaud == 0)
            {
               CmdChannel->printf("baud can't be 0\n");
               return;
            }
            C64CycBetweenRx = 985250*8/NewBaud;
            CmdChannel->printf("Manual baud set: %lubps, %lu Cycles\n", NewBaud, C64CycBetweenRx);
            //CmdChannel->printf("CycToBaud: %lubps\n", (985250*8/C64CycBetweenRx));
         }
         break;
      case 'k': //kill/reset status/NMI
         SwiftRegStatus = SwiftStatusDefault;
         SwiftRegCommand = SwiftCmndDefault;
         SwiftRegControl = 0;
         RxQueueHead = RxQueueTail = 0;
         //SwiftRegStatus &= ~(SwiftStatusRxFull | SwiftStatusIRQ); //no longer full, ready to receive more
         SetNMIDeassert;
         CmdChannel->printf("Swiftlink Reset\n"); 
         break;
      case 's': //status            
         CmdChannel->printf("Swiftlink status:\n"); 
         CmdChannel->printf("  client is");
         if (!client.connected()) CmdChannel->printf(" Not");
         CmdChannel->printf(" connected\n");
         
         CmdChannel->printf("  Rx Queue Used: %d\n", RxQueueUsed); 
         
         CmdChannel->printf("  RxIRQ is"); 
         if((SwiftRegCommand & SwiftCmndRxIRQDis) != 0) CmdChannel->printf(" Not"); 
         CmdChannel->printf(" enabled\n"); 
         
         CmdChannel->printf("  RxIRQ is");
         if((SwiftRegStatus & SwiftStatusIRQ) == 0) CmdChannel->printf(" Not"); 
         CmdChannel->printf(" set\n");
         
         CmdChannel->printf("  Command Reg: %02x\n", SwiftRegCommand);
         CmdChannel->printf("  Control Reg: %02x\n", SwiftRegControl);
         CmdChannel->printf("   Status Reg: %02x\n", SwiftRegStatus);
         CmdChannel->printf("Enh Speed Reg: %02x\n", TurboRegEnhancedSpeed);
         CmdChannel->printf("     RxOutBuf: %02x\n", SwiftRxBuf);
         
         break;
   #endif
   
   // t...
   #ifdef Dbg_SerTimChg
      case 't': //timing commands, 2 letters and 3-4 numbers
         CmdChannel->printf("-----\n");
         switch (CmdChannel->read())
         {
            case 'm': //nS_MaxAdj change
               GetDigits(4, &nS_MaxAdj);
               break;
            case 'r': //nS_RWnReady change
               GetDigits(3, &nS_RWnReady);
               break;
            case 'p': //nS_PLAprop change
               GetDigits(3, &nS_PLAprop);
               break;
            case 's': //nS_DataSetup change
               GetDigits(3, &nS_DataSetup);
               break;
            case 'h': //nS_DataHold change
               GetDigits(3, &nS_DataHold);
               break;
            case 'v': //nS_VICStart change
               GetDigits(3, &nS_VICStart);
               break;
            case 'i': //nS_VICDHold change
               GetDigits(3, &nS_VICDHold);
               break;
            case 'a': //nS_DMAAssert change
               GetDigits(3, &nS_DMAAssert);
               break;
            case 'b': //nS_DMABAWait change
               GetDigits(3, &nS_DMABAWait);
               break;
            case 'e': //nS_DMASetup change
               GetDigits(3, &nS_DMASetup);
               break;
            case 'w': //nS_DMADataHold change
               GetDigits(3, &nS_DMADataHold);
               break;
            case 'y': //nS_DMADataSetup change
               GetDigits(3, &nS_DMADataSetup);
               break;
            case 'k': //Cyc_KernProp change
               GetDigits(2, &Cyc_KernProp);
               break;
         #ifdef Fab04_KernalReplace
            case 'x': //Kernal replace HIRAM sense: tx0 Skoe, tx2 DMA, tx9 auto (DMA on a C128), from the next launch
               GetDigits(1, &KSenseMode);
               CmdChannel->println(PSTR("Kernal HIRAM sense mode set: takes effect at the next Kernal Replace launch"));
               break;
            case 'n': //Kernal replace DMA HIRAM sense: ROMH sample point
               GetDigits(3, &nS_KSenseSample);
               break;
         #endif
            case 'd': //Set Defaults
            {  //match what detection would have set, or a sweep resumes from the wrong standard's values
               SetVideoStdTiming(); //MaxAdj and the DMA setup/hold set
               nS_PLAprop   = Def_nS_PLAprop;
               nS_DataSetup = Def_nS_DataSetup;  
               nS_DataHold  = Def_nS_DataHold;  
               nS_VICStart  = Def_nS_VICStart;  
               nS_VICDHold  = Def_nS_VICDHold;
               nS_RWnReady  = Def_nS_RWnReady;
               nS_DMAAssert = Def_nS_DMAAssert;
               nS_DMABAWait = Def_nS_DMABAWait;
               Cyc_KernProp = Def_Cyc_KernProp;
               nS_KSenseSample = Def_nS_KSenseSample;
               CmdChannel->printf("Defaults set (%s %s)\n", (IO1[wRegVid_TOD_Clks] & rvtcNTSC) ? "NTSC" : "PAL",
                  (IO1[wRegVid_TOD_Clks] & rvtcC128) ? "C128" : "C64");
               break;
            }
            default:
               CmdChannel->printf("No changes\n");
               break;
         }
         CmdChannel->printf("Current:    Variable  Val (Command)\n");
         CmdChannel->printf("\t nS_MaxAdj   %04d (tm####)\n", nS_MaxAdj);
         CmdChannel->printf("\t nS_RWnReady  %03d (tr###)\n", nS_RWnReady);
         CmdChannel->printf("\t nS_PLAprop   %03d (tp###)\n", nS_PLAprop);
         CmdChannel->printf("\t nS_DataSetup %03d (ts###)\n", nS_DataSetup);
         CmdChannel->printf("\t nS_DataHold  %03d (th###)\n", nS_DataHold);
         CmdChannel->printf("\t nS_VICStart  %03d (tv###)\n", nS_VICStart);
         CmdChannel->printf("\t nS_VICDHold  %03d (ti###)\n", nS_VICDHold);
         CmdChannel->printf("\t nS_DMAAssert %03d (ta###)\n", nS_DMAAssert);
         CmdChannel->printf("\t nS_DMABAWait %03d (tb###)\n", nS_DMABAWait);
         CmdChannel->printf("\t nS_DMASetup  %03d (te###)\n", nS_DMASetup);
         CmdChannel->printf("\t nS_DMADataHold  %03d (tw###)\n", nS_DMADataHold);
         CmdChannel->printf("\t nS_DMADataSetup %03d (ty###)\n", nS_DMADataSetup);
         CmdChannel->printf("\t Cyc_KernProp  %02d (tk##)\n", Cyc_KernProp);
      #ifdef Fab04_KernalReplace
         CmdChannel->printf("\t KSenseMode    %lu, in effect %u (tx#: 0 Skoe, 2 DMA, 9 auto)\n", KSenseMode, KSenseEff);
         CmdChannel->printf("\t nS_KSenseSample %03lu (tn###)\n", nS_KSenseSample);
      #endif

         CmdChannel->printf("\tSet Defaults      (td)\n");
         CmdChannel->printf("\tList current vals (t)\n-----\n");
         break;  
   #endif
   
   }
}

FLASHMEM void ProcessCommand()
{
   //0x64 command indicator received
   if(!SerialAvailabeTimeout()) return;
   uint16_t TokenVal = 0x6400 | CmdChannel->read(); //Read second byte
   
   //only these commands are available when busy:
   switch (TokenVal)
   {
   #ifdef Fab04_FullDMACapable
      case WriteC64MemToken: //Write to C64 mem via DMA
         WriteC64MemCommand();
         return;
      case WriteC64SpansToken: //Write C64 mem spans via DMA, sliced
         WriteC64SpansCommand();
         return;
      case SampleWatchToken: //Count C64 writes to one address
         SampleWatchCommand();
         return;
   #ifdef DbgSnoopTap
      case SnoopTapToken: //Set the snooped pages, take what was recorded
         SnoopTapCommand();
         return;
   #endif
      case ReadC64MemToken: //Write to C64 mem via DMA
         ReadC64MemCommand();
         return;
   #endif
      case ResetC64Token:   //Reset C64
         CmdChannel->println("Reset cmd received");  //UI looks for this string, do not change.
         BtnPressed = true;
         return;
      case LaunchFileToken:  //Launch File
         LaunchFile();
         return;
      case C64PauseOnToken: //pause C64 via DMA, during next bad line
         DMA_State = DMA_S_StartAsynch; 
         isFrozen = true;  //led will flash on/off
         SendU16(AckToken);
         return;
      case C64PauseOffToken: //un-pause C64 DMA
         DMA_State = DMA_S_StartDisable;
         isFrozen = false;
         SetLEDOn;
         SendU16(AckToken);
         return;
      case VersionInfoToken: //Version Info
         {
            char BuildInfo[sizeof SerialStringBuf];
            MakeBuildInfo(BuildInfo, sizeof BuildInfo);
            SendU16(AckToken);
            CmdChannel->printf("\n%s\n  %s0 Hz\n  Boot: %s\n", BuildInfo, StrMachineInfo, BootComplete ? "complete" : "in progress");
         }
         return;
      case FWCheckToken: //Check firmware type
         SendU16(FWFullToken);
         return;   
   }


   //ASID Player active: also allow Ping and file commands (SD/USB only, no IO1/IRQ); audio pauses while one runs
   bool ASIDAllowed = (CurrentIOHandler == IOH_ASID) &&
      (TokenVal == PingToken         || TokenVal == GetFileToken      ||
       TokenVal == GetDirectoryToken || TokenVal == GetDirNDJSONToken ||
       TokenVal == SendFileToken     || TokenVal == PostFileToken     ||
       TokenVal == CopyFileToken     || TokenVal == DeleteFileToken);

   if (CurrentIOHandler != IOH_TeensyROM && !ASIDAllowed)
   {
      //left unread, the time bytes would each run as a command of their own: 'e' resets EEPROM
      uint32_t RefusedTime;
      if (TokenVal == SetRTCToken) GetUInt(&RefusedTime, 4);
      SendU16(FailToken);
      CmdChannel->print("Busy!\n");
      return;
   }
   //TeensyROM IO Handler active, or ASID Player with an allowed command: additional commands available
   
   switch (TokenVal)
   {
      case PingToken:  //ping
         CmdChannel->printf("%s ready!\n", strVersionNumber);
         break;
      case SendFileToken: //file x-fer pc->TR
      case PostFileToken:  // v2 file x-fer pc->TR.  For use with v2 UI.
         PostFileCommand();
         break;
      case CopyFileToken:
         CopyFileCommand();
         break;
      case DeleteFileToken:
         DeleteFileCommand();
         break;
      case GetFileToken:
         GetFileCommand();
         break;
      case GetDirectoryToken:  // JSON directory listing (to be deprecated)
      case GetDirNDJSONToken:  // NDJSON directory listing from TR
         GetDirectoryCommand(TokenVal==GetDirNDJSONToken);
         break;
      case PauseSIDToken: //Pause SID
         if(RemotePauseSID()) SendU16(AckToken);
         else SendU16(FailToken);
         break;
      case SIDSpeedLinToken: //Set playback speed (Linear)
      case SIDSpeedLogToken: //Set playback speed (Logrithmic)
         if(RemoteSetSIDSpeed(TokenVal==SIDSpeedLogToken)) SendU16(AckToken);
         else SendU16(FailToken);
         break;
      case SetSIDSongToken: //Set sub-tune
         if(SetSIDSong()) SendU16(AckToken);
         else SendU16(FailToken);
         break;
      case SIDVoiceMuteToken: //Set Individual Voice muting
         if(RemoteSetSIDVoiceMute()) SendU16(AckToken);
         else SendU16(FailToken);
         break;
      case SetColorToken: //Set a TR UI color value
         if(SetColorRef()) SendU16(AckToken);
         else SendU16(FailToken);
         break;
      case SetRTCToken: //Set the real-time clock
         if(SetRTC()) SendU16(AckToken);
         else SendU16(FailToken);
         break;
      case DebugToken: //'dg'Test/debug
         //for (int a=0; a<256; a++) CmdChannel->printf("\n%3d, // %3d   '%c'", ToPETSCII(a), a, a);
         //Printf_dbg("isFab2x: %d\n", isFab2x()); 
         break;
      default:
         CmdChannel->printf("Unk cmd: 0x%04x\n", TokenVal); 
         break;
   }
}

FLASHMEM void AddAndCheckSource(StructMenuItem SourceMenu, uint32_t *TotalSize, uint32_t *FileCount)
{
   *FileCount += 1;
   *TotalSize += SourceMenu.Size;
   Printf_dbg(" Addr: $%08x  Size:%7d  Type:%3d  %s\n", (uint32_t)SourceMenu.Code_Image, SourceMenu.Size, SourceMenu.ItemType, SourceMenu.Name);

   if (((uint32_t)SourceMenu.Code_Image & 0xF0000000) == 0x20000000)
      CmdChannel->printf("*--> %s is using RAM!!!\n", SourceMenu.Name);
}

FLASHMEM void GetDigits(uint8_t NumDigits, uint32_t *SetInt)
{
   char inStr[NumDigits+1];
   
   for(uint8_t DigNum=0; DigNum<NumDigits; DigNum++)
   {
      if(!CmdChannel->available())
      {
         CmdChannel->println("\nNot enough Digits!\n");
         return;
      }
      inStr[DigNum] = CmdChannel->read(); 
   }
   inStr[NumDigits]=0;
   *SetInt = atol(inStr);
   CmdChannel->printf("\nVal Set to: %d\n\n", *SetInt);
}

FLASHMEM void PrintDebugLog()
{
   bool LogDatavalid = false;
   
   #ifdef DbgIOTraceLog
      CmdChannel->println("DbgIOTraceLog enabled");
      LogDatavalid = true;
   #endif
      
   #ifdef DbgCycAdjLog
      CmdChannel->println("DbgCycAdjLog enabled");
      LogDatavalid = true;
   #endif
      
   #ifdef DbgSpecial
      CmdChannel->println("DbgSpecial enabled");
      LogDatavalid = true;
   #endif
      
   if (CurrentIOHandler == IOH_Debug)
   {
      CmdChannel->println("Debug IO Handler enabled");
      LogDatavalid = true;
   }               
   
   if (!LogDatavalid)
   {
      CmdChannel->println("No logging enabled");
      return;
   }
   
   bool BufferFull = (BigBufCount == BigBufSize-1); //loggers stop counting here: the last entry is scratch, not printed

   for(uint16_t Cnt=0; Cnt<BigBufCount; Cnt++)
   {
      CmdChannel->printf("#%04d ", Cnt);
      
      if (BigBuf[Cnt] & DbgSpecialData)
      //if(1)
      {
         CmdChannel->printf("DbgSpecialData: uS betw packets %lu\n", BigBuf[Cnt]);
         //BigBuf[Cnt] &= ~DbgSpecialData;
         //CmdChannel->printf("DbgSpecialData %04x : %02x\n", BigBuf[Cnt] & 0xFFFF, (BigBuf[Cnt] >> 24));
            //code used previously, in-situ:
               //#ifdef DbgSpecial
               //   if (BigBuf != NULL){
               //     BigBuf[BigBufCount] = Address | (HIROM_Image[Address & 0x1FFF]<<24) | DbgSpecialData;
               //     if (BigBufCount < BigBufSize) BigBufCount++;
               //   }
               //#endif
      }
      else if (BigBuf[Cnt] & AdjustedCycleTiming)
      {
         BigBuf[Cnt] &= ~AdjustedCycleTiming;
         CmdChannel->printf("skip %lu ticks = %lu nS, adj = %lu nS\n", BigBuf[Cnt], CycTonS(BigBuf[Cnt]), CycTonS(BigBuf[Cnt])-nS_MaxAdj);
      }
      else if (BigBuf[Cnt] & IOTLMarker)
      {  //after AdjustedCycleTiming: a long skip's tick count can reach the marker bit
         switch (BigBuf[Cnt] & 0xff)
         {
            case IOTLMrkHndlrSwitch:  CmdChannel->println("---- InitHndlr done, switching IO handler ----"); break;
            case IOTLMrkResetAssert:  CmdChannel->println("---- C64 reset asserted ----"); break;
            case IOTLMrkResetRelease: CmdChannel->println("---- C64 reset released ----"); break;
            default: CmdChannel->printf("---- marker %lu ----\n", BigBuf[Cnt] & 0xff); break;
         }
      }
      else
      {
         CmdChannel->printf("%s 0x%s%02x : ", (BigBuf[Cnt] & IOTLRead) ? "Read" : "\t\t\t\tWrite",
            (BigBuf[Cnt] & IOTLIO2) ? "df" : "de", BigBuf[Cnt] & 0xff);

         if (BigBuf[Cnt] & IOTLDataValid) CmdChannel->printf("%02x\n", (BigBuf[Cnt]>>8) & 0xff); //data is valid
         else CmdChannel->printf("n/a\n");
      }
   }
   
   if (BigBufCount == 0) CmdChannel->println("Buffer empty");
   if (BufferFull) CmdChannel->println("Buffer was full");
   CmdChannel->printf("Buffer Reset (Size: %d)\n", BigBufSize);
   BigBufCount = 0;
}

FLASHMEM void LaunchFile()
{            
   //   App: LaunchFileToken 0x6444
   //Teensy: AckToken 0x64CC or RetryToken/abort from minimal
   //   App: Send DriveType(1), DestPath/Name(up to MaxNamePathLength, null term)
   //        DriveTypes: (RegMenuTypes)
   //           USBDrive  = 0
   //           SD        = 1
   //           Teensy    = 2
   //Teensy: AckToken 0x64CC
   //   C64: file Launches

   //Launch file token has been received
   SendU16(AckToken);
   RegMenuTypes DriveType;
   char FileNamePath[MaxNamePathLength];
   
   if (ReceiveFileName(&DriveType, FileNamePath))
   {
      if (!LaunchFolderFits(FileNamePath))
      {
         SendU16(FailToken);
         CmdChannel->print("Path too long!\n");
         return;
      }
      SendU16(AckToken);
      RemoteLaunch(DriveType, FileNamePath, false);
   }
}

FLASHMEM bool ReceiveFileName(RegMenuTypes* DriveType, char *FileNamePath)
{
   uint32_t RecDrive;
   if (!GetUInt(&RecDrive, 1)) return false;
   
   if (RecDrive >= rmtNumTypes) return false;
   *DriveType = (RegMenuTypes)RecDrive;

   uint16_t CharNum=0;
   while (1) 
   {
      if(!SerialAvailabeTimeout()) return false;
      FileNamePath[CharNum] = CmdChannel->read();
      if (FileNamePath[CharNum]==0) return true;
      if (++CharNum == MaxNamePathLength)
      {
         SendU16(FailToken);
         CmdChannel->print("Path too long!\n");  
         return false;
      }
   }
}

FLASHMEM bool GetUInt(uint32_t *InVal, uint8_t NumBytes)
{  //Get NumBytes (4 max) raw bytes to construct InVal
   *InVal=0;
   for(int8_t ByteNum=NumBytes-1; ByteNum>=0; ByteNum--)
   {
      if(!SerialAvailabeTimeout()) return false;
      uint32_t ByteIn = CmdChannel->read();
      *InVal += (ByteIn << (ByteNum*8));
   }
   return true;
}

FLASHMEM void FlushCmdChannel(Stream *Channel)
{
   // EthernetClient::flush() and USBSerialBase::flush() wait with no deadline for the peer
   // to ACK; the bytes are already queued to go without them.
   if (Channel == &Serial) Serial.send_now();
}

FLASHMEM void SendU16(uint16_t SendVal)
{
   CmdChannel->write((uint8_t)(SendVal & 0xff));
   CmdChannel->write((uint8_t)((SendVal >> 8) & 0xff));
}

FLASHMEM void SendU32(uint32_t SendVal)
{
    CmdChannel->write((uint8_t)(SendVal & 0xff));
    CmdChannel->write((uint8_t)((SendVal >> 8) & 0xff));
    CmdChannel->write((uint8_t)((SendVal >> 16) & 0xff));
    CmdChannel->write((uint8_t)((SendVal >> 24) & 0xff));
}
   
//While Kernal Replace serves the KERNAL the Ethernet stack is polled from loop() (FnetLoopPollService in Teensy.ino), and a command
//  waiting here for its bytes runs inside loop(): keep polling, or a TCP payload longer than one segment stalls until the time-out.
FLASHMEM void CmdInputPoll()
{
#ifdef Fab04_KernalReplace
   FnetLoopPollService();
#endif
}

//Sends a reply span as the channel takes it. NativeEthernet's write() spins without a time-out until the whole span fits in the
//  socket's send buffer, and while Kernal Replace has the PIT masked the buffer only drains (and a lost segment is only retransmitted)
//  when the stack is polled: so poll while the channel is full. False if it took nothing for SerialTimoutMillis*4.
FLASHMEM bool CmdSendSpan(const uint8_t *Buf, uint32_t Len)
{
   uint32_t Quiet = millis();
   while (Len)
   {
      int Avail = CmdChannel->availableForWrite();
      if (Avail > 0)
      {
         uint32_t Chunk = min((uint32_t)Avail, Len);
         CmdChannel->write(Buf, Chunk);
         Buf += Chunk;
         Len -= Chunk;
         Quiet = millis();
      }
      else if (millis() - Quiet >= SerialTimoutMillis * 4) return false;
      else CmdInputPoll();
   }
   return true;
}

FLASHMEM bool SerialAvailabeTimeout()
{
   uint32_t StartTOMillis = millis();
   
   while(!CmdChannel->available() && (millis() - StartTOMillis) < SerialTimoutMillis) CmdInputPoll(); // timeout loop
   if (CmdChannel->available()) return(true);
   
   SendU16(FailToken);
   CmdChannel->print("Timeout!\n");  
   return(false);
}


uint32_t RAM2BytesFree() 
{
   extern char _heap_end[];
   extern char *__brkval;
   return (_heap_end - __brkval);
}

//memory info display via:
// https://forum.pjrc.com/threads/33443-How-to-display-free-ram
// https://www.pjrc.com/store/teensy41.html#memory

#if ARDUINO_TEENSY41
  extern "C" uint8_t external_psram_size;
#endif
  
FLASHMEM void memInfo () 
{
  constexpr auto RAM_BASE   = 0x2020'0000;
  constexpr auto RAM_SIZE   = 512 << 10;
  constexpr auto FLASH_BASE = 0x6000'0000;
  
//#if ARDUINO_TEENSY40
//  constexpr auto FLASH_SIZE = 2 << 20;
//#elif ARDUINO_TEENSY41
//  constexpr auto FLASH_SIZE = 8 << 20;
//#endif

  // note: these values are defined by the linker, they are not valid memory
  // locations in all cases - by defining them as arrays, the C++ compiler
  // will use the address of these definitions - it's a big hack, but there's
  // really no clean way to get at linker-defined symbols from the .ld file

  extern char _stext[], _etext[], _sbss[], _ebss[], _sdata[], _edata[],
         _estack[], _heap_start[], _heap_end[], _itcm_block_count[], *__brkval;

  auto sp = (char*) __builtin_frame_address(0);

  CmdChannel->printf("MemInfo:\n");
  CmdChannel->printf("_stext        %08x\n",      _stext);
  CmdChannel->printf("_etext        %08x +%db\n", _etext, _etext - _stext);
  CmdChannel->printf("_sdata        %08x\n",      _sdata);
  CmdChannel->printf("_edata        %08x +%db\n", _edata, _edata - _sdata);
  CmdChannel->printf("_sbss         %08x\n",      _sbss);
  CmdChannel->printf("_ebss         %08x +%db\n", _ebss, _ebss - _sbss);
  CmdChannel->printf("curr stack    %08x +%db\n", sp, sp - _ebss);
  CmdChannel->printf("_estack       %08x +%db\n", _estack, _estack - sp);
  CmdChannel->printf("_heap_start   %08x\n",      _heap_start);
  CmdChannel->printf("__brkval      %08x +%db\n", __brkval, __brkval - _heap_start);
  CmdChannel->printf("_heap_end     %08x +%db\n", _heap_end, _heap_end - __brkval);
  
#if ARDUINO_TEENSY41
  extern char _extram_start[], _extram_end[], *__brkval;
  CmdChannel->printf("_extram_start %08x\n",      _extram_start);
  CmdChannel->printf("_extram_end   %08x +%db\n", _extram_end,
         _extram_end - _extram_start);
#endif
  CmdChannel->printf("\n");

  CmdChannel->printf("<ITCM>  %08x .. %08x\n",
         _stext, _stext + ((int) _itcm_block_count << 15) - 1);
  CmdChannel->printf("<DTCM>  %08x .. %08x\n",
         _sdata, (uint32_t)(uintptr_t)_estack - 1);
  CmdChannel->printf("<RAM>   %08x .. %08x\n",
         RAM_BASE, RAM_BASE + RAM_SIZE - 1);
  CmdChannel->printf("<FLASH> %08x .. %08x\n",
         FLASH_BASE, FLASH_BASE + FLASH_SIZE - 1);
#if ARDUINO_TEENSY41
  if (external_psram_size > 0)
    CmdChannel->printf("<PSRAM> %08x .. %08x\n",
           _extram_start, _extram_start + (external_psram_size << 20) - 1);
#endif
  CmdChannel->printf("\n");

  auto stack = sp - _ebss;
  CmdChannel->printf("avail STACK (RAM1) %8d b %5d kb\n", stack, stack >> 10);

  auto heap = _heap_end - __brkval;
  CmdChannel->printf("avail HEAP  (RAM2) %8d b %5d kb\n", heap, heap >> 10);

#if ARDUINO_TEENSY41
  auto psram = _extram_start + (external_psram_size << 20) - _extram_end;
  CmdChannel->printf("avail PSRAM (ext)  %8d b %5d kb\n", psram, psram >> 10);
#endif
}

FLASHMEM void  getFreeITCM() 
{ // end of CODE ITCM, skip full 32 bits
   uint32_t *ptrFreeITCM;  // Set to Usable ITCM free RAM
   uint32_t  sizeofFreeITCM; // sizeof free RAM in uint32_t units.
   uint32_t  SizeLeft_etext;
   extern char _stext[], _etext[];
   
   CmdChannel->println("\ngetFreeITCM:");
   SizeLeft_etext = (32 * 1024) - (((uint32_t)&_etext - (uint32_t)&_stext) % (32 * 1024));
   sizeofFreeITCM = SizeLeft_etext - 4;
   sizeofFreeITCM /= sizeof(ptrFreeITCM[0]);
   ptrFreeITCM = (uint32_t *) ( (uint32_t)&_stext + (uint32_t)&_etext + 4 );
   CmdChannel->printf( "Size of Free ITCM in Bytes = %u\n", sizeofFreeITCM * sizeof(ptrFreeITCM[0]) );
   CmdChannel->printf( "Start of Free ITCM = %u [%X] \n", ptrFreeITCM, ptrFreeITCM);
   CmdChannel->printf( "End of Free ITCM = %u [%X] \n", ptrFreeITCM + sizeofFreeITCM, ptrFreeITCM + sizeofFreeITCM);
   //for ( uint32_t ii = 0; ii < sizeofFreeITCM; ii++) ptrFreeITCM[ii] = 1;
   //uint32_t jj = 0;
   //for ( uint32_t ii = 0; ii < sizeofFreeITCM; ii++) jj += ptrFreeITCM[ii];
   //CmdChannel->printf( "ITCM DWORD cnt = %u [#bytes=%u] \n", jj, jj*4);
}

// The WriteC64Spans command's deadline for the whole command, not only SerialAvailabeTimeout's per
// byte, which leaves every byte's wait for the peer to spend with the C64 unserved.  2 bytes/mS is
// under every channel's rate, the 115200 baud USB host port included.  Bytes is the command's length so far.
FLASHMEM uint32_t SpansCeilingmS(uint32_t Bytes) { return SerialTimoutMillis * 10 + Bytes / 2; }

// Throws away up to Owed bytes a failed sender can still send unprompted, so they are not parsed
// as commands.  Ends early on quiet longer than a TCP retransmit, or 2 S past SpansCeilingmS(Bytes)
// counted from Began.  A caller with no command deadline passes millis() and Owed, so the ceiling
// runs from the failure; WriteC64Spans passes its command's start and length, so it runs from there.
FLASHMEM void DiscardCmdInput(uint32_t Owed, uint32_t Began, uint32_t Bytes)
{
   const uint32_t CeilingmS = SpansCeilingmS(Bytes) + SerialTimoutMillis * 4;
   uint32_t Quiet = millis();
   while (Owed && millis() - Quiet < SerialTimoutMillis * 2 && millis() - Began < CeilingmS)
      if (CmdChannel->available()) { CmdChannel->read(); Owed--; Quiet = millis(); }
      else CmdInputPoll();
}

#ifdef Dbg_SerSD
// SD card info, then a copy of SdFat's TeensySdioDemo speed test (examples/TeensySdioDemo), then
// what a MinimalBoot bank swap does (LoadBank in IOH_EasyFlash.c): a seek and one 8K read, timed in uS.
// Writes, then deletes, an 8 MiB file in the SD root.
FLASHMEM void SDSpeedTest()
{
   const char *TestFileName = "/SDSpeedTest.bin";
   const uint32_t BufSize = 32768;              //largest transfer size tested
   const uint32_t TestFileSize = 256*BufSize;   //8 MiB, as in TeensySdioDemo, so results compare

   if (CurrentIOHandler != IOH_TeensyROM)
   {  //holds up loop() for several seconds, which would stall a running handler's polling
      CmdChannel->println("Busy! Run from the TR menu");
      return;
   }

   CmdChannel->println("\n***** SD card info *****");
   if (!SDFullInit()) //re-begin, so the clock is negotiated fresh
   {
      CmdChannel->println("No SD card");
      return;
   }

   SdCard *Card = SD.sdfs.card();
   //an SdioCard: SD.begin(BUILTIN_SDCARD) begins with SdioConfig(FIFO_SDIO)
   uint32_t kHzClk = static_cast<SdioCard*>(Card)->kHzSdClk();
   CmdChannel->printf("SdFat %s, SDIO 4-bit, FIFO mode\n", SD_FAT_VERSION_STR);
   CmdChannel->printf("SD clock: %lu kHz (%s)\n", kHzClk, kHzClk >= 49000 ? "High Speed" : "Default Speed");

   csd_t CSD;
   bool CSDValid = Card->readCSD(&CSD);
   uint32_t EraseSize = 0; //flash erase size in 512 byte blocks, 0 if unknown
   if (!CSDValid) PrintSDError("readCSD failed");
   else if (CSD.v1.csd_ver == 0) EraseSize = ((CSD.v1.sector_size_high << 1) | CSD.v1.sector_size_low) + 1;
   else if (CSD.v2.csd_ver == 1) EraseSize = ((CSD.v2.sector_size_high << 1) | CSD.v2.sector_size_low) + 1;

   const char *CardType = "Unknown";
   switch (Card->type())
   {
      case SD_CARD_TYPE_SD1:  CardType = "SD1"; break;
      case SD_CARD_TYPE_SD2:  CardType = "SD2"; break;
      case SD_CARD_TYPE_SDHC: CardType = (CSDValid && sdCardCapacity(&CSD) >= 70000000) ? "SDXC" : "SDHC"; break;
   }
   uint32_t Sectors = Card->sectorCount();
   CmdChannel->printf("Card type: %s, %lu MB (%lu sectors)\n", CardType, (uint32_t)((uint64_t)Sectors*512/1000000), Sectors);

   cid_t CID;
   if (Card->readCID(&CID))  //SdFat 2.1.2's psn holds the CID's big-endian bytes as read, so swap them
      CmdChannel->printf("CID: Mfr 0x%02x, OEM %c%c, Product %.5s, Rev %d.%d, SN 0x%08lx, Made %d/%d\n",
         CID.mid, CID.oid[0], CID.oid[1], CID.pnm, CID.prv_n, CID.prv_m, __builtin_bswap32(CID.psn),
         CID.mdt_month, 2000 + 16*CID.mdt_year_high + CID.mdt_year_low);
   else PrintSDError("readCID failed");

   uint32_t OCR;
   if (Card->readOCR(&OCR)) CmdChannel->printf("OCR: 0x%08lx\n", OCR);
   else PrintSDError("readOCR failed");

   uint8_t FatType = SD.sdfs.fatType();
   uint32_t ClusterBytes = SD.sdfs.bytesPerCluster();
   uint32_t FreeClusters = SD.sdfs.freeClusterCount(); //scans the FAT/bitmap
   if (FatType <= 32) CmdChannel->printf("Volume: FAT%d", FatType);
   else CmdChannel->printf("Volume: exFAT");
   CmdChannel->printf(", %luK clusters, %lu clusters, %lu MB free\n", ClusterBytes/1024, SD.sdfs.clusterCount(),
      (uint32_t)((uint64_t)FreeClusters*ClusterBytes/1000000));
   uint32_t DataStart = SD.sdfs.dataStartSector();
   CmdChannel->printf("Data start sector: %lu", DataStart);
   if (EraseSize) CmdChannel->printf(", %saligned to the %lu block erase size", (DataStart % EraseSize) ? "NOT " : "", EraseSize);
   CmdChannel->println();

   //From the heap, not RAM_Image, which can be holding a running cartridge's ROM
   uint8_t *Buf = (uint8_t *)malloc(BufSize);
   if (!Buf)
   {
      CmdChannel->printf("No memory for a %lu byte buffer\n", BufSize);
      return;
   }
   uint32_t *Buf32 = (uint32_t *)Buf;

   FsFile TestFile = SD.sdfs.open(TestFileName, O_RDWR | O_CREAT | O_TRUNC); //truncate one left by an interrupted run
   if (!TestFile)
   {
      PrintSDError("Test file open failed");
      free(Buf);
      return;
   }

   //From here on, errors drop through to the cleanup at the end
   bool Passed = true;
   CmdChannel->printf("\n***** Speed test: %s, %lu MiB *****\n", TestFileName, TestFileSize/1048576);
   CmdChannel->printf("%7s %9s %9s %10s %10s\n", "Size", "Write", "Read", "Max write", "Max read");
   CmdChannel->printf("%7s %9s %9s %10s %10s\n", "bytes", "KB/sec", "KB/sec", "uS", "uS");
   for (uint32_t BlkSize = 512; Passed && BlkSize <= BufSize; BlkSize *= 2)
   {
      uint32_t NumBlks = TestFileSize/BlkSize;
      uint32_t MaxWrite = 0, MaxRead = 0;
      if (!TestFile.truncate(0))
      {
         PrintSDError("truncate failed");
         Passed = false;
         break;
      }

      uint32_t WriteMicros = micros();
      for (uint32_t BlkNum = 0; BlkNum < NumBlks; BlkNum++)
      {
         Buf32[0] = BlkNum; //marks the start and end of each block, checked when read back
         Buf32[BlkSize/4 - 1] = BlkNum;
         uint32_t CallMicros = micros();
         if (TestFile.write(Buf, BlkSize) != BlkSize)
         {
            PrintSDError("write failed");
            Passed = false;
            break;
         }
         CallMicros = micros() - CallMicros;
         if (CallMicros > MaxWrite) MaxWrite = CallMicros;
      }
      WriteMicros = micros() - WriteMicros;
      if (!Passed) break;

      TestFile.rewind();
      uint32_t ReadMicros = micros();
      for (uint32_t BlkNum = 0; BlkNum < NumBlks; BlkNum++)
      {
         uint32_t CallMicros = micros();
         if (TestFile.read(Buf, BlkSize) != (int)BlkSize)
         {
            PrintSDError("read failed");
            Passed = false;
            break;
         }
         CallMicros = micros() - CallMicros;
         if (CallMicros > MaxRead) MaxRead = CallMicros;
         if (Buf32[0] != BlkNum || Buf32[BlkSize/4 - 1] != BlkNum)
         {
            CmdChannel->printf("Data check failed: %lu byte block #%lu\n", BlkSize, BlkNum);
            Passed = false;
            break;
         }
      }
      ReadMicros = micros() - ReadMicros;
      if (!Passed) break;

      CmdChannel->printf("%7lu %9lu %9lu %10lu %10lu\n", BlkSize, (uint32_t)((uint64_t)TestFileSize*1000/WriteMicros),
         (uint32_t)((uint64_t)TestFileSize*1000/ReadMicros), MaxWrite, MaxRead);
   }

   //exFAT only: SdFat's FAT32 contiguous flag isn't set by ordinary writes, so it would read "no" regardless
   if (Passed && FatType > 32) CmdChannel->printf("Test file contiguous (seeks skip the FAT chain): %s\n",
      TestFile.isContiguous() ? "yes" : "no");

   if (Passed)
   {  //Bank swap: CRT bank data sits at 0x40 (CRT header) + 0x10 (CHIP header), then every 0x2010
      //  (CHIP header + 8K), so the reads aren't sector aligned, as with a real CRT
      const uint32_t NumSwaps = 256;
      const uint32_t FirstBank = 0x50, BankStride = 0x2010;
      uint32_t NumBanks = (TestFileSize - FirstBank - 0x2000)/BankStride + 1;
      uint32_t MinMicros = 0xffffffff, MaxMicros = 0, TotalMicros = 0, NumOver1mS = 0;

      CmdChannel->printf("\n***** Bank swap test: %lu seek + 8K reads at CRT bank offsets *****\n", NumSwaps);
      for (uint32_t SwapNum = 0; SwapNum < NumSwaps; SwapNum++)
      {
         uint32_t Bank = (SwapNum * 389) % NumBanks; //fixed scattered order: seeks both ways, same every run
         uint32_t CallMicros = micros();
         if (!TestFile.seek(FirstBank + Bank*BankStride) || TestFile.read(Buf, 8192) != 8192)
         {
            PrintSDError("Bank read failed");
            Passed = false;
            break;
         }
         CallMicros = micros() - CallMicros;
         TotalMicros += CallMicros;
         if (CallMicros < MinMicros) MinMicros = CallMicros;
         if (CallMicros > MaxMicros) MaxMicros = CallMicros;
         if (CallMicros > 1000) NumOver1mS++;
      }
      if (Passed) CmdChannel->printf("Per 8K bank: min %luuS, avg %luuS, max %luuS; %lu of %lu over 1mS\n",
         MinMicros, TotalMicros/NumSwaps, MaxMicros, NumOver1mS, NumSwaps);
   }

   TestFile.close();
   if (!SD.sdfs.remove(TestFileName)) CmdChannel->printf("Couldn't remove %s\n", TestFileName);
   free(Buf);
   CmdChannel->println(Passed ? "Done" : "Stopped on error");
}

FLASHMEM void PrintSDError(const char *What)
{
   uint8_t ErrCode = SD.sdfs.sdErrorCode();
   if (!ErrCode)
   {  //no card command failed: the file system refused, a full card for one
      CmdChannel->printf("%s, a file system error, not a card error (card full?)\n", What);
      return;
   }
   CmdChannel->printf("%s, SD error 0x%02x ", What, ErrCode);
   printSdErrorSymbol(CmdChannel, ErrCode);
   CmdChannel->printf(", data 0x%02x\n", SD.sdfs.sdErrorData());
}
#endif

#ifdef Fab04_FullDMACapable
// Staging for one remote DMA command, from the heap and freed when the command returns.  Not
// RAM_Image, which can be holding a running cartridge's ROM or REU emulation's banks.  Those
// take heap too, REU emulation up to 512 KiB of it, so an allocation can fail, and the command
// then refuses.
struct DMAStage
{
   uint8_t *const Buf;
   explicit DMAStage(uint32_t Len) : Buf((uint8_t *)malloc(Len ? Len : 1)) {}
   ~DMAStage() { free(Buf); }
};

// Command: 
// Write sequential C64 memory segment with supplied data
// 
// Workflow:
// Receive <-- WriteC64MemToken (0x64FB)
// Receive <-- C64 address (Hi,Low)
// Receive <-- Data Length (Hi,Low)
// Receive <-- Data Bytes (Data Length)
// TR+ Performs DMA Write
// Send --> AckToken 0x64CC on successful completion, 0x9b7f on Fail
FLASHMEM void WriteC64MemCommand() 
{
   uint32_t DMAAddr, DMALength;

   if (!GetUInt(&DMAAddr, 2))
   {
       SendU16(FailToken);
       CmdChannel->println("Error receiving address!");
       return;
   }

   if (!GetUInt(&DMALength, 2))
   {
       SendU16(FailToken);
       CmdChannel->println("Error receiving length!");
       return;
   }

   DMAStage Stage(DMALength);
   uint8_t *DMABuf = Stage.Buf;
   if (!DMABuf)
   {
      SendU16(FailToken);
      CmdChannel->printf("No memory to stage %lu bytes\n", DMALength);
      DiscardCmdInput(DMALength, millis(), DMALength);  // sent unprompted, and not to be read as commands
      return;
   }

   for(uint32_t ByteNum = 0; ByteNum < DMALength; ByteNum++) 
   {
      if(!SerialAvailabeTimeout())
      {
         SendU16(FailToken);
         CmdChannel->println("Error receiving data!");
         DiscardCmdInput(DMALength - ByteNum, millis(), DMALength - ByteNum);
         return;
      }
      DMABuf[ByteNum] = CmdChannel->read();
   }
   
   //uint32_t StartTime = micros();
   // Short-circuit: a failed PerformDMA has already released the bus, and calling CloseDMA
   // after it would only spend the stall window a second time.  A C64 that is switched off
   // is not the case this catches -- it powers the board too, so no command arrives to be
   // answered.  What is left is a C64 that still supplies 5 V but has stopped clocking, and
   // the checked return below is the whole of what catches it here: on a bus that has
   // already stopped WaitForDMAState ends each wait itself and PerformDMA reports the
   // failure.  A bus that stops part way through a transfer is caught by nothing at all --
   // DMATransferISR's edge waits are unbounded, see the fourth case named over WaitForDMAState in
   // DMAControl.c.  C64IsClockingPHI2 is deliberately not called on this path -- the bound
   // lives where the wait is -- so a new remote command is covered by checking this return
   // and by nothing else.
   if (!PerformDMA(DMA_WRITE, DMAAddr, DMABuf, DMALength, DMA_ADDR_INCREMENT) || !CloseDMA())
   {
      SendU16(FailToken);
      CmdChannel->println("No transfer: C64 bus not clocking, or DMA timed out");
      return;
   }
   //StartTime = micros() - StartTime;
   SendU16(AckToken);
   
   //CmdChannel->printf
   //Serial.printf("DMA Write: addr $%04x:$%04x (%lu Bytes) in %luuS\n", DMAAddr, DMAAddr+DMALength-1, DMALength, StartTime);
   //Serial.printf("DMA Write: addr $%04x:$%04x (%lu Bytes)\n", DMAAddr, DMAAddr+DMALength-1, DMALength);
}

// After is what the sender goes on to send without waiting for a reply.  On false a FailToken
// has gone out.  Patient waits out a pause under the command's deadline alone, rather than
// SerialAvailabeTimeout's per byte.
FLASHMEM bool ReceiveSpanBytes(uint8_t *Buf, uint32_t Len, uint32_t After, uint32_t Began, uint32_t Bytes,
                               bool Patient = false)
{
   for (uint32_t ByteNum = 0; ByteNum < Len; ByteNum++)
   {
      while (Patient && !CmdChannel->available() && millis() - Began < SpansCeilingmS(Bytes)) CmdInputPoll();
      if (millis() - Began >= SpansCeilingmS(Bytes))
      {
         SendU16(FailToken);
         CmdChannel->printf("Too slow, %lu of %lu bytes\n", ByteNum, Len);
         DiscardCmdInput(Len - ByteNum + After, Began, Bytes);
         return false;
      }
      if (!SerialAvailabeTimeout()) { DiscardCmdInput(Len - ByteNum + After, Began, Bytes); return false; }
      Buf[ByteNum] = CmdChannel->read();
   }
   return true;
}

FLASHMEM void RefuseSpans(const char *Why, uint32_t Owed, uint32_t Began)
{
   SendU16(FailToken);
   CmdChannel->println(Why);
   DiscardCmdInput(Owed, Began, C64SpansMax * 4);
}

// Command:
// Write up to 64 C64 memory spans by DMA, sliced so that no one halt outlasts what the C64 can take
//
// Workflow:
// Receive <-- WriteC64SpansToken (0x64FC)
// Send --> AckToken 0x64CC, or 0x9b7f and the reason while the C64 is paused
// Receive <-- Flags (C64SpansFlag*), slice bytes (0 = whole spans), gap between slices in uS, span count (1..64)
// Receive <-- Span count x { C64 address (Hi,Low), length (Hi,Low) }; with LockToStore, the first
//             entry is { store address (Hi,Low), 0 (Hi,Low) } and the gap is the longest wait for a store
// Send --> AckToken 0x64CC if the spans are accepted, 0x9b7f and the reason if not
// Receive <-- Data bytes for every span, in span order
// TR+ Performs DMA writes
// Send --> AckToken 0x64CC once every span has landed, 0x9b7f and the reason on Fail
//
// The sender waits for each reply before sending more.  Waiting on the first is what keeps firmware
// without this command, which answers "Unk cmd" or "Busy!", from reading the header and span list as
// commands of its own; waiting on the second keeps a refused payload from being read the same way.
FLASHMEM void WriteC64SpansCommand()
{
   static const char *const Why[] = {"", "Want 1 to 64 spans", "Empty span", "Span runs past $FFFF",
                                     "Span touches $DE00-$DFFF", "Spans exceed 64 KiB", "Over 1024 slices"};
   uint8_t Head[4], List[C64SpansMax * 4];
   C64Span Spans[C64SpansMax];
   uint32_t Total, Landed;
   const uint32_t Began = millis();

   // A paused C64 would be resumed by the first slice.
   if (isFrozen)
   {
      SendU16(FailToken);
      CmdChannel->println("C64 is paused");
      return;
   }
   SendU16(AckToken);
   // Until the count arrives the list it announces could be any length, so a header that fails leaves
   // the most to discard -- and a discard runs on while bytes keep coming, the sender's next command
   // among them.  So the header alone waits out a stall.
   if (!ReceiveSpanBytes(Head, sizeof Head, 255 * 4, Began, sizeof List, true)) return;
   const uint32_t Count = Head[3];
   // Firmware before LockToStore refuses every flag with "Flags must be 0", so a sender tells the
   // two apart by the refusal a flagged zero-span header gets: that text, or the span count's.
   if (Head[0] & ~C64SpansFlagsKnown) return RefuseSpans("Flags must be 0", Count * 4, Began);
   if (Count > C64SpansMax) return RefuseSpans(Why[(int)C64SpansCheck::BadCount], Count * 4, Began);
   if (!ReceiveSpanBytes(List, Count * 4, 0, Began, sizeof List)) return;
   const bool Locked = Head[0] & C64SpansFlagLockToStore;
   const uint32_t First = Locked ? 1 : 0;
   if (Count <= First) return RefuseSpans(Why[(int)C64SpansCheck::BadCount], 0, Began);
   for (uint32_t Num = 0; Num < Count; Num++)
      Spans[Num] = { (uint16_t)(List[Num*4] << 8 | List[Num*4+1]), (uint16_t)(List[Num*4+2] << 8 | List[Num*4+3]) };
   if (Locked && Spans[0].Len) return RefuseSpans("Store entry's length must be 0", 0, Began);

   // WriteC64Mem's reach.
   const C64SpansCheck Check = CheckC64Spans(Spans + First, Count - First, Head[1], 0x10000, &Total);
   if (Check != C64SpansCheck::OK) return RefuseSpans(Why[(int)Check], 0, Began);
   if (Locked && !SampleWatchStart(Spans[0].Addr)) return RefuseSpans("Bus snoop in use", 0, Began);
   DMAStage Stage(Total);
   if (!Stage.Buf) return RefuseSpans("No memory to stage the payload", 0, Began);
   SendU16(AckToken);
   if (!ReceiveSpanBytes(Stage.Buf, Total, 0, Began, sizeof List + Total)) return;

   if (!WriteC64Spans(Spans + First, Count - First, Stage.Buf, Head[1], Head[2], &Landed, Locked))
   {
      SendU16(FailToken);
      CmdChannel->printf("Stopped at %lu of %lu bytes: C64 bus not clocking, or DMA timed out\n", Landed, Total);
      return;
   }
   SendU16(AckToken);
}

// Command:
// Count the C64's writes to one address -- a sample player's store to its DAC -- to measure the
// NMIs a DMA halt costs it, and report the counts since the previous SampleWatch
//
// Workflow:
// Receive <-- SampleWatchToken (0x64F9)
// Receive <-- Mode (0 = stop watching, 1 = watch), C64 address (Hi,Low)
// Send --> AckToken 0x64CC, or 0x9b7f and the reason
// Send --> Intervals (4), interval ARM cycles (8), longest interval ARM cycles (4), locked slices (4),
//          unlocked slices (4), ARM cycles per second (4); each Low first, all since the previous SampleWatch
FLASHMEM void SampleWatchCommand()
{
   uint32_t Mode, Addr;
   if (!GetUInt(&Mode, 1) || !GetUInt(&Addr, 2))
   {
      SendU16(FailToken);
      CmdChannel->println("Error receiving mode and address!");
      return;
   }
   if (Mode > 1)
   {
      SendU16(FailToken);
      CmdChannel->println("Mode must be 0 or 1");
      return;
   }
   if (Mode == 0) SampleWatchStop();
   else if (!SampleWatchStart(Addr))
   {
      SendU16(FailToken);
      CmdChannel->println("Bus snoop in use");
      return;
   }
   const SampleWatchStats Stats = SampleWatchTake();
   SendU16(AckToken);
   SendU32(Stats.Intervals);
   SendU32(Stats.IntervalCyc);
   SendU32(Stats.IntervalCyc >> 32);
   SendU32(Stats.LongestCyc);
   SendU32(Stats.Locked);
   SendU32(Stats.Unlocked);
   SendU32(F_CPU_ACTUAL);
}

#if defined(DbgSnoopTap) && defined(Fab04_FullDMACapable)
// Receive <-- SnoopTapToken (0x64F8)
// Receive <-- Mode: 0 = take only, 1 = take, then watch the 256 page bytes that follow
//             (bit 0 writes, bit 1 reads, bit 2 the first write freezes the ring 64 entries later,
//             bit 3 on any page also records each locked slice's start),
//             2 = take, then stop
// Send --> AckToken 0x64CC, or 0x9b7f and the reason
// Send --> ARM cycles per second (4), cycles recorded since the last take (4), cycles not recorded
//          while taking or frozen (4), page cycles seen, recorded or not (4), whether a trigger fired (1), entries sent (2), then each entry oldest first: ARM cycle (4),
//          C64 address (2), data (1), info (1); all Low first
FLASHMEM void SnoopTapCommand()
{
   uint32_t Mode;
   if (!GetUInt(&Mode, 1) || Mode > 2)
   {
      SendU16(FailToken);
      CmdChannel->println("Mode must be 0, 1 or 2");
      return;
   }
   uint8_t Pages[256] = {};
   if (Mode == 1)
      for (uint32_t Page = 0; Page < 256; Page++)
      {
         uint32_t Want;
         if (!GetUInt(&Want, 1))
         {
            SendU16(FailToken);
            CmdChannel->println("Error receiving pages!");
            return;
         }
         Pages[Page] = Want;
      }
   SnoopPaused = true;
   const uint32_t Total = SnoopTotal, Skipped = SnoopSkipped, Taps = SnoopTaps;
   const uint32_t Sent = Total < SnoopRingSize ? Total : SnoopRingSize;
   SendU16(AckToken);
   SendU32(F_CPU_ACTUAL);
   SendU32(Total);
   SendU32(Skipped);
   SendU32(Taps);
   CmdChannel->write(SnoopTriggered ? 1 : 0);
   SendU16(Sent);
   static_assert(sizeof(SnoopEntry) == 8, "SnoopRing is sent as is: the entry layout is the wire format");
   const uint32_t Oldest = (Total - Sent) % SnoopRingSize;
   const uint32_t BeforeWrap = min(Sent, SnoopRingSize - Oldest);
   if (!CmdSendSpan((const uint8_t *)&SnoopRing[Oldest], BeforeWrap * sizeof(SnoopEntry)) ||
       !CmdSendSpan((const uint8_t *)SnoopRing, (Sent - BeforeWrap) * sizeof(SnoopEntry)))
      Printf_dbg("Snoop tap: reply stalled\n"); //Ack already sent, the host times out
   FlushCmdChannel(CmdChannel);
   if (Mode != 0)
   {
      SnoopMarkSlices = false;
      memcpy(SnoopHot, Pages, sizeof SnoopHot);
      for (uint32_t Page = 0; Page < 256; Page++)
         if (Pages[Page] & SnoopSlices) SnoopMarkSlices = true;
   }
   // What the ISR counted while the ring was being sent stays for the next take.
   __disable_irq();
   SnoopTotal = 0;
   SnoopSkipped -= Skipped;
   SnoopTaps -= Taps;
   SnoopTriggered = false;
   SnoopPaused = false;
   __enable_irq();
}
#endif

// Command:
// read sequential C64 memory segment and send to host
// 
// Workflow:
// Receive <-- ReadC64MemToken (0x64FD)
// Receive <-- C64 address (Hi,Low)
// Receive <-- Data Length (Hi,Low)
// TR+ Performs DMA Read
// Send --> AckToken 0x64CC on successful Read, 0x9b7f on Fail
// Send --> Data Bytes (Data Length)
FLASHMEM void ReadC64MemCommand() 
{
   uint32_t DMAAddr, DMALength;

   if (!GetUInt(&DMAAddr, 2))
   {
       SendU16(FailToken);
       CmdChannel->println("Error receiving address!");
       return;
   }

   if (!GetUInt(&DMALength, 2))
   {
       SendU16(FailToken);
       CmdChannel->println("Error receiving length!");
       return;
   }

   DMAStage Stage(DMALength);
   uint8_t *DMABuf = Stage.Buf;
   if (!DMABuf)
   {
      SendU16(FailToken);
      CmdChannel->printf("No memory to stage %lu bytes\n", DMALength);
      return;
   }
   
   //uint32_t StartTime = micros();
   // Same reach as the write above.  Checked here for the second reason too: DMABuf holds
   // whatever the heap last had there, so acking a transfer that did not happen would send
   // that back as the contents of C64 memory.
   if (!PerformDMA(DMA_READ, DMAAddr, DMABuf, DMALength, DMA_ADDR_INCREMENT) || !CloseDMA())
   {
      SendU16(FailToken);
      CmdChannel->println("No transfer: C64 bus not clocking, or DMA timed out");
      return;
   }

   //StartTime = micros() - StartTime;
   SendU16(AckToken);
   
   if (!CmdSendSpan(DMABuf, DMALength)) Printf_dbg("DMA Read: reply stalled, %lu bytes\n", DMALength); //Ack already sent, the host times out
   
   //CmdChannel->printf
   //Serial.printf("DMA Read: addr $%04x:$%04x (%lu Bytes) in %luuS\n", DMAAddr, DMAAddr+DMALength-1, DMALength, StartTime);
   //Serial.printf("DMA Read: addr $%04x:$%04x (%lu Bytes)\n", DMAAddr, DMAAddr+DMALength-1, DMALength);
}
#endif
