SensoriumEmbedded/TeensyROM/Source/Teensy/TeensyROM.h

// MIT License
// 
// Copyright (c) 2023 Travis Smith
// 
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
#include "TRMenuFiles/ROMs/TeensyROMC64.h" //TeensyROM Menu cart, stored in RAM

#define DefSIDSource        rmtTeensy  // Default, should always be local (rmtTeensy)
#define DefSIDPath          "/Featured SIDs" 
#define DefSIDName          "DivertigO:   Death Is No Evil" 

#define MaxRAM_ImageSize  (128)  // RAM1 space (in kB) used for CRT & Transfer buffer
// Test case: Random(?) NFC tag with large directory, crash when tapped
//    20000 free got further, but still crashes.  Less always crashes
//    *Need >24000 RAM1 free for local
// 9/25/2025(v6.8+) reduced 16k from 144 to 128, now 36476 free (from 20k)

//Build options: 

//Feature enables
   #define FeatTCPListen //Enable TCP Listen capability for remote commands

//Debug messaging: enable at your own risk, can cause emulation interference/fails
  // #define DbgMsgs_IO    //All other Serial out messages (Printf_dbg)
  // #define DbgMsgs_SW    //Swiftlink Serial out messages (Printf_dbg_sw)
  // #define DbgMsgs_M2S   //MIDI2SID MIDI handler messages

//Special use serial commands:
  // #define Dbg_SerDMA    //Serial commands that do direct DMAs.
  // #define Dbg_SerTimChg //Serial commands that tweak timing parameters.
  // #define Dbg_SerSwift  //Serial commands that tweak SwiftLink parameters.
  // #define Dbg_SerMem    //Serial commands that display memory info
  // #define Dbg_SerASID   //Serial commands that test the ASID player + queue adjust info
  // #define Dbg_SerSD     //Serial command 'o': SD card info + speed test (writes, then deletes, an 8 MiB file)
 
//logging:
  // #define Dbg_SerLog    //Serial commands that display log info
  // #define DbgIOTraceLog //Logs Reads/Writes to/from IO1 to BigBuf. Like debug handler but can use for others
  // #define DbgCycAdjLog  //Logs ISR timing adjustments to BigBuf.
  // #define DbgSpecial    //Special case logging to BigBuf
 
//Debug HW signal enables: Recommend using only 1 at a time.
  // DbgMsgs_SW (above) includes LED/DBG signal control
  // #define DbgSignalASIDIRQ  //state toggles on each IRQ triggered to C64 (timed or untimed)
  // #define DbgSignalIsrPHI2  //high at start of Phi2 ISR, low when exits
  // #define DbgLEDSignalPolling //toggles LED each pass through main loop()
