SensoriumEmbedded/TeensyROM/Source/Teensy/src/USBHost_t36/USBFilesystemFormatter.cpp

#include <Arduino.h>
#include "utility/USBFilesystemFormatter.h"

#ifndef DBG_FAIL_MACRO
#define DBG_FAIL_MACRO
#endif
uint16_t toUpcase(uint16_t chr);

//=============================================
#define DBG_FILE "USBFilesystemFormatter.cpp"
//Set to 0 for debug info
//#define DBG_Print  0
#if defined(DBG_Print)
#define DBGPrintf Serial.printf
#else
void inline DBGPrintf(...) {};
#endif

#define PRINT_FORMAT_PROGRESS 1
#if !PRINT_FORMAT_PROGRESS
#define writeMsg(str)
void inline writeMsgF(...) {};
#elif defined(__AVR__)
#define writeMsg(str) if (m_pr) m_pr->print(F(str))
#define writeMsgF if (m_pr) m_pr->printf
#else  // PRINT_FORMAT_PROGRESS
#define writeMsg(str) if (m_pr) m_pr->write(str)
#define writeMsgF if (m_pr) m_pr->printf
#endif  // PRINT_FORMAT_PROGRESS

//=============================================
// Set nonzero to use calculated CHS in MBR.  Should not be required.
#define USE_LBA_TO_CHS 1
// Constants for file system structure optimized for flash.
uint16_t const BU16 = 128;
uint16_t  BU32 = 8192;
// Assume 512 byte sectors.
const uint16_t BYTES_PER_SECTOR = 512;
const uint16_t SECTORS_PER_MB = 0X100000/BYTES_PER_SECTOR;
const uint16_t FAT16_ROOT_ENTRY_COUNT = 512;
const uint16_t FAT16_ROOT_SECTOR_COUNT =
               32*FAT16_ROOT_ENTRY_COUNT/BYTES_PER_SECTOR;
			   
//Support for exFat formatting
const uint32_t BOOT_BACKUP_OFFSET = 12;
const uint16_t SECTOR_MASK = BYTES_PER_SECTOR - 1;
const uint8_t  BYTES_PER_SECTOR_SHIFT = 9;
const uint16_t MINIMUM_UPCASE_SKIP = 512;
const uint32_t BITMAP_CLUSTER = 2;
const uint32_t UPCASE_CLUSTER = 3;
const uint32_t ROOT_CLUSTER = 4;

//=============================================
bool USBFilesystemFormatter::format(USBFilesystem &fs, uint8_t fat_type, uint8_t* secBuf, print_t* pr)
{
  // We can extract the device and partition from the fs object. 
  DBGPrintf("\n### USBFilesystemFormatter::formatFAT called\n");
  DBGPrintf("\tFattype: FS:%u Opt:%u\n", fs.mscfs.fatType(), fat_type);
  if (fat_type == 0) fat_type = fs.mscfs.fatType();
  switch (fat_type) {
    case FAT_TYPE_FAT16:
    case FAT_TYPE_FAT32:
    //case FAT_TYPE_FAT12
      return formatFAT(*fs.device, fs, fs.partition, fat_type, secBuf, pr);
    case FAT_TYPE_EXFAT:
      return formatExFAT(*fs.device, fs, fs.partition, fat_type, secBuf, pr);
  }
  return false;
}

//====================================================
bool USBFilesystemFormatter::formatFAT(USBDrive &dev, USBFilesystem &fs, uint8_t part, uint8_t fat_type, uint8_t* secBuf, print_t* pr)
{
  DBGPrintf("\n### USBFilesystemFormatter::formatFAT called\n");

  bool rtn;
  m_secBuf = secBuf;
  m_pr = pr;
  writeMsg("Begin format Fat File system\n");
  //m_dev = partVol.blockDevice();
  m_part = part-1;  // convert to 0 biased. 
  
  uint32_t firstLBA;  //comes from getpartitioninfo in pfslib
  uint32_t sectorCount;
  uint32_t mbrLBA; //comes from getpartitioninfo in pfslib
  uint8_t mbrPart;
  int mbrType;
  char volName[32];

  //findPartion using partition number non-zero biased - it does the zero biasing in the function
  int vt = dev.findPartition(part, mbrType, firstLBA, sectorCount, mbrLBA, mbrPart);

  DBGPrintf("Part:%u vt:%u first:%u, count:%u MBR:%u MBR Part:%u MBR Type: %u\n", part, vt, firstLBA, sectorCount, mbrLBA, mbrPart, mbrType);

  if (vt == 0) return false;    // got an invalid volume

  // yes could have used some of the directly...
  m_sectorCount = sectorCount;
  m_part_relativeSectors = firstLBA;
  m_mbrLBA = mbrLBA;
  m_mbrPart = mbrPart;

  m_capacityMB = (m_sectorCount + SECTORS_PER_MB - 1)/SECTORS_PER_MB;
  writeMsgF("Capacity in MB: %u\n", m_capacityMB);

//  m_capacityMB = (uint32_t) (fs.totalSize()/1000000);
  
  if(m_capacityMB > 32768) {
	  writeMsgF("Volume is greater(%u) than 32MB, Need to format as exFAT!!\n", m_capacityMB);
	  return false;
  }
  
  bool has_volume_label = fs.mscfs.getVolumeLabel(volName, sizeof(volName));

  if (has_volume_label) {
   writeMsgF("Volume name:(%s)\n", volName);
  }
  DBGPrintf("\nPFsFatFormatter::format................");
  DBGPrintf("Sector Count: %d, Sectors/MB: %d\n", m_sectorCount, SECTORS_PER_MB);
  DBGPrintf("Partition Capacity (MB): %d\n", m_capacityMB);
  DBGPrintf("Partition Capacity - from fs (MB): %d\n", (uint32_t) (fs.totalSize()/1000000));
  DBGPrintf("Fat Type: %d\n", fs.mscfs.fatType());
  DBGPrintf("    m_dataStart:%u\n", fs.mscfs.dataStartSector());
  DBGPrintf("    m_sectorsPerCluster:%u\n",fs.mscfs.sectorsPerCluster());
  DBGPrintf("    m_relativeSectors:%u\n", m_part_relativeSectors);
  DBGPrintf("    Fat start sector:%u\n", fs.mscfs.fatStartSector());
  DBGPrintf("    Cluster Count:%u\n", fs.mscfs.clusterCount());
  DBGPrintf("    Bytes per Cluster:%u\n", fs.mscfs.bytesPerCluster());
  DBGPrintf("\n");
  
  if (m_capacityMB <= 6) {
    writeMsg("Card is too small.\r\n");
    return false;
  } else if (m_capacityMB <= 16) {
    m_sectorsPerCluster = 2;
  } else if (m_capacityMB <= 32) {
    m_sectorsPerCluster = 4;
  } else if (m_capacityMB <= 64) {
    m_sectorsPerCluster = 8;
  } else if (m_capacityMB <= 128) {
    m_sectorsPerCluster = 16;
  } else if (m_capacityMB <= 1024) {
    m_sectorsPerCluster = 32;
  } else if (m_capacityMB <= 32768) {
    m_sectorsPerCluster = 64;
  } else {
    // SDXC cards
    m_sectorsPerCluster = 128;
  }
  

  //rtn = m_sectorCount < 0X400000 ? makeFat16() :makeFat32();
  
  if(fat_type == 16 && m_sectorCount < 0X400000 ) {
    writeMsg("format makeFAT16\r\n");  
    rtn = makeFat16(dev);
  } else if(fat_type == 32) {
    writeMsg("format makeFAT32\r\n");  
    rtn = makeFat32(dev);
  } else {
    rtn = false;
  }

  return rtn;
}

//====================================================================================
bool USBFilesystemFormatter::makeFat16(USBDrive &m_dev) {
  
  DBGPrintf(" MAKEFAT16\n");
  uint32_t nc;
  uint32_t r;
  PbsFat_t* pbs = reinterpret_cast<PbsFat_t*>(m_secBuf);
  
  for (m_dataStart = 2*BU16; ; m_dataStart += BU16) {
    nc = (m_sectorCount - m_dataStart)/m_sectorsPerCluster;
    m_fatSize = (nc + 2 + (BYTES_PER_SECTOR/2) - 1)/(BYTES_PER_SECTOR/2);
    r = BU16 + 1 + 2*m_fatSize + FAT16_ROOT_SECTOR_COUNT;
    if (m_dataStart >= r) {
      m_relativeSectors = m_dataStart - r + BU16;
      break;
    }
  }

  //nc = (m_sectorCount - m_dataStart)/m_sectorsPerCluster;
  //m_fatSize = (nc + 2 + (BYTES_PER_SECTOR/2) - 1)/(BYTES_PER_SECTOR/2);
  
  DBGPrintf("m_relativeSectors: %u, m_fatSize: %u, m_dataStart: %u\n",m_relativeSectors, m_fatSize, m_dataStart) ;
  
  // check valid cluster count for FAT16 volume
  if (nc < 4085 || nc >= 65525) {
    writeMsg("Bad cluster count\r\n");
    return false;
  }
  m_reservedSectorCount = 1;
  m_fatStart = m_relativeSectors + m_reservedSectorCount;
  m_totalSectors = nc*m_sectorsPerCluster
                   + 2*m_fatSize + m_reservedSectorCount + 32;
  if (m_totalSectors < 65536) {
    m_partType = 0X04;
  } else {
    m_partType = 0X06;
  }

  //Added to keep relative sectors straight
  m_relativeSectors = m_part_relativeSectors;
  m_fatStart = m_relativeSectors + m_reservedSectorCount;
    m_dataStart= m_fatStart + 2 * m_fatSize + FAT16_ROOT_SECTOR_COUNT;
  m_totalSectors = m_sectorCount;

  DBGPrintf("partType: %d, m_relativeSectors: %u, fatStart: %u, fatDatastart: %u, totalSectors: %u\n", m_partType, m_relativeSectors, m_fatStart, m_dataStart, m_totalSectors);

  // write MBR
  writeMsg("Writing MBR...");
  if (!writeFatMbr(m_dev)) {
    return false;
  }

  initPbs();
  setLe16(pbs->bpb.bpb16.rootDirEntryCount, FAT16_ROOT_ENTRY_COUNT);
  setLe16(pbs->bpb.bpb16.sectorsPerFat16, m_fatSize);
  pbs->bpb.bpb16.physicalDriveNumber = 0X80;
  pbs->bpb.bpb16.extSignature = EXTENDED_BOOT_SIGNATURE;
  setLe32(pbs->bpb.bpb16.volumeSerialNumber, 1234567);
  
  for (size_t i = 0; i < sizeof(pbs->bpb.bpb16.volumeLabel); i++) {
    pbs->bpb.bpb16.volumeLabel[i] = ' ';
  }
  pbs->bpb.bpb16.volumeType[0] = 'F';
  pbs->bpb.bpb16.volumeType[1] = 'A';
  pbs->bpb.bpb16.volumeType[2] = 'T';
  pbs->bpb.bpb16.volumeType[3] = '1';
  pbs->bpb.bpb16.volumeType[4] = '6';
  if (!writeSector(m_dev, m_relativeSectors, m_secBuf)) {
    return false;
  }
  
  return initFatDir(m_dev, 16, m_dataStart - m_fatStart);
  
}

bool USBFilesystemFormatter::makeFat32(USBDrive &m_dev) {
  DBGPrintf(" MAKEFAT32\n");
  uint32_t nc;
  uint32_t r;
  
  PbsFat_t* pbs = reinterpret_cast<PbsFat_t*>(m_secBuf);
  FsInfo_t* fsi = reinterpret_cast<FsInfo_t*>(m_secBuf);
  
  m_relativeSectors = BU32;
  for (m_dataStart = 2*BU32; ; m_dataStart += BU32) {
    nc = (m_sectorCount - m_dataStart)/m_sectorsPerCluster;
    m_fatSize = (nc + 2 + (BYTES_PER_SECTOR/4) - 1)/(BYTES_PER_SECTOR/4);
    r = m_relativeSectors + 9 + 2*m_fatSize;
    DBGPrintf("m_dataStart: %u, m_fatSize: %u, r: %u\n", m_dataStart, m_fatSize, r);
    if (m_dataStart >= r) {
      break;
    }
  }
  
    //nc = (m_sectorCount - m_dataStart)/m_sectorsPerCluster;
    //m_fatSize = (nc + 2 + (BYTES_PER_SECTOR/4) - 1)/(BYTES_PER_SECTOR/4);
    DBGPrintf("    m_part: %d\n", m_part);
    DBGPrintf("    m_sectorCount: %d\n", m_sectorCount);
    DBGPrintf("    m_dataStart: %d\n", m_dataStart);
    DBGPrintf("    m_sectorsPerCluster: %d\n", m_sectorsPerCluster);
    DBGPrintf("    nc: %d\n", nc);
    DBGPrintf("    m_fatSize: %d\n", m_fatSize);

  // error if too few clusters in FAT32 volume
  if (nc < 65525) {
    writeMsg("Bad cluster count\r\n");
    return false;
  }
  m_reservedSectorCount = m_dataStart - m_relativeSectors - 2*m_fatSize;
  m_fatStart = m_relativeSectors + m_reservedSectorCount;
  m_totalSectors = nc*m_sectorsPerCluster + m_dataStart - m_relativeSectors;
  // type depends on address of end sector
  // max CHS has lba = 16450560 = 1024*255*63
  if ((m_relativeSectors + m_totalSectors) <= 16450560) {
    // FAT32 with CHS and LBA
    m_partType = 0X0B;
  } else {
    // FAT32 with only LBA
    m_partType = 0X0C;
  }
  
  //Write MBR
  //Added to keep relative sectors straight
  m_relativeSectors = m_part_relativeSectors;
  m_fatStart = m_relativeSectors + m_reservedSectorCount;
  m_dataStart = m_relativeSectors + m_dataStart;
  m_totalSectors = m_sectorCount;
  
  DBGPrintf("[makeFat32] partType: %d, m_relativeSectors: %u, fatStart: %u, fatDatastart: %u, totalSectors: %u\n", m_partType, m_relativeSectors, m_fatStart, m_dataStart, m_totalSectors);

  if (!writeFatMbr(m_dev)) {
    writeMsg("Failed to write MBR!!");
    return false;
  }
  
  initPbs();  
  setLe32(pbs->bpb.bpb32.sectorsPerFat32, m_fatSize);
  setLe32(pbs->bpb.bpb32.fat32RootCluster, 2);
  setLe16(pbs->bpb.bpb32.fat32FSInfoSector, 1);
  setLe16(pbs->bpb.bpb32.fat32BackBootSector, 6);
  pbs->bpb.bpb32.physicalDriveNumber = 0X80;
  pbs->bpb.bpb32.extSignature = EXTENDED_BOOT_SIGNATURE;
  setLe32(pbs->bpb.bpb32.volumeSerialNumber, 1234567);
  for (size_t i = 0; i < sizeof(pbs->bpb.bpb32.volumeLabel); i++) {
    pbs->bpb.bpb32.volumeLabel[i] = ' ';
  }
  pbs->bpb.bpb32.volumeType[0] = 'F';
  pbs->bpb.bpb32.volumeType[1] = 'A';
  pbs->bpb.bpb32.volumeType[2] = 'T';
  pbs->bpb.bpb32.volumeType[3] = '3';
  pbs->bpb.bpb32.volumeType[4] = '2';

  writeMsg("Writing Partition Boot Sector\n");
  
  if (!writeSector(m_dev, m_relativeSectors, m_secBuf)  ||
      !writeSector(m_dev, m_relativeSectors + 6, m_secBuf)) {
    return false;
  }
  
  // write extra boot area and backup
  memset(m_secBuf, 0 , BYTES_PER_SECTOR);
  setLe32(fsi->trailSignature, FSINFO_TRAIL_SIGNATURE);
  if (!writeSector(m_dev, m_relativeSectors + 2, m_secBuf)  ||
      !writeSector(m_dev, m_relativeSectors + 8, m_secBuf)) {
    return false;
  }
  // write FSINFO sector and backup
  setLe32(fsi->leadSignature, FSINFO_LEAD_SIGNATURE);
  setLe32(fsi->structSignature, FSINFO_STRUCT_SIGNATURE);
  setLe32(fsi->freeCount, 0XFFFFFFFF);
  setLe32(fsi->nextFree, 0XFFFFFFFF);
  writeMsg("Writing FSInfo Sector\n");
  if (!writeSector(m_dev, m_relativeSectors + 1, m_secBuf)  ||
      !writeSector(m_dev, m_relativeSectors + 7, m_secBuf)) {
    return false;
  }
  writeMsg("Writing FAT\n");
  return initFatDir(m_dev, 32, 2*m_fatSize + m_sectorsPerCluster);

}

//------------------------------------------------------------------------------
bool USBFilesystemFormatter::writeFatMbr(USBDrive &m_dev) {
  if (m_mbrLBA == 0xFFFFFFFFUL) {
    DBGPrintf("    writeMBR - GPT entry so dont update\n");
    return true;
  }
  memset(m_secBuf, 0, BYTES_PER_SECTOR);
  
  // The relative sectors stuff is setup based off of the logicalMBR...
  uint32_t relativeSectors = m_relativeSectors - m_mbrLBA;

  MbrSector_t* mbr = reinterpret_cast<MbrSector_t*>(m_secBuf);
  MbrPart_t *pt = &mbr->part[m_mbrPart];
  if (!m_dev.readSector(m_mbrLBA, m_secBuf)) {
    writeMsg("Didn't read MBR Sector !!!\n");
    return false;
  }

  DBGPrintf("(writeFatMbr)[m_capacityMB,m_relativeSectors,relativeSectors,relativeSectors + m_totalSectors -1] %u, %u, %u, %u\n",m_capacityMB,m_relativeSectors,relativeSectors,relativeSectors + m_totalSectors -1);
#if USE_LBA_TO_CHS
  lbaToMbrChs(pt->beginCHS, m_capacityMB, m_relativeSectors);
  lbaToMbrChs(pt->endCHS, m_capacityMB,
              m_relativeSectors + m_totalSectors -1);
#else  // USE_LBA_TO_CHS
  pt->beginCHS[0] = 1;
  pt->beginCHS[1] = 1;
  pt->beginCHS[2] = 0;
  pt->endCHS[0] = 0XFE;
  pt->endCHS[1] = 0XFF;
  pt->endCHS[2] = 0XFF;
#endif  // USE_LBA_TO_CHS

  pt->type = m_partType;
  setLe32(pt->relativeSectors, relativeSectors);
  setLe32(pt->totalSectors, m_totalSectors);
  setLe16(mbr->signature, MBR_SIGNATURE);
  return writeSector(m_dev, m_mbrLBA, m_secBuf);

}

//-----------------------------------------------------------------------------

#define CSECTORS_PER_WRITE 32
bool USBFilesystemFormatter::initFatDir(USBDrive &m_dev, uint8_t fatType, uint32_t sectorCount) {
  DBGPrintf("PFsFatFormatter::initFatDir(%u, %u)\n", fatType, sectorCount);
  size_t n;
  uint32_t fat_sector = 1;
  DBGPrintf("Writing FAT ");
  if (sectorCount >= CSECTORS_PER_WRITE) {
    uint8_t *large_buffer_alloc = (uint8_t *)malloc(BYTES_PER_SECTOR * CSECTORS_PER_WRITE + 32);

    if (large_buffer_alloc) {
      uint8_t *large_buffer = (uint8_t *)(((uintptr_t)large_buffer_alloc + 31) & ~((uintptr_t)(31)));
      DBGPrintf("\tbuffer:%p alligned:%p\n", large_buffer_alloc, large_buffer);
      memset(large_buffer, 0, BYTES_PER_SECTOR * CSECTORS_PER_WRITE);
      uint32_t sectors_remaining = sectorCount;
      uint32_t loops_per_dot = sectorCount/(32*CSECTORS_PER_WRITE);
      uint32_t loop_count = 0;
      while (sectors_remaining >= CSECTORS_PER_WRITE) {
        if (!m_dev.writeSectors(m_fatStart + fat_sector, large_buffer, CSECTORS_PER_WRITE)) {
           return false;
        }
        fat_sector += CSECTORS_PER_WRITE;
        sectors_remaining -= CSECTORS_PER_WRITE;
        if (++loop_count == loops_per_dot) {
          DBGPrintf(".");
          loop_count = 0;
        }
      }
      if (sectors_remaining) {
        if (!m_dev.writeSectors(m_fatStart + fat_sector, large_buffer, sectors_remaining)) {
           return false;
        }
        fat_sector += sectors_remaining;
      }
      free(large_buffer_alloc);
    }
  }
  if (fat_sector < sectorCount) {
    memset(m_secBuf, 0, BYTES_PER_SECTOR);
    for (; fat_sector < sectorCount; fat_sector++) {
      if (!writeSector(m_dev, m_fatStart + fat_sector, m_secBuf)) {
         return false;
      }
      if ((fat_sector%(sectorCount/32)) == 0) {
        DBGPrintf(".");
      }
    }
  }
  DBGPrintf("\r\n");
  // Allocate reserved clusters and root for FAT32.
  m_secBuf[0] = 0XF8;
  n = fatType == 16 ? 4 : 12;
  for (size_t i = 1; i < n; i++) {
    m_secBuf[i] = 0XFF;
  }
  return writeSector(m_dev, m_fatStart, m_secBuf) &&
         writeSector(m_dev, m_fatStart + m_fatSize, m_secBuf);
}

//------------------------------------------------------------------------------
void USBFilesystemFormatter::initPbs() {
  PbsFat_t* pbs = reinterpret_cast<PbsFat_t*>(m_secBuf);
  memset(m_secBuf, 0, BYTES_PER_SECTOR);
  
  pbs->jmpInstruction[0] = 0XEB;
  pbs->jmpInstruction[1] = 0X76;
  pbs->jmpInstruction[2] = 0X90;
  for (uint8_t i = 0; i < sizeof(pbs->oemName); i++) {
    pbs->oemName[i] = ' ';
  }
  setLe16(pbs->bpb.bpb16.bytesPerSector, BYTES_PER_SECTOR);
  pbs->bpb.bpb16.sectorsPerCluster = m_sectorsPerCluster;
  setLe16(pbs->bpb.bpb16.reservedSectorCount, m_reservedSectorCount);
  pbs->bpb.bpb16.fatCount = 2;
  // skip rootDirEntryCount
  // skip totalSectors16
  pbs->bpb.bpb16.mediaType = 0XF8;
  // skip sectorsPerFat16
  // skip sectorsPerTrack
  // skip headCount
  setLe32(pbs->bpb.bpb16.hidddenSectors, m_relativeSectors);
  setLe32(pbs->bpb.bpb16.totalSectors32, m_totalSectors);
  // skip rest of bpb
  setLe16(pbs->signature, PBR_SIGNATURE);
}
//------------------------------------------------------------------------------

bool USBFilesystemFormatter::writeSector(USBDrive &m_dev, uint32_t sector, const uint8_t* src) {
  // sandbox support
  if ((sector < m_minSector) || (sector > m_maxSector)) {
    DBGPrintf("!!! Sandbox Error: %u <= %u <= %u - Press any key to continue\n", 
      m_minSector, sector, m_maxSector);
    while (Serial.read() == -1);
    while (Serial.read() != -1) ;
  }

  return m_dev.writeSector(sector, src);
}
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
