SensoriumEmbedded/TeensyROM/(commit log)

2023-01-13 Full address bus, data fix
    [TeensyROM.h, TeensyROM.ino]
2023-01-19 Reorganized Directories
    [TeensyROM pin-reg map.xlsx]
2023-01-19 More dir changes, PRG xfer
    [TeensyROM.brd, TeensyROM.sch, Xpander3.brd, Xpander3.sch]
2023-01-20 alpha input, copy code to vanish TR
    [TeensyROM pin-reg map.xlsx]
2023-01-22 DMA/NMI pins
    [TeensyROM pin-reg map.xlsx, TeensyROM.brd, TeensyROM.sch]
2023-01-23 Reset in changed to Reset button only
    [TeensyROM pin-reg map.xlsx]
2023-01-24 Menu Paging, Exit to basic/reset
    [TeensyROM pin-reg map.xlsx]
2023-01-25 schem updates
    [TeensyROM.brd, TeensyROM.sch]
2023-01-30 Win app, Serial comm, file transfer via USB host, IRQ now output, cycle count global
    [BOM.xlsx, TeensyROM pin-reg map.xlsx, TeensyROM.brd, TeensyROM.sch, Xpander3.brd, Xpander3.sch]
2023-02-01 Full file transfer via usb for .prg and .crt files (incl parsing/executing)
    [TeensyROM pin-reg map.xlsx]
2023-02-09 v0.1 PCB HW work-around
    [BOM.xlsx]
2023-02-11 PCB file org
    [BOM.xlsx, TeensyROM pin-reg map.xlsx, TeensyROM v0.1 BOM.xlsx, TeensyROM v0.1 pin-reg map.xlsx, TeensyROM.brd, TeensyROM.sch]
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2023-02-11 v0.2 PCB design started
    [TeensyROM 0.2 pin-reg map.xlsx, TeensyROM v0.2 BOM.xlsx, TeensyROM.brd, TeensyROM.sch]
2023-02-16 Correctly loading/running BASIC prgs
    [DriveDirLoad.ino, ISRs.ino, MainMenu_C000.asm, Menu_Regs.h, ROM_Images.h, SerUSBIO.ino]
2023-02-22 PCB 0.2 progress (not yet complete)
    [TeensyROM.brd, TeensyROM.sch]
2023-02-23 v0.2 in progress removed
    [TeensyROM 0.2 pin-reg map.xlsx, TeensyROM v0.2 BOM.xlsx, TeensyROM.brd, TeensyROM.sch]
2023-02-23 v0.2 tape-out archive
    [TeensyROM 0.2 pin-reg map.xlsx, TeensyROM v0.2 BOM.xlsx, TeensyROM.brd, TeensyROM.sch]
2023-02-23 ROMH+VIC timing/scope shots
    [TeensyROM v0.2 BOM.xlsx]
2023-03-07 message in cart code while trasfering
    [TeensyROM v0.2 BOM.xlsx]
2023-03-16 Directory structure re-organization
    [TeensyROM v0.2 BOM.xlsx]
2023-03-19 Teensy pin pics, BOM pin config options
    [TeensyROM v0.2 BOM.xlsx]
2023-03-19 PCB assy instructions, BOM line item #s
    [TeensyROM v0.2 BOM.xlsx]
2023-03-31 Broke out main menu into multiple files improved music playing tracking (in progress) Setting menu started (in progress) 8k cart is full!
    [MainMenu_C000.asm]
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2023-04-02 Settings/info page completion, EEPROM storage 16k cart now instead of 8k removed a couple internal ROMs Print routines to StringsMsgs Print Waiting over time when waiting
2023-04-16 Serial.flush() at startup and reset to prevent ISR interference
    [TeensyROM.ino]
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2023-05-01 Datel MIDI emulation Settings menu in sep file includes "Special IO" (IO1 hndlr) select Cynthcart added to on-board prgs 2nd usb hub added (2 deep, validated) Added debug IO handler & MIDI handlers t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
2023-05-08 IO1 debug transaction buffer capability MIDI debug print build option Improved MIDI status reg emulation incl Tx buffer ready flag
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2023-05-14 EEPROM writes outside ISR Swiftlink IO Framework Non-ready Status routines in function array IOHandler Header stuff in .h file
2023-05-17 Timing adjustment in ISR if delay from last cycle was too long Self test in Settings menu Ability to log/view timing adjustments Centralized Cycle/nS conversions Showing acquired IP address
    [IOHandlers.ino, ISRs.ino, SerUSBIO.ino, SettingsMenu.asm, TeensyROM.h, TeensyROM.ino]
2023-05-28 Further Swiftlink implementation temp serial control handler specific polling items DataPortWriteWaitLog to include tracelog data
2023-06-01 Reset queue and IRQ on overflow smaller buffer and Rx delay
    [IOH_Swiftlink.c, SerUSBIO.ino]
2023-06-04 Swift emulation updates: min between RX using C64 cycles instead of uS NMITimeoutnS implemented, needed? Larger queueu size (8k) though 4 is prob fine Teensy Core temp read capability C64 Printing ha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
2023-06-06 Renamed ROM_Images.h to MainMenuItems.h Print crash report, if available atoi in SwiftLink Main menu From->Source
    [IOH_Swiftlink.c, IOHandlers.h, MainMenuItems.h, TeensyROM.ino]
2023-06-08 C64 Menu updates: grey out Up/Dn as needed Made rRegItemNameStart -> rwRegItemName: single self inc reg added TblMsgMenuName to simplify menu source print
2023-06-21 Bug fix: StreamOffsetAddr & StringOffset separation
    [IOH_TeensyROM.c]
2023-06-22 FlushRxQueue to print before long waits in AT cmds mark SwiftStatusTxEmpty before calling Process AT \r\n for all forced outputs for ascii compat AT commands broken out into struct name/function BugF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
    [IOH_EpyxFastLoad.c, IOH_Swiftlink.c, SerUSBIO.ino, TeensyROM.ino]
2023-06-24 Heatsink on BOM and PCB readme
    [TeensyROM v0.2 BOM.xlsx]
2023-06-30 BOM cost info added
    [TeensyROM v0.2 BOM.xlsx]
2023-07-01 R3 added to BOM
    [TeensyROM v0.2 BOM.xlsx]
2023-07-01 Minor rev to PCB 0.2 (now 0.2b) to include pull-up on Data_CE
    [TeensyROM.brd, TeensyROM.sch]
2023-07-09 Documentation and pic updates
    [TeensyROM v0.2 BOM.xlsx, TeensyROM v0.2b BOM.xlsx]
2023-07-09 R1 val change, PDF update
    [TeensyROM.brd, TeensyROM.sch]
2023-07-09 Swiftlink .CRT file support
    [TeensyROM 0.2 pin-reg map.xlsx]
2023-07-16 Ethernet IRQ disabled while Emulating VIC cycles Print local IP to serial on connected Timing control via serial (Dbg_SerTimChg) nS_MaxAdj now uint32, increased to 1030 for PAL (worse case, still wor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
2023-07-16 Heatsink updated to 12x12x12mm w/ tape
    [TeensyROM v0.2b BOM.xlsx]
2023-07-25 MIDI USB Device capability SysEx messages enabled for MIDI in to C64 MIDI Device name .c file added
2023-07-26 USB MIDI Device completion MIDI2SID capable Set to NULL by def missing #define usbDevMIDI usbMIDI broke last check-in
    [IOH_TeensyROM.c, IOHandlers.h, IOHandlers.ino]
2023-07-30 Directory/doc major restructure
    [TeensyROM 0.2 pin-reg map.xlsx]
2023-07-31 BOM link fixes
2023-08-03 Associate special IO HW with Teensy mem menu items Only applied if *not* IOH_None in ROMMenu
2023-08-05 Associate special IO HW with Teensy mem menu items via MainMenuItems.h Indicated by '+' next to type on TR Mem Menu If IOH_None, defaults to .crt or default Special IO setting
2023-08-05 .P00 file support improved prg launch, removed error code/msgs
    [DriveDirLoad.ino, Menu_Regs.h]
2023-08-06 Accommodate directory sizes up to 4080 items Associates file type even if name is too long for display Display page number and num pages Paged menu structure, TR controls pages now
    [DriveDirLoad.ino, IOH_TeensyROM.c, IOHandlers.ino, MainMenuItems.h, Menu_Regs.h, Teensy.ino, TeensyROM.h]
2023-08-10 v0.4.2 tag, hex file Fix: minimum 1 menu page
    [Teensy.ino, TeensyROM.h]
2023-08-10 Moved SD begin to SD menu select avoids 3 sec pause on boot when not loaded allows for refresh/hot swap of SD (thought not recommended)
    [DriveDirLoad.ino, Teensy.ino, TeensyROM.h]
2023-08-12 CRT Messaging Message tweaking size of CRTs needed in teensy mem menu
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2023-08-19 Max Filename Len 60->76, Max Files 3000->2400 Print mem available each load
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2023-08-30 Chip parse debug print option Dbg_SerLogMem for Display main mem utilizers in f/i command
2023-09-03 Ocean Handler: fixed prob with Type B crts
    [IOH_Ocean1.c, MainMenuItems.h]
2023-09-05 Home key for top of current directory Width increased by 3 chars (32 to 35) Type indicators/'+' color upd
2023-09-07 Fixed rwRegNextIOHndlr recovery from crt fail
    [DriveDirLoad.h, DriveDirLoad.ino]
2023-09-07 Settings menu re-do Joystick speed in Settings/EEPROM no padding for PrintIntByte rwRegTimezone reg number bug fix
    [IOH_TeensyROM.c, Menu_Regs.h, SettingsMenu.asm, Teensy.ino, TeensyROM.h]
2023-09-08 Fx options live in Help Menu Time in help menu Menu formatting changes help menu option from Settings menu Fixed PrintString>255 char issue
    [SettingsMenu.asm]
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2023-09-16 Mem calc fixes for TROM dirs
    [SerUSBIO.ino]
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2023-09-25 BOM clean-up (minor)
    [TeensyROM v0.2b BOM.xlsx]
2023-09-25 * Revamped Transfer app: Transfer to USB/SD media (only) Select USB/SD destination and path Drag/drop or select file to send Large file sizes OK Tokens to synch: SendFileToken, AckToken, FailToken
    [DriveDirLoad.ino, Menu_Regs.h, SerUSBIO.ino, TeensyROM.h]
2023-10-02 Replaced PtrAddrLo/Hi with Self Mod Code in mult places where SID is playing (they use zero page too) check for SID/TR mem conflict Removed MusicInterrupted, just use MusicPlaying Removed visible cou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
    [DriveDirLoad.ino, SettingsMenu.asm]
2023-10-03 Banking out BASIC and Kernal during SID play and init SID init and play addr Printf_dbg lengthened space between IRQs to accomodate long plays
2023-10-04 3D printed case Case and FW/SW history files
    [TeensyRom-Cart-top-Vented.stl, TeensyRom-Cart-top.stl]
2023-10-04 Release notes and main readme updates, Discord link
    [TeensyRom-Cart-top-Vented.stl, TeensyRom-Cart-top.stl]
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2023-10-06 Determining Vid standard (NTSC/PAL) and mains freq (50/60Hz) on start Changed SID play interrupt from raster to timer based '+' and '-' to change SID speed from main Menu 3 new IO1 regs for SID speed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
2023-10-09 Correct case stl bottom file
    [TeensyRom-Cart-bottom.stl, TeensyRom-Cart-top.stl]
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2023-10-13 Swift: SendRxImmediate to send ahead of queue Broke up CheckSendRxQueue for re-use PagePaused to latch pause point
    [IOH_Swiftlink.c]
2023-10-14 ToPETSCII now table based, customized Hyperlink tags <A > caught PrintingHyperlink indicates currently printing one, don't pause EOFTAG inserted at end of connection to trigger menu when sent to C64 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
2023-10-17 Assy: SidDisp build option to tweak border during in and print timer value when changed
2023-10-18 Minimalist 3D printed top added
    [TeensyRom-Cart-top-minimal.stl]
2023-10-18 PCB v0.1 deprecated, files removed code support removed
    [TeensyROM v0.1 BOM.xlsx, TeensyROM v0.1 pin-reg map.xlsx, TeensyROM.brd, TeensyROM.sch]
2023-10-26 URL queue now stcURLParse of host, port, path <html> clearing screen/header instead of /form DoSearch() separated to encode search params u command now raw/not filtered
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2023-10-31 ValidModifier added, checked early isURLFiltered added to centralize ModWebConnect refactor, Modifier now single char arg Still connect if can't un-filter
2023-11-01 v0.2c PCB released v0.2b archived PCB_History updated
    [TeensyROM 0.2 pin-reg map.xlsx, TeensyROM v0.2b BOM.xlsx, TeensyROM v0.2c BOM.xlsx, TeensyROM.brd, TeensyROM.sch]
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2023-11-01 New case design added Main Readme, case readme, pcb assy, and pcb history doc/pic updates Prev case to archive dir Picture updates: v0.2cPCB and case
    [TeensyRom-Cart-bottom.stl, TeensyRom-Cart-top-Vented.stl, TeensyRom-Cart-top-minimal.stl]
2023-11-02 <title> tag/name captured SendCommandSummaryImmediate for short command prompt eoftag simplified allow spaces in petscii tag
    [IOH_Swiftlink.c]
2023-11-03 PrevURLQueueNum -> CurrURLQueueNum, indicates current instead of +1 AddToHist option in WebConnect to skip adding to history queue Reload, Prev, and download don't add to queue
    [IOH_Swiftlink.c]
2023-11-04 USB Serial com: Reset C64 is only command available when busy
    [SerUSBIO.ino]
2023-11-05 Corrected PCB rev callout (0.2c)
    [TeensyROM v0.2c BOM.xlsx]
2023-11-06 commented out server port refs throughout, removed from stcURLParse port 80 hard coded (all html msgs use it) Reduced MaxTagSize to fit in path size Filled default bookmarks with news & info HTML tag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
    [IOH_Swiftlink.c]
2023-11-06 DownloadFile now does WebConnect, after checking file already exists. Auto-download extension check case tolerant
2023-11-06 Preserve case in TxQueue when in browser mode ASCII conversion only ProcessBrowserCommand sets beginning tolower until space or term
2023-11-07 Corrected schematic value of 74LVC245, was listed as 74LCV245
    [TeensyROM v0.2c BOM.xlsx, TeensyROM.brd, TeensyROM.sch]
2023-11-07 Separated FreeDriveDirMenu(), cleared when CRT space needed or Swiftlink handler load Broke down RxQueueSize into blocks for better dynamic allocation checks/prints during Swiftlink Malloc in case ou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
    [DriveDirLoad.ino, IOH_Swiftlink.c, Teensy.ino]
2023-11-08 IPaddress for URL check/support inet_aton added to conv str to ip in at command and url Check DownloadFile out of FLASHMEM (run faster?) Read/write chunks instead of individual bytes Print dot every 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
2023-11-12 port control available for host or ip address PageCharsReceived improvements: inc only on printable chars zero is clear screen return char adds number of chars to next line centralized chaecks and re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
2023-11-16 RemoteLaunch(bool SD_nUSB, const char *FileNamePath) to DriveDirLoad, working SetDriveDirMenuNameType & InitDriveDirMenu separated out from LoadDirectory Return to main TR Mem menu after remote launc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
2023-11-19 Swiftl: Bug fix: wasn't sending 0s in normal mode (caused corrupted downloads) don't send 0s moved to CheckSendRxQueue, qualified by BrowserMode ignore new line (10) as well as return (13) in browser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
    [TeensyROM.h]
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2023-11-27 Launch on reset added (separate from IRQ) After reset/launch, menu button causes issues....
    [RemoteControl.ino, SerUSBIO.ino, Teensy.ino]
2023-11-27 Made rRegIRQ_CMD read/write (rwRegIRQ_CMD) to allow reset from C64 side
    [IOH_TeensyROM.c, Menu_Regs.h, RemoteControl.ino, Teensy.ino]
2023-11-27 FreeSwiftlinkBuffs() to do just that RemoteLaunch clears CrtChips and SwiftlinkBuffs before creating DriveDirMenu fix for launch from large CRTs or Swiftlink handlers
    [IOH_Swiftlink.c, RemoteControl.ino, Teensy.ino]
2023-11-27 Replaced back slashes with forward slashes in #includes (platform agnostic)
    [IOHandlers.h, MainMenuItems.h, TeensyROM.h]
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2023-11-30 Browser updates: 'dl' to list download directory files as web page for launching Link starting with "lcl:" to remote launch 'd' changed to 'ds' for dl path update to FLASHMEM: HexCharToInt, CheckAndD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
    [IOH_Swiftlink.c]
2023-12-12 ToLcaseASSCII -> SwiftTxBufToLcaseASSCII to fix type warning
    [IOH_Swiftlink.c]
2023-12-13 ShowSIDInfoPage on SID load Page framework, MsgSIDInfo in place key loop: Space, F1, F4 options
2023-12-14 StrSIDInfo and StrMachineInfo globals updated w/ SID load SID Name, Author, Released, Vid Clk; Machine Vid/TOD clks rsstSIDInfo and rsstMachineInfo to serial print them ParseSIDHeader() to FLASHMEM, 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
2023-12-15 Sid info: showing timer reg F/S to make faster/slower (big steps) +/- removed from main menu
2023-12-24 SID IRQ timing tweaked based on o-scope measurements MainsFreq warning fix
    [DriveDirLoad.ino]
2023-12-27 SID load updates: Inverted pause bit logic; rpudMusicMask -> rpudSIDPauseMask skip summary page on load error Disable playback on load error updated EEPRO magic num to reset defaults
    [Menu_Regs.h, SettingsMenu.asm, Teensy.ino, TeensyROM.h]
2023-12-27 SIDLoadError() to copy error message to StrSIDInfo SID info page label formatting Moved StrSIDInfo to RAM2 LoadMainSIDforXfer to FLASHMEM
    [DriveDirLoad.h, DriveDirLoad.ino, IOH_TeensyROM.c, Teensy.ino]
2024-01-12 New IO1 regs: rwRegCodeStartPage, rwRegCodeLastPage set on TR app start SID conflict check range reduced to reality Currently $6000-70ff 1049 additional SIDs enabled from 6000-8000, incl YYZ
2024-01-13 RSID and Play address 0 accepted in parser Assy SIDLoadInit doesn't restart IRQ if Play address == 0 Init sets up it's own
    [DriveDirLoad.ino]
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2024-01-14 SID: check for conflict with IO1 space Show play address on load screen (in case of hang there) SID info: clk -> tech w/ addr range, init addr, play addr, and clock PAL+NTSC -> Either to fit on screen
2024-01-26 Fail Token sent on SIDLoadError Serial compare using tokens instead of raw numbers Token defs moved to TeensyROM.h
    [DriveDirLoad.ino, FileTransfer.ino, SerUSBIO.ino, TeensyROM.h]
2024-01-30 Updated SID remote launch flow: Send pass/fail token at end
    [DriveDirLoad.ino, SerUSBIO.ino, TeensyROM.h]
2024-01-31 ParseSIDHeader now void Sends BadSIDToken before SID error strings
    [DriveDirLoad.ino, IOH_TeensyROM.c, SerUSBIO.ino, TeensyROM.h]
2024-01-31 IRQ in KLA viewer key wait loop change vid regs back instead of full init to exit graphic mode IRQ sets vid back to text when triggered Kla load fail message cleanup
    [DriveDirLoad.ino]
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2024-02-01 Timing control via serial improvement (Dbg_SerTimChg) Defaults stored in #defines to allow revering via 'td' command List only via 't' command Printed table improvement
2024-02-02 Updated nS_DataHold time from 350 to 365 to accommodate Reloaded MKII board
2024-02-05 Picture viewer updates: '+' & '-' for next/prev pic No longer text in between transition unless error Now commands instead of kbd buffer method
    [IOH_TeensyROM.c, Menu_Regs.h]
2024-02-07 Bookmark URL correction Apostrophe name change to remove special char
    [IOH_Swiftlink.c, MainMenuItems.h]
2024-02-09 Disp # CRT chips loaded BigBufSize 500 -> 5 Dbg_SerLogMem -> Dbg_SerLog, Dbg_SerMem Modified 'x' command to display max crt file size accurately RAM2blocks() routing broken out
    [DriveDirLoad.ino, SerUSBIO.ino, TeensyROM.h]
2024-02-10 Calc/Show Free RAM (for CRTs) in settings menu Forces menu back to Teensy local on exit Refresh settings screen after time synch
2024-02-16 nfcScanner build option updates: Wait for unique 7 digit UID Read/parse payload and launch program/cart SD:path/filename or USB:path/filename syntax Time a read at init to detect bad state seen on Al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
2024-02-20 nfc: Serial.print to Printf_dbg except some init # init retries needed shown
2024-02-21 nfcEnabled implementation, only enabled if set for power-up and passes init. rpudRWReadyDly implementation, set on power-up if enabled nfcScanner code enabled by default
2024-02-21 "Reboot TeensyROM" settings menu item/ctl command
    [IOH_TeensyROM.c, Menu_Regs.h, SettingsMenu.asm, TeensyROM.h]
2024-02-21 Menu button long press action Hold for >10 seconds, begins flashing. Upon release, EEPROM setting all set to default and TeensyROM is rebooted
    [Teensy.ino]
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2024-03-02 Prompt to remove nfc tag after writing to prevent auto-execute Write messaging clarification Retries on tag verification read before write (doesn't help if out of range or too close) Prints note to s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
    [IOH_TeensyROM.c, Menu_Regs.h]
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2024-03-02 "Reset cmd received" reminder note
    [SerUSBIO.ino]
2024-03-05 Heatsink info updated in BOM
    [TeensyROM v0.2c BOM.xlsx]
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2024-03-22 Load SID path from EEPROM on startup, EEP location defined EEPROM magic num updates, EEPROM will reset to defaults. Sleepdirt is EEPROM default LatestSIDLoaded stored in RAM2 for recall later
    [DriveDirLoad.ino, IOH_Swiftlink.c, IOH_TeensyROM.c, Teensy.ino, TeensyROM.h]
2024-03-23 's' from SID Info screen (F6) to set currently loaded SID for default background SID Note: EEPROM settings will be reset with this update
    [DriveDirLoad.h, IOH_TeensyROM.c, Menu_Regs.h]
2024-03-25 Added ability create/read NFC tags for built-in TeensyROM files in addition to SD/USB Uses TR: prefix to designate RemoteLaunch now takes RegMenuTypes and FileNamePath args
2024-04-23 FIX: Some file types weren't being allowed for Teensy NFC tags Warning fix: unused variable in PN532_UHSU.cpp
    [Menu_Regs.h, PN532_UHSU.cpp, PN532_UHSU.h]
2024-04-25 Bug fix: If loading/playing default SID from SD/USB, current file path was lost on menu restart/def SID play
    [DriveDirLoad.ino, IOH_TeensyROM.c]
2024-04-26 D64 file size checks Convert D64 dir to ascii LoadFile fix to not assume DriveDirPath/PathIsRoot
    [D64.ino, DriveDirLoad.ino, IOH_TeensyROM.c]
2024-05-14 ASID Control register added IO1 write support IRQ enabled after IRQ hook in place 'x' disables IRQ sends button press (main menu) Centralized SetASIDIRQ() to check enable
2024-05-16 ASID Printf_dbg_SysExInfo to show SysEx packets on error
    [IOH_ASID.c]
2024-05-16 ASID screen/help text control improvements Reg Indicators and keyboard command lists reg addr changed to avoid alt SID conflict
    [ASIDPlayer.asm, ASIDsupport.asm, IOH_ASID.c]
2024-05-17 ASID: 2 & 3 SIDs play support Packet error detection/message type: ASIDAddrType_Error
    [ASIDPlayer.asm, ASIDsupport.asm, IOH_ASID.c, TeensyROM.h]
2024-05-17 ASID: SID 2&3 address selection/display address table and adress number storage help/reg screen edits for clarification Interrupt page aligned to reduce branch times garbage zone at end of code to al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
2024-05-17 ASID 0.5 SID1 address selectable PrintSIDaddress breakout "Other information" on help screen
2024-05-18 ASID Mute toggle command added ('m') & displayed SIDinit inits all 3 SIDs and kills voices, SIDVoicesOff commented out ASIDContIRQOff command to handler to disable interrupt
2024-05-22 nS to uS var name correction
    [IOH_Swiftlink.c]
2024-05-23 ASID text handling improvements 256 byte Circular queue to pass text from IRQ to Main loop Main loop prints chars from queue Tokens for stop/startmessages Clear full screen, restore "Mute"
2024-05-24 D64: Dir end when filename = "" instead of track pointer = 0
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2024-07-02 Hosted MIDI Device changed to MIDIDevice_BigBuffer Resolves hosting Teensy based MIDI devices such as the DirtyWave m8 2624 more RAM1 bytes used
    [IOHandlers.h]
2024-07-07 Common EEPROM Defs Added eepAdMinBootInd flag for boot destination runApp fail loops forever
    [EEPROM_Defs.h, MinimalBoot.ino, RunTeensyApp.ino, SerUSBIO.ino, Teensy.ino, TeensyROM.h]
2024-08-03 "TeensyROM Menu Cart+TeensyROM IOH" added to Test+Diags dir of main menu Warning fix: sprintf signed to unsigned int Ignore Source/Teensy/tools/build .gitignore
    [IOH_TeensyROM.c, MainMenuItems.h, TeensyROM.h]
2024-08-23 ASID Frame buff initial implementation 'q' serial command to see queue status (Dbg_SerASID) MIDIRxBufSize increased to 8192 Debug signal toggle on ASID IRQ assert Interval timer for timed ASID mode A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
2024-08-23 Timer enable/disable from C64 ASID menu Control reg command for timer on/off
2024-08-27 MIDIRxBuf type warning fix
    [Teensy.ino]
2024-08-30 Selectable timer states: Off, On-Auto, and On-50Hz ForceIntervalUs to force seed timer, 0 for auto/measured BigBuf option to store measured values
2024-09-01 Bar graph display showing ASID buffer used custom chars f0-f8 2uS timer tweak on buff detect New reg: ASIDQueueUsed
2024-09-07 ASID timer rewrite based on frame synch delta Hyst count to skip (12) frames between check/adjust Debug capture of min/max buff size and timer settings
    [IOH_ASID.c, SerUSBIO.ino]
2024-09-08 ASID Timer updates: 'q' command output: more detail added, reformatted DeltaFrames++ at start of packet C64 send instead of end of send DeltaFrames-- after init to start at -1 instead of 0 uint16_t A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
2024-09-12 Up/down Buffer size with B/b Added Tiny buffer size (256 B) Reduce queue init to 1/3 of size or 2 sec max 50Hz from 19950 (50.13Hz, SFII, Real HW) to 19975 Splitting the diff w/ 20000 (50.0Hz, DeepSI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
2024-09-16 MIDI2SID Freq calc corrected for NTSC/PAL
    [IOH_TeensyROM.c]
2024-09-20 TR BASIC: Print startup info on init, default colors "BASIC w/ TR Custom Commands" moved to main TR menu page
2024-09-23 Bug Fix: Doing full BASIC init before PRG launch No longer printing all screen messages to serial (unless DbgMsgs_IO) CustBasCmnds: Removed BASIC startup text (now printed before all PRG launches) TP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
    [FileParsers.ino, main.asm]
2024-09-23 TGET Teensy side support Ignores other serial input in this mode TgetQueue ring buffer for serial in TPRINT->TPUT since it takes string argument (not print-like)
2024-09-26 TPUT type and mult arg checks/errors, cleanup
    [main.asm]
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2024-09-28 TLOAD command implementation File name transfer, wait for TR routines Broke out TR defines/cmds/functions to teensyrom.asm
    [IOH_TR_BASIC.c, main.asm, teensyrom.asm]
2024-09-28 Status reg can return BAS error codes, load errors updated
    [IOH_TR_BASIC.c, teensyrom.asm]
2024-09-30 TSAVE command implementation error check in WaitForTR Tget Queue size 256->4096 bytes while loop for ser data in instead of if (faster read-in) Broke out FSfromFileName
    [IOH_TR_BASIC.c, teensyrom.asm]
2024-10-02 Fix row number to print "Done" for Set main background SID
2024-10-02 Wait up to 1.5 seconds on first power-up for USB Drive init, in case used by startup sid or autolaunch
2024-10-03 Autolaunch on startup feature shift-return to select auto-launch file from any source (SD/USB/TR) after auto-launch, button to go to main menu hold reset on power-up to skip (until LED on) LED on at 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
    [Common_Defs.h, IOH_TeensyROM.c, Menu_Regs.h, Teensy.ino]
2024-10-03 Disable auto-launch from settings menu Ctl Reg Command to clear auto launch Fix: Start TOD clock earlier in startup seq in case of remote/auto launch
    [IOH_TeensyROM.c, Menu_Regs.h, SettingsMenu.asm, Teensy.ino]
2024-10-04 MinBootIndFlags for skip auto option from minimal
    [Common_Defs.h, FileParsers.ino, MinimalBoot.ino, Teensy.ino]
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2024-10-04 USBFileSystemWait for RemoteLaunch and LoadMainSIDforXfer wait up to 1.5 sec in case USB drive just changed or powered up
2024-10-05 ASID Player individual voice muting Bit bucket reg to send Ctl Reg of muted voices Showing bit bucket writes plus next ($19, $1A POTX/Y) moved SID address selection to F1, F2, F3 1,2,3 toggles voice 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
2024-11-14 Support for fab 0.3 PCB: Data buffer dir control via pin28 (debug sig on fab 0.2x) Moved ISRs.c to Common, used for min and normal boot Moved common defs from Min_TeensyROM.h and TeensyROM.h to Commo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
2024-11-18 Bug Fix: C64 Clock was running slow in 50Hz regions
2024-11-20 Framework for new ASID packets: Reg Write Order/timing, Control/Framerate, and SID Types Parsing/display Reg Write Order/timing Centralized ASID protocol packet types
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2024-12-02 Added SID-Wizard V1.92+Sequential MIDI and Jupiter Lander (Cracked) to menu
    [MainMenuItems.h]
2024-12-15 DoCartDirect option in RemoteLaunch to launch crt without resetting to menu first, only enabled for startup auto-launch Ability to suppress C64 messages (done during crt direct load)
    [FileParsers.ino, ISRs.c, RemoteControl.ino, SerUSBIO.ino, Teensy.ino]
2024-12-22 NFC Random selection from directory: * Random Launch lookup, dir load, and random selection * "?" to write tag for random via current directory * rw scratch reg for data passing to subroutines Teensy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
2024-12-22 Bus Snoop Warning & unused MinBoot variable fixes
    [BusSnoop.ino, MinimalBoot.ino]
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2024-12-24 Fix for MIDI *out* messages: don't set StatusIRQReq bit This broke "Jam Mode" (tracker playback with MIDI enabled) in SIDWizzard
    [IOH_MIDI.c]
2024-12-29 Disallow FW downgrade below this version for Fab 0.3 PCBs Determine Fab based on Dot-Clk read routine
2024-12-30 RW Ready Delay on by default in EEPROM This FW resets EEPROM to defaults (incl RW delay)
    [Common_Defs.h, Teensy.ino]
2025-01-02 Bottom of settings menu changed to git URL from Travis/Sensorium C64 Splash screen updated to 2025
2025-01-03 Phi2 state check during DataPortWriteWait (C64 Read) to prevent overshoot
    [Common_Defs.h]
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2025-01-10 Removed v0.2c PCB design files
    [TeensyROM v0.2c BOM.xlsx, TeensyROM.brd, TeensyROM.sch]
2025-01-10 Add v0.3 PCB design files
    [TeensyROM v0.3 BOM.xlsx, TeensyROM.brd, TeensyROM.sch]
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2025-01-17 NFC: Reset tag re-use timer *after* launch in case random dir takes a long time
2025-01-18 Utils menu re-arange: BASIC Exit and TeensyROM menu tagable options Added empty.prg.h to be taggable exit to BASIC
2025-01-20 PRGLoadStartReloc.s updates: Set Current Device Number to 8 so that file browsers will point at IEC for dir read added *commented out* code to erase tracks of PRG loader code in case needed later rel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
2025-01-20 Added "BASIC with JiffyDOS Fn keys setup" PRG to set them up after replacement by PRG loader
    [MainMenuItems.h]
2025-01-20 "TeensyROM v0.2x C128 UltiMax fix.pdf" rework instructions added
2025-01-21 Removed JiffyFunctionKeys.prg from menu, no longer needed
    [MainMenuItems.h]
2025-01-23 Moved current SID playback timer speed from local to new IO1 regs: rwRegSIDCurSpeedHi/Lo
2025-01-24 Menu code update to update SID play speed on interrupt Update speed indicator if on SID page
2025-02-02 SEQ/PETSCII file type support (rtFilePETSCII) Differentiate PETSCII vs ASCII and convert if needed TXT Converts from ASCII Check for errors on load (file size, etc) initialize rRegStrAvailable to 0 a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
    [DriveDirLoad.h, DriveDirLoad.ino, Menu_Regs.h]
2025-02-04 Text Viewer: pause on file load to display filename 'r' to reload current text file space to load next page or next file
2025-02-08 15 sample text/PETSCII files added to new main menu sub-dir including viewer Usage/instructions doc
2025-02-08 Text Viewer updates: print on 25th row until 40th char or return char before pausing commented out filename display pause Return for next page, then exit
2025-02-13 24 hour clock option hours disp forked in DisplayTime of StringFunctions.s '1' on setting menu to toggle saved in smc (currently)
2025-02-13 12/24 hour clock mode saved to EEPROM New menu reg: rwRegPwrUpDefaults2 New EEPROM entry: eepAdPwrUpDefaults2 This FW will reset EEPROM to defaults (new magic num) bug fix: eepAddrToWrite to 16 bit 2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
    [Common_Defs.h, IOH_TeensyROM.c, Menu_Regs.h, SettingsMenu.asm, Teensy.ino]
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2025-02-22 Bug fix: correctly initialize multi-speed (2x/4x/6x/8x) SIDs for local playback Moved SID init after IRQ Enable in case it modifies CIA timer regs (2x/4x/6x/8x) Thank you DivertigO for the find and t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
2025-05-02 fix: Remote CopyFile routine was appending to the destination file instead of overwriting it when the file already exists.
    [FileTransfer.ino]
2025-05-09 ASID updated packet protocol extension decoding: * Write Order (No Change) reg write order * Framerate: (Updated) Expected Vid, Speed Mult, Buffering requested, Frame Delta uS * SID types: (No Change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
2025-05-10 ASID updates: Higher level string/printf functions for send to player/c64 screen Printing framerate info to screen Force frame timer mode on when APT_ContFramerate received from host
2025-05-10 ASID Player rev to 1.3 bug fix: Start/StopMsgToken used incorrect addressing
    [ASIDPlayer.asm, ASIDsupport.asm]
2025-05-10 ASID: Print all special packet info to C64 screen pause timer and FlushASIDRxQueue each ASID print
2025-05-11 DMA control via state check in main ISR, asserts with BA Remote tokens C64PauseOn/OffToken to control pause via Serial
2025-05-13 ASID Write order debug prints and int16_t RegisterValToWrite for 0-255 & -1
2025-05-17 GetFileCommand now checks for storage availability and returns error codes for specific issues.
    [FileTransfer.ino]
2025-05-17 Fixed typo in CopyFileCommand comment.
    [FileTransfer.ino]
2025-05-17 GetDirectoryCommand now checks for directory existence and returns error codes for specific issues.
    [FileTransfer.ino]
2025-05-18 fix: All error messages corrected to use println.
    [FileTransfer.ino]
2025-05-18 DMA State updates, transition only when Phi2 is low (via ISR) Serial pause command update IOH_EasyFlash.c updates: Polling handler for swap check/execute outside IRQ (Min build only) Check for SwapSe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
    [Common_Defs.h, IOH_EasyFlash.c, ISRs.c, SerUSBIO.ino]
2025-05-18 Minimal build EZF bank swapping: Min_DriveDirLoad: logs file position as ChipROM pointer for ones that don't fit in RAM Min_TeensyROM.h: defines MinimumBuild for minimal build forking in common files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
    [Min_DriveDirLoad.h, Min_DriveDirLoad.ino, Min_TeensyROM.h, MinimalBoot.ino]
2025-05-19 Swap: Seek past swap blocks instead of dummy reads
    [Min_DriveDirLoad.ino]
2025-05-19 Swap: Keep track of latest swap offset addr and point to it if requested and already loaded. (cache hit) Update offset after loading
    [IOH_EasyFlash.c]
2025-05-21 Leave CRT file open for swapping if swap banks are detected during CRT parsing Brings swap time down to 2-3mS per 8k bank swap
    [IOH_EasyFlash.c, Min_DriveDirLoad.ino]
2025-05-21 Show # of swap banks on CRT load (if any)
    [Min_DriveDirLoad.ino]
2025-05-21 Definable depth swap buffer, checks for already loaded for any swap bank requested to avoid sequential swaps 8ea 8k swap buffers defined, subtracts from RAM_ImageSize
    [IOH_EasyFlash.c, Min_TeensyROM.h]
2025-05-21 SwapBuffers[].Offset init in Min build only
    [IOH_EasyFlash.c]
2025-05-21 Dbg_TestMin updated: Display swap blocks/size, more forced CRT options
    [MinimalBoot.ino]
2025-05-21 ASID: Corrected RegisterOrder init val (-1 to 255)
    [IOH_ASID.c]
2025-05-24 Pre-load all swap buffers with first swappable chips/banks Printf_Swaps to independently show swap info
    [IOH_EasyFlash.c]
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2025-05-27 Menu button reboots in min mode with Dbg_TestMin defined
    [MinimalBoot.ino]
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2025-05-27 Swift ATDT: Allow quotes before/after server name Return CONNECT on success +++ prints *aborted by user* single CR throughout (document this) Removed prints from connect/disconnect Disconnect sends N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
2025-05-27 Swift: Ethernet init on atdt (or at_c) *not* on swiftlink init No cable: NO_DIALTONE DHCP or local host fail: NO_DIALTONE No response from remote server: NO_ANSWER Dropped connection: NO_CARRIER
    [IOH_Swiftlink.c]
2025-06-03 DMA Pause check utility (beta) included in TR test/diag menu DMA test/control/timing in TR BASIC commands IO Handler
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2025-06-03 Main TR menu: PrintString looks for escape character for custom color setting TblEscC look-up table for custome colors EscOptionColor implementation
2025-06-05 IO1 regs for color references: rwRegColorRefStart, init from eeprom Read immediate, wait on write EEPROM storage for colors: eepAdColorRefStart Updated magic num, eeprom will reset with this FW relea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
    [Common_Defs.h, IOH_TeensyROM.c, Menu_Regs.h, Teensy.ino]
2025-06-05 Set colors via remote/USB: SetColorToken // Set one of the colors in the TR UI // Color will be stored in EEPROM and IO space, TR menu will need to be reset to show up // // Workflow: // Receive <-- 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
    [Common_Defs.h, RemoteControl.ino, SerUSBIO.ino]
2025-06-08 Preset color tables and aplication 4 currently available: TR Default, B&W, C64 Mono, and C128 Mono
2025-06-08 Print non-reverse alt color if matches background
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2025-06-09 EscArgSpaces to replace multiple spaces in assy prints (size reduction)
    [Menu_Regs.h]
2025-06-10 Swiftl: AT response codes sent as upper case ASCII (aka lower case PETSCII) ATZ command (soft reset) restores echo and verbose mode, regardless of argument ATH command (Hook) Dummy function to return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
2025-06-10 DbgVerbose build option in assy prints init status on TR menu/CRT start IO1 check now in CRT, but only if DbgVerbose enabled
2025-06-10 Updated DMA check: Just count loops (not ti) Check stat reg before starting each loop
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2025-06-12 #define DbgMsgs_SW to separate from general debug messages Printf_dbg_sw implemented Note on startup
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2025-06-21 baud rate control formalization via control reg bits 0-3 Used for Rx NMI assertion rate Baud_300 = , Baud_600 , Baud_1200 , Baud_2400 , Baud_3600 , Baud_4800 , Baud_7200 , Baud_9600 , Baud_14400 , Ba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
2025-06-22 Comments & Warning fixes
    [Common_Defs.h, IOH_Swiftlink.c, TeensyROM.h]
2025-07-10 MagicDesk2 (2MB flash size) support for minimal boot https://github.com/crystalct/MagicDesk2 swap buffers increased from 8 to 12 MD2 ID#79 added, associated with new IO Handler (IOH_MagicDesk2.c) Var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
    [IOH_EasyFlash.c, IOH_MagicDesk2.c, Min_DriveDirLoad.h, Min_Menu_Regs.h, Min_RunTeensyApp.ino, Min_TeensyROM.h, MinimalBoot.ino]
2025-07-13 Bug Fix: Exit to BASIC (F2) didn't always include "Special IO" selected handler
    [DriveDirLoad.ino, IOH_TeensyROM.c, IOHandlers.ino, Menu_Regs.h]
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2025-07-15 Local CCGMS default baud back to 38.4k (due to flow control improvement)
2025-07-17 Swiftlink bug fix: clear receive buffer and drop any current client connection on sw startup Issue introduced in FW 0.6.7 Thank you Stefan!
    [IOH_Swiftlink.c]
2025-07-20 Swift: proper chip reset on write to status reg
    [IOH_Swiftlink.c]
2025-07-22 SST updates: polling/irq and baud rate selection on start write status reset flow cont instead of iIRQ for Rx flow control Wait for Tx only checks Tx Empty, not DSR f4 to restart
2025-07-25 Swiftlink: Assert interrupt on cmd reg write if: there's an Rx byte waiting & IRQ(NMI) not currently asserted & IRQ is enabled & RTS (flow control) is ready
2025-07-31 warning fix: whitespace after \
    [IOH_Swiftlink.c]
2025-08-03 DMA state re-order for start vs ready DMA_S_Start_BA_Active added to force on bad line
2025-08-03 Serial LaunchFile() command accepts RegMenuTypes (Teensy, SD, or USB) RegMenuTypes enum change for down compatibility, TblMsgMenuName updated to match
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2025-08-10 Update GetDirectoryCommand() to allow Teensy stored dir read DriveType (storageType) arg instead of SD_nUSB check for storageType value in range TR dir request ignores path, skip, & take args Returns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
    [FileTransfer.ino]
2025-08-12 "NFC Enabled" changed to ""Host Ser Dev" Selects from "None", "NFC", or "TRCont" TRContEnabled bit added to power up settings need to update NFC and gen usage docs SetValColumn common to set setting 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
2025-08-16 Added Swiftlink Tx interrupt capability (q-link fix) SetNMIDeassert on Status reg read instead of Data reg CheckRxNMITimeout only actively checking when DbgMsgs_SW defined
    [Common_Defs.h, IOH_Swiftlink.c]
2025-08-17 Debug Buffer updates: * Set size based on Dbg_SerLog defined * Print size at end of "l" command
2025-08-17 Swiftlink updates for Q-Link compat: * baud enforced for Tx NMIs * CycleCountdown updated on data write * check CycleCountdown on tx irq check * Status write resets swiftlink only (not modem/connecti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
    [Common_Defs.h, IOH_Swiftlink.c]
2025-08-19 InitHndlr_SwiftLink moved out of FLASHMEM Reset Baud counter each time command reg written, regardless This is 0.6.8+5: broke xmodem download
    [IOH_Swiftlink.c]
2025-09-03 'M' on any drive menu to send/mount Dxx file on Meatloaf (C64 assy updates) * add this to help screen and gen use documentation! Brings up C64 screen to track status. Incorporated DisplaySetAutoLaunc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
2025-09-03 Meatloaf 'M'ount C/Teensy side hooks + initial implementation bug fix: auto launch set could've been impacted by random NFC tag added MeatloafComm.ino to centralize Not working yet, just checking in 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
    [IOH_TeensyROM.c, MeatloafComm.ino, Menu_Regs.h]
2025-09-10 Meatloaf x-fer/mount updates: speed: 2000000 bps CRC calc/sent x-fer data in chunks w/ ack (need matching ML code) mount to dev #8 after x-fer
2025-09-12 Power-up default regs: removed RW Read delay, moved 12/24 hr clk updated Power on defaults EEPROM Settings will reset with this FW update
    [Common_Defs.h, Menu_Regs.h, SettingsMenu.asm, Teensy.ino]
2025-09-13 NFC: Only allow re-scan of "random" tags (after 1 sec of no tag present). Re-scan of normal/non-random card blocked until another card is used or menu button pressed.
2025-09-13 NFC: Only allow re-scan of "random" tags (after 1 sec of no tag present). Re-scan of normal/non-random card blocked until another card is used or menu button pressed. Thank you Boris Schneider-Johne,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
2025-09-13 System pause via serial command asserts while BA is low (bad line) Fix DMA state check in ISRs.c wait ~250nS into vic cycle to assert DMA
    [ISRs.c, SerUSBIO.ino]
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2025-10-24 Do full reboot from min to full is ethernet enabled
    [Min_RunTeensyApp.ino]
2025-10-29 Added Default Hot Key paths to EEPROM all EEPROM values reset Reduced browser bookmarks from 9 to 5, using eepNumBookmarks throughout
    [Common_Defs.h, IOH_Swiftlink.c, IOH_TeensyROM.c, MainMenuItems.h, Teensy.ino]
2025-10-30 Swap buffers increased to 16 for SNKvsCapcom Stronger Edition
    [Min_TeensyROM.h]
2025-10-30 nS_DMAAssert defined/configure: delay from Phi2 falling to DMA assertion when activating Now delaying for de-assert as well as assert v0.6.8+19
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2025-11-12 Turn LED off at start of full image setup() to indicate start, was left on from minimal Freed up 8k of RAM1 via EthernetDeduction to fix crash w/o Serial USB connected Checking reset button in Minima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
    [Common_Defs.h, IOH_EasyFlash.c, IOH_Swiftlink.c, MainMenuItems.h, Min_TeensyROM.h, MinimalBoot.ino, Teensy.ino]
2025-11-25 EthernetInit takes message callback function for status (via TR Wait, Swiftlink, Browser, etc) If Link ON skip (not re-init) Do ethernet init/time synch before main menu display to show status getNtp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
    [IOH_Swiftlink.c, IOH_TeensyROM.c, SettingsMenu.asm]
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2025-12-04 release corrections, Teensy core batch select
2025-12-07 Bug fix: Menu clock in 24 hour mode can mess up background SID playback in the second half of the day. BCD addition done at one place (adding $12 to the hours), if interrupt happened there, would per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
2025-12-28 Reuse dot_clk input as externel reset input
    [Min_TeensyROM.h, MinimalBoot.ino, Teensy.ino, TeensyROM.h]
2025-12-28 Clarify availability of TeensyROM kits and units
    Updated the availability information for TeensyROM units.
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2026-01-17 DMA Read initial implementation. Build option: FullDMACapable Address buffer control currently via pin54 DMA Start BA now requires it to be a read cycle v0.7.0+5
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2026-01-24 fix(teensy): Rewrite of SendFileData to work reliably on both Serial and Ethernet.
    Original code treated availableForWrite()==0 as immediate failure, breaking TCP where buffer space naturally oscillates. The code has been updated handle TCP backpressure gracefully. It now uses chunked writes, yield() for stack processing, and progress-based timeout (2s) instead of failing on transient buffer-full conditions.
    [FileTransfer.ino]
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2026-01-24 fix(teensy): Refactor Ethernet to enable persistent connections instead of the one-shot / reconnect approach.
    One-shot connections were problemmatic due a race-condition where the connection would end before aysnc post launch messages such as GoodSidToken and BadSidToken were able to be received by the client. This change also decreases overhead for improved performance on time sensitive operations like SID voice muting and speed changes.
    [ServiceTCP.ino, Teensy.ino]
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2026-01-24 refactor: Fixed to use the correct logging function. Removed unnecessary yield()
    [FileTransfer.ino]
2026-01-24 fix: missed a Printf_dbg
    [FileTransfer.ino]
2026-01-24 feat: Check Minimal command is now a general FW Check command. Now uses token responses to return the FW mode that is currently loaded
2026-01-24 fix: Move EthernetClient declaration inside FeatTCPListen conditional
    [Teensy.ino]
2026-01-24 fix: removed redundant FwTokenCheck. Must have left this in there during early testing.
    [SerUSBIO.ino]
2026-01-24 fix: handle read errors in SendFileData function with appropriate logging and failure response for full backward compatibility and code standard alignment.
    [FileTransfer.ino]
2026-01-24 feat: enhance Build-DualBoot script with arduino-cli version pinning and SHA256 checksum verification for improved security
2026-01-25 Enhance TeensyROM features in C64 documentation
    Expanded the features of TeensyROM for the C64 Ultimate, detailing MIDI support, ASID protocol, SID player capabilities, remote control options, image launching, auto-launch features, diagnostic tools, and web browsing.
2026-01-25 docs: Refine TeensyROM features and enhance clarity in C64 Ultimate Enhancements documentation
2026-01-29 refactor: move CopyFile buffer declaration outside loop
    Addresses review feedback to avoid potential repeated stack
    allocation. No functional change - modern compilers already
    optimize this, but explicit placement improves code hygiene .
    [FileTransfer.ino]
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2026-02-14 Updated bundled SID-Wizard/SID-Wizard_2SID/SID-Wizard User Manual from V1.92 to V1.94 "BASIC with TR Command IO access" menu item for low level access to TeensyROM IO Commands
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2026-02-16 Added definition/interrupt/handler for Special Button rename Reset_Btn_In_PIN to Menu_Btn_In_PIN
    [Common_Defs.h, ISRs.c, Teensy.ino, TeensyROM.h]
2026-02-16 DMA expanded to range of memory read/write to/from buffer Separate DMA Write and Read/Verify serial commands (u/v)
2026-02-22 'w' Serial command to determine R/W RAM in 4k blocks time logged for DMA read/write block commands ('u'/'v') # micompares calculated for read
2026-02-24 DMA timing improvements: Check for BA signal after Phi2 wait/transition DataPortWaitDMARead() set 320->370 DataPortWriteWaitDMA brought local for longer hold and edge detect removed DMA packet in ISR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
2026-02-24 DMA R/W test, argument '0' for write/read zeros, anything else for R/W LSB
2026-02-24 Button check at end of setup in case of false trigger (which could defeat autolaunch) Hold button until LED comes on to skip autolaunch, 10 sec to flashing/eeprom reset
    [Teensy.ino]
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2026-03-03 New DMA State to maintain DMA assertion after transfer REU additions: transfer both dirs, temp file, FF00 trigger CloseDMA() function, option on PerformDMA() EEP Magic num update, this will reset EEP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
    [Common_Defs.h, DMAControl.ino, IOH_REU.c, SerUSBIO.ino]
2026-03-04 Menu_Btn_In_PIN name correction in minimal
    [MinimalBoot.ino]
2026-03-04 REU Interrupt mask and initial Addr Control Regs IO trace log print regs
2026-03-06 REU: Fixed addr options for C64 and REU R/W Removed CloseDMA argument from PerformDMA(), always call manually.
    [DMAControl.ino, IOH_REU.c, SerUSBIO.ino]
2026-03-06 REU/C64 swap command check for 0 size before buffer malloc
    [IOH_REU.c]
2026-03-06 Local bools FixC64Addr and FixREUAddr
    [IOH_REU.c]
2026-03-07 DbgMsgs_REU option, default off write first in swap to flush during DMA
    [IOH_REU.c]
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2026-03-12 New settable timing parameter: nS_DMASetup (te###) default: 380 DMA read wait time increased from 370 to 390nS bool DMAByte() to break out low level byte read/write v0.7.1+4
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2026-03-17 Alt button performs freeze/unfreeze, LED flashes during Freeze 10x/sec 100mS debounce tied in with remote pause/freeze, changed from on BA active, LED also flashes DMA Actuated on any read state via 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
2026-03-22 DirectREU: Exit on miscompare (ErrOut) on REUReg_Command_TypeR2C check for slow read, skip cycle is needed, MisCount to count them Use #ifndef Direct_REU to block out buffer method
    [IOH_REU.c]
2026-03-24 RTC incorporation for all HW types Replaced rsGetTime with rsSetRTCfromNet and rsC64TODfromRTC UTC time kept in RTC, modified for C64
    [IOH_TeensyROM.c, Menu_Regs.h, SettingsMenu.asm, Teensy.ino]
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2026-03-31 REU now using internal RAM, 512k in size. PSRAM no longer used
    [IOH_REU.c]
2026-04-05 Bug Fix: C128 cold boot issue (TR & TR+) Thanks for the find Jamie!
    [Teensy.ino]
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2026-04-05 Default SID update: "DivertigO: Death Is No Evil" eepMagicNum to force update This version will reset EEPROM values (Sorry Joe ;) )
    [Common_Defs.h, TeensyROM.h]
2026-04-05 Default time zone changed to UTC+0 (GMT) so time starts at midnight by default without battery.
2026-04-06 SuperSnapshotV5 IO Handler framework & CRT file association #define Fab04_Freezers to enable
2026-04-07 Special button moved to Bounce lib, removed from HW interrupt Dynamic action on change callback: fSpecialBtnChange Default on boot: SpecialBtn_Pause
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2026-04-12 SSv5 Freeze NMI/IRQ synched to next phi2 read via CycCntFreeze print removed from SpecialBtn_SuperSnapshotV5 (duh) 32k ram cleared on init
2026-04-12 200 bytes of EEPROM reserved for future use (eliminates additional EEP Resets later) SetEEPDefaults moved to FLASHMEM (saves 450 bytes of RAM) Magic num rev, this will reset EEPROM settings v0.7.1.8
    [Common_Defs.h, Teensy.ino]
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2026-05-03 Initial Kernal Replace test implementation Serial 'u' command (temp) Fab04_KernalReplace defined for FAB 0.4 Features Fab04_DebugSignals now always enabled (on Fab0.4) v0.7.2.1
    [Common_Defs.h, SerUSBIO.ino]
2026-05-03 "512KB REU" text label for REU Code to pre-load REU in InitHndlr_REU (commented out for now) set fBusSnoop = NULL on main menu start BusSnoop.ino printf fix
    [BusSnoop.ino, IOH_REU.c, Teensy.ino]
2026-05-04 Kernal replace: 9nS longer hold for HIRAM detect (C64c) debug build options Don't force reset at end (causes double reset)
    [IOH_KernalReplace.c]
2026-05-05 Propagation delay for Kernal replace to sample ROMH: stored in Cyc_KernProp Tweakable in timing parameters (tk##) default increased from 21 to 35 Teensy Cycles Warning fix: free((void*)KernalBin) v0.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
    [Common_Defs.h, IOH_KernalReplace.c, SerUSBIO.ino]
2026-05-08 MaxPathLength reduced to 256 chars from 300 to make more room in EEPROM Re-mapped EEPROM This update will reset EEPROM Contents
    [Common_Defs.h]
2026-05-08 <Shift-K> from SD/USB dir menu to select highlighted file for KERNAL replacement Stored in EEPROM
    [Common_Defs.h, IOH_KernalReplace.c, IOH_TeensyROM.c, Menu_Regs.h, Teensy.ino]
2026-05-09 KERNAL replace Special IO PreStart check on program launch to set up before init sequence KERNALPreStart() InitHndlr_KernalReplace no longer called automatically on IOH init (later)
    [IOH_KernalReplace.c, IOH_TeensyROM.c, Menu_Regs.h]
2026-05-10 Fab04_GlobalKernalReplace build option, disabled by default Forces any program launch to enable Kernal Replace, reagrdless of Special IO settings For debugging parallel operation
    [Common_Defs.h, IOH_KernalReplace.c, IOH_TeensyROM.c, ISRs.c, Teensy.ino]
2026-05-13 Special button saves REU contents when REU Special IO is running. Never overwrites existing, appends incrementing unique sequential number. Currently sets start name to "/reu/test.reu", will update t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
2026-05-13 Set REU file to load/uniquely save with 'R' REU Filename stored in EEPROM, default is SD:/reu.reu Special button saves using EEPROM filename (xyz incremented) Moving messages from menu assy code up t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
    [Common_Defs.h, IOH_REU.c, IOH_TeensyROM.c, Menu_Regs.h, Teensy.ino]
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2026-05-21 New remote command: WriteC64Mem (remote DMA) Command: Write sequential C64 memory segment with supplied data
    Workflow:
    Receive <-- WriteC64MemToken (0x64FB)
    Receive <-- C64 address (Hi,Low)
    Receive <-- Data Length (Hi,Low)
    Receive <-- Data Bytes (Data Length)
    TR+ Performs DMA Write
    Send --> AckToken 0x64CC on successful completion, 0x9b7f on Fail
    [Common_Defs.h, SerUSBIO.ino]
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2026-05-31 TR General settings screen fully plumbed/ready PrintFileName for common file name retrieve from eep and print
2026-06-21 DMA remote write and freeze button activate DMA on bad line read instead of immediately some dma state renaming
2026-06-23 Setting and help F8/F7 shortcuts pointed to new prgs C option removed (color setting is in prg) Removed help, settings, and color select screen code main menu size reduced from 7700 to 4614 bytes
    [SettingsMenu.asm]
2026-06-23 MIDI Message Filter framework: 2 new regs to persistently hold values in IO1 and EEPROM Setting menu: Show states and toggle each all the way back to EEPROM EEPROM Reset
    [Common_Defs.h, IOH_TeensyROM.c, Menu_Regs.h, Pg_MIDISettings.asm, Teensy.ino]
2026-06-23 MIDI Filter application: IOH_MIDI and MIDI2SID (IOH_TR) Moved both IO inits to FLASHMEM to save RAM
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2026-06-27 Settings Index menu page added Color page selections changed to letters global page select and TR reset
    [Pg_ColorConfig.asm, Pg_Index.asm, Pg_TRSettings.asm, SettingsMenu.asm, SupportFunctions.asm]
2026-06-27 'a' to force Eth init on gen info page not printing IP on startup page
2026-06-27 Separated out command processor (ProcessCommand()) from ServiceSerial if/then/else converted to select/case functionally the same
2026-06-28 Asynch DMA Start improvements for Remote DMA and Serial commands Assert on any Read preceded by a write, or any Bad Line Read timeout in 5000 cycles: assumes read loop and asserts Cycle count shown i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
2026-06-28 New DMA state: DMA_S_TransferExecuting to trigger DMA ISRs.c extra step in PerformDMA Removed DMA_S_Start_BA_Freeze/DMA_S_FreezeReady, Button/remote pause now using DMA_S_StartAsynch
2026-07-09 Alternate button actions, selectable on general settings page Active when the button *isn't* being used by a freezer cart (freeze activation) or REU (press to save REU image) Select from the followin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
    [Common_Defs.h, Menu_Regs.h, Pg_TRSettings.asm, Teensy.ino]
2026-07-15 External port check control call/code checks SD, USB Host/Device, Ethernet, Menu button, Alt button (TR+), LEDs (Eth/TR), RTC
2026-07-18 DMA test added, covers all addr/data lines, DMA, BA, R/*W I & O 'L' to loop forever, or until fail
    [IOH_TeensyROM.c, Menu_Regs.h]
2026-07-18 Assembly build batch file updates: Master BuildAllC64.bat to assemble/build all All Exit on error (more checks) Error codes on batch file exit md %buildPath% in case not present backslashes in assy i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
    [ASIDPlayer.asm]
2026-07-19 Bug fix: occasional reset issue, now checking for button in SendMsgSerialStringBuf to force wait for C64 timeout
    [FileParsers.ino]
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2026-07-21 Walking Ones test added DMA page expanded, but treated as a single test hirom/lorom pointed after ram image setup
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2026-07-21 TestDMAPage blocked out for TR to compile correctly
    [IOH_TeensyROM.c]
2026-07-22 PN532: Fixed warnings, Trimmed down local lib
    [PN532.cpp, PN532.h]
2026-07-23 Main build script updates: Build-DualBoot.ps1 Check for Fab04FeaturesDefined and offer to edit out if it's there and shouldn't be (TR) print $TeensyCorePath to screen show build time and current time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
2026-07-27 Show unique Teensy ID on startup serial, General Info Settings, and on Version Info Remote Command ControlComms.md example update
2026-07-30 Now allowing wrap-around prg loading, only exit the loop when end is indicated and ignore wrap overflow message/print removed, location compensated jump added Thank you @LessPaul for the find v0.7.2.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
2026-07-31 Bug fix: D64/71/81 extracted file length was rounding up to end of sector
    [D64.ino]
2026-08-03 Build-DualBoot.ps1: version output filenames, add up-front overwrite check - Print detected Teensyduino version before showing the Teensy core path - Read TRVersion from Common_Defs.h and embed it in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
2026-08-09 Add C64 Ultimate/Ultimate64 compatibility note for TR+ DMA features
    Bus Operation Mode must be set to "Writes" on the C64U for reliable TR+ DMA-based feature compatibility (Freezer, REU, KERNAL Replace, etc). Documented in both TR+ feature docs.
2026-08-10 FW 0.8.0.1: Add option to disable External Reset Detect (TR+)
    New "Ext Reset Detect" toggle ('g') on the TR Settings page lets
    users disable TR+'s auto-return-to-menu behavior on external reset
    (C64U button, User port, etc), for setups where that's undesired.
    Defaults to enabled, matching prior always-on behavior.
    New EEPROM-backed reg (rwRegPwrUpDefaults3/eepAdPwrUpDefaults3) and
    isrExtResetDetect() gate the existing reset-detect ISR on the new
    setting. Settings Menu rows renumbered to fit the new toggle.
    Note: MinimalBoot (large-CRT loading) keeps the old always-on
    behavior -- the new IO1 register isn't mirrored there, and
    toggling it from a self-triggered reset leaves state inconsistent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
    [Common_Defs.h, IOH_TeensyROM.c, ISRs.c, Menu_Regs.h, MinimalBoot.ino, Pg_TRSettings.asm, Teensy.ino]
2026-08-11 Add Clear-ArduinoCache.ps1 standalone cache-clear script
    Mirrors the cleanup Build-DualBoot.ps1 already does before each build
    (Arduino temp/local core+sketch cache, TeensyROM and MinimalBoot build
    output dirs), as a standalone tool to run on demand for clearing out
    build artifacts and simplifying file searches.
2026-08-11 FW 0.8.0.2: Add RetroReplay cartridge support
    New IOH_RetroReplay.c implements the RetroReplay I/O handler (control
    register banking, freeze/NMI-IRQ handling, RAM-backed LOROM writes),
    based on the RetroReplay firmware/hardware docs and VICE CRT notes.
    Cart_RetroReplay is now wired up in HWID_IOH_Assoc (DriveDirLoad.h)
    and the handler is registered in IOHandlers.h/Menu_Regs.h -- previously
    stubbed out as WIP.
    Thank you to Paul Harker (Lesspaul on GitHub) for contributing the
    RetroReplay handler.
2026-08-12 Add docs/Architecture reference doc set
    Dense, AI/contributor-oriented structural reference covering the
    Teensy firmware and C64-side codebases, the two build toolchains,
    the cartridge register + external host comms protocols, and hard
    firmware constraints (ISR hot path, memory budgets, toolchain pin).
2026-08-12 Expand docs/Architecture with ISR/wait-mechanism detail and Known-Issues
    Deepen the hot-path constraints (flash-backed vs RAM-backed rule,
    cooperative-polling wait mechanism, Ethernet-disable sites), record
    the verified full/minimal/shared file split, correct PCB toolchain
    to Eagle (not KiCad), and add a Known-Issues doc tracking scoped
    findings from this session's architecture review.
2026-08-12 Fix MIDI Message Filter copy-paste bug for SongSelect/TuneRequest/RealTimeSystem
    SongSelect, TuneRequest, and RealTimeSystem handler registration all
    incorrectly checked rMIDISet2SongPositionEn instead of their own
    distinct enable flags, so toggling any one of the four settings-menu
    filters affected all four together instead of independently.
    [IOH_MIDI.c]
2026-08-12 Fix resource leaks and off-by-one bugs found during IO_Handlers review
    - IOH_REU.c: close LoadFile handle on oversized-file path; enable the
    special button as soon as REU RAM is ready rather than only after a
    successful preload, so a missing/oversized preload file no longer
    silently disables it
    - IOH_KernalReplace.c: same LoadFile handle leak on wrong-size path
    - IOH_Debug.c: fix off-by-one buffer overflow in IO1Hndlr_Debug's trace
    log (BigBufCount bounds check ran after the write, not before)
    [IOH_Debug.c, IOH_KernalReplace.c, IOH_REU.c]
2026-08-12 Fix double-close of DxxFile in MountDxxFile
    DxxFile was already closed after the chunked-send loop completed
    normally; a subsequent failed Conf-response check closed it again.
    [MeatloafComm.ino]
2026-08-13 Log Teensy.ino FLASHMEM candidates in Known-Issues.md
    Verified via the actual pinned Teensyduino 1.61.0 clockspeed.c that
    set_arm_clock() only touches the ARM core clock tree, not FlexSPI/
    flash timing, clearing setup() as a FLASHMEM candidate.
2026-08-13 Document RAM1 pressure in Fab04 build and log MinimalBoot.ino FLASHMEM candidates
    Fab04 (TR+) main firmware has only ~9-10KB RAM1 padding left before
    a hard link failure, making FLASHMEM migration a real necessity
    rather than pure optimization -- corrects earlier framing that
    treated MinimalBoot as the tighter build. Also logs MinimalBoot.ino's
    missing FLASHMEM coverage and confirms its DriveDirMenu/LoadCRT
    differences from Teensy.ino are intentional, not bugs.
2026-08-13 Log two more high-priority findings: EEPROM overflow and Min_DriveDirLoad.ino source-read bug
    LaunchFile() in Min_SerUSBIO.ino can overflow the eepAdCrtBootName
    EEPROM field into adjacent fields (persistent corruption), same
    MaxNamePathLength-vs-MaxPathLength root cause as the DriveDirPath
    finding. Min_DriveDirLoad.ino's CRT-header parsing has a tighter,
    more immediate stack out-of-bounds read than the equivalent
    full-firmware case. Plus FLASHMEM candidates from the remaining
    MinimalBoot-only files (MinimalBoot.ino, Min_DriveDirLoad.ino,
    Min_ServiceTCP.ino); Min_RunTeensyApp.ino reviewed clean.
2026-08-14 Add static_assert to catch IOHandler[]/enumIOHandlers count mismatch
    Add compile-time check that IOHandler[] and enum enumIOHandlers stay
    in sync on entry count, since the two are hand-synced across several
    #ifdef gates with no compiler enforcement. Mark the Known-Issues.md
    entry as fixed.
    [IOHandlers.h]
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2026-08-17 Fix RR38 Extended Control Register handling in IOH_RetroReplay.c
    Rename StatusReg to RR_StatusReg and properly track the write-once
    REU_MAP/ALWBNK bits set via $de01 instead of overwriting them on every
    $de00 write. Document the Status Register read bits and align register
    comments with the Action Replay-compatible layout.
    [IOH_RetroReplay.c]
2026-08-19 Add compiler check for required "Serial + MIDI" USB Type setting
    Building with the wrong Arduino USB Type produces a cryptic
    "'usbMIDI' was not declared" error. Fail fast with a message
    pointing to the correct Tools > USB Type setting.
    [IOHandlers.h]
2026-08-20 Split nS_MaxAdj into separate PAL/NTSC thresholds
    NTSC's shorter nominal Phi2 cycle (~978nS vs PAL's ~1015nS) left it
    with more slack than PAL before the ISR-lateness correction in
    isrPHI2() kicked in, backwards from what its tighter bus timing
    calls for. Restores the NTSC-specific value that used to exist
    before both modes shared one constant, switched at runtime the same
    way nS_DMASetup already is.
    [Common_Defs.h, IOH_TeensyROM.c, Min_SerUSBIO.ino, SerUSBIO.ino]
2026-08-20 Remove Self Test IO1 Read from menu, now redundant with Exp Port test
    Self Test IO1 Read (formerly "Self Test") is now redundant with the
    Expansion Port test, so remove it from the normal menu and gate it
    behind !ifdef EnIO1ReadTest for debug builds. TR+ Ext Reset Detect
    moves up to key 'f' to take its place; row positions adjusted
    accordingly.
    [Pg_TRSettings.asm]
2026-08-20 Disable Ethernet and PIT interrupts during Expansion Port DMA test
    Interrupts firing mid-DMA could interfere with the walking-ones and
    other Expansion Port test sequences, so mask IRQ_ENET and IRQ_PIT for
    the duration of ExpPortDMA() on Fab04-capable boards.
    [IOH_TeensyROM.c]
2026-08-21 Replace Post-PRG-load IO Handler swap static delay with poll handshake
    The C64 side used to burn a static delay loop after a PRG finished
    loading, tuned to outlast the Teensy's IO1-handler swap. It was both
    wasteful (always paid the worst case) and unsound (an REU pre-load
    with no SD/USB media present can exceed any fixed delay, since a
    media timeout has no bound a constant can cover).
    Replaced with a poll: rRegIOHSwapPoll answers busy/ready regardless
    of which handler is current, via a HandshakeSnoop installed on
    fBusSnoop synchronously in the ISR's existing rCtlRunningPRG case --
    no new logic added to the per-cycle ISR itself.
    Since fBusSnoop is a single contested global, anything instal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
    [BusSnoop.ino, Common_Defs.h, IOH_KernalReplace.c, IOH_REU.c, IOH_TeensyROM.c, IOHandlers.ino, Menu_Regs.h, Min_DriveDirLoad.ino]
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2026-08-21 Fix RR38 freeze-bit set logic and remove no-op special-button stubs
    RR_StatusReg's freeze-bit set path used &= instead of |=, which
    cleared every other status bit instead of setting the freeze bit.
    Now uses |=, matching the release path's already-correct &= ~mask
    pattern.
    Replace the NoFreeze/SpecialBtn_None no-op functions with a NULL
    check at fSpecialBtnChange's one call site (Teensy.ino loop()) --
    SetUpMainMenuROM() already resets fSpecialBtnChange to the
    configured default on every return to the menu, so nothing needed
    a dummy function to fall back on.
    Minor cleanup: fix a bitwise & standing in for a boolean &&, add the
    missing & on CycleHndlr_RetroReplay's struct entry, drop a redunda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
    [IOH_RetroReplay.c, Teensy.ino]
2026-08-21 Add FLASHMEM to remaining 5 functions in StatusFunctions.c
    SendStrPrintfln, WriteEEPROM, UpDirectory, SetCursorToItemNum, and
    SearchForLetter were missing FLASHMEM while their neighbors already
    had it. StatusFunction[] is only ever dispatched from
    PollingHndlr_TeensyROM() (main-loop context, never the ISR), so
    there's no execution-speed reason for the inconsistency. All 35
    functions in the file now use FLASHMEM.
    [StatusFunctions.c]
2026-08-21 FW 0.8.0.4 beta
    Version bump only, plus a stray tab->space whitespace fix in
    CPU_RESTART_VAL alignment.
    [Common_Defs.h]
2026-09-10 Fix DMA write timing on NTSC; add bit-pattern DMA self-test
    DataPortWriteWaitDMA() released the data bus a hardcoded 430nS for both video
    standards. Split the setup/hold constants PAL/NTSC, make them tunable like every
    other timing constant, and drop the NTSC hold to 410.
    Measured on a flat NTSC C128 + TR+ (9/9/26), two distinct failure modes:
    - Deterministic, reproducible on demand: at 455+ the wait runs past Phi2 falling,
    so the port/buffer teardown and the next DMAByte() lose cycle alignment. Whole-
    byte corruption (the readback keeps the page's previous contents), collapsing
    completely by 460 - even the same-value control fails.
    - Intermittent, varying over hours: partial-byte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
    [Common_Defs.h, DMAControl.ino, IOH_TeensyROM.c, SerUSBIO.ino, StatusFunctions.c]
2026-09-10 Record PAL DMA write-hold validation on real silicon
    The prior note said PAL's collapse point came from a C64 Ultimate and that
    PAL's partial-byte margin was unverified, because an FPGA has no real DRAM
    to be marginal. Re-ran the sweep on an original C64 with a VIC-II Kawari
    configured for PAL, TR+ installed.
    PAL detection was confirmed to actually fire rather than being read back
    from the identical power-on defaults: poisoning nS_MaxAdj to 900 and
    nS_DMASetup to 400, then resetting the C64, restored 1030/440, which only
    the PAL branch writes.
    Results, ~15.6MB of DMA writes total:
    - hold 430 baseline, 1.28MB, clean across all five bit patterns
    - collapse between 480 and 485, whole-byt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
    [Common_Defs.h]
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2026-09-10 Address code review of the DMA write-timing branch
    Common_Defs.h: the pre-discovery comment claimed nothing DMAs before the
    menu writes wRegVid_TOD_Clks. That is false. Autolaunch reaches
    RemoteLaunch() with DoCartDirect and starts a CRT without ever loading the
    menu, so an NTSC machine keeps the PAL 430 hold - inside NTSC's own
    430-450 partial-byte band - while the REU handler and Write/ReadC64MemToken
    are both reachable. Corrected to describe the real exposure. Not fixing it
    by dropping the default to 410: that still needs a PAL board that reproduces
    the 390 (err), and the one PAL rig measured so far does not.
    TestDMAPattern(): the bit-level detail block was gated on BadBytes, so a
    ru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
    [Common_Defs.h, SerUSBIO.ino, StatusFunctions.c]
2026-09-10 Append unique chip ID to MIDI product/serial USB names; bump to 0.8.0.6
    Lets multiple TeensyROM units be told apart by the host, using the same
    HW_OCOTP_MAC0 fuse + OS-X CDC-ACM workaround already used elsewhere for
    the status UID. Applied in setup(), the earliest hook a sketch has;
    documented in midiDevName.c why that can still lose a race against the
    core's own ~300ms pre-enumeration delay.
    [Common_Defs.h, Teensy.ino]
2026-09-11 Report TestDMAPattern() results to the C64/C128 screen
    Adds a ToScreen param: the per-pattern OK/Failed summary now goes through
    SendMsgPrintfln() when set, so ExpPortDMA()'s menu-driven self-test is
    readable without a PC serial terminal attached. On failure, a second line
    reports pre-fill and pattern bad counts independently (a pre-fill-only
    failure was showing a misleading all-zero xor/unchanged line otherwise).
    The full bit-direction table stays serial-only - too wide for 40 columns.
    The 'z' serial sweep command in SerUSBIO.ino passes ToScreen=false,
    unchanged from before.
    [SerUSBIO.ino, StatusFunctions.c]
2026-09-11 Add WaitUntil_nS_fine() and use it for the DMA data setup/hold waits
    Hoists the nS-to-cycles conversion out of the poll loop instead of
    recomputing it every pass - nSToCyc() reads the volatile F_CPU_ACTUAL, so
    left inline it was reloading, shifting, multiplying, and dividing on every
    iteration, widening the loop's polling period and biasing every wait to
    overshoot late, never early. Wrapped in do/while(0) for macro safety, so
    it behaves as a single statement even inside an unbraced if/else.
    DataPortWaitReadDMA()/DataPortWriteWaitDMA() now use it in place of the
    inline hand-hoisted version; also removes a leftover duplicate wait block
    that had crept into DataPortWaitReadDMA() during the tran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
    [Common_Defs.h, DMAControl.ino]
2026-09-11 Relocate DMA timing tracking doc under docs/Architecture
    docs/DMA_Timing_Known_Issues.md moves to docs/Architecture/DMA-Timing-Known-Issues.md,
    matching that folder's naming convention, and gets added to Overview.md's doc-set
    index. It's about TR+'s true bus-mastering DMA, not the >850KB CRT bank-swap
    pause mechanism Known-Issues.md already tracks separately - those are genuinely
    different code paths, confirmed via IOH_MagicDesk2.c, which shares only the
    DMA-assert sequence (nS_DMAAssert/SetDMAAssert) and never touches the
    data-setup/hold timing PR #21 fixed.
    Noted that one shared constant as an open, unconfirmed hypothesis in both docs:
    if nS_DMAAssert turns out marginal on C128 the way a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
2026-09-12 Document official C64/C128 expansion port DMA timing reference
    Adds C64-C128-DMA-Port-Reference.md, sourced from the C64/C128 Programmer's
    Reference Guides and the official 1750/1764 REU service schematics, to check
    whether the two machines' expansion ports actually call for different /DMA
    assert/de-assert timing. Both PRGs publish the identical rule (assert only
    while Phi2 is low) with no separate spec for either machine - the C128
    difference that is documented is architectural, not a timing-window change:
    /DMA routes through the MMU (GAEC gating, Z80 /BUSRQST, TA/SA bus reversal)
    rather than straight to the CPU, and DMA forces the MMU's clock output to
    1MHz regardless of FAST/SLOW mode.
    C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
2026-09-12 Fix nSToCyc precedence bug (item #12); note IRQ restore path (item #10)
    nSToCyc(N)/CycTonS(N) now parenthesize N - unparenthesized, an expression
    argument like nS_DMASetup-90 only had its trailing term converted, not the
    whole expression. Safe as a global change: every other call site already
    passes a bare variable. The two affected IOH_REU.c sites (-90, -85) had their
    literals recalculated (+9, +14) to reproduce the same empirically-converged
    arm point under the corrected formula rather than silently shifting it -
    unverified on hardware, since USE_PSRAM isn't in active use.
    Also notes in ExpPortDMA() that IRQ_ENET/IRQ_PIT staying disabled through
    every exit path is intentional - SetUpMainM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
    [Common_Defs.h, IOH_REU.c, StatusFunctions.c]
2026-09-12 Reorganize DMA-Timing-Known-Issues.md by category instead of chronologically
    Grouped into Development / Investigation / Validation / Closed instead of
    Open bugs / Housekeeping, since the latter distinction stopped mapping to
    anything real once every original Housekeeping item ended up closed. Item
    numbers kept stable rather than renumbered - they're referenced from code
    comments (IOH_REU.c, Common_Defs.h) and the Known-Issues.md cross-link -
    only the physical grouping and section headers changed, no content edits.
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2026-09-16 Add Node build-firmware.mjs for TR/TR+, retiring HexCombine.exe
    Phase 1 of consolidating the build tooling onto zero-dependency Node.
    Ports Build-DualBoot.ps1: builds in a private copy of the Teensy core so
    the installed one is never modified, fixing the stale bootdata.c bug.
    Combines the two intermediate hex files with a literal port of
    HexCombine.exe's own algorithm (source recovered during this work), so
    the Windows-only .exe and runner are no longer needed at all.
    Verified against the original: build-firmware.mjs's output for --target
    tr is byte-for-byte identical to Build-DualBoot.ps1's (both intermediate
    hex files and the combined _full.hex), with SOURCE_DATE_EPOCH pinned the
    same way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
2026-09-16 Fix Linux Arduino user-dir default; bump CI actions off Node 20
    defaultArduinoUserDir() used Documents/Arduino for every non-Windows
    platform, but arduino-cli's real default on Linux is ~/Arduino (only
    Windows and macOS use the Documents/Arduino convention). On the CI
    runner this meant `arduino-cli lib install CRC32` (run with arduino-cli's
    own default config) put the library in ~/Arduino/libraries, while our
    build pointed ARDUINO_DIRECTORIES_USER at ~/Documents/Arduino instead,
    so the compile step couldn't find CRC32.h. First fork CI run
    (Release_v0.8.0.6-node-phase1) failed on exactly this.
    Also bumped actions/checkout, actions/setup-node, actions/upload-artifact,
    and softprops/action-gh-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
2026-09-16 Fix RemoteLaunch dropping the filename for root-level hot-key targets
    RemoteLaunch()'s path/filename split truncated DriveDirPath to an
    empty string instead of "/" when the target was a root-level file,
    since the only slash in the path was the leading one. That left
    HandleExecution()'s VM-registry interception unable to fire (its
    DriveDirPath[0] guard failed on the empty string), so a hot-keyed
    root-level VM .crt loaded as an ordinary cartridge instead and never
    got serviced by the VM host -- reproduced identically for DOOMVM and
    NESVM. Fixed by re-pointing the filename into the untouched source
    buffer instead of leaving it aliased into DriveDirPath, which a first
    attempt at this fix got wro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
    [RemoteControl.ino]
2026-09-16 Mark HandleExecution FLASHMEM to recover RAM1 padding
    Main's RAM1 grew ~4KB after MPE_VM_ENABLED was added. Traced to
    MPELaunch::tryFile(), itself marked FLASHMEM with only one call site
    (inside HandleExecution()), getting fully inlined into HandleExecution()
    since that function isn't FLASHMEM -- defeating the attribute on the
    callee. Marking HandleExecution() itself FLASHMEM fixes it directly;
    its call sites are all main-loop/StatusFunction-dispatched (never the
    ISR path), and it's already reached only via function pointer
    (StatusFunctions.c's dispatch table), which independently prevents
    the compiler from inlining it anywhere else. Recovers 4,560 bytes of
    RAM1 padding.
    [DriveDirLoad.ino]
2026-09-16 Detect the C128 and give it its own NTSC DMA timing
    On a flat NTSC C128 (64 mode) + TR+, DMA writes at the shipped NTSC set
    drop bits intermittently, which is why the z test fails on C128s while C64s
    pass. The lever is nS_DMASetup (te), the point R/W and the address are
    driven. Swept with release and read latch held at te+840 and te+820 so only
    the assert edge moved, 3-4 interleaved reps with a C64 reset before each:
    380 collapses, 405-435 intermittent (430, the shipped value: 29 and 55 bad
    over two 3xz200 runs), 440-450 near clean, 455-460 errors return, 465+
    collapses. Fine sweep at z500 x4: 435 25, 440 1, 445 0, 450 5.
    Detection: the VIC-IIe implements $D030 bits 0-1 (reads $fc at 1MH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
    [Common_Defs.h, DMAControl.ino, IOH_TeensyROM.c, Menu_Regs.h, SerUSBIO.ino]
2026-09-16 Add a DMA write loop for scoping the C128 write fault
    Source/Teensy/tools/dma_scope_write.py repeats one-byte DMA writes to a
    single address over the TR+ USB serial port, reads each one back, and
    stops at the first bad write, so a scope triggered on R/W falling with
    /DMA low is left holding that write. --te moves the DMA setup time with
    the Dbg_SerTimChg serial commands, after checking the build has them,
    and restores the detected defaults on exit, including on Ctrl+C.
    Tested on the NTSC C128 with a Dbg_SerTimChg build: te405 at $C0EF and
    $C0FF, stop at the first bad write, Ctrl+C restore, and the detected
    te445. Not tested on hardware: the reset out of the minimal firmware,
    and the refusal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
    [Common_Defs.h]
2026-09-16 Add C128 NTSC DMA timing items #14/#15 and local validation log
    Items #14 (kfox's te445 NTSC128 fix) and #15 (residual write fault
    after the fix) imported from kfox's write-up, cross-referenced against
    #1/#3/#6/#9.
    C128-DMA-Timing-Experiment-Log.md and -Session-Summary.md record a
    local hardware pass trying to reproduce both on this rig: kfox's #14
    fault briefly reproduced with a scope-probe interposer in circuit,
    then stopped being reproducible under the same conditions after
    ~700k further writes. Treat that finding as unconfirmed, not
    validated — see the log for the full account.
2026-09-16 Convert DMAByte()'s BA-wait to WaitUntil_nS_fine() (item #9)
    Progresses item #9 (DMA-Timing-Known-Issues.md) — DMAByte()'s BA-sample
    wait was already doing the fine/hoisted pattern by hand; now uses the
    shared macro instead of duplicating it inline.
    Also swaps the remaining `& 1`/`& 2` magic numbers for the
    rvtcNTSC/rvtc60Hz constants Menu_Regs.h already defines, in
    FileParsers.ino and IOH_TeensyROM.c's M2S frequency calc — same
    values, just named. Two comment-only additions: a "do not change
    location" note on rvtcNTSC, and a FLASHMEM warning on
    SetVideoStdTiming() (called from the IO1 handler).
    No functional change in any of the four files — verified each
    replacement against its pri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
    [DMAControl.ino, FileParsers.ino, IOH_TeensyROM.c, Menu_Regs.h]
2026-09-16 Show detected machine (C64/128, NTSC/PAL, Hz) in Settings, Version Info, and the SID Info page
    StrMachineInfo now feeds General Settings' "Machine:" line,
    VersionInfoToken's reply, and the SID Info page consistently.
    Previously only written inside ParseSIDHeader(), gated behind six
    validation checks unrelated to its content (it's built purely from
    IO1[wRegVid_TOD_Clks], set independently at boot) — a bad or missing
    SID load left Settings/Version Info blank or stale. Now populated in
    SetVideoStdTiming(), the same choke point that already selects DMA
    timing from machine type: correct at boot, refreshed on every td
    re-trigger, no SID dependency.
    [FileParsers.ino, IOH_TeensyROM.c, Pg_InfoOther.asm, SerUSBIO.ino]
2026-09-17 CI: replace arduino/setup-arduino-cli with a pinned, checksummed install
    arduino/setup-arduino-cli@v2 is the newest release of that action and its
    action.yml still declares `using: "node20"`, so the Node 20 deprecation
    warning can't be fixed by bumping the tag. Drop the action and resolve
    arduino-cli the same way the build itself does: env override, then PATH,
    then a pinned download verified against its release checksum.
    Extends tools/lib/toolchain.mjs's resolver (previously Windows-only) to
    also cover linux-x64, darwin-x64 and darwin-arm64, pinned to 1.5.1 (up
    from the old Windows-only 1.4.1 pin) with checksums from arduino-cli's
    own release checksums file. Adds tools/install-arduino-cli.m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
2026-09-17 Docs: describe tools/build-firmware.mjs instead of the superseded .ps1
    PR #22 (Phase 1) already moved dual-boot linking from Build-DualBoot.ps1
    to tools/build-firmware.mjs (npm run build:tr / build:tr-plus), and CI
    already runs the Node path -- but docs/Architecture/Build-System.md,
    Source/BuildInfo.md, and docs/Architecture/Teensy-Firmware.md still
    pointed readers at the old PowerShell script as if it were current.
    - Build-System.md's "Dual-boot linking" section now describes the Node
    builder (what CI and build.yml actually run) instead of
    Build-DualBoot.ps1, and corrects the Fab04_Features guardrail
    description to the builder's actual behavior: it throws by default and
    takes --yes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
2026-09-17 CI: restore the npm test script and its surviving tests
    149fb10 added a "Run tool tests" (npm test) step, but the `test` script
    and every test file it ran were dropped with the MPE history rewrite, so
    the build failed at that step with "Missing script: test".
    Restore Source/Teensy/tests/recovery-flash-source.test.js (not MPE-specific:
    it guards that startup can't trigger a flash and that the normal update
    path still validates the flash ID before moving flash) and a `test` script
    that runs it. Also move in the one non-MPE check from the removed
    mpe/tests/startup.test.mjs: the normal browser update route (DoFlashUpdate)
    is still defined and reachable. All three tests pass against current main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
2026-09-17 CI: build TR and TR+ in parallel, with ccache
    The two targets now build as parallel matrix jobs. A `collect` job merges
    their hex files back into the single `firmware` artifact and, on
    Release_v* tags, publishes them. Only `collect` gets contents: write;
    the workflow default is now read-only.
    Adds `--ccache` to build-firmware.mjs. The Teensy recipes quote the
    compiler path, so ccache can't be added as a prefix. Instead,
    compiler.path points at a shim directory where gcc/g++ are wrapped in
    ccache and every other tool is symlinked. -g makes ccache include the
    working directory in its key, so with --ccache the build root is a fixed
    run-ccache-<target> directory (cleared each run) instead of a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
2026-09-18 fix(teensy): blank C64 display across a Teensy self-reboot
    REBOOT is a bare Cortex-M MCU reset; the C64 keeps running through
    the ~ms it takes the Teensy to come back up, and can see garbage on
    the cartridge bus if it's mid-fetch at that instant. RebootTR() now
    asserts the C64's own /RESET first at all 9 real reboot sites.
    The large-CRT-to-MinimalBoot path (FileParsers.ino, RAM2 exhaustion
    mid-load) needed more: the glitch turned out to appear after the
    reboot, during MinimalBoot's reload of the same CRT, not during the
    transition. Fixed by DMA-writing $D011=0 (VIC-II blank) before
    rebooting, which survives the reset since it's C64-side hardware
    state. A 250ms assert-to-reboot delay, detach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
    [Common_Defs.h, FileParsers.ino, IOH_REU.c, IOH_TeensyROM.c, Min_RunTeensyApp.ino, MinimalBoot.ino]
2026-09-18 Document why the C64 main menu's compiled size gates SID compatibility
    MainCodeRAMEnd (the assembled end-of-menu address) is reported to the
    Teensy at runtime and checked against every SID's load address before
    playback -- overlap gets rejected outright. Confirmed with a real
    example: the YYZ SID couldn't play until Settings/Help were split into
    their own PRGs (0.8) shrank the resident menu enough to clear the
    conflict. Also fixes the Menu_Regs.i section, which still described the
    hand-duplication as unfixed after gen_menu_regs_i.py replaced it.
2026-09-18 Give PerformDMA()'s R/W and address-mode params named enums, not bare bool
    Named DMA_Trans_RnW (DMA_READ/DMA_WRITE) and DMA_Addr_Mode
    (DMA_ADDR_FIXED/DMA_ADDR_INCREMENT) replace bare true/false at every
    call site (~25 across FileParsers.ino, StatusFunctions.c, SerUSBIO.ino,
    IOH_REU.c) -- self-documenting instead of relying on the "true=read,
    false=write" comment at the definition.
    Both enums live in Common_Defs.h, not DMAControl.ino: IOHandlers.h
    (included from Teensy.ino before DMAControl.ino's own content is
    reached in the concatenated sketch) pulls in IOH_REU.c/StatusFunctions.c,
    which reference these identifiers -- defining them in DMAControl.ino
    would leave them undefined at first use,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
    [Common_Defs.h, DMAControl.ino, FileParsers.ino, IOH_REU.c, SerUSBIO.ino, StatusFunctions.c]
2026-09-18 Build: date the firmware with the HEAD commit's time, not a fixed instant
    SOURCE_DATE_EPOCH was pinned to Sep 5 2026, so every build showed that date
    and time. Taking it from the HEAD commit keeps rebuilds of a commit
    byte-identical (and ccache-friendly) while the date says which commit a hex
    came from. An existing SOURCE_DATE_EPOCH in the environment still wins, and
    outside a git checkout the build falls back to the current time.
2026-09-18 CI: pin CRC32 to 2.0.0, the version BuildInfo.md documents
    A bare 'lib install CRC32' takes whatever is newest (2.0.1 today), so a new
    upstream release could change CI output unannounced. 2.0.1's src/ is
    byte-identical to 2.0.0 (only docs and a library.json changed), so this
    doesn't change the built hex.
2026-09-18 CI: pin CRC32 2.0.1 and check build pins weekly for updates
    Moves the CRC32 pin to 2.0.1, the current release. Its src/ is byte-identical
    to 2.0.0 (only docs and a PlatformIO library.json changed), so the hex doesn't
    change; BuildInfo.md is updated to match.
    Dependabot can't see the CRC32, Teensy core, or arduino-cli pins (they're in
    run: lines and JS constants), so check-pins.yml runs tools/check-pins.mjs
    weekly. It errors if a pin moves or its copies disagree, skips releases listed
    as rejected (Teensy core 1.62.0, per BuildInfo.md), and keeps one tracking
    issue open while anything is outdated. Upstream has Issues turned off, so in
    that case the run fails with the report in its job summary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
2026-09-18 check-pins: treat the version lines in the docs as pins too
    BuildInfo.md (Teensyduino, CRC32), Build-System.md and CONTRIBUTING.md each
    state the pinned version. Listing them with the other pins means a bump that
    leaves one behind fails the check instead of leaving the docs stale.
2026-09-19 build: remove legacy Teensy build scripts, consolidate on build-firmware.mjs
    Build-DualBoot.ps1, Test-FlashHeadroom.ps1, and HexCombine.exe are fully
    superseded by tools/build-firmware.mjs: feature parity checked flag-by-flag
    (--target tr/tr-plus, --skip-*-build, --skip-combine), and the hex-combine
    port has already been verified end to end on real hardware for both targets.
    Remove Source/Teensy/tools/ entirely rather than leave a dead, confusing
    second build path in the tree.
    Relocate the pieces that don't belong to the old build itself:
    BootLinkerFiles/ (build-firmware.mjs has a hard dependency on this path,
    now updated to match), dma_scope_write.py and Clear-ArduinoCache.ps1
    (active dev/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
2026-09-19 Add settle delay to CheckLaunchSDAuto()'s DAT3 presence check
    The boot-time SD-autolaunch check read the DAT3 pin immediately after
    switching it to INPUT_PULLDOWN, with no time for the pull resistor to
    settle -- the same pattern PJRC found unreliable enough in their own SD
    library to fix with a dedicated commit (PaulStoffregen/SD@c535ae9,
    Teensyduino 1.60): reading a pin right after a mode switch can catch a
    stale/transitional voltage instead of the true line state. Adds the
    same delayMicroseconds(5) they used.
    Chasing that trail turned up a second, more consequential gap while
    reviewing SDFullInit()'s own comment ("This indicates zero regardless
    of actual prior to begin()"): SD.mediaPresen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
    [Teensy.ino]
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2026-09-20 build: add build-c64.mjs, one command for all C64 programs
    `npm run build:c64` regenerates Menu_Regs.i, assembles every project
    listed in tools/c64-projects.json, and writes the headers into
    Source/Teensy/TRMenuFiles/ROMs/. It replaces the 14 .bat files, works
    the same on Windows, macOS and Linux, and needs only Node (plus Java
    for TRCustomBasicCommands). Options: --project, --list, --verbose,
    --rom-dir. It stops at the first failure and names the project and
    file; there is no pause.
    All 17 committed headers reproduce exactly from source, so nothing was
    stale. v1541Wrapper and BASIC are now in the default build;
    BuildAllC64.bat skipped them, and their headers reproduce identically.
    The man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
2026-09-20 docs: explain running more than one TeensyROM over USB MIDI/ASID
    Since the USB MIDI name carries the chip ID, several TeensyROMs can be
    attached and told apart, but the user docs still said to pick "TeensyROM"
    and never mentioned multiple units. ASID_Player.md gets a short section on
    it, the source setup steps now show the TeensyROM-xxxxxxxx name, and
    MIDI_Usage.md's DAW step notes one track per unit.
    Also records a pitfall found while testing: ChipSynth C64 plugin instances
    inside one DAW share a single ASID output, so a second unit needs a
    standalone instance. That is a ChipSynth limitation, not TeensyROM's.
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2026-09-20 Packager: build a real module image from source
    tools/build-extension.mjs compiles module sources with the same ARM toolchain
    the firmware is built with, links them against vm/abi/module.ld, measures the
    sections, and writes the package. It reads its own output back through the
    firmware's own validation before writing it, so a packaging mistake fails at
    the desk rather than on the C64.
    Two things surfaced only once a real module went through a real compiler.
    GCC emits calls to memset and memcpy from ordinary C++ that never mentions
    them -- zeroing a struct is enough -- and a freestanding module has no libc to
    resolve them against. Every module author would hit this and solve it privately,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
2026-09-20 Client: the C64 half of hello world, and one command to build both
    Source/C64/VMHello is a reference client cartridge in ACME. It is an ordinary
    16 KiB EasyFlash image; the only thing that makes it a client is the VMH1
    descriptor the packager appends, which the firmware reads from the card and the
    C64 never sees.
    Three details of the link are worth recording, because none is guessable from
    the C64 side. The firmware maps every EasyFlash bank to the same 16 KiB, so
    selecting the agreed bank is a signal that opens the register window rather than
    a bank switch. The cartridge starts in Ultimax, so the ROMH bank holds the reset
    vector and a stub that switches to 16 KiB mode and hands back to the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
    [IOH_EasyFlash.c]
2026-09-20 build: third flash image for the extension host
    Adds `--with-extensions` to build-firmware.mjs. Off by default: without it the
    build produces exactly the two images it always has, from the stock linker
    scripts, and none of this runs.
    With it, the top 384K of flash (0x60280000..0x602e0000) is reserved for a third
    image and the two stock images are relinked beneath it. The extension image is
    the minimal sketch with VMBoot's own .ino and build profile swapped in -- a file
    copy, not code generation -- built with USB compiled out.
    Teensy 4.x has no supported "No USB" build (boards.txt has the menu entry
    commented out), so core 1.61 leaves two references to a USB it did not compile
    unguarded. Bo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
    [DriveDirLoad.ino, Min_RunTeensyApp.ino, Min_TeensyROM.h, VMBoot.ino]
2026-09-20 tools: flash firmware over USB, refusing a mismatched target first
    There was no script in the repo that puts a built image on an attached board;
    the only USB path was the Teensy Loader GUI by hand.
    The reason this is a tool and not a one-liner is the check it does before
    writing. A TR and a TR+ image both build cleanly and are not interchangeable,
    and today a --target tr hex was carried all the way to the cartridge before the
    firmware's own updater rejected it with "Verify file for TeensyROM+: Failed!".
    That check only happens after the file reaches an SD card. This compares the
    target string compiled into the hex against the banner the attached board
    reports, and refuses before anything is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
2026-09-20 Reserve the top of RAM2 and give a failed extension boot a reason
    The guest arena ran to 0x20280000, which is where Teensy's core keeps its
    CrashReport (top 128 bytes of OCRAM, 0x2027FF80). vm/hello writes
    guest_ram[guest_ram_bytes-1] as a deliberate both-ends check, so the
    reference module destroyed the crash report on every load, and profile 1's
    read-only constants covered the same bytes. Hold back the top 16 KiB:
    VM_RAM_BYTES becomes 496 KiB, and profile 1 keeps 80 KiB of constants
    instead of 96 (so it is now VM_PROFILE_RAM2_RO, not ..._RO96). 16 KiB is
    the MPU subregion size for that window, so it is the least that can be kept
    writable while the rest is write-protected -- and it has to s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
    [IOH_TeensyROM.c, Min_RunTeensyApp.ino, MinimalBoot.ino, Teensy.ino, VMABI.h, VMFail.h, VMHost.h]
2026-09-20 Stop the extension image bouncing every launch back to the main app
    VMBoot.ino kept MinimalBoot.ino's gate, which requires the boot indicator to
    read MinBootInd_ExecuteMin. But minimal consumes that indicator before it
    jumps -- deliberately, so a fault in the extension image cannot trap the
    cartridge in a relaunch loop -- so it always read MinBootInd_FromMin here
    and every extension launch went straight to runMainTRApp(), never reaching
    VMHostBoot(). From the C64 that is indistinguishable from a failed
    extension: the screen clears, the image swap flickers, the menu returns.
    The "@VM1" marker is what says this image was entered on purpose, and it
    is not consumed by minimal, so gate on that a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
    [VMBoot.ino]
2026-09-20 VMHello: run the 16 KiB mode switch's tail from RAM
    The Ultimax reset stub wrote $DE02 and then jumped to the KERNAL from ROMH.
    The instant $DE02 latches, ROMH leaves $E000 and the KERNAL appears there, so
    the jmp was never fetched: execution fell into the KERNAL's RS-232 timer code
    at $FF0A and returned through a freshly reset stack. The screen was never
    cleared and nothing was drawn. Copy the three-instruction tail to $0100 and
    run it there, which is mapped in both modes.
2026-09-20 vm/abi: document the C64 client and failure record, record what has run on hardware
    The spec said none of it had run on hardware. The launch path, module loader
    and client link now have, so say which parts, and which parts have not
    (input records, quiet, profile 1, PAL).
    Add the C64 client contract an engine author needs: the IO2 register map,
    packet framing and CRC, the input record and its checksum, and the Ultimax
    reset stub, whose mode switch has to run from RAM. Add the failure record and
    its codes.
2026-09-20 build-firmware: remove the private build root after a successful build
    Every run copies the Teensy core into build/firmware/run-XXXXXX and nothing
    ever removed it, about 400 MB per build (6.9 GB accumulated here). Remove it
    on success. A failed build keeps it, since its logs are the point, and so does
    --skip-combine, whose per-image results exist only there; --keep-work keeps it
    unconditionally.
    Also update the manifest test's project count for VMHello.
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2026-09-20 firmware: refuse the module paths the loader cannot follow
    VmRegistry::absolute read s[0] before anything else, so a module calling
    open(nullptr) or renaming to a null destination had its null dereferenced
    rather than refused. The native conformance host in vm/tests/native_host.h has
    always rejected it, so the gap only showed on the cartridge, where the
    extension image has no USB and a fault costs the failure record as well. Adding
    the guard to the shared predicate covers openFlags, fileOp's path and
    destination, readManifest and consume at once; files_test now passes a null
    path, and removing the guard again ends that test in SIGSEGV.
    VmFsOp values above Space fell past both range checks a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
    [VMFiles.h, VMRegistry.h]
2026-09-20 VMBoot: come back to the menu, not to the autolaunch
    setup() writes MinBootInd_SkipMin early so a lost power cycle does not relaunch
    the extension. RebootTR() is a raw MCU reset and leaves that value in place, so
    both escape routes -- a failed VMHostBoot() and the menu button while a module
    is running -- came back up looking to the main image like an ordinary cold
    start, which runs the user's autolaunch instead of showing the menu. The button
    in particular is how someone asks for the menu.
    Both now leave MinBootInd_FromMin behind first, which is what
    runMainTRApp_FromMin() does for the same reason. Unverified here: it needs a
    cartridge with an autolaunch configured.
    [VMBoot.ino]
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2026-09-20 firmware: bound how often a failed extension launch interrupts the menu
    VmFail::report() goes through SendMsgSerialStringBuf, which blocks up to three
    seconds waiting for the C64 to answer rsContinue. If the C64 is not in a
    WaitForTR* loop when the polling handler fires, the attempt times out, the
    caller does not clear, and the next poll with queued work tries again -- each
    attempt bounded, the number of them not.
    Count the attempts in VmFail and give up after three, noisily on the Teensy's
    USB serial. The bound goes here because SendMsgSerialStringBuf carries every
    other message in the firmware.
    vm/tests/fail_test.cpp drives report() against a C64 that never answers.
    Disabling the give-up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
    [VMFail.h]
2026-09-21 firmware: reload the menu's listing after a remote file command changes it
    PostFile, CopyFile and DeleteFile left the loaded SD/USB listing -- and the
    extension table LoadDirectory builds with it -- showing the card as it was
    before the write, until the user navigated away and back.
    The command only arms the rebuild; HandleExecution performs it. LoadDirectory
    prints to Serial, which is CmdChannel, and these commands answer in bare
    2-byte tokens. And the C64 selects by an item number against a page it painted
    itself, so the rebuild refuses the launch that triggered it rather than resolve
    that number against a different list -- a refused launch is what routes the C64
    through MainMenu.asm's Li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
    [DriveDirLoad.ino, FileTransfer.ino, LoadedListing.h, RemoteControl.ino, Teensy.ino]
2026-09-21 firmware: fix the main image build after the listing-reload change
    LoadDirectory(LoadedDevice == rmtSD ? &SD : &firstPartition) does not compile:
    the operands are SDClass* and USBFilesystem*, which have no common pointer type
    without a cast. StatusFunctions.c reaches the same two-way choice with an
    if/else for that reason.
    [DriveDirLoad.ino]
2026-09-21 vm/abi: lend profile 0 the whole of RAM2
    Profile 0 now hands the module 524288 bytes -- the physical end of RAM2 --
    rather than holding back the top 16 KiB. Profile 1 still holds it back, because
    it write-protects its constants in MPU subregions of that size and protecting
    the top one would fault the core's crash writer, so the reserved span is now a
    property of the profile rather than of RAM2.
    That puts the loader's failure record inside the guest arena, which forces two
    changes. The record moves to a fixed 0x2027ff60, below Teensy's CrashReport,
    instead of being derived from the arena top: one address whatever the profile.
    And the clean hand-off is stamped before vm_entry is called rather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
    [VMABI.h, VMFail.h, VMHost.h]
2026-09-21 firmware: tell the menu apart from a guest that faulted in vm_entry
    Stamping Ok before the entry call, as the previous commit does, means a module
    that faults inside vm_entry leaves Ok standing where it used to leave minimal's
    Entered ($01). capture() suppresses Ok, so the menu said nothing about a crash
    it used to report -- the wrong direction for a failure mode.
    The core's CrashReport separates the two: it is valid after a fault and absent
    after a clean hand-off. promoteFault() rewrites a valid Ok record as Faulted
    ($03) and runs in the minimal image, because printing the report is what clears
    it -- CrashReportClass::printTo ends in clear() on every path -- and minimal
    prints it at setup(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
    [MinimalBoot.ino, VMFail.h]
2026-09-21 vm/abi: record the fault and top-of-RAM2 runs on hardware
    On a TR+ in an NTSC C128 running the build at HEAD, two rows in §10 move from
    no to yes and one qualified yes is re-verified at the record's new address.
    A module executing `udf #0` inside vm_entry brings the main image back printing
    "Extension boot: extension faulted (code $03, detail $0)", reproduced twice. A
    second module filling the top 128 bytes of the arena -- the CrashReport span,
    not the 32-byte record below it -- and returning normally comes back as $00, so
    that fill was not promoted to $03. Both records were read at 0x2027ff60.
    The single observable in each run is the line the main image printed over USB
    serial; what the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
2026-09-21 firmware: print the crash report where it can be read
    Every image printed `CrashReport` at the top of its setup(), and printing is
    what clears it. The reset after a fault lands in minimal, which printed it
    before USB had enumerated, so the bytes went nowhere and the report was gone by
    the time the main image looked. Confirmed on a TR+: a module faulting inside
    vm_entry produced $03 -- which needs a valid report at promoteFault() time --
    with no report anywhere in the serial output.
    Minimal now reads the report's validity and leaves it alone, and the main image
    prints it at the end of setup(), next to VmFail::printBoot(), which was already
    placed there for this reason. The same run now print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
    [MinimalBoot.ino, Teensy.ino, VMBoot.ino, VMFail.h]
2026-09-21 firmware: refuse a launch the installed host cannot serve, before rebooting
    Launching an extension commits an EEPROM one-shot and reboots into an image
    with no USB, which can only explain itself through the 32-byte record. Anything
    knowable before that should be decided before that.
    The extension image now carries a VmHostId at a fixed 0x60280800, in the 0xFF
    fill between the FlexSPI config block and the image vector table, so it costs
    no image space. It holds the host's ABI, its providedServices and a name for
    the message. tryLaunch reads it out of flash and refuses three cases on the
    menu instead of after the reboot: no image installed at all, a host built
    against a different ABI, and a m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
    [VMABI.h, VMBootImage.h, VMHost.h, VMRegistry.h]
2026-09-22 docs: publish NTSC C128 DMA write-fault findings, reorganize debug tools
    Swapping the C128's U55 bus transceiver (74F245 -> 74LS245) resolves
    the intermittent DMA write fault seen on two independently-tested
    boards. Write up the investigation as a public summary, plus the full
    experiment log and known-issues updates behind it.
    Move the debug scripts (dma_scope_write.py, run_z_sweep.py) into
    tools/Debug/, and prefix the build launchers with an underscore to
    keep the two apart.
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2026-09-22 vm/abi: cut three claims the tree cannot check
    §1 pinned the 76-byte base to offsetof(VmHost, video_present) in a
    header that is not in this repository, so a reader here has no way to
    confirm it and no way to notice it going stale. The rule the section
    teaches -- check bytes >= VM_HOST_BASE_BYTES -- stands on its own.
    §8 quoted vm/hello at 776/32/192 bytes. Those come out of whichever
    arm-none-eabi-g++ resolvePrefix() found, and nothing compares them
    against anything; build-extension.mjs prints the live figures.
    §10 opened with an absence claim over every row of the table above it.
    The sentence after it is the one that informs.
2026-09-22 firmware: let a fault raised from input() or ack() reach the client
    host->fail() writes $E0 to $DFF5 and the code to $DFFB, and VMHostPoll
    then wrote the status register twice more before it looked at failure:
    once after ack(), once before pump(). A module calling fail() from
    input() or from ack() had its $E0 replaced by $02 in the same turn, and
    was called again afterwards. Every later poll leaves at the failure
    gate without touching $DFF5, so $02 is what the client reads from then
    on -- it never sees $E0, never reads the code, and waits forever.
    A fault from pump() and from packet() already survived, because nothing
    writes $DFF5 after them; that is why the malformed-packet cases pass.
    sc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
    [VMHostPoll.h]
2026-09-22 firmware: stop a remote delete dereferencing a missing storage device
    GetStorageDevice returns nullptr when SD.begin() fails, having already
    sent FailToken. DeleteFileCommand sent a second one and then fell
    through into DeleteFile(filePath, *sourceFS). The other four call
    sites all read `if (!sourceFS) return;`.
    The dereference predates this branch, but the line holding it is one
    the listing-reload change rewrote.
    [FileTransfer.ino]
2026-09-22 VMHello: print the failure code beside the message, not over it
    "extension failed " is 17 screen codes, columns 0..16, and showCode
    wrote its two hex digits at columns 14 and 15 -- the "ed" of "failed".
    The bottom line read EXTENSION FAIL20. Columns 17 and 18 are the blank
    the message's trailing space leaves for them.
    README §10 has this path as not run on hardware, which is how it got
    here; it is still not run.
2026-09-22 tools/bench: scripts for driving a TeensyROM from the host over USB serial
    Reflash without the program button (SD push + remote launch + the C64's Y/N
    answered by DMA), push files, launch, peek the C64's memory, read the screen,
    queue a keypress, and launch an extension and report how it ended. They share one
    small serial library and are covered by tests against a fake board on a pty.
    These replace a set of one-off scripts that each carried its own copy of the
    port code and a hardcoded device name.
2026-09-22 tools/bench: name every wire value once, and check it against the firmware
    The scripts carried byte strings inline -- b'\x64\xDE' for a directory listing,
    b'\xcc\x64' for an Ack -- and the fake board in the tests carried its own copy
    of each. Two copies of a wire value is how they drift, and neither copy says
    which firmware constant it came from.
    protocol.py now holds every value that goes on the wire and c64.py every
    machine address, each named as the firmware names it. test_protocol.py reads
    those names back out of Source/Teensy/ and fails if any pair has drifted, and a
    second test fails if protocol.py grows a value that mapping does not cover. The
    fake board keeps its own byte-order enco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
2026-09-22 tools/bench: ask the board which image is running, list, and reset
    Three commands the firmware has always answered and nothing here used.
    FWCheckToken is the designed way to tell the main image from the minimal one,
    and both answer it whatever else they are doing; probe.py now asks it instead
    of sending 'b' and reading the reply, which could not tell the two apart and
    depended on a debug command minimal does not have. It reads past anything the
    board says unprompted -- IOHandlers.ino:51 prints a line whenever a handler
    loads, which is exactly what a reset or a launch causes -- and still treats
    silence as the extension image or a hung board, exiting non-zero.
    ls.py closes the loop after pus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
2026-09-22 menu: put the gateway and the subnet mask under their own labels
    Pg_InfoOther.asm prints "IP Address", "Gateway IP" and "Subnet Mask" down
    rows 5-7 of the General info page, but asked the firmware for the address,
    the mask and the gateway in that order, so the last two values appeared
    under each other's labels. On a TR+ holding 172.16.1.233/24 via
    172.16.1.1, the page read "Gateway IP: 255.255.255.0" and
    "Subnet Mask: 172.16.1.1".
    The firmware side is right -- StatusFunctions.c returns what each token's
    name says -- so this swaps the two requests rather than the labels, whose
    order already matches the Ethernet config page.
    Regenerating SettingsMenu.prg.h exchanges two immediate operands, 0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
    [Pg_InfoOther.asm]
2026-09-22 tools/bench: check a reflash against the hex it pushed
    Answering the C64's Y/N prompt is the step that silently does nothing when the
    screen is not what fwupdate expects. The board then keeps running the old
    firmware, the updater's serial output never appears, and nothing said so: the
    symptom is a board that looks flashed and is not.
    hexfile.py decodes the Intel HEX records, takes the region the main image
    links into, and pulls GCC's __DATE__ and __TIME__ out of it. That pair is the
    second line of the version banner, so fwupdate can read the banner back after
    the reboot and compare it with the stamp in the hex it pushed.
    The stamp alone would not be enough. This build pins SOURCE_DATE_EPOC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
2026-09-22 tools/bench: find the board on Linux, where it is not a cu.usbmodem
    The README says macOS or Linux and the scripts use only termios, but port
    discovery globbed /dev/cu.usbmodem*, which is a BSD name. On Linux a Teensy
    comes up through the CDC-ACM driver as /dev/ttyACM*, so find_port found
    nothing and said so by naming a pattern that does not name a Linux node.
    Three of those sentences also said the port name tells the three images apart.
    The macOS node carries the USB serial number, which is what makes that work;
    the sentences now say so rather than claiming it of every platform.
    The tests did not catch it because they set TR_PORT to a pty they made, which
    skips discovery entirely. The new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
2026-09-22 ci: run the tool and bench tests in a job that has the assemblers
    build-c64.test.mjs reassembles the C64 projects and byte-compares the result
    against the committed ROM headers, which is the only thing that catches a
    .asm change landing without its regenerated .prg.h. It skipped in CI, because
    it skips when ACME is not on PATH and no job installed one. It also named
    three projects of the twelve.
    The new tools job installs ACME and runs both suites: npm test, which now
    asserts rather than skips when CI is set, and the Python bench tests, which
    nothing ran before. The project list comes from loadProjects, less the one
    project KickAssembler builds, so a project added to the manifest is covered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
2026-09-22 tools/bench: bound the serial write and report a missing local file
    wr() retried os.write on BlockingIOError with no deadline, while rd, drain,
    stream and reconnect each carry one. Against a pty nobody reads, a 4 MB write
    was still spinning at 20 s; a no-progress bound turns a board that has stopped
    draining its endpoint into "board stopped reading after 1024 of 4194304 bytes"
    at 30 s. The bound is a `wr` argument so a test can use a short one.
    post() opened the local file bare, so push.py on a missing path printed a
    FileNotFoundError traceback where every other user error in these scripts is a
    one-line SystemExit.
    petscii_row's docstring claimed letters survive. Screen codes 65-90, which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
2026-09-22 fix(teensy): correct MIDI channel off-by-one in USB<->ACIA bridge
    PJRC's Teensy MIDI libraries hand callbacks a human-facing channel
    (1-16) and expect the same on send(), doing the +-1 conversion to
    the wire nibble (0-15) internally. IOH_MIDI.c was packing/unpacking
    that value as if it were already the raw nibble, shifting every
    inbound channel up by one (and corrupting channel 16 into a
    different message type via nibble overflow) and every outbound
    channel down by one.
    retrodal reported the symptom across Cynthcart, SID-Wizard, and
    Station64 — all fixed-channel MIDI-in landing one channel off from
    Omni. Thanks for tracking it down.
    [IOH_MIDI.c]
2026-09-22 docs: close resolved DMA timing items after the U55 chip-swap fix
    The PHI2/MMU-arbitration theory, the te445 assert-point validation,
    the residual write fault, and the connector-pressure characterization
    are all settled by this week's decisive finding: swapping U55
    (74F245 -> 74LS245) fixes the C128 write fault on two independent
    boards. Move #6, #14, #15, and #16 to Closed with dated notes tying
    each back to that result.
2026-09-22 Add a page slot for Installed Extensions to the C64 SettingsMenu
    TR+RFE (Runtime Firmware Extensions) Phase 3 needs a place to list
    installed extension slots and uninstall them, but SettingsMenu was
    already full: 9 pages using keys '1'-'9', with the jump logic in
    CheckCommonKeys() being arithmetic on a contiguous ASCII/PETSCII run
    starting at '1' rather than a lookup table, so it can't extend past
    '9' without landing on the wrong key. Bumping NumPages alone would
    have quietly mapped the 10th page to ':' -- the character right after
    '9', not any digit.
    Add key '0' as its own explicit branch instead: it's the next key on
    the physical row and was completely unused. The digit-arithmetic
    branch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
    [Pg_Index.asm, Pg_InstalledExt.asm, SettingsMenu.asm, SupportFunctions.asm]
2026-09-23 firmware: route the extension launch reboot through RebootTR()
    VmRegistry::tryLaunch() hand-inlined SetResetAssert;delay(20);REBOOT;
    instead of calling RebootTR(), the shared macro every other reboot
    call site already uses. Same net effect, but this one site would
    silently miss any future change to RebootTR() itself. Common_Defs.h
    (where it's defined) is already included ahead of anything that can
    reach VMRegistry.h, in both the main image (via Teensy.ino) and the
    extension host (via VMBoot.ino), so no new include is needed.
    [VMRegistry.h]
2026-09-23 vm/tests: shim RebootTR() for the native host conformance suite
    d937355 switched VmRegistry::tryLaunch()'s reboot to the shared
    RebootTR() macro, but that macro only exists in the real firmware
    headers -- vm/tests/ compiles VMRegistry.h against fake_sd.h's own
    lightweight shims instead, which had REBOOT and SetResetAssert but
    not the macro composing them. Broke npm run verify:extensions in CI
    (files_test: 'RebootTR' was not declared in this scope).
    Shimmed the same way the file already shims everything else: as a
    macro built from the two pieces already there, not a new standalone
    function, so it can't drift from what the real one actually does.
2026-09-24 Added Dual Cart + REU IOhandler
    * Added long/short button press support to IOH_RetroReplay
    [IOH_FinalCartridgeIII.c, IOH_RetroReplay.c]
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2026-09-24 docs: note case button access and USB-power safety for updates
    Raised while reviewing a firmware-update recovery proposal: neither was written down for users. Recovery doesn't require opening the case (a paperclip access hole reaches the button), and leaving the C64 powered during a USB update is safe by hardware design, not just tolerated.
2026-09-24 docs: close remaining DMA timing items resolved by the U55 fix
    Items #3, #4, and #6 close: the U55 F245/LS245 swap explains the partial-byte failure band as a C128-only hardware effect (U55 has no C64 equivalent), settling the earlier NTSC/PAL-vs-C64/C128 confound the same way. Item #2 (PAL branch unverified on real PAL hardware) stays open, reorganized under its own Validation section.
2026-09-25 tools: flash from Windows
    flash-firmware.mjs only worked on macOS and Linux. On Windows the Teensyduino
    tools carry an .exe suffix, teensy_ports lists COM ports instead of /dev paths,
    and a COM port cannot be read as a file with a deadline.
    teensyTool() now resolves the .exe, findBoard() matches COMn and keeps the
    teensy_ports USB location, and the Windows write goes through
    teensy_post_compile -reboot, so a TR+ needs no button press. The tool then
    waits for the board to leave serial, come back and answer. The macOS/Linux
    path is unchanged.
    Not final: exchangeWindows() still runs the port exchange through
    PowerShell's SerialPort. It should move to plain Node before this goes
    anywhere.
2026-09-25 Added extern uint8_t CurrentIOHandler; to fix compile error
    [IOH_RetroReplay.c]
2026-09-27 Extension host: install and uninstall a host in a slot at the top of flash
    A 384 KiB slot at 0x60760000, inside the TR+ updater's reserve (FLASH_RESERVE
    grows to 640K with the loader built in), so a firmware update never stages into
    or erases it. No firmware hex carries a host: --target tr-plus builds the stock
    host and packages it beside the hex as TeensyROM+_<ver>_VMBoot.TRH, and CI
    fails if any byte of either target's hex reaches the slot.
    - TRH1 package format and the installer: every check runs before anything is
    erased; the tag is cleared first and written last.
    - Uninstall erases the whole slot, over USB serial (device port only) and from
    Settings -> Installed Extensions, which a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
    [Common_Defs.h, DMAControl.ino, DriveDirLoad.h, DriveDirLoad.ino, FileParsers.ino, FlashUpdate.ino, IOH_TeensyROM.c]
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2026-09-27 Extension host: let a module exit to the menu (VM_SERVICE_EXIT)
    The extension image has no USB and the module table has no "done" callback,
    so a running module could only be left by faulting or by the reset button.
    Service bit 14 adds the first tail extension, VmHostExit (80 bytes,
    static_asserted): exit_to_menu(status) records VmFail::Exited ($04) with the
    status as its detail and reboots into the menu, where the main image prints
    the record.
    vm/hello takes it on joystick-2 up where the host lends both the bit and the
    tail, and the native tests cover all four combinations of the two. The bench
    counts "module exited" as a normal finish of a launch.
    [VMABI.h, VMFail.h, VMHost.h]
2026-09-27 Extension host: build a third-party host into the slot (--host-sketch)
    --host-sketch <dir> overlays that directory onto the MinimalBoot sketch in
    place of Source/Teensy/VMBoot, which is how the stock host is built too, and
    writes TeensyROM+_<ver>_<dir>.TRH and no firmware hex: a third-party host
    installs onto a board running the stock firmware. Every way the directory can
    be wrong is refused before the first compile, and so is the flag where there
    is no slot to build into.
    - Source/Teensy/ExampleHost, a complete host that does nothing, and
    docs/Architecture/Extension-Hosts.md, which walks through what it owes the
    loader. CI builds it and checks the name in its descriptor.
    - VmFail::Host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
    [Min_TeensyROM.h, VMFail.h]
2026-09-27 --host-sketch: pass over hidden entries; drop a stale line number from the ABI README
    A host kept in its own repository has .git/ at its sketch root, and the
    files-only check refused every build of it. arduino-cli compiles nothing in a
    hidden entry, so skipping one drops no source.
    vm/abi/README.md cited VMRegistry.h:133 for the services refusal; that line
    is now 140. Named by what it is instead.
2026-09-27 tools: catch a C64 menu row that fills all 40 columns before a return
    Printing into column 39 makes the screen editor advance to the next row by
    itself and link the two rows into one logical line, so a ChrReturn after it
    skips a row and leaves a blank one on the screen. The source reads fine; the
    hole only shows on a real screen.
    tools/lib/c64-screen.mjs models the part of CHROUT that moves the cursor
    (printable characters, CRSR left/right, clear/home, quote mode) and measures
    rows between returns rather than !tx lines, since a row can be built from
    several directives and colour codes cost no columns. The test runs it over
    every C64 source and fails on any row that fills all 40 columns exce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
2026-09-27 Build the USB side's build info in its own buffer, not the C64's
    VersionInfoToken, SerUSBIO's 'f' and the boot banner built the build info
    into SerialStringBuf, which the C64 reads a byte at a time from the ISR --
    directory names are copied into it for that. On the bench TR+, paging a
    113-page SD directory while a host sent VersionInfoToken every 4 ms put
    build info into the file names on 40 of 40 redraws, spliced in at the
    offset the name's read had reached. That predates this branch; the
    redirect fixed in the previous commit was the other half.
    MakeBuildInfo now builds into a buffer its caller passes. Only
    MakeBuildInfoStr, the C64's handler, passes SerialStringBuf; the USB
    callers build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
    [SerUSBIO.ino, StatusFunctions.c, Teensy.ino]
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2026-09-28 hostuninstall: say the slot was blank only when the C64 does
    Firmware without the extension loader declines a menu removal without
    rebooting as well, and says so on the C64. hostuninstall.py reported that as
    a slot that was already blank, and hostops.remove_host's docstring said
    rebooted=False meant the same.
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2026-09-28 runVMApp: reboot through RebootTR, not a bare REBOOT
    If an extension image's entry point returns, runVMApp reset the Teensy
    without first asserting the C64's /RESET, which Common_Defs.h says to use
    RebootTR() for and runMainTRApp in the same file already does. It was a
    bare REBOOT on main before the extension-host work too.
    [Min_RunTeensyApp.ino]
2026-09-28 tools: flash one board among several, --all, --help; no PowerShell
    flash-firmware.mjs took the first Teensy it found, and teensy_post_compile
    given -port alone falls back to auto-search when two boards are attached, so
    with a TeensyROM and a TeensyROM+ both plugged in one of them could be
    rebooted and written with the other's image.
    - Every attached board is identified, including its chip ID. The board to
    write is the one named by --uid or --port, else the only board attached,
    else the one board whose type matches the image; anything ambiguous is
    refused with the boards listed.
    - The write passes the board's whole address (-port, -portlabel,
    -portprotocol), as the Arduino IDE does.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
2026-09-28 tools: flash-firmware fixes from review
    - On Windows, any failure after a write has started now closes the Teensy
    Loader too, so a later press of a program button cannot write the image
    again (it was closed only on success and on STOPPED).
    - On Windows, a missing Teensyduino is reported as such, instead of as "No
    Teensy found on USB".
    - On macOS and Linux without teensy_ports, only the first serial device is
    opened, as before; probing every one could reset an unrelated board and
    make a silent one block the run.
    - --help lists the board choice in the order the code applies it, and its
    examples no longer name one firmware version.
    - The --all build-date warning considers only the i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
2026-09-28 docs: a build skill for building and flashing, linked from the build docs
    .claude/skills/teensyrom-build/ is a short overview of the build (what to
    run, in what order, what needs rebuilding after which change) with one
    reference page each for the C64 build, the firmware build, flashing, and
    tests and CI. It is plain Markdown, so it reads the same without Claude
    Code. Build-System.md, Overview.md, BuildInfo.md and CONTRIBUTING.md link
    to it; Build-System.md is otherwise unchanged.
2026-09-28 tools: flash-firmware: a stricter check after writing; the /dev fallback across a reboot
    From the PR review:
    - A reply without the build date now fails the check when the image has one.
    The firmware prints the date with its version, so a missing one means a
    reply read short or other firmware than the image's.
    - A reply without a chip ID fails when the image's firmware prints one, even
    when the board's ID was not known before the write (in the bootloader,
    silent, or running firmware too old to print one).
    - A short reply is asked for again, within the same 20 s, before the check
    fails.
    - On macOS/Linux without teensy_ports, the one device found after the write is
    the written board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
2026-09-28 fw: bound the DMA handshake waits, so a bus that stops clocking cannot hang the board
    PerformDMA and CloseDMA spun on DMA_State with no exit, so a C64 that still
    supplies 5 V but has stopped clocking (a fault, or the moment around the power
    switch) hung the Teensy for good. WaitForDMAState now gives up when LastCycCnt
    stops moving for DMA_QUIET_mS, or at a ceiling while the bus is still clocking
    (50 mS for the handshake, scaled by length for the transfer), and AbortDMA
    puts the bus back with a bound of its own. Both return bool.
    Callers that report a result check it: the USB Read/WriteC64Mem commands
    answer FailToken instead of acking, and a read no longer returns RAM_Image's
    stale contents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
    [DMAControl.ino, FileParsers.ino, IOH_REU.c, SerUSBIO.ino, StatusFunctions.c]
2026-09-28 fw: check the DMA result everywhere it is used, and close the abort race
    WaitForDMAState re-read DMA_State before aborting, but AbortDMA then wrote
    StartDisable a few instructions later, and isrPHI2 could complete the
    transfer in between -- a USB write that landed was answered FailToken.
    AbortDMAUnless(Target) now takes the check and the StartDisable write
    together with interrupts masked.
    The remaining callers that read a value through PerformDMA now check it:
    the ExpPortDMA walking/cascading-ones tests (through ScreenDMA, shared with
    TestDMAPage), the buffered REU path (Fault instead of Complete, no
    write-back of an unread buffer; not compiled while Direct_REU is defined),
    and the Dbg_SerD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
    [DMAControl.ino, FileParsers.ino, IOH_REU.c, SerUSBIO.ino, StatusFunctions.c]
2026-09-28 fw: bound what the C64 and the card can write into firmware buffers
    Existing defects on main:
    - Menu selections: the page and item registers the C64 writes became
    SelItemFullIdx, and MenuSource[SelItemFullIdx] was read unchecked from the
    ISR and the main loop. MenuIdxFromRegs and MenuItemSel bound every such read,
    and SetMenu replaces MenuSource and the item count together, so the ISR never
    sees a count that belongs to the previous menu.
    - IO1 reads: a string or stream read past its end, an out-of-range IO handler
    index, or an unknown string selector now returns 0 or a "?" marker instead of
    reading whatever follows. The status dispatch also skips an empty
    StatusFunction[] entr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
    [DriveDirLoad.ino, FileParsers.ino, IOH_EasyFlash.c, IOH_TR_BASIC.c, IOH_TeensyROM.c, IOHandlers.ino, MeatloafComm.ino, Min_DriveDirLoad.ino]
2026-09-28 fw: refuse incomplete names and paths, shut the menu before freeing it
    Review fixes on top of ea483c5.
    - TR BASIC file name: 255 characters plus the NUL (BASIC's longest string)
    fill LSFileName exactly and were rejected. The buffer is now calloc'd,
    kept terminated after every byte, and a name is usable only once its NUL
    lands inside it; a sender that stops without one is refused before
    FSfromFileName reads the buffer, instead of strlen/open walking past it.
    - InitDriveDirMenu and FreeDriveDirMenu close the menu (CloseMenu, shared
    with SetMenu) before freeing names the current menu points at.
    RemoteLaunch clears the drive listing only in the branch that rebuilds
    it, so a "No TR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
    [Common_Defs.h, DriveDirLoad.ino, IOH_TR_BASIC.c, IOH_TeensyROM.c, MeatloafComm.ino, RemoteControl.ino, StatusFunctions.c, Teensy.ino]
2026-09-28 fw: refuse paths that outgrow DriveDirPath, bound the D64 directory walk
    Review fixes on top of 6cc994e.
    - DriveDirPath is MaxPathLength. Opening a card directory (names reach 255
    characters), a D64/71/81 image, or a built-in directory now checks that the
    name fits before appending it, and refuses with a message instead of
    running off the end.
    - RemoteLaunch refuses a path that does not fit DriveDirPath before changing
    anything; the USB/TCP launch command accepts up to MaxNamePathLength and a
    browser "lcl:" link joins onto the download path. It splits the path in a
    local copy and publishes DriveDirPath only once the launch goes ahead, so a
    "No TR Dir"/"No TR File" return leave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
    [D64.ino, DriveDirLoad.ino, FileParsers.ino, MinimalBoot.ino, RemoteControl.ino, VMBoot.ino]
2026-09-28 docs: reconcile Known-Issues.md with the bounds fixes in ea483c5..a02cdef
    nfcReadTagLaunch's TagData overflow, DriveDirPath's two normal-use
    overflow paths, IOH_TR_BASIC.c's LSFileName/RAM_Image ISR writes, and
    LoadDxxDirectory's unbounded chain walk were all still listed open;
    each is now bounded and refused rather than truncated, so move them
    to a dated "Fixed since last summary" entry and update their own
    detail sections instead of leaving stale "deferred" statuses next to
    the code that closed them.
2026-09-28 build: link the stock extension host in 64 KiB of ITCM
    The host's SdFat, SD and SPI code now runs from flash, which takes the
    stock host from 88,008 to 56,216 bytes of ITCM and lets the link hold it
    under 0x10000. That frees 0x10000-0x18000 for a larger module window.
    This carries the --host-code-kib 64|96 option from the still-open PR #43,
    with the default inverted: 64 KiB for every host, and 96 KiB only for a
    third-party --host-sketch host that needs the room.
    The only flash writes in the image are the core's EEPROM emulation, which
    masks interrupts while it programs, so the SDIO completion handler moving
    to flash cannot run while flash is busy.
    [VMHostABI.h]
2026-09-28 build: match the flash-resident libraries on Windows paths too
    ld compares object paths character for character, and arduino-cli writes
    them with backslashes on Windows. There the slash-only patterns matched
    nothing, so SdFat, SD and SPI stayed in ITCM and the 64 KiB assert failed
    the link. The test now checks what the patterns match, on both separators.
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2026-09-29 fw,c64,docs: make the TR+ REU with RetroReplay/FC3 101% a setting
    PR #36 paired the TR+ REU with every RetroReplay CRT and every FC3 101%
    (subtype 1) CRT through an if (true) placeholder, with no way back to the
    plain handlers. Bit 6 of rwRegPwrUpDefaults3 (rpud3FreezerREUDisable) now
    decides it: 0, the default and what existing EEPROMs already hold, keeps
    the REU; 1 launches those carts on their plain handlers, which also makes
    plain RetroReplay's NOFREEZ handling reachable again.
    'g' on Config: TeensyROM General toggles it, saved like the other power-up
    defaults. The dormant IO1 read test that sat on 'g' behind EnIO1ReadTest
    is removed; the Expansion Port test replaced it. General_Usage.m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
    [FileParsers.ino, Menu_Regs.h, Pg_TRSettings.asm, Teensy.ino]
2026-09-29 fw: time the freeze button's long press with the cycle counter
    SpecialBtn_FreezeCRT_REU timed the press with millis(), but an REU
    transfer runs inside isrPHI2, which outranks SysTick, so millis() stops
    for the length of every transfer. Under steady REU traffic a held button
    read as short and froze instead of saving the REU. Time it with
    ARM_DWT_CYCCNT, which keeps counting inside the ISR, and keep millis()
    as a backstop for holds past CYCCNT's ~5.3 s wrap at 816 MHz: millis()
    only ever under-counts, so either one reaching 700 ms is a long press.
    The press state was function-static and never reset, so a press whose
    release went to another handler could turn the first release after a
    later RR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
    [IOH_FinalCartridgeIII.c, IOH_RetroReplay.c]
2026-09-29 fw: preload the part of an oversized REU image that fits
    InitHndlr_REU skipped the preload whenever the REU image was larger than
    the REU it had just allocated. The REU now comes up anywhere from 128K
    to 512K depending on free RAM, so a 512K image saved in a plain REU
    session loaded nothing into a RetroReplay/FC3 101% session that only got
    256K. Load the first REU_Size bytes instead; that's all a smaller REU
    can address.
    The preload also reads each 8K bank in one call instead of a byte at a
    time, and stops at the last bank even if a read fails.
    [IOH_REU.c]
2026-09-29 fw: include the FC3 101% + TR+ REU handler in the freezer shortcut
    SetTypeFromCRT's freezer shortcut sets up SSv5 and plain FC3 CRTs
    without reading the header's EXROM/GAME bytes, but it didn't list
    IOH_FCIII_101_REU. A subtype 1 (101%) CRT fell through to the generic
    rules, where 16K chips only match with EXROM=0/GAME=0, so one with the
    1/1 header common on FC3 CRTs failed with "HW config unknown" while
    loading fine with the TR+ REU setting off. General_Usage.md says only
    subtype 1 CRTs get the REU, and setting that byte by hand in a 1/1 CRT
    was enough to break it.
    0/0 CRTs, like the official 101% release, now start as rtBin8kLo like
    every plain FC3 launch instead of rtBin16k. InitHndlr_Fi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
    [FileParsers.ino]
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2026-09-29 abi: a second module code base, admitted by the host's own code floor
    A module may link its code at 0x10000 instead of 0x18000, taking a 128 KiB
    window instead of 96 KiB. The validator, the copy, the module table and the
    MPU all take the base from the image header, and every bound is measured from
    the image's own base rather than a fixed one.
    Whether a given host can take the lower base is a fact about that host's link,
    not a capability it implements, so it travels as a number rather than a service
    bit: VmHostId's spare word becomes code_floor, the lowest base the host can
    accept. VM_HOST_CODE_FLOOR resolves to the link's own __exidx_end, so the
    descriptor cannot claim room the host occupie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
    [Min_TeensyROM.h, VMABI.h, VMBootImage.h, VMHost.h, VMHostABI.h, VMRegistry.h]
2026-09-30 abi: reserve service bit 20 for this loader, and anonymize 5, 6, 8..13
    Bit 20 (a bounded C64 memory transfer) is a capability the stock host
    will serve on the TR+. Assigning it now keeps the packager from refusing
    a module that asks for it, and keeps another host from claiming the
    number before the loader serves it.
    The registry records bits 5, 6 and 8..13 as reserved out of tree,
    without naming an owner or the capability behind each: an assignment
    binds the number, and the stock registry has no call to describe
    services it does not provide.
    [VMABI.h]
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2026-09-30 fw: count a slice that landed even when releasing the bus after it fails
    PerformDMA returns true only once the C64 has taken the whole slice, so
    a CloseDMA failure after it must not drop that slice from the count. A
    sender resuming from the count would otherwise write it again, and a
    span in $D000-$DDFF reaches the VIC, SID and CIAs, where a second write
    is not harmless.
    [DMAControl.ino]
2026-09-30 fw: a remote command that writes C64 memory spans in slices
    WriteC64SpansToken (0x64FC) carries up to 64 spans and one payload, and
    hands them to WriteC64Spans with the slice size and gap the sender
    chose. Spans are checked before any byte of payload is read, so a
    refusal costs no DMA, and the reply names how far a failed job got.
    The receive has a deadline for the whole transfer rather than only a
    per-byte timeout, which would let a sender hold the board for length x
    500 mS, and a refused sender's remaining bytes are discarded rather than
    parsed as commands.
    [Common_Defs.h, SerUSBIO.ino]
2026-09-30 fw: bound a span job, and accept the spans before the payload is sent
    Review of the span command found five ways it could hold or misread the
    board. The board now answers once the span list passes, and the sender
    waits for that, so a refused payload is never sent to be parsed as
    commands. A job is held to WriteC64Mem's 64 KiB and to 1,024 slices,
    since a slice can wait ~5 mS to start and 1-byte slices would otherwise
    hold the board for minutes. The receive has one deadline for the whole
    command rather than one per phase. WriteC64Spans reports a failed
    release on the last slice as a failure, which the byte count alone
    could not show.
    [C64Spans.h, DMAControl.ino, SerUSBIO.ino]
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2026-09-30 fw: discard what a failed span sender still owes, and give a job a deadline
    A payload that failed partway through, on a TCP retransmit longer than
    the per-byte timeout for instance, left its remaining bytes to be parsed
    as commands. The discard now counts off exactly the bytes the sender
    still owes, and stops early only on quiet longer than a retransmit or
    at the deadline a receive of that many would have had.
    The slice cap bounds a job to seconds only while each slice starts in
    the ~5 mS a live C64 allows. A bus that holds every handshake to its
    50 mS ceiling would stretch that twentyfold, so WriteC64Spans also
    stops at a job deadline sized from the cap.
    [C64Spans.h, DMAControl.ino, SerUSBIO.ino]
2026-09-30 fw: end a failed span sender's discard at the command's own deadline
    The count-based discard missed the span list a sender sends straight
    after its header when the header itself fails, and its own fresh
    deadline let a trickling peer hold the board for twice the command's.
    Every receive now names what the sender goes on to send unprompted, so
    a header failure discards the list as well, and the discard ends 2 S
    past the command's deadline, or after 1 S of quiet, rather than
    starting a clock of its own.
    [SerUSBIO.ino]
2026-09-30 bench: check that a refused span list is discarded, not parsed
    The list of a job refused for its flags carries a whole WriteC64Mem to
    a probe byte; the probe changing means the board parsed the list as a
    command. Run against firmware whose discard owed nothing, this row
    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
2026-09-30 bench: reset the C64 when spans.py stops early, and check a count read before reading its bytes
    A refused job or read raised SystemExit inside the Link, which skipped the reset and
    left the C64 in the client with IRQs off and, from nmi_loss, timer NMIs still running.
2026-09-30 c64,fw,docs: rename Installed Extensions to Installed Extension, fix the TRH type label
    Only one extension host can be installed at a time, so "Extensions" (plural)
    on both the settings index and the page itself was always describing a
    single slot. Reword to match, and shorten the uninstall confirmation along
    with it -- the old wording needed a paragraph of column-counting to prove
    it stayed inside the 40-column wrap trap; the new wording is short enough
    that it doesn't.
    TblItemType's rtFileTRH abbreviation was "THo", not "TRH" -- fixed.
    docs/General_Usage.md follows the new wording.
    .gitattributes checks the TRMenuFiles/ROMs headers out as LF:
    tools/build-c64.mjs already writes them that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
    [Pg_Index.asm, Pg_InstalledExt.asm]
2026-09-30 fw,docs: vendor USBHost_t36 from before the 1.60 enumeration rewrite
    Some USB devices stopped being recognized on the host port after
    Teensyduino 1.60; going back to 1.59 fixes it. The only enumeration
    change in that window is USBHost_t36's error-handling rewrite (upstream
    fde482e, 1e2c91e), which 1.61 still ships and 1.62 leaves unchanged.
    Until a real fix exists, build against the library as of upstream
    f943c4b, the last commit before the rewrite.
    It lives in Source/Teensy/src/USBHost_t36/, where both the Node build
    and the Arduino IDE compile it as part of the sketch, so neither needs
    new build settings. Teensy.ino and PN532_UHSU.h include it by path: a
    plain <USBHost_t36.h> anywhere pul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
    [PN532_UHSU.h, SerEMU.cpp, Teensy.ino, USBFilesystemFormatter.cpp, adk.cpp]
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2026-09-30 fw,build: say what a host with no code floor takes, and scope the 96 KiB hint to --host-sketch
    "Update it" was wrong for a host that leaves the floor at 0 on purpose, and the
    stock host cannot take --host-code-kib.
    [VMRegistry.h]
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2026-09-30 Document the code floor's promise, the SDIO exception and the rerun rows
    Extension-Hosts.md says SdFat's SDIO driver stays in ITCM and that the
    build refuses an --out inside a flash-resident library, and states what a
    host promises by publishing a code floor and why a fixed-base loader
    leaves it at 0. The ABI README narrows "enforces every rule" to what the
    bytes can show, adds the floor to the launch refusals, counts ten ways
    tryLaunch declines, and records which hardware rows were re-run on the
    64 KiB host, with what they showed. hostenter.py's list gains the floor.
2026-09-30 fw: acknowledge WriteC64Spans's token before the sender sends anything more
    The header and span list followed the token unprompted, so firmware without
    the command answered "Unk cmd" or "Busy!" and then read them as commands:
    a slice size of 101 is 'e', which resets the EEPROM, and a span at $64EE
    resets the C64. The board now acks the token first, and a sender that
    waits for that ack stops at the other answer.
    [SerUSBIO.ino]
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2026-09-30 fw: let the span header wait out a stall, and ask a failed sender for quiet
    A header that failed on a 500 mS stall was followed by a discard sized
    for the longest list, which ran on over the sender's retry. The header
    now waits under the command's deadline alone; once the count is in, a
    discard owes exactly what the header announced. ControlComms says to
    wait for a second of quiet after any FailToken.
    [SerUSBIO.ino]
2026-09-30 fw: stage remote DMA transfers in a buffer of their own, not RAM_Image
    WriteC64Mem, ReadC64Mem and WriteC64Spans staged their data at the start
    of RAM_Image, which can hold a running cartridge's ROM or REU emulation's
    banks, so a remote write while one ran rewrote it under the program.
    Each command now allocates what it needs from the heap for its duration,
    and refuses with "No memory to stage" when that fails; a refused
    WriteC64Mem discards the data it was sent unprompted.
    [SerUSBIO.ino]
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2026-10-01 fw: hand the machine the C64 menu reported to the extension image
    The DMA setup and hold times differ between PAL, NTSC and an NTSC C128, and the main
    image picks them from what MainMenu.asm reports. The extension image boots without the
    menu, so it would drive the bus on the PAL set, which gives write errors on some NTSC
    machines.
    tryLaunch now leaves the three machine bits, then their complement, past the @VM1
    marker in the boot-name field, and the extension image applies them through the same
    SetVideoStdDMATiming the main image now calls. A main image that left nothing there
    leaves an older path's tail or zeroes, which vm_launch_machine() refuses, and the host
    keeps the PAL set.
    [IOH_TeensyROM.c, IOHandlers.h, VMBoot.ino, VMHostABI.h, VMRegistry.h]
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2026-10-01 abi: keep a refused c64_write from orphaning the job before it, and say what bounds a job
    A refusal issues no ticket, so c64_status goes on answering for the last
    one issued. And a job granted slowly but steadily runs as long as its
    client makes it, up to VM_C64_SLICES_MAX grants of VM_C64_GRANT_MS each.
    [VMABI.h]
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2026-10-01 abi,bench: correct what bit 20's comments claim about limits, timing and the grant rule
    The refusal list gains the 64 KiB total; a turn bounds when slices start, not
    how long a granted one runs; a launch before the menu reports gets PAL timing;
    nesting comes from a grant that is not the handler's last act; the bench's sum
    covers the last job only.
    [VMABI.h, VMHostTransfer.h]
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2026-10-01 fw,c64: count bit 6 of rRegItemTypePlusIOH in the item type limit
    #50 made bit 6 the /VMS claim flag, so the regItemTypes comment's
    "127 max, bit 7" no longer held. Menu_Regs.i updated to match.
    [Menu_Regs.h]
2026-10-01 fw: leave dotfiles out of USB/SD directory listings
    A card or stick that has been in a Mac carries .DS_Store, .Trashes and a
    ._ twin of every file, and the ._ twins are typed by their extension like
    the real file. The main menu browser (and the NFC random pick that reads
    it), the remote app's paged listing, TR BASIC's directory and the
    SwiftLink browser now pass over any entry whose name starts with '.'.
    The remote listing does not count them, so skip and take page over what
    is listed.
    [DriveDirLoad.h, DriveDirLoad.ino, FileTransfer.ino, IOH_TR_BASIC.c]
2026-10-01 vm: time a bit 20 slice from the last one that landed, so grants that never land end the job
    A grant written between the host's turns reset the job's wait, so a client whose grants
    all fell between turns kept its job pending for good, and c64_write refused every job after
    it. That happens without any coincidence: a client that grants just after ACKing a packet
    ends the module's turn with its ACK, so the next frame's grant falls at the same point in the
    turns and misses again.
    VM_C64_GRANT_MS now counts armed time since the last slice landed, and such a job ends with
    VM_C64_NO_GRANT. The host no longer notes missed grants at all, since nothing reads them.
    [VMABI.h, VMHost.h, VMHostTransfer.h]
2026-10-01 firmware: report the C64 menu's boot state in the version reply
    A host that resets the TR cannot tell when the C64 menu has finished booting.
    The GoodSID token it has to go on arrives several hundred ms before the menu
    is ready (2-4 s before, after a reboot out of minimal), and a launch sent in
    that window can be lost.
    The menu now writes rCtlBootComplete after its first ListMenuItems, and before
    RunSelected on the remote-launch-at-boot path. The IO handler sets
    BootComplete, SetUpMainMenuROM clears it on every way back to the menu, and
    the version reply ends with "Boot: complete" or "Boot: in progress".
    TeensyROMC64.h is regenerated: the menu binary grew 10 bytes (two lda/sta
    pairs), whic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
    [IOH_TeensyROM.c, Menu_Regs.h, SerUSBIO.ino, Teensy.ino]
2026-10-01 firmware: ignore the boot flag during a reset; set it when a cart starts without the menu
    SetUpMainMenuROM cleared BootComplete while the old menu was still running,
    and /RESET is only asserted after it returns, so a late rCtlBootComplete
    from the old menu could survive into the next boot. The flag is now cleared
    after doReset is set, and the IO handler ignores rCtlBootComplete while
    doReset is.
    A cart the Teensy starts without the menu (an autolaunch, or a launch sent
    while in MinimalBoot) never runs the menu's boot, so the flag stayed
    "in progress" for as long as the cart ran. HandleExecution now sets it when
    it resets the C64 into a cart.
    The menu still sets the flag before RunSelected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
    [DriveDirLoad.ino, IOH_TeensyROM.c, Teensy.ino]
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2026-10-03 firmware: time PAL/NTSC from PHI2 at boot instead of waiting for the menu
    Only the C64 menu reported the machine, so anything started without it ran
    on the PAL defaults: an autolaunched CRT, a launch handed to MinimalBoot, and
    MinimalBoot itself. On an NTSC machine that meant PAL's nS_MaxAdj on every
    cycle, and PAL's DMA hold, which sits inside NTSC's own partial-byte band.
    The full and minimal images now time PHI2 in setup(), with the C64 held in
    reset, from the stamp isrPHI2 already takes on every rising edge. Nothing is
    masked and nothing runs from RAM. Thread mode can miss a stamp between ISR
    calls, so each gap is rounded to whole periods. It takes about 1 mS, and if
    the bus isn't clock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
    [Common_Defs.h, IOHandlers.h, MachineDetect.h, Min_SerUSBIO.ino, MinimalBoot.ino, Teensy.ino]
2026-10-03 firmware: follow PAL/NTSC changes after boot and merge the menu's report
    A C64U powers up at the PAL rate and only applies a saved NTSC setting once
    the cartridge port's reset is released. Its firmware waits for that before
    detecting SIDs, then reprograms the video PLL about 0.1-0.2 S later, before
    its CPU starts (Ultimate firmware, software/u64/u64_config.cc). It can also
    switch live from its menu without restarting the C64. So the PAL timed at
    boot was right for that moment and wrong a moment later.
    Every image now keeps re-timing PHI2 from loop(): every 10 mS for 2 S after
    each reset release, so a C64U's switch is followed before its CPU runs, then
    every 2 S for a live switch. A re-check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
    [Common_Defs.h, IOH_TeensyROM.c, IOHandlers.h, MachineDetect.h, MinimalBoot.ino, Teensy.ino, VMBoot.ino, VMRegistry.h]
2026-10-03 firmware: launch .crt-packaged extensions through the menu at power-up
    An extension launch hands the extension image the machine in a pair of
    EEPROM bytes. PAL/NTSC is timed on the Teensy now, but C64 vs C128 only
    comes from the menu's report: a C128 can't be told apart at the port while
    it's in reset or early in its boot. An extension packaged as a .crt was
    launched directly at power-up, by SD or TR autolaunch, or by the relaunch
    after a launch sent to MinimalBoot, before the menu had ever run. So its
    pair said nothing about C64/C128, and on a C128 the extension's DMA used
    the non-C128 timing set.
    Until the menu has reported, such a .crt now leaves the direct path and
    goes the way a launch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
    [RemoteControl.ino, VMLaunch.h, VMRegistry.h]
2026-10-03 docs: machine timing without the menu -- close DMA timing #1, add the rules
    The last three commits time PAL/NTSC on the Teensy and keep re-timing it,
    leave C64/C128 with the menu, and send packaged extensions through the menu
    at power-up. This writes that down where the next change will look.
    DMA-Timing-Known-Issues.md closes #1 with what was done and what is left: a
    directly launched C128 cart still gets the non-C128 set, which only matters
    for a host's memory commands while it runs. #14 points there.
    Constraints.md gets a machine-type section with the three things that are
    easy to get wrong. The boot reading isn't final, because a C64U applies its
    saved standard after the reset is releas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
    [VMABI.h, VMHostABI.h, VMRegistry.h]
2026-10-03 firmware: merge the menu's machine report in thread mode, tighten re-checks
    Review follow-up to the PAL/NTSC re-timing.
    The menu's wRegVid_TOD_Clks report was merged inside the IO1 handler, in
    isrPHI2, while PHI2 changes were applied from loop(). The shared register
    then needed an interrupt-masked read-modify-write, which held isrPHI2 off,
    and the two StrMachineInfo builds could still interleave. Now the handler
    only stores the raw report, and ApplyMenuVidReport() merges it at the top
    of the TeensyROM polling handler, ahead of the dispatch that may act on it
    (a launch at boot reaches tryLaunch from there). It takes the report with
    an atomic exchange, so one the ISR writes meanwhile isn't lo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
    [IOH_TeensyROM.c, IOHandlers.h, MachineDetect.h, Teensy.ino]
2026-10-03 vm: follow the machine-known mask in the native tests, and test isPackageCrt
    The PAL/NTSC change replaced VidStdReported with VidTODClksKnown, and
    tryLaunch now reads its rvtcC128 bit, but the native tests' stand-in for
    the firmware globals (fake_sd.h) still declared the old flag, so files_test
    no longer compiled (PR #53's tools job).
    fake_sd.h now declares VidTODClksKnown and the RegVidTODClksMasks bits.
    registry_test.cpp marks the menu's report as all three bits, and the
    before-the-menu case as only PAL/NTSC known, which is what the main image
    has after timing PHI2 at boot. The pair is still left invalid there.
    launch_test.cpp covers VmLaunch::isPackageCrt, RemoteLaunch's routing test:
    -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
2026-10-04 firmware: build MinimalBoot as Serial + MIDI with main's USB names
    Minimal enumerated as PJRC's default serial-only device (16C0:0483,
    "USB Serial", bare serial number) while main is Serial + MIDI
    (16C0:0489, TeensyROM-<id>). Every pass through minimal -- updates,
    large CRTs, extension launches -- swapped the board's COM port, and a
    DAW saw its MIDI port vanish and a different device appear. Windows
    keys the device on VID/PID and serial string, so matching the PID
    alone isn't enough: both images now present the same interfaces and
    the same name strings. Prerequisite for a settable PID (list #42).
    - build-firmware.mjs builds minimal usb=serialmidi; a test keeps the
    two images' USB types in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
    [ChipSerial.h, Common_Defs.h, Min_SerUSBIO.ino, Min_UsbNames.c, MinimalBoot.ino, StartupHooks.c, StatusFunctions.c, UsbNames.c]
2026-10-04 docs: minimal and main now share one USB device
    Follow-up to 88c6c03 (MinimalBoot built as Serial + MIDI).
    The Arduino IDE instructions (BuildInfo.md, Build-System.md) now say
    MinimalBoot.ino needs USB Type "Serial + MIDI" too, and why.
    The flash how-to no longer says minimal comes up on a COM port of its
    own during a flash; with this firmware it is the same port.
    The bench scripts (README, probe.py, reset.py) no longer use the macOS
    port name to tell main from minimal: both now present the same device.
    Each notes what older firmware did, since boards running it still
    behave that way. 88c6c03's trlink.py docstring had it wrong: macOS
    names TeensyROM's device by USB location (usbmodem2101)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
2026-10-04 firmware: grow MinimalBoot's RAM image buffer by 48 KB, guard its stack
    MinimalBoot's ITCM code has shrunk from five 32 KB banks to four, which
    gave 32 KB back to DTCM; with Serial + MIDI it builds with ~77 KB free
    for the stack against the >24000 Min_TeensyROM.h measured it needs with
    Ethernet listening (2025-11 crash test). MaxRAM_ImageSize's base goes
    from 392 to 440, so the RAM1 buffer that holds CRT banks grows from 160
    to 208 KB, leaving ~27 KB free on TR+ and ~30 KB on TR. With RAM2 and
    the 16 swap buffers, minimal now holds 103 8K banks before any has to
    come from SD: an 880K EasyFlash flags 23 for swapping, 7 beyond the
    swap cache, where it used to be about 13.
    That margin only hol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
    [Min_TeensyROM.h]
2026-10-04 Fix for stale pending interrupt which causes issues when CPU resumes in Cart ROM
    [IOH_REU.c]
2026-10-04 Debugging features added by Claude to diagnose SSv5 crash/lockup
    [Common_Defs.h, IOHandlers.ino, ISRs.c, SerUSBIO.ino, Teensy.ino]
2026-10-04 firmware: read MinimalBoot's CRT banks from SD in one call, not per byte
    LoadBank (EasyFlash and MagicDesk2 bank swaps, and the swap-buffer
    preload) and the CRT chip load in LoadFile read every byte with its own
    myFile.read(): 8192 calls per swapped bank, up to 16384 per chip at
    load. Each is now one myFile.read(buf, len), so SdFat moves whole
    sectors straight into the buffer. A swap happens with the C64 held by
    DMA, so a faster read is a shorter pause.
    The byte-wise read() returned -1, stored as 0xff, past the end of the
    file; the bulk read fills any shortfall with 0xff to match. SdFat's -1
    on error comes back through File's size_t, so it is cast back and
    treated as nothing read. The read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
    [IOH_EasyFlash.c, Min_DriveDirLoad.ino]
2026-10-04 firmware: let hot keys, autolaunch and NFC store files a /VMS package claims
    A file whose extension a /VMS package claims (.mpe, say) launches
    through VmLaunch::tryFile, and since #50 the menu shows its extension
    as the type, but its ItemType stays rtUnknown. IsStorableLaunchType
    turns that away, so setting one as a hot key, the autolaunch file or
    an NFC tag failed with "Invalid File Type (1)".
    The three setters now also accept an SD selection MarkVmClaimed
    marked, through IsVmClaimedSelection(). Storing one doesn't reopen
    the reboot loop the predicate guards against: RemoteLaunch sends a
    non-CRT through the menu to tryFile, and a host's return leaves
    MinBootInd_FromMin, which skips the aut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
    [IOH_TeensyROM.c, StatusFunctions.c]
2026-10-05 vm: refuse a manifest that lists one extension twice
    Routing matches extensions ignoring case, so gb,GB claims gb twice. The
    parser and the packager now refuse such a list, the same way they refuse
    a protected extension: the manifest is malformed, the package claims
    nothing, and a host that parses it fails the launch with $12. The
    manifest format is unchanged.
    [VMHostABI.h]
2026-10-05 vm: name both packages when two claim one extension
    With longer extension lists, two installed packages claiming the same
    extension becomes likely, and the refusal said only "Ambiguous or
    over-limit VM registry". find() now tells an ambiguous match from an
    over-limit or unreadable /VMS, and hands back the other claimant, so the
    launch says which extension collides and which two packages claim it.
    Only files of the shared extension are refused; each package's other
    extensions and its client cartridge launch as before, and the menu
    still marks the files as claimed.
    [VMRegistry.h]
2026-10-06 vm: keep the extension routing table in RAM1
    Reverts 4a34e2b. Moving the 1 KiB table to DMAMEM freed RAM1 stack that
    wasn't short (47,964 bytes free with it there) and took the 1 KiB from
    the RAM2 heap, which is the contended one: the REU mallocs up to 48 8 KiB
    banks there and trims to a power of 2, so near the edge -- a large
    directory listing, malloc's 4 KiB sbrk rounding -- it can cost the 48th
    bank and halve a 512 KiB REU. In RAM1 the table is in .bss, zeroed at
    startup like any other static, so the not-zeroed reasoning DMAMEM needed
    goes with it.
    [VMRegistry.h]
2026-10-07 firmware: keep DirectREU's Serial.flush() out of release builds
    It ran unconditionally inside isrPHI2, re-entering USB serial code and
    colliding with any print already in progress in the main loop. Only
    DbgMsgs_REU's own messages need it.
    [IOH_REU.c]
2026-10-07 firmware: stop the debug trace loggers writing past the end of BigBuf
    The IO1, IO2 and cycle-adjust loggers wrote BigBuf[BigBufCount] before
    checking the bound, so a full buffer was written one entry past its
    allocation. All loggers now stop at BigBufSize-1 and use the last entry
    as scratch, as IOH_Debug already did, and PrintDebugLog no longer drops a
    real entry when the buffer is full.
    [Common_Defs.h, IOH_REU.c, ISRs.c, Min_SerUSBIO.ino, SerUSBIO.ino]
2026-10-07 firmware: reboot if Super Snapshot V5 or Retro Replay can't get its 32K RAM
    With the buffer NULL, selecting RAM bank 1-3 pointed ROML reads and
    writes at NULL+offset, which is ITCM code.
    [IOH_RetroReplay.c, IOH_SuperSnapshotV5.c]
2026-10-07 firmware: drop the post-DMA trace and the SSv5/REU reset snapshot detail
    Both were written to diagnose the SS5+REU lockup fixed in PR #54. The
    post-DMA trace also added a check to every isrPHI2 entry in
    DbgIOTraceLog builds. Keeps the IO2 tag, the markers and the general
    reset snapshot. Also decodes markers after cycle-adjust entries, whose
    tick count can reach the marker bit.
    [Common_Defs.h, IOH_REU.c, IOHandlers.ino, ISRs.c, SerUSBIO.ino]
2026-10-07 vm: hand the host a content path with single slashes
    The file browser's path is "/" plus "/<dir>" per level, so below the
    root it starts "//", and tryLaunch passed it on: Tritari got
    "//VMS/TRITARI/ROMs/3DAsteroids.a78" and opened its own launcher
    instead of the game. SdFat and the NES/GB/GG hosts ignore the extra
    slash, which is why it went unnoticed. tryLaunch now collapses every
    run of slashes in the joined path before it is used, so the record
    always carries "/VMS/TRITARI/ROMs/...", whichever form the caller had:
    the menu's, or a stored or remote path with doubled slashes. Hardware-
    tested: Tritari now launches the selected ROM.
    The browser's own path form is a separate fix (list #67);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
    [VMRegistry.h]
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2026-10-07 firmware: allocate freezer cart RAM through one checked helper, Action Replay included
    AllocFreezerRAM() replaces the copied SS5 and RR out-of-memory blocks
    and adds the same check to Action Replay, whose 8K RAM was still
    unchecked: with it NULL, AR's RAM mode pointed ROML reads and writes
    at address 0, the start of ITCM.
    [IOH_ActionReplay.c, IOH_RetroReplay.c, IOH_SuperSnapshotV5.c]
2026-10-09 firmware: report the boot in progress again when a remote launch on reset returns
    On a remote launch on reset, the menu sets the boot flag before RunSelected,
    since a SID, text, picture or error screen accepts remote commands while it
    waits for a key. Once that screen returns, the menu runs the rest of its boot
    (network time, TCP listener, menu list), and the version reply still said
    "Boot: complete" the whole time.
    The menu now writes rCtlBootInProgress (59) when the launch returns, and the
    IO handler clears BootComplete. The existing write after ListMenuItems sets
    it again. Launches from the running menu don't rerun the boot and are
    unchanged.
    TeensyROMC64.h is regenerated for the added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
    [DriveDirLoad.ino, IOH_TeensyROM.c, Menu_Regs.h, Teensy.ino]
2026-10-09 fw: put a deadline on remote file and memory transfers
    A transfer's only bound was the per-byte timeout, so a peer trickling one
    byte just inside it held loop() -- and with it the C64 menu -- for as long as
    it liked: 65535 x 500 mS for a WriteC64Mem, and longer for a file. Receiving
    and sending a file and WriteC64Mem now stop at TransferCeilingmS(len), a floor
    plus the length at a rate well under what each channel really does, and
    answer FailToken with how far they got.
    After a failed receive, DrainCmdChannel discards what the peer is still
    sending, bounded itself, so the rest of the payload is not read as the next
    command. And the flushes on these paths go through FlushCmdChannel, which
    do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
    [FileTransfer.ino, SerUSBIO.ino, Teensy.ino]
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2026-10-10 firmware: allow Ping and file commands while the ASID Player runs
    While the ASID Player runs, the firmware answered "Busy!" to every command
    outside the always-available set. TeensyROM-Web's DJ Player streams ASID
    from the browser and downloads a SID from the TeensyROM when it isn't cached
    locally, usually while the other deck is playing through the ASID Player.
    The API pings before a file command and resets the TeensyROM when the reply
    is "Busy!", so the download ended the ASID Player.
    ProcessCommand now also accepts Ping and the file commands (get, list,
    post, copy, delete) while IOH_ASID is the active handler. They use only the
    SD card, the USB drive or the built-in file list, never the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
    [SerUSBIO.ino]
2026-10-10 menu: RetroMate v1.03 in the Games menu
    Built from StewBC/retromate master c93ef68 with cc65 V2.19 (git 71746c8),
    as there's no V1.03 release binary yet. Includes upstream 3b2dca7, which
    stops '1'/'2' keypresses being read as 1351 mouse buttons (reported as '1'
    acting like backspace when typing a chess server password), plus the
    buffer-handling rework. The menu entry now shows the version.
    @Stefan Wessels
    [MainMenuItems.h]
2026-10-10 firmware: work out the item type when it's selected, not on the read
    On NTSC (a 250425 C64 with a Kawari) the menu sometimes read the wrong
    item type: /Games acted as launchable, items showed as directories,
    RetroMate lost its + mark. The item-type read worked the value out
    during the C64's read cycle and put it on the bus ~40nS after every
    other IO1 read, ~342nS after ISR entry, which left it next to no data
    setup time before PHI2 fell. Code layout decided how often a slightly
    late ISR entry pushed it over, which is why PR #54 turned it on.
    UpdateItemTypeReg() now works the byte out when the item is selected:
    in the ISR on the rwRegSelItemOnPage write, once the data is latched,
    and in thre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
    [IOH_TeensyROM.c, RemoteControl.ino]
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2026-10-10 menu: add HEADCRASH Format Util to Utilities
    Rob Mech's 1541/1581 disk formatter: formats a track at a time so it can
    show progress, retry a failing track and keep bad tracks out of the BAM,
    and picks the drive (8-11) from its own screen. Single PRG at $0801,
    KERNAL-only drive access, no REU or cartridge, so IOH_None.
    Header generated from dist/headcrash.prg at V1.8 (9fc9e11), MIT licence
    text carried in the header. About 20 KB of flash.
    Thank you Robert Mech (rwmech) for writing it and offering it for the
    TeensyROM menu! https://github.com/rwmech/c64_HEADCRASH_Format_Util
    [MainMenuItems.h]
2026-10-10 menu: add CBM FileBrowser v1.6 (fb64) to Utilities
    The file browser most SD2IEC users load as FB64: browses and launches
    from IEC-bus drives (real drives, SD2IEC, pi1541), starting on drive 8
    since the TR sets $BA there on a PRG launch; D steps to the next drive.
    It starts programs with KERNAL LOAD and BASIC RUN, so IOH_None.
    This is fb64 itself, not the package's "fb", a BASIC stub that loads
    fb64 from the drive and so fails when started from the TR. Header
    generated from programs/fb64 in cbm-filebrowser-v1.6.zip, which
    assembles byte-identical from the included source with ACME 0.97.
    About 2 KB of flash.
    Thank you nbla000 for CBM FileBrowser, and Hannu Nuotio (sd2brwse) and
    Michael Kirch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
    [MainMenuItems.h]
2026-10-10 firmware: Dbg_SerSD serial command for SD card info and speed
    There was no way to see how fast the built-in SD slot runs on a
    TeensyROM, and Constraints.md still gave ~3mS for a MinimalBoot bank
    swap, from before 24c187c.
    With Dbg_SerSD defined (TeensyROM.h, off by default), serial 'o' at the
    TR menu prints the SD clock (49.5 MHz High Speed or 24.75 MHz), card
    type, CID, OCR and the volume's FAT type, cluster size and erase
    alignment. It then runs SdFat's TeensySdioDemo test on an 8 MiB file
    (write and read KB/sec at 512 bytes to 32K, plus the longest single
    call) and times 256 seek + 8K reads at CRT bank offsets in the open
    file, which is what LoadBank does for a swap. The file is deleted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
    [SerUSBIO.ino, TeensyROM.h]
2026-10-11 firmware: Dbg_SerSD fixes from review: SD error text, CID serial order
    From a review of 18e8563. A failure the card itself didn't report, a
    full card for one, printed "SD error 0x00 SD_CARD_ERROR_NONE"; it now
    says it was the file system, not the card. The CID serial number
    printed byte-reversed: SdFat 2.1.2's cid_t.psn is the register's
    big-endian bytes as read, so it is swapped back (later SdFat versions
    do the same in psn()). The test file is still truncated if it exists,
    which clears one left by an interrupted run; a comment says so.
    Constraints.md: the swap times are the SD side of a swap, measured in
    the Full firmware through FsFile, not the whole DMA pause a MinimalBoot
    swap takes th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
2026-10-15 firmware: RAM bank save reports a failed write instead of acking it
    A short write (card full, drive pulled) printed "Saved" and flashed the
    save LED. Load stops at a read error rather than adding -1 to its count.
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2026-10-16 tools: trmouse.py writes the driver file as a C header for the firmware
    The firmware will put the same file on a boot disk that trmouse.py does, so the bytes come from one place. A test regenerates the header and fails when the committed copy drifts from trmouse128.asm.
2026-10-16 tools: trmouse.py writes the driver header with LF endings and keeps its arrays in flash
    Python's write_text writes CRLF on Windows, which the drift test compared against an LF checkout. A Teensy 4 places const data without PROGMEM in RAM1.
2026-10-16 firmware: a GEOS 128 boot-disk patch that adds the TR USB mouse driver block by block
    It reads and writes 256-byte blocks through callbacks, so it can patch an image on SD that is too large for RAM. A host test compiles it and holds it byte for byte to trmouse.py on D64, D71 and D81 boot disks, refusals included.
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2026-10-16 firmware: the GEOS launcher stamps the driver with the RTC's local date, keeps an unreadable -TR copy, skips ._ twins, and stops telling a user with a boot disk to copy one
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2026-10-20 settings: share the /VMS walk and package checks with the Installed Extension page
    The page copied find(), refresh() and preflight() and had drifted: it skipped
    the module-payload and client-bank CRC passes, so a package with a bad CRC
    showed launchable and then failed at launch.
    VmRegistry now owns the folder rule, the bounded /VMS walk and verify(), and
    find(), refresh(), preflight() and the page all call them. SDSlotFilled moves
    to Teensy.ino beside its other caller; SD.begin already muxes DAT3 back, so
    the pin needs no restore of its own.
    The page keeps rows for the reasons and the last launch when many packages
    are listed, and counts any it still has to cut. The docs say what '!' cove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
2026-10-21 tools: a GEOS disk driver transport served by the TR block device
    The firmware places the code over a stock driver's turbo routines, so the
    generator marks every address in it for relocation. The 1581 header swap
    stays with the driver, since the stock drivers do it there.
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2026-10-21 firmware: build a PRG that starts GEOS from a boot disk image
    The stock start-up file LOADs the boot file from a drive, so the PRG
    carries the boot file itself with the disk driver's transport replaced by
    the TR's. CONFIGURE files are retyped so GEOS does not probe an empty IEC
    bus and leave drive A without a disk.
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2026-10-21 tools: GEOS 64 mouse skips the 80-column scaling and stops at its vectors
    The 80-column flag at $3f is a GEOS 128 variable, so the 64 build leaves
    the scaling out. Each target gets its own driver area limit, and the test
    checks that a header's code starts in its target's area.
2026-10-21 firmware: refuse a stock driver with other entries in the code the TR replaces
    A vector or jump slot the TR driver does not repoint would land in the
    middle of its code. The disk's CONFIGURE files are retyped only once the
    boot PRG has built, so a failed launch leaves the disk as it was.
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2026-10-21 firmware: start GEOS 64 with the TeensyROM's date and time
    The boot file's start-up code sets a fixed date and a fixed 1 PM; the launch
    patches those with the TeensyROM's local time. A boot file whose start-up
    code is not the one it knows keeps what it has.
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2026-10-21 firmware: add the mouse driver to an existing GEOS copy in place
    A copy the user already has, with a desktop but without the driver, was
    replaced by a fresh copy and lost what GEOS had saved to it.
2026-10-21 firmware: patch an existing GEOS copy through a temporary file, never replace it
    A copy that is readable but has no desktop used to be deleted and
    recopied, and one needing the driver was patched in place. Both can
    lose what GEOS saved to it. The patch now goes through GeosPatchCopy,
    and a copy with no desktop is left for the user to remove.
2026-10-21 firmware: keep the replaced GEOS copy until its successor is in place
    Removing the copy and then renaming the new one over it lost the copy
    when the rename failed or power dropped between the two. The old copy is
    renamed aside and put back if the new one cannot take its place.
2026-10-21 firmware: put back a GEOS copy that power loss left renamed aside
    The backup took one fixed name for every copy in a folder, so a leftover
    for one copy blocked the others and nothing said which copy it held. It
    now takes its copy's name, and a launch that finds the copy missing and
    its backup present renames the backup back.
2026-10-21 firmware: drop the stale GEOS backup when the copy it preceded is in place
    Power loss after the swap but before the backup was removed left both files.
    The copy is the complete newer one, so the backup is stale and is removed.
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2026-10-21 firmware: answer the TR block window first so its bytes reach the bus in time
    On an NTSC C64 with a Kawari VIC-II, the block device's ID came back wrong in
    every read and window bytes now and then, so GEOS found no disk. A read now
    splits the page once, answers the window from a pointer kept by PAGE writes, and
    answers the registers in one pass.
2026-10-21 tools: the GEOS disk driver reads each TR byte until two reads agree
    On an NTSC C64 with a Kawari VIC-II, a TR+ read now and then returns the
    previous read's bits ORed in. With the double read patched out of the driver in
    GEOS memory, 3 of 200 blocks read wrong; with it back, the same blocks read clean.
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2026-10-21 fw: keep the bounds fixes, drop the defensive layer around them
    The menu index is clamped where it is formed, so it is not re-checked at
    each dereference (MenuItemSel, CloseMenu, SetMenu's ordering barriers and
    the fallbacks built on them go). Also removed: the TR BASIC name/save
    refusal flags, empty-menu and null-entry checks the loaders and the
    static_assert already rule out, the default string selector, the
    out-of-memory exits, and the stream/serial-string read bounds that only a
    misbehaving C64 program reaches. The tests keep the two tree-wide lints and
    drop the ones that pinned exact source text.
    Kept: every bound on card, network, NFC and EEPROM input, the 32-bit stream
    offset, the IO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
2026-10-21 fw: drop the transfer deadline, keep the drain and non-blocking flush
    No peer has been seen trickling bytes just under the per-byte timeout, and
    one that could already has full control of the board. A failed receive now
    discards the rest of its payload through the existing DiscardCmdInput
    instead of a second drain helper.
2026-10-21 firmware: end an open SD read before restarting the card
    A few SD cards (about five, where others of the same make and model
    are fine) showed <Empty> on every F3 until they were power cycled or
    re-inserted. SdFat's FIFO SDIO mode leaves a multi-block read running
    after every read, the mount's included, until a file close sends CMD12;
    a failed open closes nothing. SD.begin then sends CMD0 to a card still
    in that read, and these cards stop answering, with CRC errors on every
    reply, even at the init clock.
    Two paths did that. The boot check for autolaunch.txt leaves the read
    open when the file is missing, and the next F3 restarts the card. And
    FSfromSourceID restarted the card right after its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
2026-10-22 fix: review findings for 7f95768
    SetMenu now resets SelItemFullIdx, so the UpdateItemTypeReg call after each
    status function cannot index the new menu with a selection made in the old,
    larger one (e.g. an SD listing followed by a change to TeensyROMMenu).
2026-10-22 firmware: drop sscanf and pow, 32 KB more RAM1 for the main image
    The firmware updater's hex parser was the only sscanf caller. Newlib's
    full scanf brings strtod with it and, through iswspace, its JIS
    character tables (~27 KB), and Teensy 4 keeps both the code (ITCM) and
    the tables (DTCM .rodata) in RAM1. pow, used only for MIDI to SID's note
    frequency, added ~6 KB of tables the same way.
    parse_hex_line now reads its fixed-width fields with a small hex-digit
    parser and refuses a record longer than the caller's buffer (a 33-42
    byte record used to overrun update_firmware's 32-byte data[]).
    M2SOnNoteOn takes the frequency from a one-octave table, doubled per
    octave: the same SID register value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
2026-10-22 firmware: resolve a TR remote launch before changing state; refuse only long folders
    A TR remote launch whose lookups failed had already set RemoteLaunched,
    switched the menu type to rmtTeensy and refreshed VmRegistry, so the C64
    kept showing the SD listing while its next selection ran the Teensy path
    on a card item. Both FindTRMenuItem lookups have no side effects and now
    run right after the path is split, before any state changes.
    RemoteLaunch refused any path of MaxPathLength or more, but only the
    folder has to fit in DriveDirPath/LaunchDir; the file name stays in
    FileNamePath. It now checks the folder length, and LaunchFile answers
    FailToken + "Path too long!" before its second ack for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
2026-10-22 firmware: count a failed transfer's drain from the failure, not the command start
    DiscardCmdInput stops 2 S past SpansCeilingmS(Bytes), measured from Began.
    ReceiveFileData and WriteC64Mem passed the command's start and its whole
    length, so a transfer averaging under 2 bytes/mS that failed late was
    already past the ceiling: the drain returned at once and the rest of the
    payload ran as commands. They now pass millis() and the bytes still owed,
    so the ceiling is the remainder's time at 2 bytes/mS from the failure.
    The no-memory-to-stage drain in WriteC64Mem is the same shape and gets
    the same arguments.
    The comments over SpansCeilingmS and DiscardCmdInput described a command
    deadline that onl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
2026-10-23 firmware: the USB mouse's X and Y reads drive a byte kept ready, and do the arithmetic after
    A read that reaches DataPortWriteWait late is latched wrong on some C64s, so
    the step and clamp now run after the byte is on the bus. The main loop's poll
    updates the ready byte with a compare-exchange that fails if a read landed
    meanwhile, so a step is never driven twice. The bytes a read sequence returns
    are unchanged.
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2026-10-23 firmware: a TR block FLUSH the card fails reports $E4 instead of done
    SD.h's File::flush() is void and drops FsFile::sync()'s result, and getWriteError() reads a Print flag the SD library never sets, so the image is held as an FsFile opened on SD.sdfs and FLUSH returns sync()'s result. Closing at unmount reports a failed final write on the serial console instead of dropping it. The image opens O_RDWR: a missing path no longer creates an empty file.
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2026-10-23 docs: the TR block device is GeoRAM's only, at $DF00
    The REU no longer serves IO1, so the REU row, the $DE00 probe and the checklist's either-base item go.
2026-10-23 tests: drive the USB mouse registers on the host
    A C++ harness includes USBMouse.c with the USB controller, the NVIC and the data port stubbed, and runs it from a script of USB reports, polls, inits and IO reads. The tests hold the register map: a large movement arrives as 127s and then the remainder, X and Y apart, sub-step counts carry, init discards movement from before the handler, and the buttons follow the report and clear on unplug. An IO read can be landed at the poll's atomic write of the ready word, and a weak compare-exchange can be made to fail, to show neither repeats nor drops movement.
    The source is C++ (static_cast on the controller), so the harness is built as gnu++17 rathe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
2026-10-23 tools: the GEOS disk driver looks for the TR block device at $DF00 only
    The REU no longer serves IO1, so the block device lives only beside
    GeoRAM. Probing $DE as a fallback read GeoRAM's page RAM under GeoRAM
    and open bus under the REU. With the base fixed, the driver no longer
    patches its own register addresses. The checklist now says what the
    driver checks: TRB, not TRM.
2026-10-23 firmware: SDFullInit alone closes the TR block image around SD.begin
    The image is mounted only while GeoRAM is the handler, and under GeoRAM the
    card is begun only through SDFullInit (the special button's save, a host or
    NFC launch) and FSfromSourceID (the same save, an NFC tap). FSfromSourceID now
    begins through SDFullInit, which only adds its retry for a card that is present
    but fails to start. Every other SD.begin goes back to calling SD.begin.
2026-10-23 firmware: a TR block reopen refuses an image that is not the one mounted
    Every D64 is the same size, so after a card swap the reopen took the new
    card's file at the same path and GEOS's cached BAM and directory overwrote it.
    The mount records the file's first sector and the card's serial number; a
    reopen that finds either changed leaves the image unmounted and logs it.
2026-10-23 firmware: a TR block flush that keeps failing is logged again after the image is reopened
    The flush-failure log flag was a function static that only a successful sync cleared, so after an image was closed with its sync still failing, a later mount's failures went unlogged. It is file scope now and TRBlockClose clears it with the dirty flag.
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2026-10-25 firmware: the GEOS launcher retypes CONFIGURE as a system file, not a desk accessory
    GEOS file type 5 is DESK_ACC; SYSTEM is 4. As a desk accessory, a
    double-click on CONFIGURE made DeskTop write a swap file and run it, and
    its IEC drive probe hung the C64 with interrupts off.
2026-10-25 docs: keep CRT_Implementation.md a story, move EasyFlash detail to architecture
    PR #65 put its loader reference (bank mask, CHIP table, CHIP handling,
    24-bit swap offsets) and the test-fixture commands in
    CRT_Implementation.md, between "until..." and the SD bank-swap section
    it leads into. That doc tells how CRT support grew, so it now ends with
    a short "2 and 4 MB EasyFlash" note crediting John, and the detail moves
    to a new "EasyFlash beyond 1 MB" subsection under Teensy-Firmware.md's
    "MinimalBoot vs full firmware", with nothing dropped.
    The user docs say MB/KB rather than MiB/KiB and no longer mention PSRAM.
    Constraints.md notes that an EasyFlash now spends about 14 KB of
    MinimalBoot's R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
2026-10-25 firmware: browser moves to frogfind.de, with the address in one place
    www.frogfind.com no longer answers, so the SwiftLink browser's filter
    and search now use frogfind.de. Its host, paths and query parameters
    are defines in IOH_Swiftlink.c, used by the browser and the default
    bookmarks, instead of strings repeated in five places.
    frogfind.de needs three things the old site didn't:
    - A User-Agent header. It answers 403 without one, so every request
    now sends "TeensyROM/<version>".
    - lg=en-us in the query, or its pages come back in German.
    - Decoding before raw mode strips the filter: links in its pages
    percent-encode the target URL.
    Bookmarks saved before the move still point at the old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
2026-10-25 firmware: bound the browser's URL copies
    Several places in the SwiftLink browser copied link and URL text into
    fixed buffers without a length check, so a long link from a web page
    could run past them on the stack:
    - the filter (f) appended host, path and query to a 300-byte field;
    - a relative link was appended to the current page's path;
    - ParseURL copied any length of host into its 100-byte field;
    - CopyEncode had no size limit, for search terms and download names.
    CopyEncode now takes the buffer size and returns false when the result
    won't fit. Search, filter and links print an error instead of
    overflowing, and a URL refused before connecting no longer goes into
    the history. A download w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
2026-10-26 firmware: GEOS 64 moves from TeensyROM Specific to Utilities
    The row goes at the end of Utilities, after the rows found by
    position, so nothing else in either folder moves. A hot key or
    autolaunch saved to TR:/TeensyROM Specific/GEOS 64 no longer finds it.
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2026-10-27 firmware: the GEOS boot image is built per target, ready for GEOS 128
    Each GEOS target now names its own TR disk driver, the start-up runs that set its date and time, and where its boot file keeps the C128 reset key. GeosBuildBootImage reads the boot file, swaps the transport, breaks the reset key and sets the clock. GeosBuildBootPrg wraps that image in GEOS 64's BASIC stub, as before.
    GEOS 128 sets the clock and the date in one 44-byte run, behind a store of zero that the patched run takes over to load X. Its 1581 driver keeps NewDisk after ReadBlock. The transport swap no longer requires the routines it replaces to lie inside the run it overwrites, since one left outside is only unused. T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
2026-10-29 tools: the screen test's banner allowlist follows the cart banner to line 159
    a303edec added four lines to Coldstart above MsgCartBanner, so the return
    after the banner now sits at TeensyROMC64.asm:159. The allowlist in
    c64-screen.test.mjs still named line 155, and the tree sweep failed CI on
    f31b9e3b with the banner reported as an undeclared full-width row.
2026-10-29 tools: the screen test lists its banners by label, not line number
    The two deliberate full-width banners were allowlisted by the line of the
    return after each, which moved whenever anything above the banner in its
    file changed: a303edec added four lines to Coldstart and the sweep failed
    CI with an unchanged banner reported as new. Each hit now carries the
    global label its message is printed under, the column-0 identifier with
    `Name = expr` definitions excluded, and the allowlist names MsgCartBanner
    and MsgM2SPolyMenu. The line still appears in the failure message so a new
    offender is easy to find.
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2026-10-29 firmware: the TR block device's BOOT command reads the launch's boot image
    BOOT ($05) reads page ADDR1:ADDR0 of a boot image into the window as READ does, padding a short last page with zeros. Past the end it fails with $E2, and with no boot image with $E1. TRBlockMount takes the boot image with the disk image, and it goes with that image. GEOS 64 starts from a PRG and mounts none.
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2026-10-29 firmware: GEOS 128 starts from the Utilities menu on a C128
    The GEOS 128 row follows GEOS 64. It is shown only once the menu has reported a C128, and selecting it on a C64 is refused, because the boot ROM cannot run there. The launch builds the boot ROM's two chips in RAM_Image with the boot image after them. It tells the ROM where that image loads, how many pages it has and where to enter it, and mounts the copy with the image as BOOT's to serve. Then it starts as a C128 cart. A boot file that would reach the shared RAM below $2000 or I/O at $D000 is refused. The GEOS 128 target names its deskTop, mouse driver, disk driver, clock run and reset key.
2026-10-29 test: the GEOS 128 boot ROM runs on an emulated C128 against the block device
    The committed ROM is run on the 6502 emulator, with the C128's MMU and
    shared RAM and a block device that follows docs/TR_Block_Device.md. The
    tests check that it loads every page into bank 1 and enters GEOS. They
    also cover a busy device, a stale result, glitched reads, a refused page
    and a device that never answers.
2026-10-29 fix: review findings for 61cc762
    A random NFC pick from a TeensyROM directory counted the directory's full size, so on a C64 it could pick the GEOS 128 row the menu hides and fail with "needs a C128". It now counts the rows the menu lists.
2026-10-29 docs: CLAUDE.md for working on TeensyROM with Claude Code
    Claude Code reads this file at the start of every session in the repo. It
    points at the architecture docs rather than repeating them, lists the gates
    and the Constraints.md rules that cause hardware-only failures, and sets the
    rules for findings, review effort, pinned paths, hardware use and what may
    appear in public text.
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2026-10-29 chore: reviewer agent and panel-review lanes for TeensyROM
    The reviewer agent runs one review of one change in a worktree and commits its own fixes; panel-review runs the four lanes (auditor, adversary, steward, pragmatist) for a large or risky change. The generic bodies come from the c64cast setup; each gets a TeensyROM section naming the gates, the PHI2 and RAM rules, the trust boundaries (the unauthenticated port 2112 protocol, files from SD/USB, NFC, self-flash) and the contracts that drift.
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2026-10-29 menu: INST/DEL deletes the highlighted file on SD or USB
    There was no way to remove a file from the C64 side: a stray download,
    a failed copy or a test image stayed on the card until it went back to
    a PC. INST/DEL on a file in an SD or USB listing now shows its path and
    asks "Delete this file? y/n"; y removes it, the folder reloads and the
    cursor stays on the same row, or the last one if the file was the end
    of the list. Any other key returns to the listing with no message.
    The Teensy does the checking and the messaging, in two steps like the
    NFC tag pair: rCtlDeleteFileCheckWAIT (61, rsDeleteFileCheck 0x23)
    names the file and says in rwRegScratch whether it can go, the menu
    asks, and rCtlD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
2026-10-30 tools: the GEOS 128 boot ROM reaches the block device on the page the launch gives it
    The boot ROM is built at every launch, which knows which handler it
    starts, so the firmware writes the page into the ROM instead of the ROM
    searching for it: a glitch-safe search does not fit in the one page the
    cold start copies. geos128boot.mjs assembles the ROM at two pages and
    lists the bytes that move, as trdrive.py does for relocations. The
    launch still asks for the page beside GeoRAM.
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2026-10-30 fix: review findings for 19666df
    regread.a counted errors in 16 bits, which wrap within a 4-second dwell once
    most reads fail: at nS_PLAprop 400 the $FF page row printed +1248 for about
    66,800 wrong reads. Error counters are now 24-bit.
2026-10-31 firmware: Kernal Replace senses HIRAM by DMA on a C128 (#78)
    On a C128 in C64 mode, Kernal Replace never serves the image: the Skoe
    sense drives A14 low over the CPU's address, but the expansion port's
    address lines come through a transceiver that drives towards the port
    outside DMA, so the PLA never sees it. ROMH never answers (measured at
    every Cyc_KernProp up to 99), every sense reads "RAM", and the one read
    after each $01 write is left undriven under /GAME. The KERNAL IRQ writes
    $01 right before its keyboard scan, so the keyboard stops working.
    With the menu reporting a C128 (rvtcC128), HIRAM is now sensed by DMA:
    right after a CPU write to $00/$01, /DMA holds the CPU for one cycle
    (the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
2026-10-31 firmware: Kernal Replace hooks a C64 or a C128 check at launch
    KernalCheck runs ahead of every IO1/IO2 answer while it is hooked,
    which includes the menu's PRG stream over IO1 (rCtlKERNALPreStartWAIT
    comes first). The DMA sense put a method test and a call to KDS_Slow
    on that common path, and the call made GCC save six registers on every
    cycle: a C64's common cycle went from 7 instructions to 13 plus a push
    and a pop.
    KernalCheckArm() now picks the check once, when Kernal Replace starts
    and when the PRG-load handshake restages it. KernalCheck is the C64's
    Skoe sense again, main's code plus the known-RAM return. A C128 hooks
    KernalCheckDMA: one combined test, then a tail call to KDS_Slow or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
2026-11-02 firmware: SwiftLink never blocks in client.write(); Tx bytes go out in bursts (#80)
    NativeEthernet's socketSend() busy-waits until the send buffer has room,
    so a large upload from the C64 stalled loop() inside client.write() until
    the stack freed space (for good if the stack is polled from loop()).
    Collect Tx bytes in a 256-byte buffer, send it after a 2 ms pause, after
    20 ms or when full, and never write more than availableForWrite(). While
    the buffer is full Tx-empty stays clear, so the C64 waits as it would on
    a 6551. One segment per burst instead of one per byte.
    Review fixes: the buffer is allocated with the other SwiftLink buffers and
    freed at menu return instead of holding RAM2 in e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
2026-11-04 docs: point the app references at TeensyROM Suite and its Trom apps
    TeensyROM Suite 1.0.0-beta.1 replaced TeensyROM Web, the TeensyROM UI
    desktop app and TeensyROM-CLI with one suite: Trom UI, Trom Terminal,
    Trom Agent and Trom API. The old repos are archived, so the docs that
    pointed at them now name the Suite apps and link their docs.
    The C64 Ultimate page shows what the Suite does today, the DJ Mixer
    joins the ASID sources, and the protocol notes name Trom API as the
    client that depends on the command format.
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2026-11-04 docs: describe TeensyROM Suite in the README
    The README's remote control list, transfer line and thank-you credit
    pointed at TeensyROM Web, the TeensyROM UI desktop app and
    TeensyROM-CLI, which TeensyROM Suite 1.0.0-beta.1 replaced. They now
    describe the four Trom apps and link their docs, and a DJ Mixer video
    joins Demo Videos.
2026-11-04 docs: tighten the Suite wording from review
    The README's remote control entry is back to one line, like the rest of
    that list. The C64 Ultimate page calls Trom Agent what it is, an AI
    companion, rather than quoting example requests. The DJ Mixer runs in
    any browser with MIDI support, not only Chrome or Edge.
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2026-11-06 c64: C128 2MHz bus and memory test in the Test+Diags menu
    The NTSC C128 DMA investigation ended in a 74LS245 at U55 fixing the
    write fault, and the objection came back that the 74F245 is there for
    2MHz mode. Nothing on hand tested that: the 789010 diag never touches
    $D030, and the DMA runs were all at 1MHz. This program runs from the
    TR menu on a C128 in C64 mode, times a loop to confirm $D030 bit 0
    took, and then checksums the ROMs and pattern-tests RAM in four modes
    per pass (1MHz, 2MHz, and each cross-speed write/verify pair), so a
    2MHz failure is separated from the board and split into its write and
    read sides.
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2026-11-10 firmware: Kernal Replace polls the Ethernet stack from loop(), not the PIT ISR (#85)
    With the Ethernet stack initialized (no cable needed), NativeEthernet
    runs FNET from a 1 ms PIT ISR, and about 39 PHI2 interrupts a second
    came in late (>1.1 µs), even with the GPIO interrupt at the higher
    priority. Under Kernal Replace a late one lands on the HIRAM sense after
    a $01 write, so programs that switch $01 constantly got corrupt reads,
    NMIs or froze: an RPG that keeps its map under I/O and the KERNAL, and
    CCGMS over SwiftLink with the KERNAL replaced.
    While Kernal Replace serves the KERNAL and the stack is up, IRQ_PIT is
    masked and loop() calls fnet_poll() every ms instead; late interrupts
    drop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
2026-11-10 tools: a refused delete sends the board no path (#95)
    Link.delete() sent the drive byte and the path whatever its token's reply
    was. A board with any IO handler but the menu's current answers a file
    command with FailToken and "Busy!" and goes back to reading one-letter
    serial commands, so it ran the path as commands: in /c128test/t80b.prg the
    'e' reset its EEPROM to defaults, 'c' cleared the debug log and 't' changed
    bus timing. post() deletes first, so every push to a busy board did this,
    and the post token's own "Busy!" afterwards hid it.
    delete() now goes through ack() like post(), listdir() and launch(), so a
    refusal stops it and is reported as the delete that was refused. The fake
    boar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
2026-11-11 firmware: a C128-mode launch drops Kernal Replace as the next IO handler
    In 128 mode the MMU ignores GAME and EXROM, so the internal KERNAL stays
    mapped at $E000-$FFFF. If a C64-mode launch earlier in the session loaded
    a kernal, InitHndlr_KernalReplace re-stages KernalCheck when the C128 boot
    ROM signals rCtlRunningPRG, and the Teensy then drives KernalBin onto the
    bus against the C128's own ROM on every KERNAL read, and asserts DMA for
    the HIRAM sense on $00/$01 accesses.
    LaunchC128BasicPrg now overrides the Special IO setting for that launch
    only, the way a CRT does; InitHndlr_TeensyROM restores it from EEPROM on
    the next return to the menu.
    Reported by Wes Biggs on #96.
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2026-11-11 fix: review findings for 8071ed9
    An immediate REU transfer cleared fBusSnoop whoever held it, so the sample store watch a locked WriteC64Spans job runs on was dropped by the first transfer the C64 started, and every later slice waited out its gap and started unlocked. It now clears the slot only when its own FF00 check holds it.
    The job-state test set up a write job and ran a C64-to-REU... transfer that also left DMA_RnW false, so dropping the DMA_RnW restore passed; the job is now a read.
2026-11-12 tools: reuspans.py runs host DMA writes beside C64 REU transfers
    The REU fix in this branch had only host tests behind it: nothing
    drove a C64 REU transfer while a host job was set up. reuclient.a
    loops REU stash, fetch and compare; reuspans.py writes $6000 with each
    host writer beside it and reads every write back, and counts the
    C64's bad pages with and without host jobs, so a fault of the REU
    alone shows apart.
    It also turned up a first-byte loss that predates this branch, now in
    Known-Issues.md. spans.py's run moves under __main__ so reuspans.py
    can import spans().
2026-11-12 firmware: build NativeEthernet from a copy in the tree
    Its static-IP begin() waits for the Ethernet link with no time-out, so a
    static IP with no cable hangs the boot with TCP listen on, and SwiftLink's
    ATC. That can only be fixed inside the library, and with a copy in the tree
    every caller in both images gets the fix.
    This is upstream vjmuzik/NativeEthernet at fe82aa7, the version Teensyduino
    1.61.0 bundles, unchanged. It lives in MinimalBoot/Common so both sketches
    can reach it, and each sketch compiles it through one wrapper per library
    .cpp in its own src/, so every file stays its own translation unit and the
    images build as before. MinimalBoot's wrappers are empty for the extension
    hos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
2026-11-12 firmware: a static-IP Ethernet init gives up after the DHCP time-out
    NativeEthernet's static-IP begin() spun on the link status with no
    time-out, so a static IP with no cable hung the boot with TCP listen on
    (MinimalBoot and the main image) and SwiftLink's ATC.
    begin() now takes a time-out and returns whether the link came up; the
    default keeps the library's other overloads waiting as before. Both init
    paths pass the DHCP time-out setting and report a failure the way a failed
    DHCP init already does, so TCP listen stays off and ATC answers NO
    DIALTONE. The address is set before the wait, so a cable plugged in later
    still comes up on the static IP.
2026-11-12 firmware: switching from a static IP to DHCP takes effect without a reboot
    NativeEthernet started the DHCP client only on a link-up, and only when
    the address was 0.0.0.0. After a static-IP init the address is never
    zero, so a DHCP init in the same session (the settings menu's Ethernet
    init, or ATC with the link down) waited out its whole time-out and kept
    the static address, even when the cable came up during the wait. The
    response time-out also kept the first init's value.
    The DHCP begin() now records that DHCP was asked for, the static one
    clears it, and a link-up starts the client only in DHCP mode. A DHCP
    begin() on a running stack whose link is already up starts the client
    itself, wit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
2026-11-13 firmware: Kernal Replace serves its image from DTCM (#101)
    KernalCheck reads the KERNAL image inside the PHI2 window on every
    $E000-$FFFF read. From the RAM2 heap, a read that misses the cache takes
    100 nS or more, and the byte then reaches the bus late. A static DTCM
    array has no cache to miss; it also frees the 8 KB heap block (or the
    borrowed MIDIRxBuf) that the image held while a replaced KERNAL runs.
    KernalLoaded replaces the NULL test InitHndlr_KernalReplace used to tell
    a loaded image from a failed or absent one.
    The image costs 8 KB of free-for-locals even on boards that never select
    Kernal Replace. Constraints.md records why that is accepted: it has to be
    in DTCM for timing, and n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
2026-11-14 docs: the vendored NativeEthernet names the fork tag it is pinned to
    The fork's tr branch now carries the same library changes as this tree,
    tagged tr-pin-0747ad0 on top of tr-base-fe82aa7, so the copy here can
    be traced to a commit and refreshed from it without reapplying the
    fixes by hand.
2026-11-14 firmware: MinimalBoot reboots into the main image whenever Ethernet is up
    Jumping straight into the main image with the Ethernet stack running
    faults it: SetUpMainMenuROM() re-enables the ENET and PIT interrupts,
    which still fire for MinimalBoot's stack, and the main image has no
    handlers for them yet. The board then auto-reboots into the menu and
    prints a CrashReport. MinimalBoot already rebooted instead of jumping,
    but only when the Ethernet init succeeded, and a failed init (no cable
    with a static IP, or no lease with DHCP) leaves the stack running too.
    It now reboots whenever the stack is initialized.
